InspectorColombo/ColomboProjects/USBASP_M8535/readme.txt

This is my version of USB ASP programmer.
- It is based on ATMega8535 run on 12MHz crystal.
- Optic insulation of target added.
- Logic level converters added.
- 10pins jtag like and 6 pins classic avr-isp connectors present.
