InspectorColombo/ColomboProjects/12_to_200V_inverter/Ring_Holder/RingHolder.stl

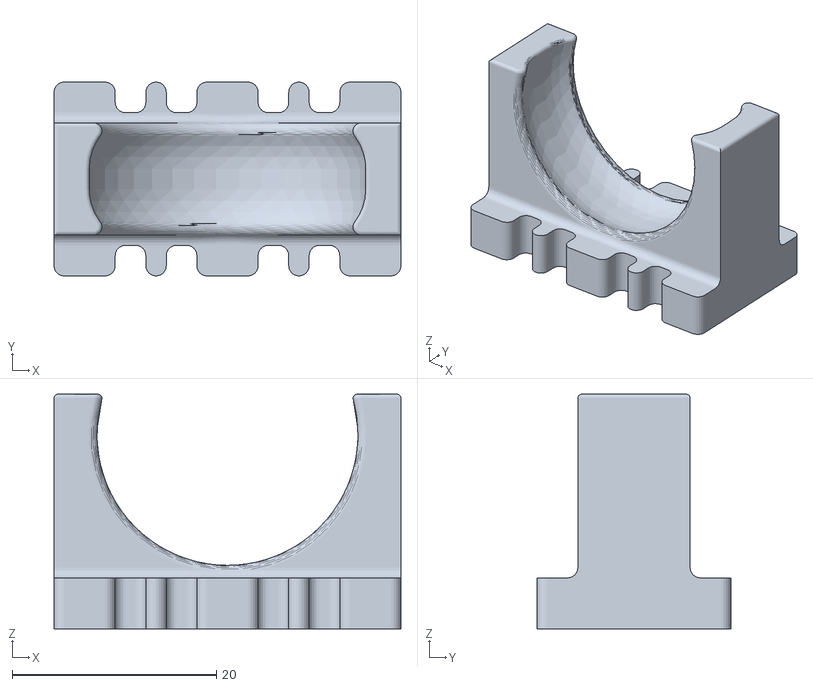
[picture p1: CAD file, 2024-04-01]
12_to_200V_inverter/Ring_Holder/RingHolder.stl
34.0 x 19.0 x 23.0
