InspectorColombo/ColomboProjects/FilamentCase/FilamentCase.stl

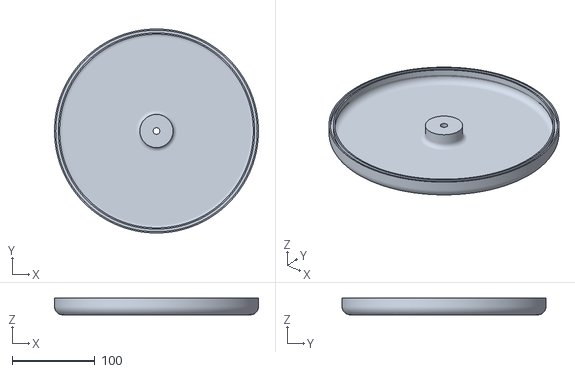
[picture p2: CAD file, 2024-06-12]
FilamentCase/FilamentCase.stl
246.0 x 246.0 x 19.9
