InspectorColombo/ColomboProjects/Kassy/box_v5.stl

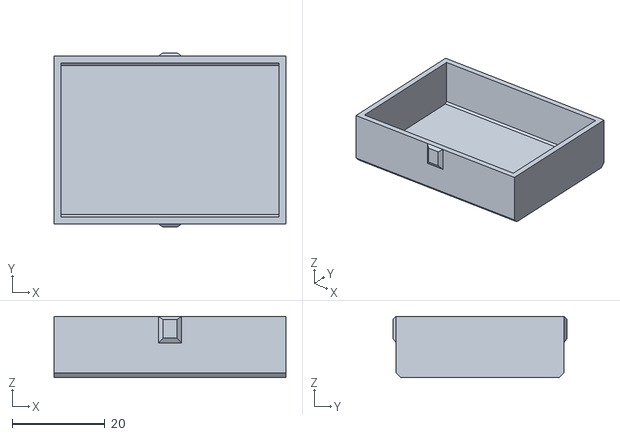
[picture p3: CAD file, 2024-12-11]
Kassy/box_v5.stl
50.0 x 37.6 x 13.2
