InspectorColombo/ColomboProjects/WINDING_MACHINE/WindingMachineHandle.stl

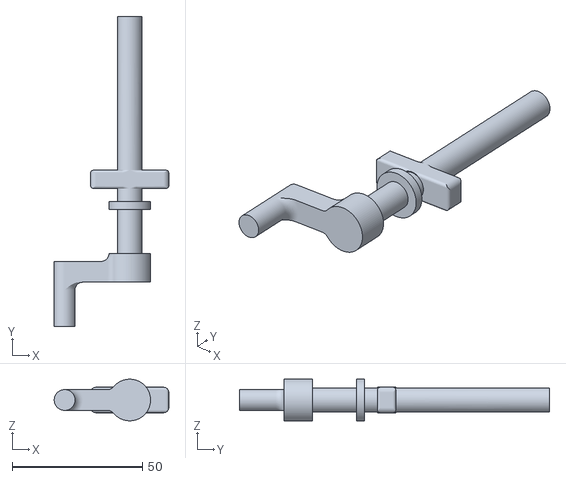
[picture p4: CAD file, 2024-05-27]
WINDING_MACHINE/WindingMachineHandle.stl
44.0 x 119.0 x 16.0
