InspectorColombo/ColomboProjects/Kassy/BigBox6x5_1.8mm.stl

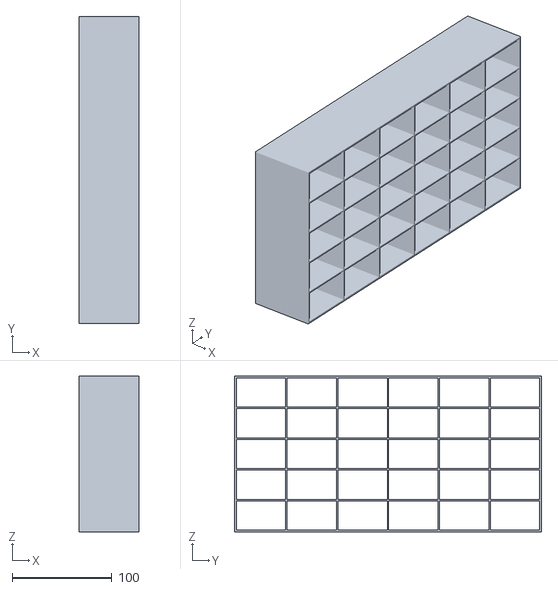
[picture p5: CAD file, 2024-12-08]
Kassy/BigBox6x5_1.8mm.stl
60.0 x 308.1 x 156.1
