InspectorColombo/ColomboProjects/WINDING_MACHINE/WindingMachineHandle_TOP.stl

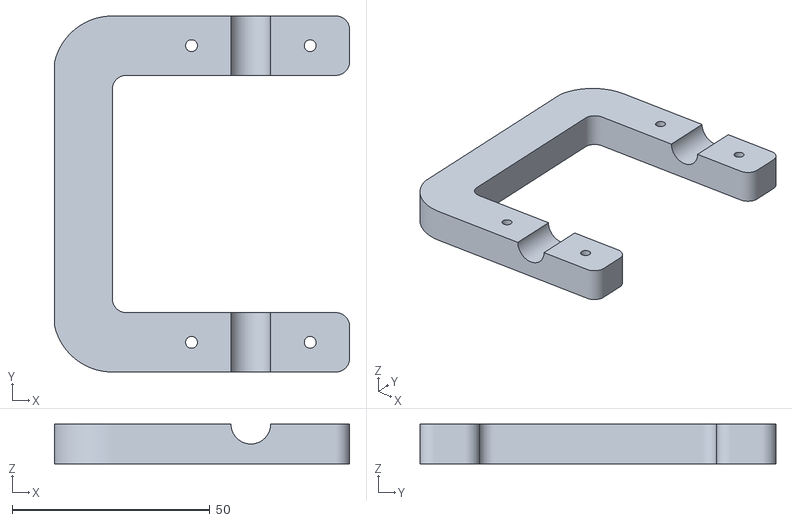
[picture p6: CAD file, 2024-05-27]
WINDING_MACHINE/WindingMachineHandle_TOP.stl
74.7 x 90.0 x 10.00
