InspectorColombo/ColomboProjects/HumidityMetter/Package/HumidityMetterPackage.stl

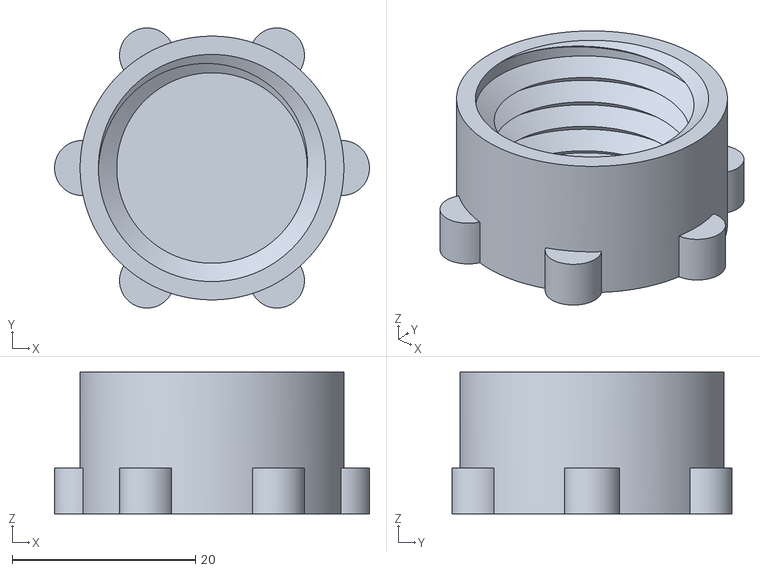
[picture p7: CAD file, 2024-09-07]
HumidityMetter/Package/HumidityMetterPackage.stl
34.4 x 30.6 x 15.5
