InspectorColombo/ColomboProjects/Kassy/BigBox3x3_1.8mm_test.stl

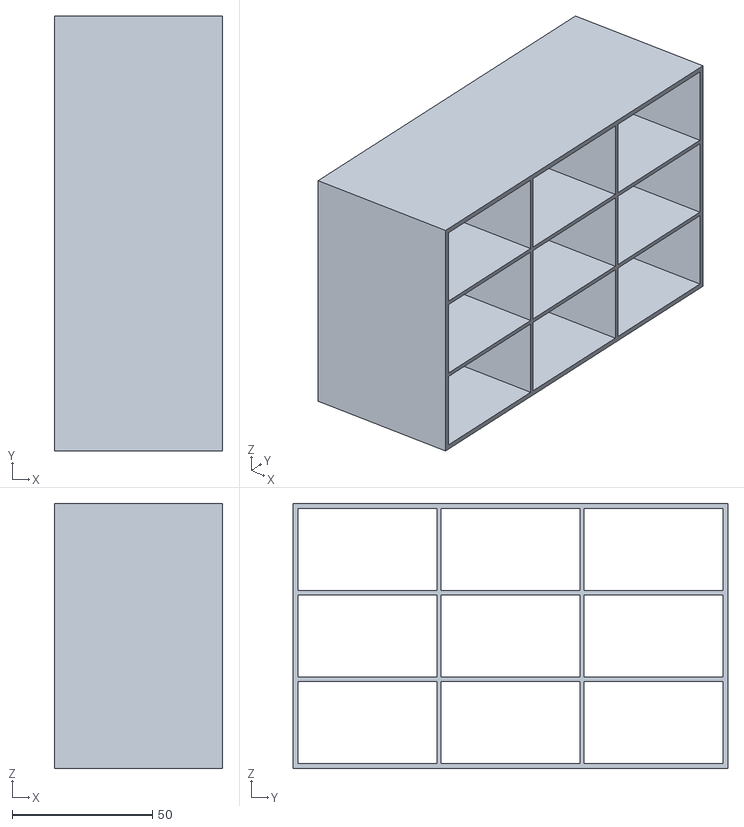
[picture p8: CAD file, 2024-12-08]
Kassy/BigBox3x3_1.8mm_test.stl
60.0 x 155.1 x 94.5
