InspectorColombo/ColomboProjects/WINDING_MACHINE/WindingMachine.stl

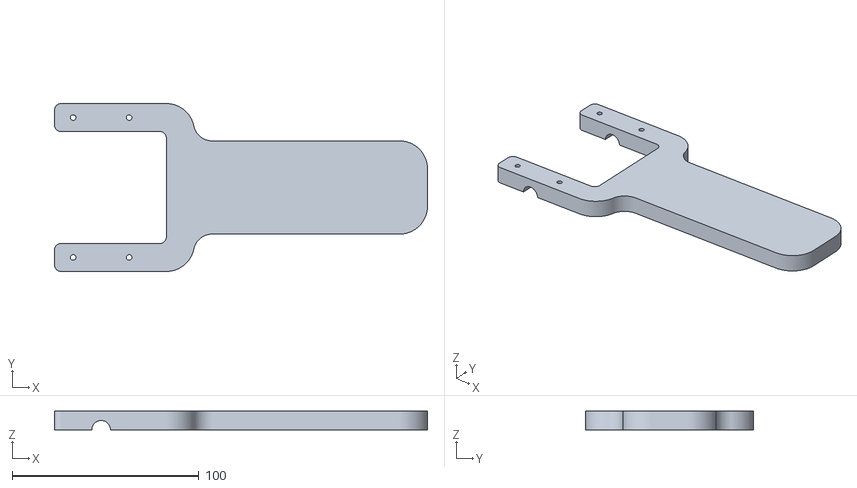
[picture p9: CAD file, 2024-05-23]
WINDING_MACHINE/WindingMachine.stl
200.0 x 90.0 x 10.0
