InspectorColombo/ColomboProjects/HumidityMetter/Package/toonels.stl

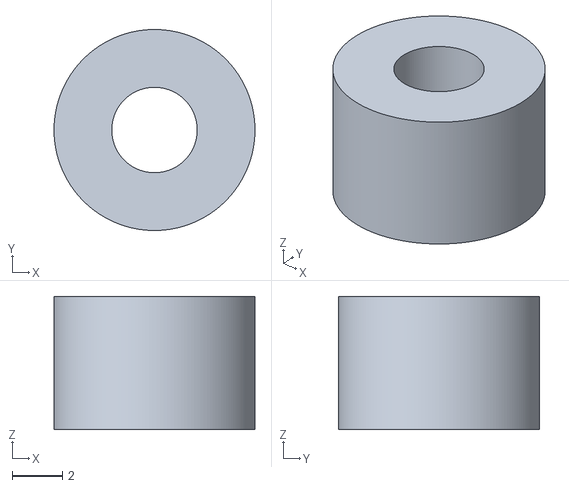
[picture p10: CAD file, 2024-08-28]
HumidityMetter/Package/toonels.stl
8.00 x 8.00 x 5.30
