InspectorColombo/ColomboProjects/Kassy/SMALL_BOX.stl

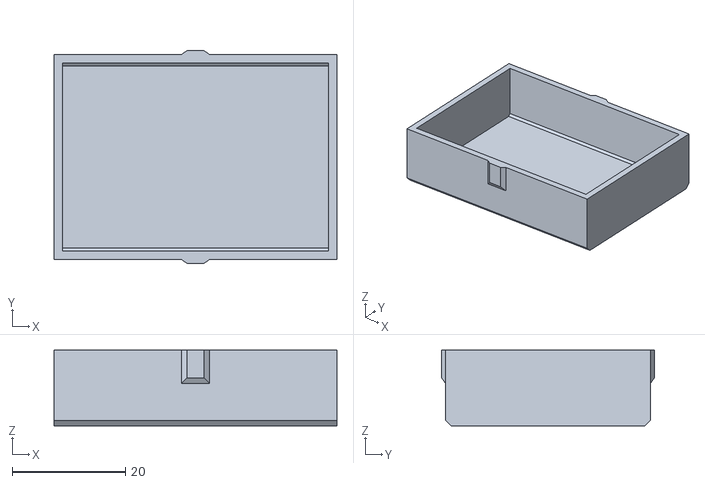
[picture p11: CAD file, 2024-12-08]
Kassy/SMALL_BOX.stl
50.0 x 37.6 x 13.4
