InspectorColombo/ColomboProjects/HumidityMetter/Package/bottom.stl

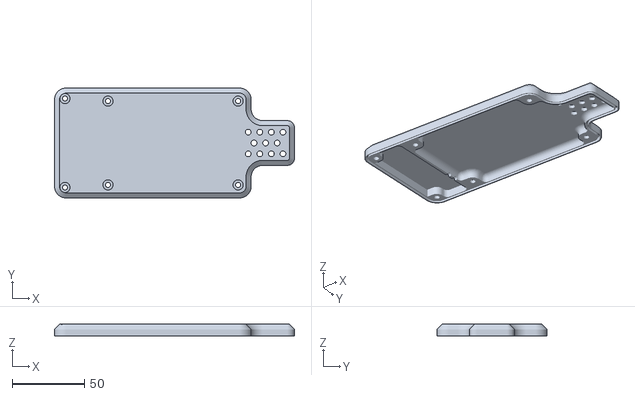
[picture p12: CAD file, 2024-08-28]
HumidityMetter/Package/bottom.stl
166.0 x 76.0 x 8.00
