InspectorColombo/ColomboProjects/HumidityMetter/Package/top.stl

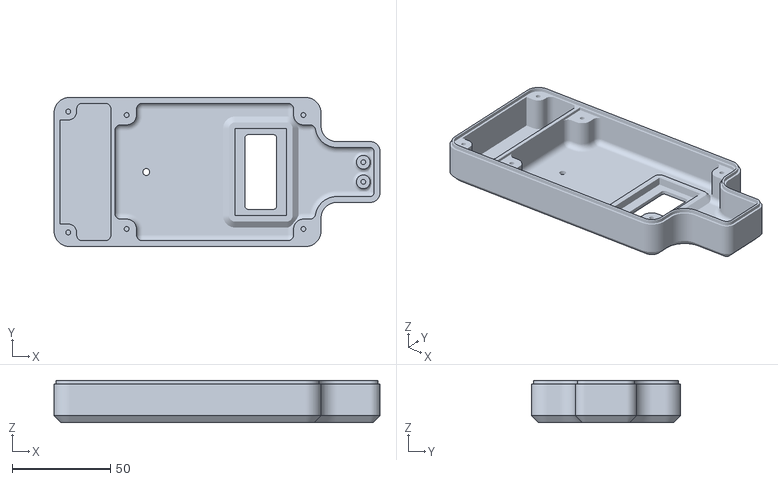
[picture p13: CAD file, 2024-08-27]
HumidityMetter/Package/top.stl
166.0 x 76.0 x 21.5
