InspectorColombo/ColomboProjects/(list of files, cad)

Other CAD files:
Kassy/Kassy.dwg
12_to_200V_inverter/package/LampPackage4_ver10.dwg
Lotok15mm/Lotok15mm.dwg
Lotok25mm/Lotok25mm.dwg
NiddleBox/CanisterCap.dwg
12_to_200V_inverter/package/HEAT_SINK_HOLDER.dwg
FilamentCase/FittingHolder.dwg
Lotok15mm/Lotok.dwg
NiddleBox/BOX.dwg
WINDING_MACHINE/WindingMachine_recover.dwg
12_to_200V_inverter/package/LED_Conductor.dwg
NiddleBox/ValveHandle.dwg
12_to_200V_inverter/package/Conductor.dwg
12_to_200V_inverter/Ring_Holder/RingHolder.dwg
12_to_200V_inverter/package/LampPackage4_ver8.dwg
FilamentCase/FilamentCase.dwg
HumidityMetter/Package/HumidityMetterPackage.dwg
HumidityMetter/Package/TOP_SCREW_INNER_28.4.stl
HumidityMetter/Package/TOP_SCREW_OUTER.stl
WINDING_MACHINE/WindingMachine.dwg
