InspectorColombo/ColomboProjects/KLineAdapter/schematic/to_print2.png

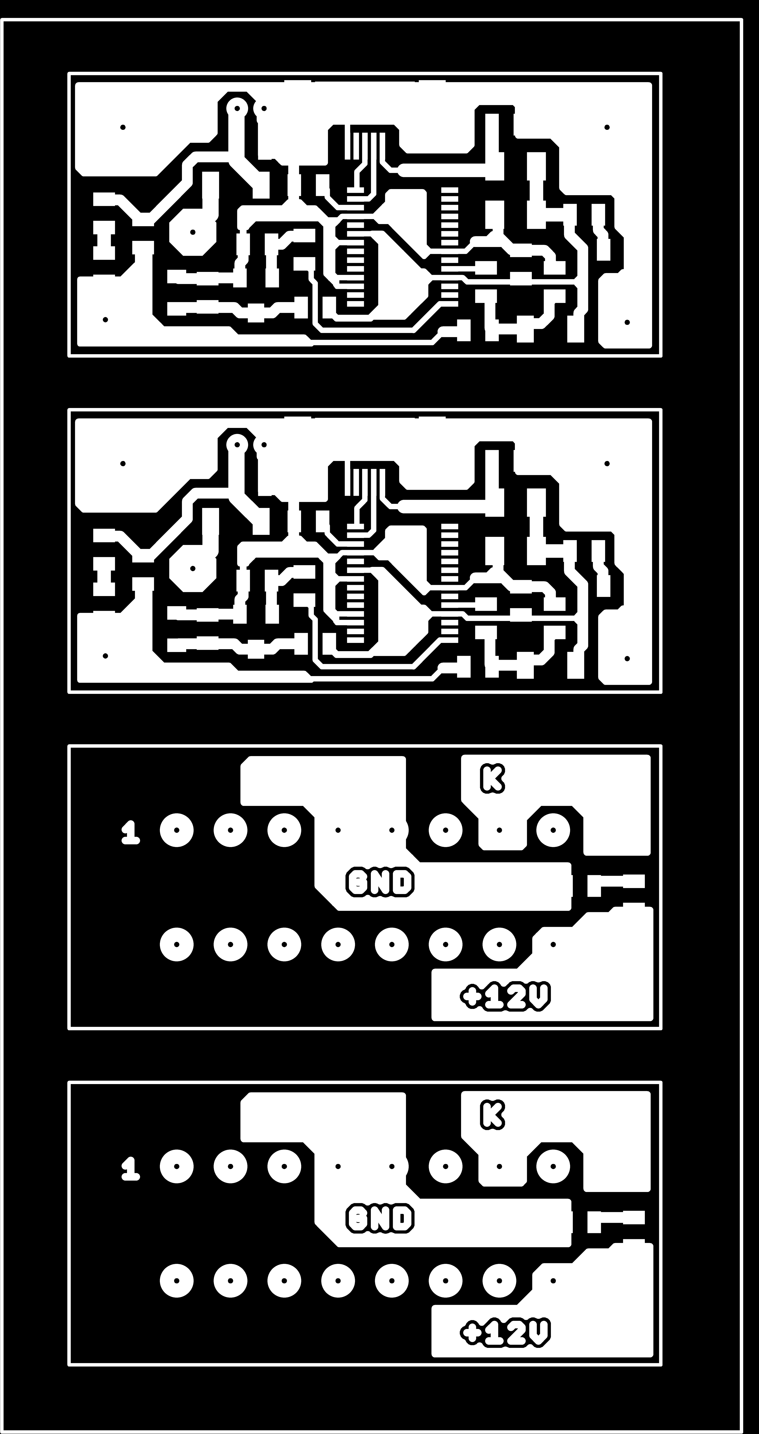
KLineAdapter/schematic/to_print2.png
