InspectorColombo/ColomboProjects/PowerSupply_1600W/CurrentRestrictionBoard/TO_PRINT_V1.0.png

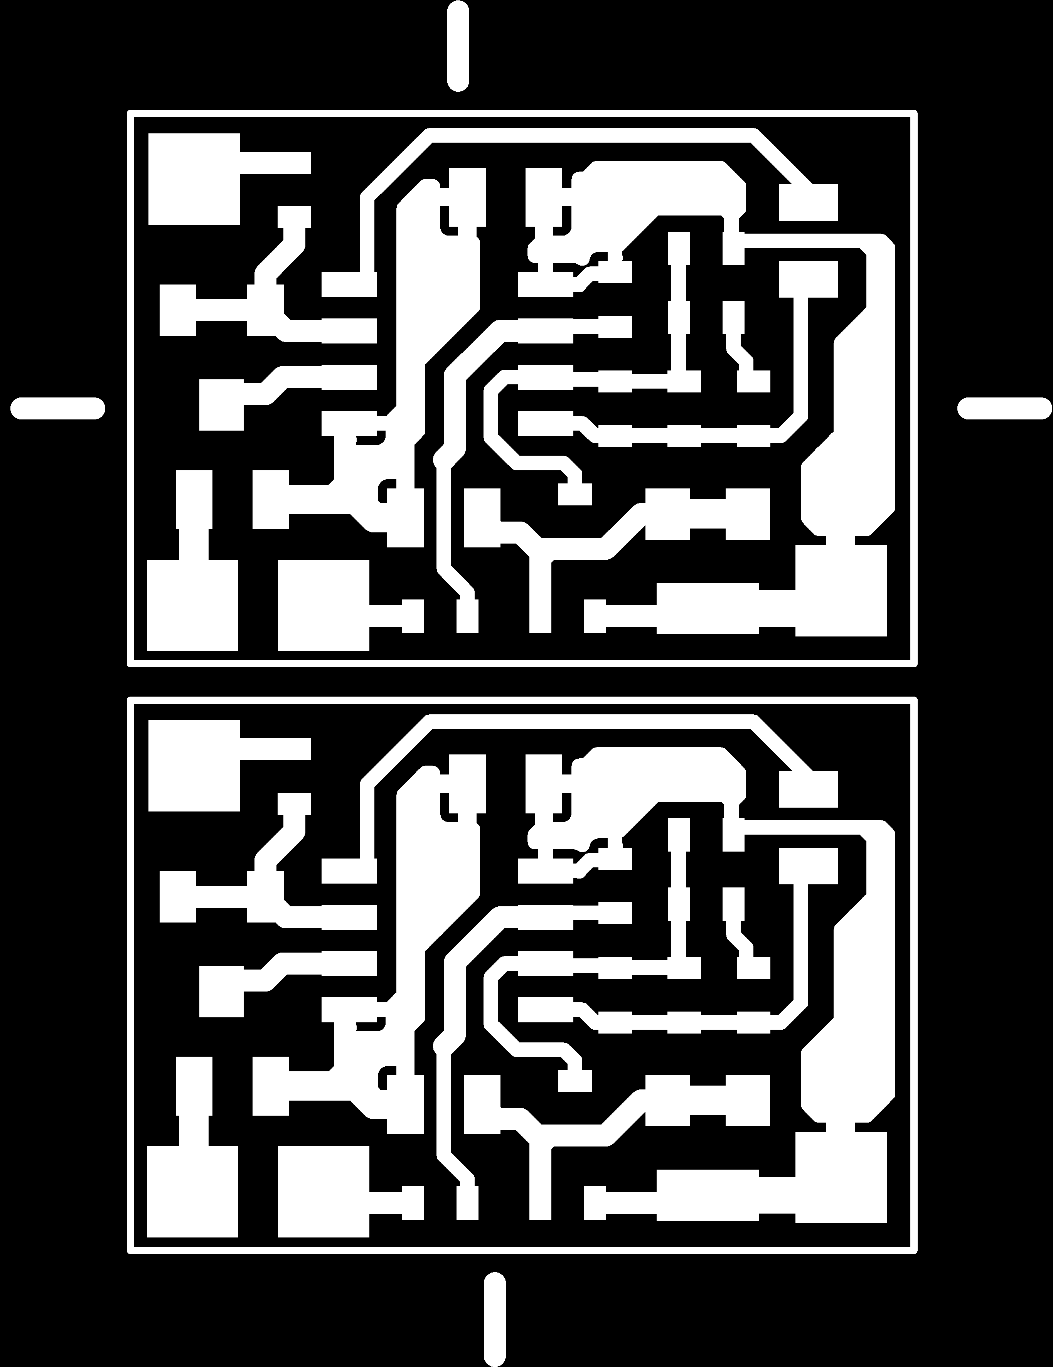
PowerSupply_1600W/CurrentRestrictionBoard/TO_PRINT_V1.0.png
