InspectorColombo/ColomboProjects/SoftStartBoard/PotenciometersBoard/TO_PRINT.png

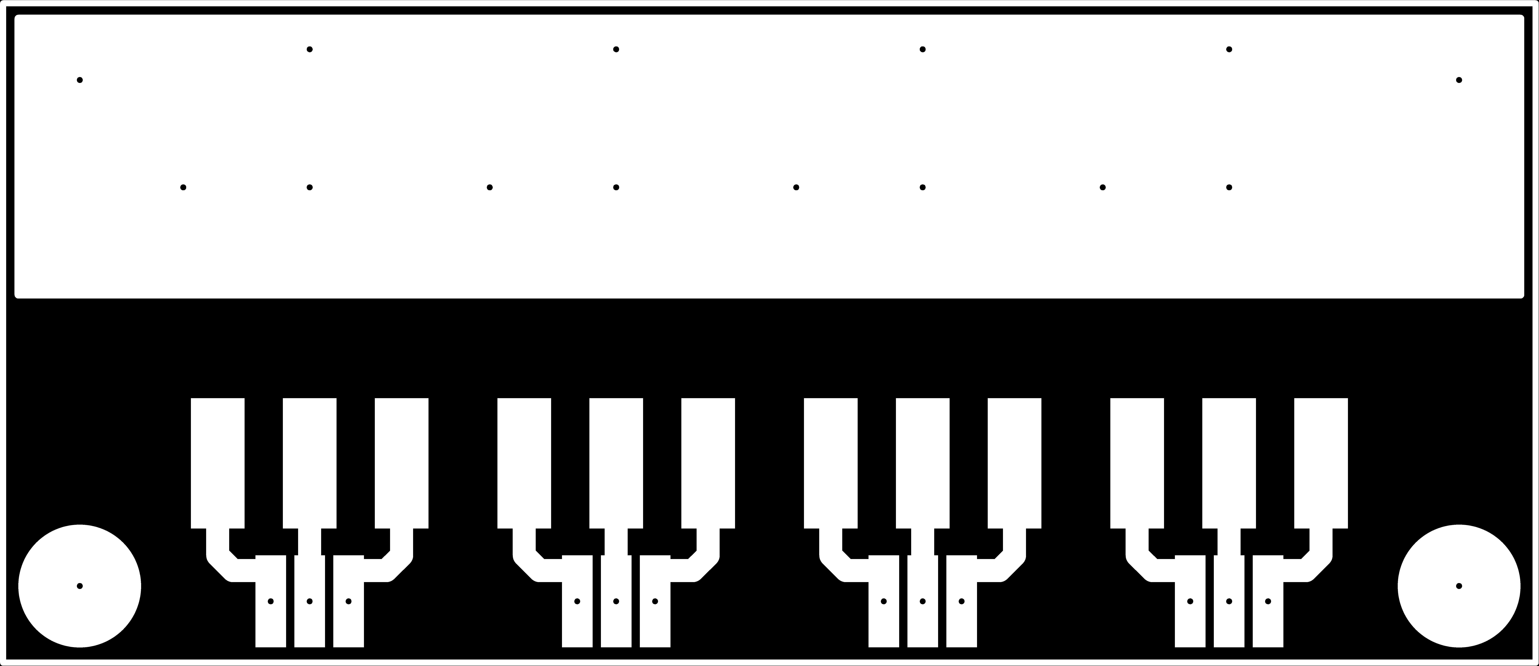
SoftStartBoard/PotenciometersBoard/TO_PRINT.png
