InspectorColombo/ColomboProjects/SWR_Metter/schematic/TO_PRINT.png

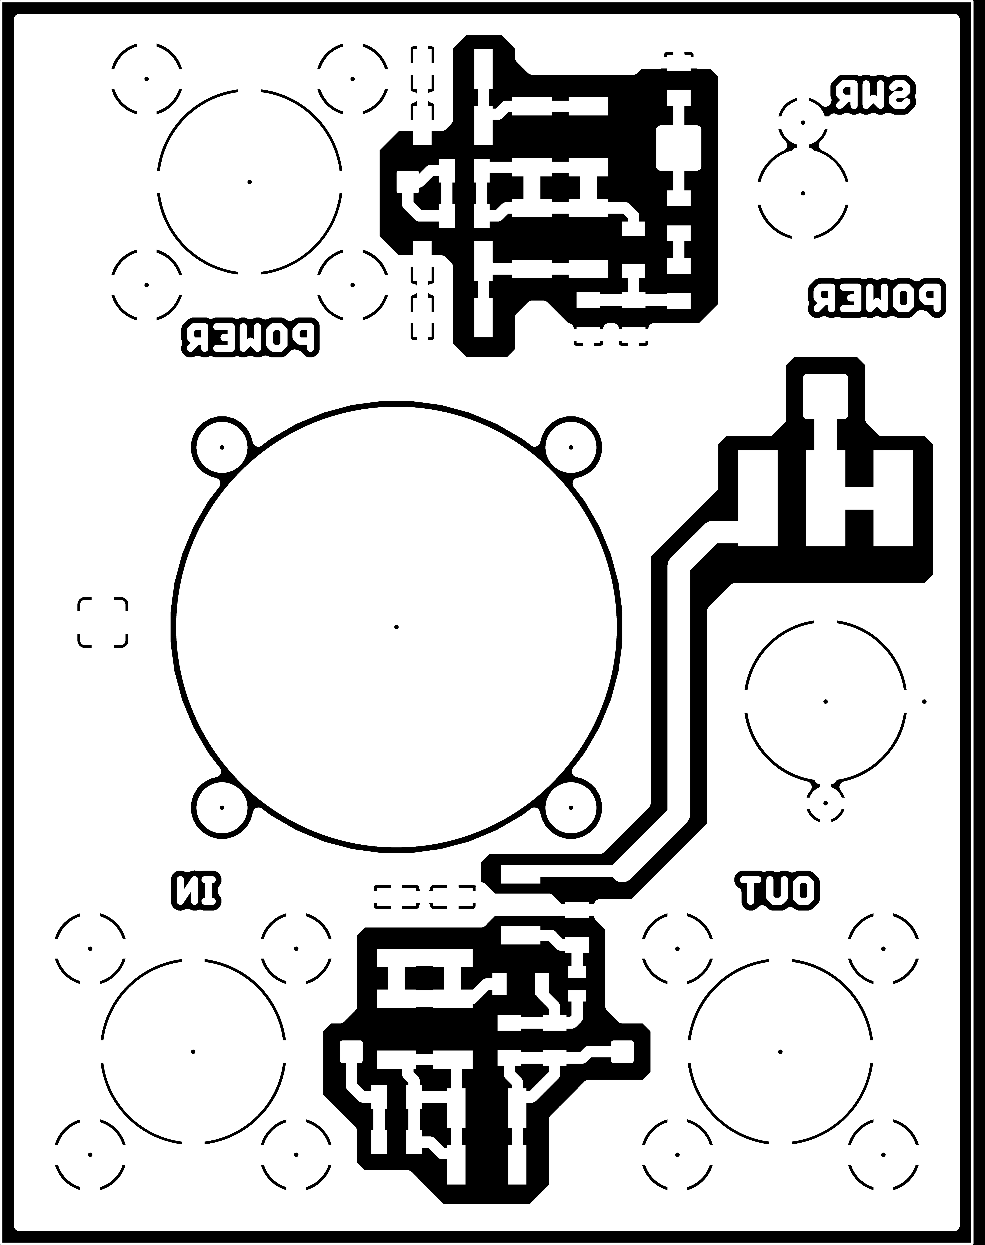
SWR_Metter/schematic/TO_PRINT.png
