InspectorColombo/ColomboProjects/CurrentMetter/schematic/CurrentMetterLEDScreen.brd

## EAGLE design CurrentMetter/schematic/CurrentMetterLEDScreen.brd (2026-10-03)

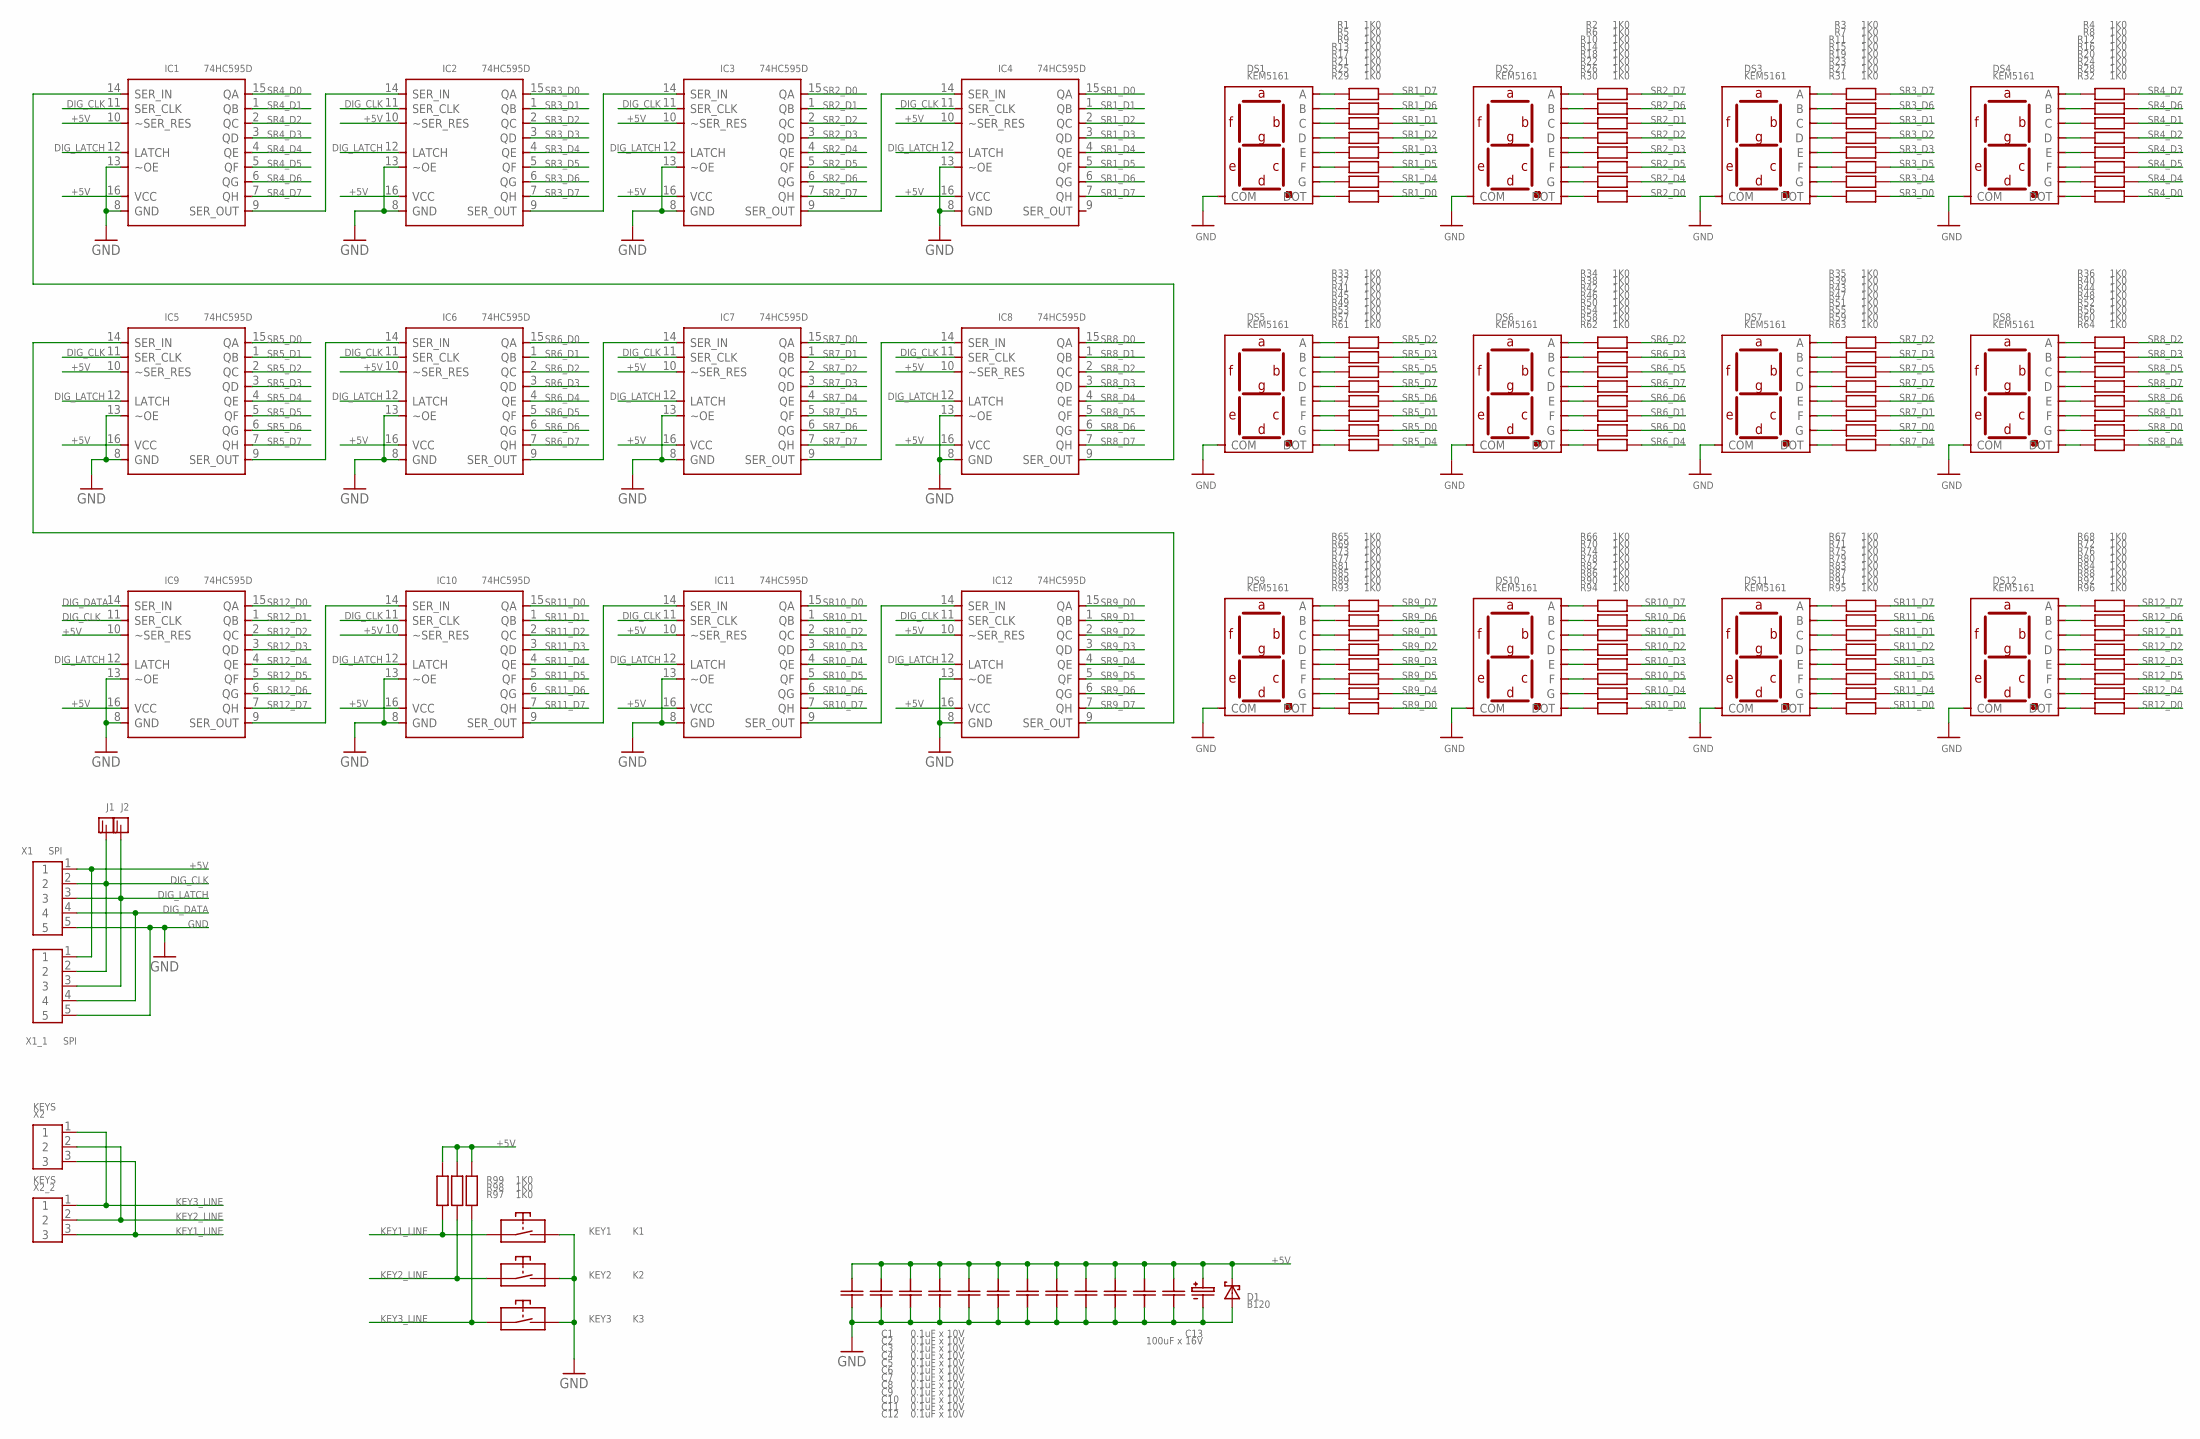
[picture p18: schematic CurrentMetterLEDScreen.sch]

Parts:
C1, C2, C3, C4, C5, C6, C7, C8, C9, C10, C11, C12: 0.1uF x 10V; RSMD_0603
C13: 100uF x 16V; CE_6.3MM_HOR_REVERTED
D1: B120; DO-214AC
DS1, DS2, DS3, DS4, DS5, DS6, DS7, DS8, DS9, DS10, DS11, DS12: KEM5161; KEM-5161(NARROW_PADS_OUTSIDE)
IC1, IC2, IC3, IC4, IC5, IC6, IC7, IC8, IC9, IC10, IC11, IC12: 74HC595D; SOIC16
J1, J2: JUMPER0805; RSMD_0805
KEY1: K1; KEY_7X4.5_BIG_PADS
KEY2: K2; KEY_7X4.5_BIG_PADS
KEY3: K3; KEY_7X4.5_BIG_PADS
R1, R2, R3, R4, R5, R6, R7, R8, R9, R10, R11, R12, R13, R14, R15, R16, R17, R18, R19, R20, R21, R22, R23, R24, R25, R26, R27, R28, R29, R30, R31, R32, R33, R34, R35, R36, R37, R38, R39, R40, R41, R42, R43, R44, R45, R46, R47, R48, R49, R50, R51, R52, R53, R54, R55, R56, R57, R58, R59, R60, R61, R62, R63, R64, R65, R66, R67, R68, R69, R70, R71, R72, R73, R74, R75, R76, R77, R78, R79, R80, R81, R82, R83, R84, R85, R86, R87, R88, R89, R90, R91, R92, R93, R94, R95, R96, R97, R98, R99: 1K0; RSMD_0603
X1: SPI; PIN5X1_2.54MM_SIDE_BOARD
X1_1: SPI; PIN5X1_2.54MM_WITH_CLAMP
X2: KEYS; PIN1X3_2.54MM_SIDE_BOARD
X2_2: KEYS; PIN3X1_2.54MM_WITH_CLAMP

Connections:
+5V: C1.PAD_1 (PIN1), C2.PAD_1 (PIN1), C3.PAD_1 (PIN1), C4.PAD_1 (PIN1), C5.PAD_1 (PIN1), C6.PAD_1 (PIN1), C7.PAD_1 (PIN1), C8.PAD_1 (PIN1), C9.PAD_1 (PIN1), C10.PAD_1 (PIN1), C11.PAD_1 (PIN1), C12.PAD_1 (PIN1), C13.PLUS, D1.CATHODE, IC1.10 (~SER_RES), IC1.16 (VCC), IC2.10 (~SER_RES), IC2.16 (VCC), IC3.10 (~SER_RES), IC3.16 (VCC), IC4.10 (~SER_RES), IC4.16 (VCC), IC5.10 (~SER_RES), IC5.16 (VCC), IC6.10 (~SER_RES), IC6.16 (VCC), IC7.10 (~SER_RES), IC7.16 (VCC), IC8.10 (~SER_RES), IC8.16 (VCC), IC9.10 (~SER_RES), IC9.16 (VCC), IC10.10 (~SER_RES), IC10.16 (VCC), IC11.10 (~SER_RES), IC11.16 (VCC), IC12.10 (~SER_RES), IC12.16 (VCC), R97.PAD_1 (PIN1), R98.PAD_1 (PIN1), R99.PAD_1 (PIN1), X1.1, X1_1.1
DIG_CLK: IC1.11 (SER_CLK), IC2.11 (SER_CLK), IC3.11 (SER_CLK), IC4.11 (SER_CLK), IC5.11 (SER_CLK), IC6.11 (SER_CLK), IC7.11 (SER_CLK), IC8.11 (SER_CLK), IC9.11 (SER_CLK), IC10.11 (SER_CLK), IC11.11 (SER_CLK), IC12.11 (SER_CLK), J1.PAD_0, J1.PAD_1, X1.2, X1_1.2
DIG_DATA: IC9.14 (SER_IN), X1.4, X1_1.4
DIG_LATCH: IC1.12 (LATCH), IC2.12 (LATCH), IC3.12 (LATCH), IC4.12 (LATCH), IC5.12 (LATCH), IC6.12 (LATCH), IC7.12 (LATCH), IC8.12 (LATCH), IC9.12 (LATCH), IC10.12 (LATCH), IC11.12 (LATCH), IC12.12 (LATCH), J2.PAD_0, J2.PAD_1, X1.3, X1_1.3
GND: C1.PAD_0 (PIN0), C2.PAD_0 (PIN0), C3.PAD_0 (PIN0), C4.PAD_0 (PIN0), C5.PAD_0 (PIN0), C6.PAD_0 (PIN0), C7.PAD_0 (PIN0), C8.PAD_0 (PIN0), C9.PAD_0 (PIN0), C10.PAD_0 (PIN0), C11.PAD_0 (PIN0), C12.PAD_0 (PIN0), C13.MINUS, D1.ANODE, DS1.3 (COM), DS1.8 (COM), DS2.3 (COM), DS2.8 (COM), DS3.3 (COM), DS3.8 (COM), DS4.3 (COM), DS4.8 (COM), DS5.3 (COM), DS5.8 (COM), DS6.3 (COM), DS6.8 (COM), DS7.3 (COM), DS7.8 (COM), DS8.3 (COM), DS8.8 (COM), DS9.3 (COM), DS9.8 (COM), DS10.3 (COM), DS10.8 (COM), DS11.3 (COM), DS11.8 (COM), DS12.3 (COM), DS12.8 (COM), IC1.8 (GND), IC1.13 (~OE), IC2.8 (GND), IC2.13 (~OE), IC3.8 (GND), IC3.13 (~OE), IC4.8 (GND), IC4.13 (~OE), IC5.8 (GND), IC5.13 (~OE), IC6.8 (GND), IC6.13 (~OE), IC7.8 (GND), IC7.13 (~OE), IC8.8 (GND), IC8.13 (~OE), IC9.8 (GND), IC9.13 (~OE), IC10.8 (GND), IC10.13 (~OE), IC11.8 (GND), IC11.13 (~OE), IC12.8 (GND), IC12.13 (~OE), KEY1.3 (2), KEY1.4 (2), KEY2.3 (2), KEY2.4 (2), KEY3.3 (2), KEY3.4 (2), X1.5, X1_1.5
KEY1_LINE: KEY1.1, KEY1.2 (1), R99.PAD_0 (PIN0), X2.3, X2_2.3
KEY2_LINE: KEY2.1, KEY2.2 (1), R98.PAD_0 (PIN0), X2.2, X2_2.2
KEY3_LINE: KEY3.1, KEY3.2 (1), R97.PAD_0 (PIN0), X2.1, X2_2.1
unnamed: DS4.7 (A), R4.PAD_0 (PIN0)
unnamed: DS4.6 (B), R8.PAD_0 (PIN0)
unnamed: DS4.4 (C), R12.PAD_0 (PIN0)
unnamed: DS4.2 (D), R16.PAD_0 (PIN0)
unnamed: DS4.1 (E), R20.PAD_0 (PIN0)
unnamed: DS4.9 (F), R24.PAD_0 (PIN0)
unnamed: DS4.10 (G), R28.PAD_0 (PIN0)
unnamed: DS4.5 (DOT), R32.PAD_0 (PIN0)
unnamed: DS8.7 (A), R36.PAD_0 (PIN0)
unnamed: DS8.6 (B), R40.PAD_0 (PIN0)
unnamed: DS8.4 (C), R44.PAD_0 (PIN0)
unnamed: DS8.2 (D), R48.PAD_0 (PIN0)
unnamed: DS8.1 (E), R52.PAD_0 (PIN0)
unnamed: DS8.9 (F), R56.PAD_0 (PIN0)
unnamed: DS8.10 (G), R60.PAD_0 (PIN0)
unnamed: DS8.5 (DOT), R64.PAD_0 (PIN0)
unnamed: DS3.7 (A), R3.PAD_0 (PIN0)
unnamed: DS3.6 (B), R7.PAD_0 (PIN0)
unnamed: DS3.4 (C), R11.PAD_0 (PIN0)
unnamed: DS3.2 (D), R15.PAD_0 (PIN0)
unnamed: IC3.9 (SER_OUT), IC4.14 (SER_IN)
unnamed: DS3.1 (E), R19.PAD_0 (PIN0)
unnamed: DS3.9 (F), R23.PAD_0 (PIN0)
unnamed: DS3.10 (G), R27.PAD_0 (PIN0)
unnamed: DS3.5 (DOT), R31.PAD_0 (PIN0)
unnamed: IC2.9 (SER_OUT), IC3.14 (SER_IN)
unnamed: IC1.9 (SER_OUT), IC2.14 (SER_IN)
unnamed: DS7.7 (A), R35.PAD_0 (PIN0)
unnamed: DS7.6 (B), R39.PAD_0 (PIN0)
unnamed: DS7.4 (C), R43.PAD_0 (PIN0)
unnamed: DS7.2 (D), R47.PAD_0 (PIN0)
unnamed: DS7.1 (E), R51.PAD_0 (PIN0)
unnamed: DS7.9 (F), R55.PAD_0 (PIN0)
unnamed: DS7.10 (G), R59.PAD_0 (PIN0)
unnamed: DS7.5 (DOT), R63.PAD_0 (PIN0)
unnamed: DS2.7 (A), R2.PAD_0 (PIN0)
unnamed: DS2.6 (B), R6.PAD_0 (PIN0)
unnamed: DS2.4 (C), R10.PAD_0 (PIN0)
unnamed: DS2.2 (D), R14.PAD_0 (PIN0)
unnamed: DS2.1 (E), R18.PAD_0 (PIN0)
unnamed: DS2.9 (F), R22.PAD_0 (PIN0)
unnamed: DS2.10 (G), R26.PAD_0 (PIN0)
unnamed: DS2.5 (DOT), R30.PAD_0 (PIN0)
unnamed: DS6.7 (A), R34.PAD_0 (PIN0)
unnamed: DS6.6 (B), R38.PAD_0 (PIN0)
unnamed: DS6.4 (C), R42.PAD_0 (PIN0)
unnamed: DS6.2 (D), R46.PAD_0 (PIN0)
unnamed: DS6.1 (E), R50.PAD_0 (PIN0)
unnamed: DS6.9 (F), R54.PAD_0 (PIN0)
unnamed: DS6.10 (G), R58.PAD_0 (PIN0)
unnamed: DS6.5 (DOT), R62.PAD_0 (PIN0)
unnamed: DS5.7 (A), R33.PAD_0 (PIN0)
unnamed: DS1.7 (A), R1.PAD_0 (PIN0)
unnamed: DS1.6 (B), R5.PAD_0 (PIN0)
unnamed: DS1.4 (C), R9.PAD_0 (PIN0)
unnamed: DS1.2 (D), R13.PAD_0 (PIN0)
unnamed: DS1.1 (E), R17.PAD_0 (PIN0)
unnamed: DS1.9 (F), R21.PAD_0 (PIN0)
unnamed: DS1.10 (G), R25.PAD_0 (PIN0)
unnamed: DS1.5 (DOT), R29.PAD_0 (PIN0)
unnamed: DS5.6 (B), R37.PAD_0 (PIN0)
unnamed: DS5.4 (C), R41.PAD_0 (PIN0)
unnamed: DS5.2 (D), R45.PAD_0 (PIN0)
unnamed: DS5.1 (E), R49.PAD_0 (PIN0)
unnamed: DS5.9 (F), R53.PAD_0 (PIN0)
unnamed: DS5.10 (G), R57.PAD_0 (PIN0)
unnamed: DS5.5 (DOT), R61.PAD_0 (PIN0)
unnamed: IC7.9 (SER_OUT), IC8.14 (SER_IN)
unnamed: IC6.9 (SER_OUT), IC7.14 (SER_IN)
unnamed: IC5.9 (SER_OUT), IC6.14 (SER_IN)
unnamed: DS12.7 (A), R68.PAD_0 (PIN0)
unnamed: DS12.6 (B), R72.PAD_0 (PIN0)
unnamed: DS12.4 (C), R76.PAD_0 (PIN0)
unnamed: DS12.2 (D), R80.PAD_0 (PIN0)
unnamed: DS12.1 (E), R84.PAD_0 (PIN0)
unnamed: DS12.9 (F), R88.PAD_0 (PIN0)
unnamed: DS12.10 (G), R92.PAD_0 (PIN0)
unnamed: DS12.5 (DOT), R96.PAD_0 (PIN0)
unnamed: DS11.7 (A), R67.PAD_0 (PIN0)
unnamed: DS11.6 (B), R71.PAD_0 (PIN0)
unnamed: DS11.4 (C), R75.PAD_0 (PIN0)
unnamed: DS11.2 (D), R79.PAD_0 (PIN0)
unnamed: DS11.1 (E), R83.PAD_0 (PIN0)
unnamed: DS11.9 (F), R87.PAD_0 (PIN0)
unnamed: DS11.10 (G), R91.PAD_0 (PIN0)
unnamed: DS11.5 (DOT), R95.PAD_0 (PIN0)
unnamed: DS10.7 (A), R66.PAD_0 (PIN0)
unnamed: DS10.6 (B), R70.PAD_0 (PIN0)
unnamed: DS10.4 (C), R74.PAD_0 (PIN0)
unnamed: DS10.2 (D), R78.PAD_0 (PIN0)
unnamed: DS10.1 (E), R82.PAD_0 (PIN0)
unnamed: DS10.9 (F), R86.PAD_0 (PIN0)
unnamed: DS10.10 (G), R90.PAD_0 (PIN0)
unnamed: DS10.5 (DOT), R94.PAD_0 (PIN0)
unnamed: DS9.7 (A), R65.PAD_0 (PIN0)
unnamed: DS9.6 (B), R69.PAD_0 (PIN0)
unnamed: DS9.4 (C), R73.PAD_0 (PIN0)
unnamed: DS9.2 (D), R77.PAD_0 (PIN0)
unnamed: DS9.1 (E), R81.PAD_0 (PIN0)
unnamed: DS9.9 (F), R85.PAD_0 (PIN0)
unnamed: DS9.10 (G), R89.PAD_0 (PIN0)
unnamed: DS9.5 (DOT), R93.PAD_0 (PIN0)
unnamed: IC11.9 (SER_OUT), IC12.14 (SER_IN)
unnamed: IC10.9 (SER_OUT), IC11.14 (SER_IN)
unnamed: IC9.9 (SER_OUT), IC10.14 (SER_IN)
unnamed: IC1.14 (SER_IN), IC8.9 (SER_OUT)
unnamed: IC5.14 (SER_IN), IC12.9 (SER_OUT)
SR1_D0: IC4.15 (QA), R29.PAD_1 (PIN1)
SR1_D1: IC4.1 (QB), R9.PAD_1 (PIN1)
SR1_D2: IC4.2 (QC), R13.PAD_1 (PIN1)
SR1_D3: IC4.3 (QD), R17.PAD_1 (PIN1)
SR1_D4: IC4.4 (QE), R25.PAD_1 (PIN1)
SR1_D5: IC4.5 (QF), R21.PAD_1 (PIN1)
SR1_D6: IC4.6 (QG), R5.PAD_1 (PIN1)
SR1_D7: IC4.7 (QH), R1.PAD_1 (PIN1)
SR2_D0: IC3.15 (QA), R30.PAD_1 (PIN1)
SR2_D1: IC3.1 (QB), R10.PAD_1 (PIN1)
SR2_D2: IC3.2 (QC), R14.PAD_1 (PIN1)
SR2_D3: IC3.3 (QD), R18.PAD_1 (PIN1)
SR2_D4: IC3.4 (QE), R26.PAD_1 (PIN1)
SR2_D5: IC3.5 (QF), R22.PAD_1 (PIN1)
SR2_D6: IC3.6 (QG), R6.PAD_1 (PIN1)
SR2_D7: IC3.7 (QH), R2.PAD_1 (PIN1)
SR3_D0: IC2.15 (QA), R31.PAD_1 (PIN1)
SR3_D1: IC2.1 (QB), R11.PAD_1 (PIN1)
SR3_D2: IC2.2 (QC), R15.PAD_1 (PIN1)
SR3_D3: IC2.3 (QD), R19.PAD_1 (PIN1)
SR3_D4: IC2.4 (QE), R27.PAD_1 (PIN1)
SR3_D5: IC2.5 (QF), R23.PAD_1 (PIN1)
SR3_D6: IC2.6 (QG), R7.PAD_1 (PIN1)
SR3_D7: IC2.7 (QH), R3.PAD_1 (PIN1)
SR4_D0: IC1.15 (QA), R32.PAD_1 (PIN1)
SR4_D1: IC1.1 (QB), R12.PAD_1 (PIN1)
SR4_D2: IC1.2 (QC), R16.PAD_1 (PIN1)
SR4_D3: IC1.3 (QD), R20.PAD_1 (PIN1)
SR4_D4: IC1.4 (QE), R28.PAD_1 (PIN1)
SR4_D5: IC1.5 (QF), R24.PAD_1 (PIN1)
SR4_D6: IC1.6 (QG), R8.PAD_1 (PIN1)
SR4_D7: IC1.7 (QH), R4.PAD_1 (PIN1)
SR5_D0: IC5.15 (QA), R57.PAD_1 (PIN1)
SR5_D1: IC5.1 (QB), R53.PAD_1 (PIN1)
SR5_D2: IC5.2 (QC), R33.PAD_1 (PIN1)
SR5_D3: IC5.3 (QD), R37.PAD_1 (PIN1)
SR5_D4: IC5.4 (QE), R61.PAD_1 (PIN1)
SR5_D5: IC5.5 (QF), R41.PAD_1 (PIN1)
SR5_D6: IC5.6 (QG), R49.PAD_1 (PIN1)
SR5_D7: IC5.7 (QH), R45.PAD_1 (PIN1)
SR6_D0: IC6.15 (QA), R58.PAD_1 (PIN1)
SR6_D1: IC6.1 (QB), R54.PAD_1 (PIN1)
SR6_D2: IC6.2 (QC), R34.PAD_1 (PIN1)
SR6_D3: IC6.3 (QD), R38.PAD_1 (PIN1)
SR6_D4: IC6.4 (QE), R62.PAD_1 (PIN1)
SR6_D5: IC6.5 (QF), R42.PAD_1 (PIN1)
SR6_D6: IC6.6 (QG), R50.PAD_1 (PIN1)
SR6_D7: IC6.7 (QH), R46.PAD_1 (PIN1)
SR7_D0: IC7.15 (QA), R59.PAD_1 (PIN1)
SR7_D1: IC7.1 (QB), R55.PAD_1 (PIN1)
SR7_D2: IC7.2 (QC), R35.PAD_1 (PIN1)
SR7_D3: IC7.3 (QD), R39.PAD_1 (PIN1)
SR7_D4: IC7.4 (QE), R63.PAD_1 (PIN1)
SR7_D5: IC7.5 (QF), R43.PAD_1 (PIN1)
SR7_D6: IC7.6 (QG), R51.PAD_1 (PIN1)
SR7_D7: IC7.7 (QH), R47.PAD_1 (PIN1)
SR8_D0: IC8.15 (QA), R60.PAD_1 (PIN1)
SR8_D1: IC8.1 (QB), R56.PAD_1 (PIN1)
SR8_D2: IC8.2 (QC), R36.PAD_1 (PIN1)
SR8_D3: IC8.3 (QD), R40.PAD_1 (PIN1)
SR8_D4: IC8.4 (QE), R64.PAD_1 (PIN1)
SR8_D5: IC8.5 (QF), R44.PAD_1 (PIN1)
SR8_D6: IC8.6 (QG), R52.PAD_1 (PIN1)
SR8_D7: IC8.7 (QH), R48.PAD_1 (PIN1)
SR9_D0: IC12.15 (QA), R93.PAD_1 (PIN1)
SR9_D1: IC12.1 (QB), R73.PAD_1 (PIN1)
SR9_D2: IC12.2 (QC), R77.PAD_1 (PIN1)
SR9_D3: IC12.3 (QD), R81.PAD_1 (PIN1)
SR9_D4: IC12.4 (QE), R89.PAD_1 (PIN1)
SR9_D5: IC12.5 (QF), R85.PAD_1 (PIN1)
SR9_D6: IC12.6 (QG), R69.PAD_1 (PIN1)
SR9_D7: IC12.7 (QH), R65.PAD_1 (PIN1)
SR10_D0: IC11.15 (QA), R94.PAD_1 (PIN1)
SR10_D1: IC11.1 (QB), R74.PAD_1 (PIN1)
SR10_D2: IC11.2 (QC), R78.PAD_1 (PIN1)
SR10_D3: IC11.3 (QD), R82.PAD_1 (PIN1)
SR10_D4: IC11.4 (QE), R90.PAD_1 (PIN1)
SR10_D5: IC11.5 (QF), R86.PAD_1 (PIN1)
SR10_D6: IC11.6 (QG), R70.PAD_1 (PIN1)
SR10_D7: IC11.7 (QH), R66.PAD_1 (PIN1)
SR11_D0: IC10.15 (QA), R95.PAD_1 (PIN1)
SR11_D1: IC10.1 (QB), R75.PAD_1 (PIN1)
SR11_D2: IC10.2 (QC), R79.PAD_1 (PIN1)
SR11_D3: IC10.3 (QD), R83.PAD_1 (PIN1)
SR11_D4: IC10.4 (QE), R91.PAD_1 (PIN1)
SR11_D5: IC10.5 (QF), R87.PAD_1 (PIN1)
SR11_D6: IC10.6 (QG), R71.PAD_1 (PIN1)
SR11_D7: IC10.7 (QH), R67.PAD_1 (PIN1)
SR12_D0: IC9.15 (QA), R96.PAD_1 (PIN1)
SR12_D1: IC9.1 (QB), R76.PAD_1 (PIN1)
SR12_D2: IC9.2 (QC), R80.PAD_1 (PIN1)
SR12_D3: IC9.3 (QD), R84.PAD_1 (PIN1)
SR12_D4: IC9.4 (QE), R92.PAD_1 (PIN1)
SR12_D5: IC9.5 (QF), R88.PAD_1 (PIN1)
SR12_D6: IC9.6 (QG), R72.PAD_1 (PIN1)
SR12_D7: IC9.7 (QH), R68.PAD_1 (PIN1)

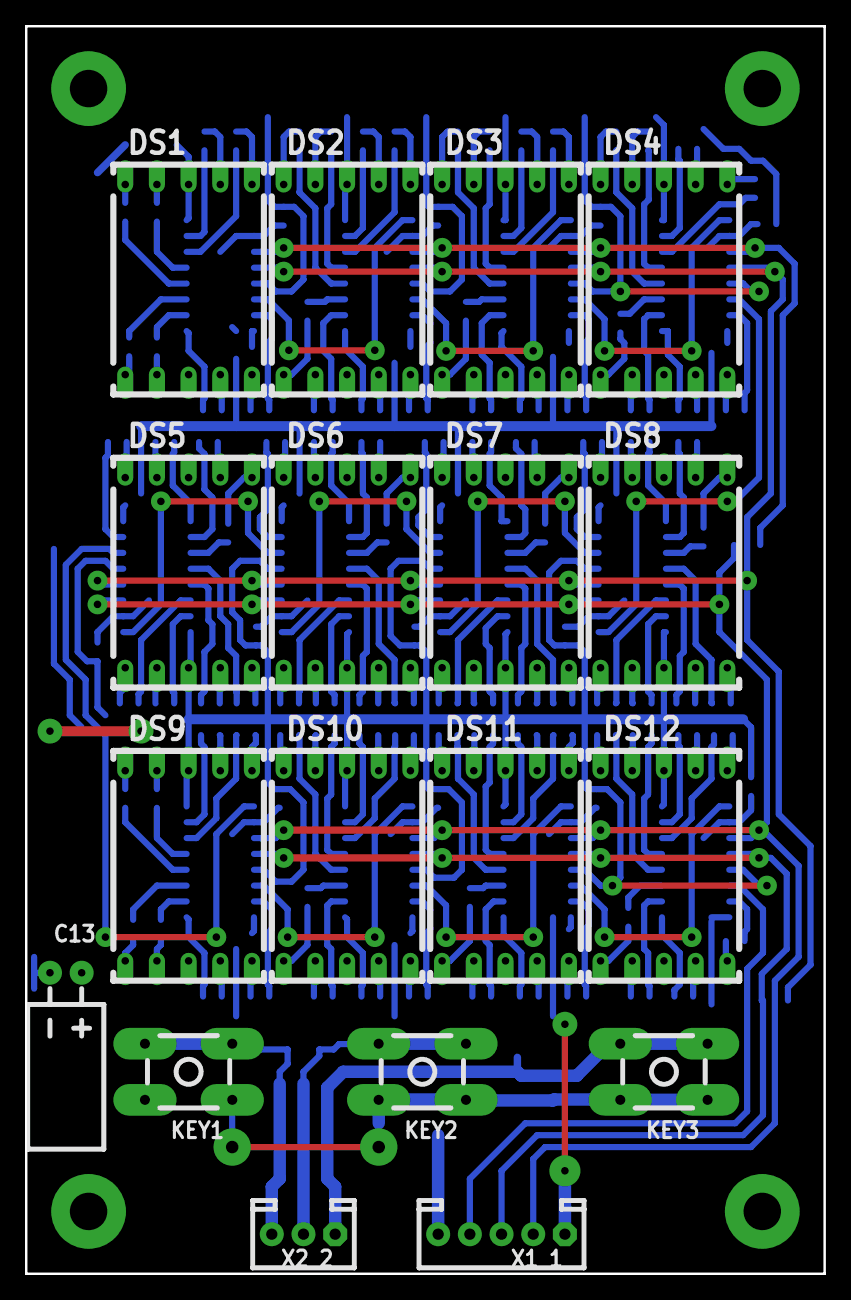
[picture p19: board CurrentMetterLEDScreen.brd from above]

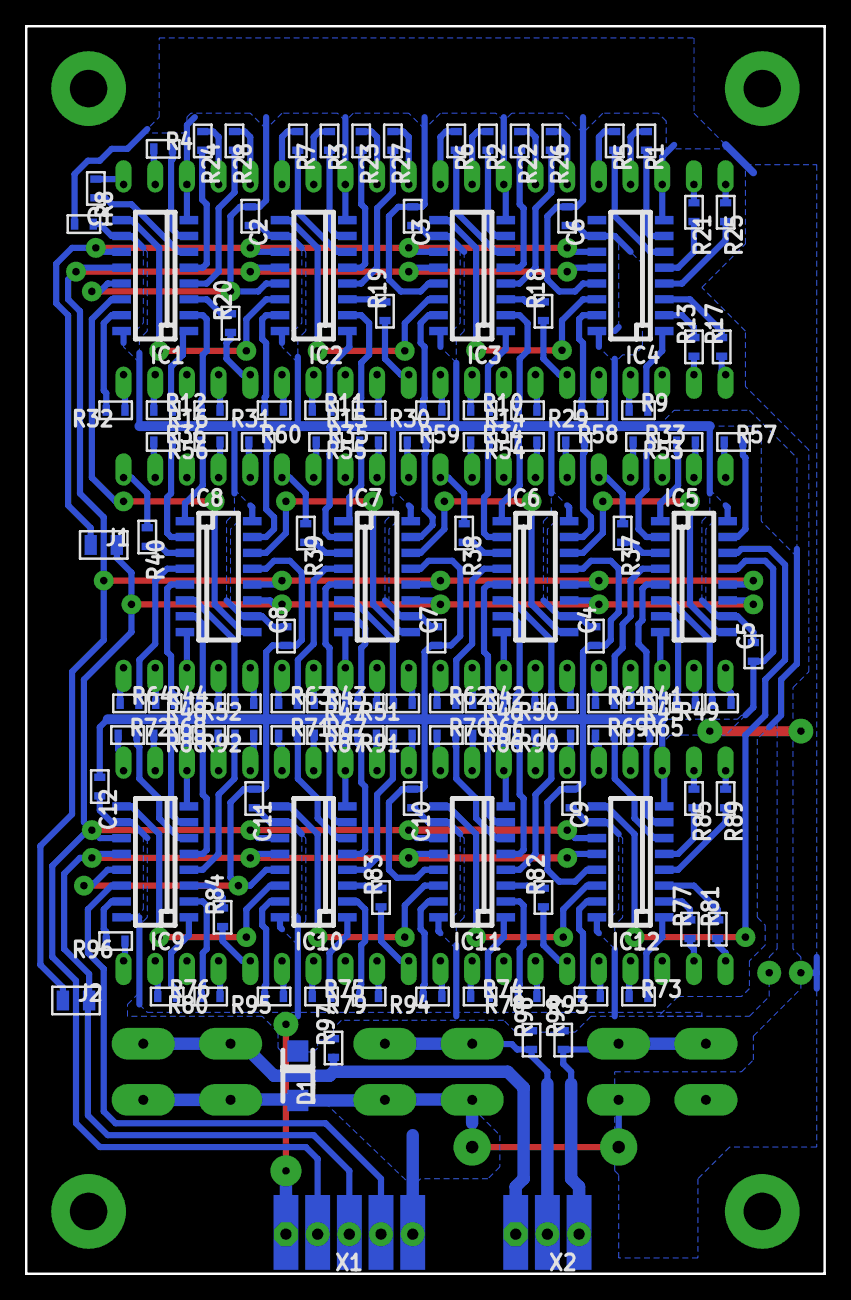
[picture p20: board CurrentMetterLEDScreen.brd from below]

Board: 2 copper layers, 64.0 x 100.0 mm, 146 parts (128 on the bottom side), 211 nets.
