InspectorColombo/ColomboProjects/CurrentMetter/schematic/CurrentMetter.brd

## EAGLE design CurrentMetter/schematic/CurrentMetter.brd (2023-05-12)

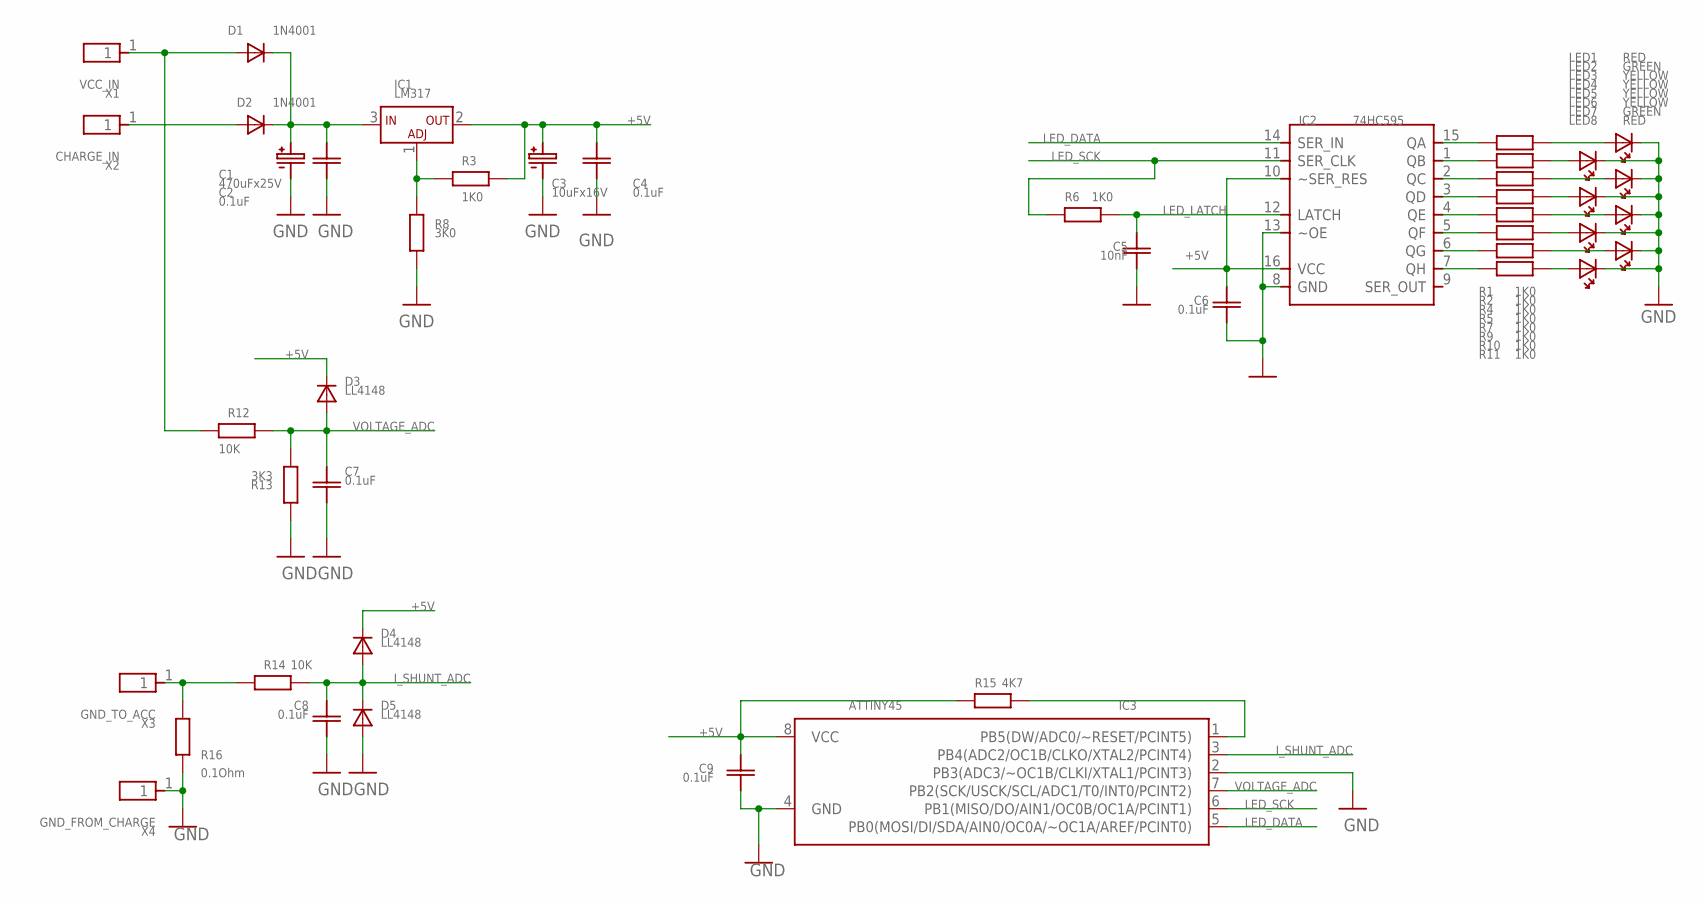
[picture p21: schematic CurrentMetter.sch]

Parts:
C1: 470uFx25V; CE_6.3MM
C2, C4, C6, C7, C8, C9: 0.1uF; RSMD_0805
C3: 10uFx16V; CE_5.2MM
C5: 10nF; RSMD_0805
D1, D2: 1N4001; DO-41_10MM
D3, D4, D5: LL4148; SOD-80
IC1: LM317; D2PAK
IC2: 74HC595; SOIC16
IC3: ATTINY45; SOIC8(0.15'')
LED1, LED8: RED; LED3MM
LED2, LED7: GREEN; LED3MM
LED3, LED4, LED5, LED6: YELLOW; LED3MM
R1: 1K0; RSMD_1206
R2, R3, R4, R5, R6, R7, R9, R10, R11: 1K0; RSMD_0805
R8: 3K0; RSMD_0805
R12: 10K; RSMD_1206_BIG_GAP
R13: 3K3; RSMD_0805
R14: 10K; RSMD_0805
R15: 4K7; RSMD_0805
R16: 0.1Ohm; R_1.0W
X1: VCC_IN; PIN1X1_3.5MM_SIDE_BOARD
X2: CHARGE_IN; PIN1X1_3.5MM_SIDE_BOARD
X3: GND_TO_ACC; PIN1X1_3.5MM_SIDE_BOARD
X4: GND_FROM_CHARGE; PIN1X1_3.5MM_SIDE_BOARD

Connections:
+5V: C3.PLUS, C4.PAD_0 (PIN0), C6.PAD_0 (PIN0), C9.PAD_0 (PIN0), D3.CATHODE, D4.CATHODE, IC1.2 (OUT), IC2.10 (~SER_RES), IC2.16 (VCC), IC3.8 (VCC), R3.PAD_1 (PIN1), R15.PAD_0 (PIN0)
GND: C1.MINUS, C2.PAD_1 (PIN1), C3.MINUS, C4.PAD_1 (PIN1), C5.PAD_1 (PIN1), C6.PAD_1 (PIN1), C7.PAD_1 (PIN1), C8.PAD_1 (PIN1), C9.PAD_1 (PIN1), D5.ANODE, IC2.8 (GND), IC2.13 (~OE), IC3.2 (PB3(ADC3/~OC1B/CLKI/XTAL1/PCINT3)), IC3.4 (GND), LED1.CATHODE, LED2.CATHODE, LED3.CATHODE, LED4.CATHODE, LED5.CATHODE, LED6.CATHODE, LED7.CATHODE, LED8.CATHODE, R8.PAD_0 (PIN0), R13.PAD_0 (PIN0), R16.PAD1 (PIN1), X4.1
I_SHUNT_ADC: C8.PAD_0 (PIN0), D4.ANODE, D5.CATHODE, IC3.3 (PB4(ADC2/OC1B/CLKO/XTAL2/PCINT4)), R14.PAD_1 (PIN1)
LED_DATA: IC2.14 (SER_IN), IC3.5 (PB0(MOSI/DI/SDA/AIN0/OC0A/~OC1A/AREF/PC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)
LED_LATCH: C5.PAD_0 (PIN0), IC2.12 (LATCH), R6.PAD_1 (PIN1)
LED_SCK: IC2.11 (SER_CLK), IC3.6 (PB1(MISO/DO/AIN1/OC0B/OC1A/PCINT1)), R6.PAD_0 (PIN0)
unnamed: IC2.6 (QG), R10.PAD_0 (PIN0)
unnamed: IC2.7 (QH), R11.PAD_0 (PIN0)
unnamed: LED7.ANODE, R10.PAD_1 (PIN1)
unnamed: LED4.ANODE, R5.PAD_1 (PIN1)
unnamed: IC3.1 (PB5(DW/ADC0/~RESET/PCINT5)), R15.PAD_1 (PIN1)
unnamed: C1.PLUS, C2.PAD_0 (PIN0), D1.CATHODE, D2.CATHODE, IC1.3 (IN)
unnamed: LED1.ANODE, R1.PAD_1 (PIN1)
unnamed: LED3.ANODE, R4.PAD_1 (PIN1)
unnamed: LED6.ANODE, R9.PAD_1 (PIN1)
unnamed: LED8.ANODE, R11.PAD_1 (PIN1)
unnamed: LED2.ANODE, R2.PAD_1 (PIN1)
unnamed: LED5.ANODE, R7.PAD_1 (PIN1)
unnamed: IC2.15 (QA), R1.PAD_0 (PIN0)
unnamed: IC2.1 (QB), R2.PAD_0 (PIN0)
unnamed: IC2.2 (QC), R4.PAD_0 (PIN0)
unnamed: IC2.3 (QD), R5.PAD_0 (PIN0)
unnamed: IC2.4 (QE), R7.PAD_0 (PIN0)
unnamed: IC2.5 (QF), R9.PAD_0 (PIN0)
unnamed: R14.PAD_0 (PIN0), R16.PAD_0 (PIN0), X3.1
unnamed: D1.ANODE, R12.PAD_0 (PIN0), X1.1
unnamed: D2.ANODE, X2.1
unnamed: IC1.1 (ADJ), R3.PAD_0 (PIN0), R8.PAD_1 (PIN1)
VOLTAGE_ADC: C7.PAD_0 (PIN0), D3.ANODE, IC3.7 (PB2(SCK/USCK/SCL/ADC1/T0/INT0/PCINT2)), R12.PAD_1 (PIN1), R13.PAD_1 (PIN1)

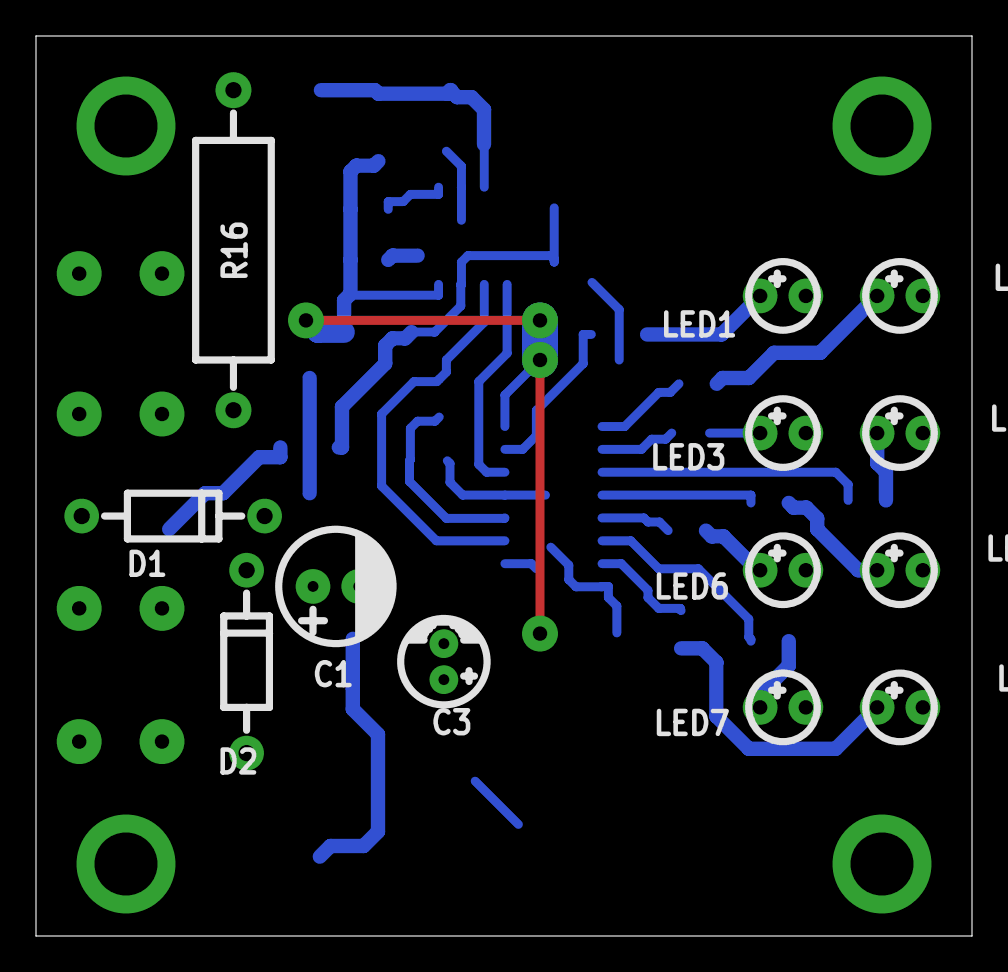
[picture p22: board CurrentMetter.brd from above]

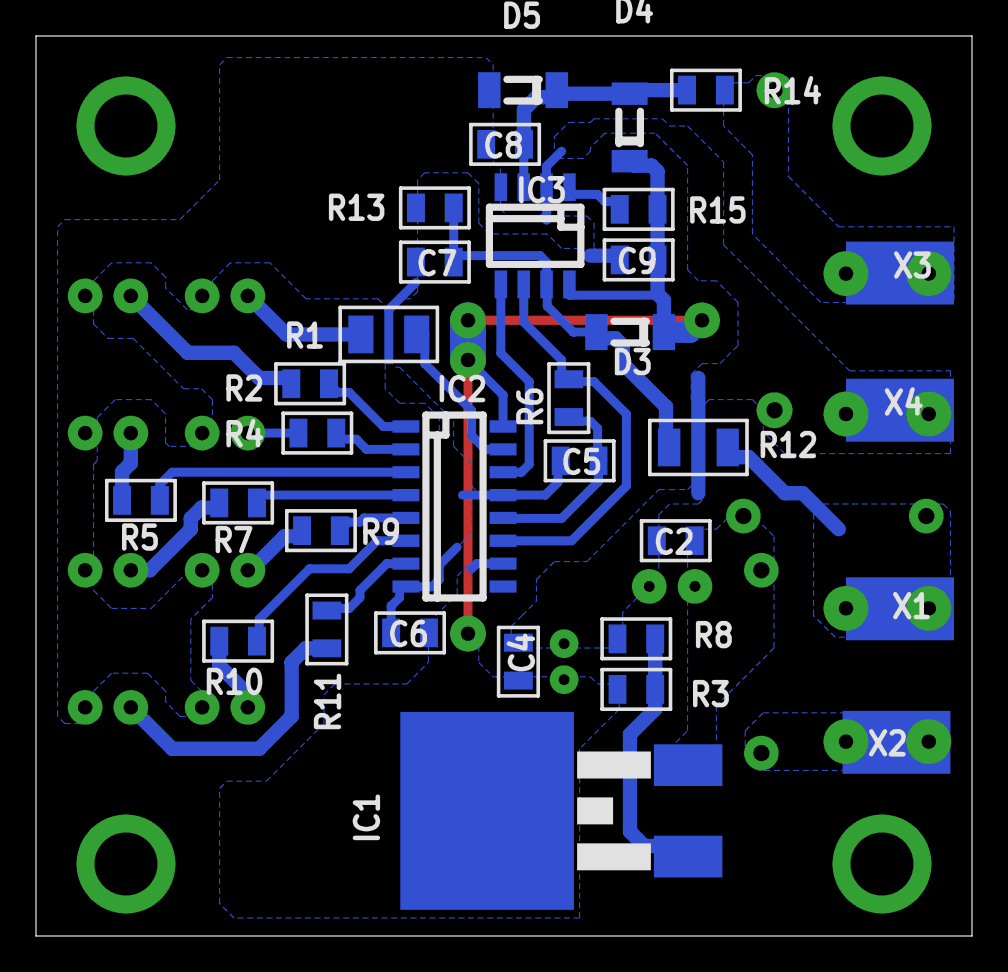
[picture p23: board CurrentMetter.brd from below]

Board: 2 copper layers, 52.0 x 50.0 mm, 45 parts (32 on the bottom side), 29 nets.
