InspectorColombo/ColomboProjects/SoftStartBoard/PotenciometersBoard/PotenciometersBoard.brd

## EAGLE design SoftStartBoard/PotenciometersBoard/PotenciometersBoard.brd (2026-07-28)

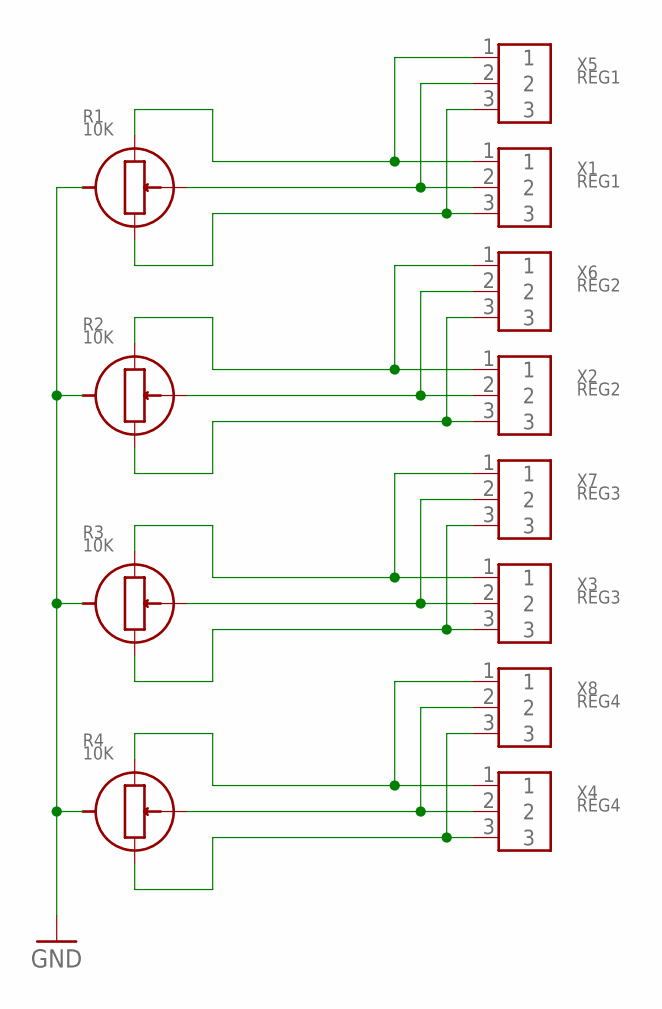
[picture p26: schematic PotenciometersBoard.sch]

Parts:
R1, R2, R3, R4: 10K; SP3-4AM
X1: REG1; PIN3X1_2.54MM_WITH_CLAMP
X2: REG2; PIN3X1_2.54MM_WITH_CLAMP
X3: REG3; PIN3X1_2.54MM_WITH_CLAMP
X4: REG4; PIN3X1_2.54MM_WITH_CLAMP
X5: REG1; PIN1X3_2.54MM_SIDE_BOARD
X6: REG2; PIN1X3_2.54MM_SIDE_BOARD
X7: REG3; PIN1X3_2.54MM_SIDE_BOARD
X8: REG4; PIN1X3_2.54MM_SIDE_BOARD

Connections:
GND: R1.PACKAGE1 (PACKAGE), R1.PACKAGE2 (PACKAGE), R2.PACKAGE1 (PACKAGE), R2.PACKAGE2 (PACKAGE), R3.PACKAGE1 (PACKAGE), R3.PACKAGE2 (PACKAGE), R4.PACKAGE1 (PACKAGE), R4.PACKAGE2 (PACKAGE)
unnamed: R1.END_B, X1.1, X5.1
unnamed: R1.MIDDLE, X1.2, X5.2
unnamed: R1.END_A, X1.3, X5.3
unnamed: R2.END_B, X2.1, X6.1
unnamed: R2.MIDDLE, X2.2, X6.2
unnamed: R2.END_A, X2.3, X6.3
unnamed: R3.END_B, X3.1, X7.1
unnamed: R3.MIDDLE, X3.2, X7.2
unnamed: R3.END_A, X3.3, X7.3
unnamed: R4.END_B, X4.1, X8.1
unnamed: R4.MIDDLE, X4.2, X8.2
unnamed: R4.END_A, X4.3, X8.3

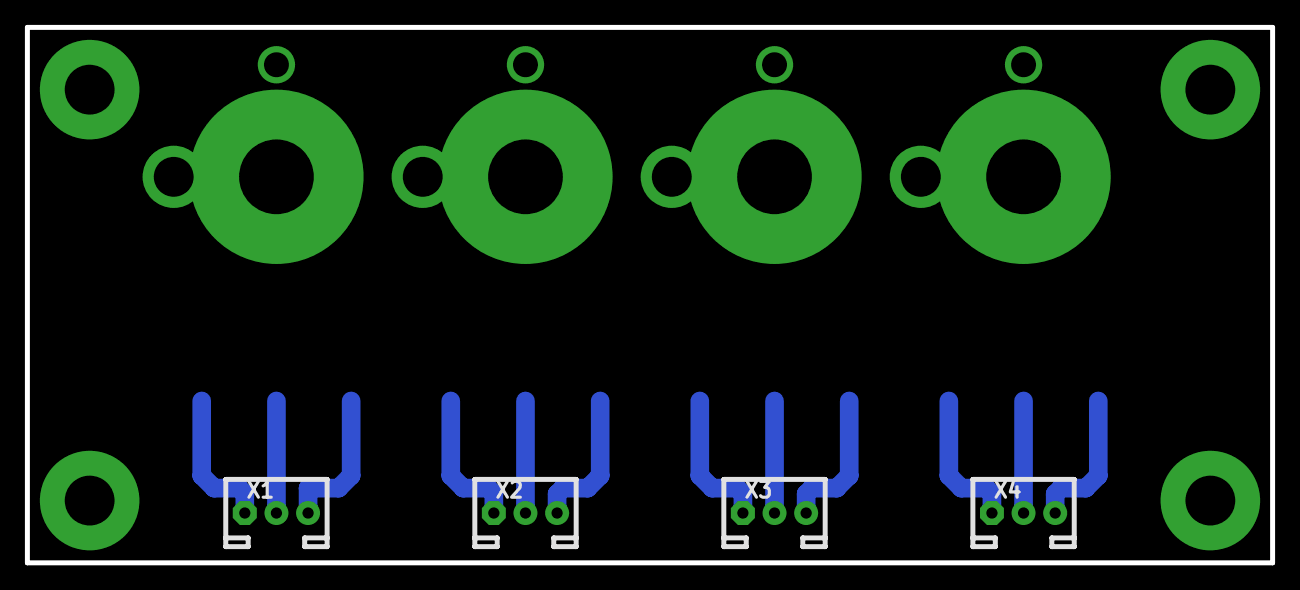
[picture p27: board PotenciometersBoard.brd from above]

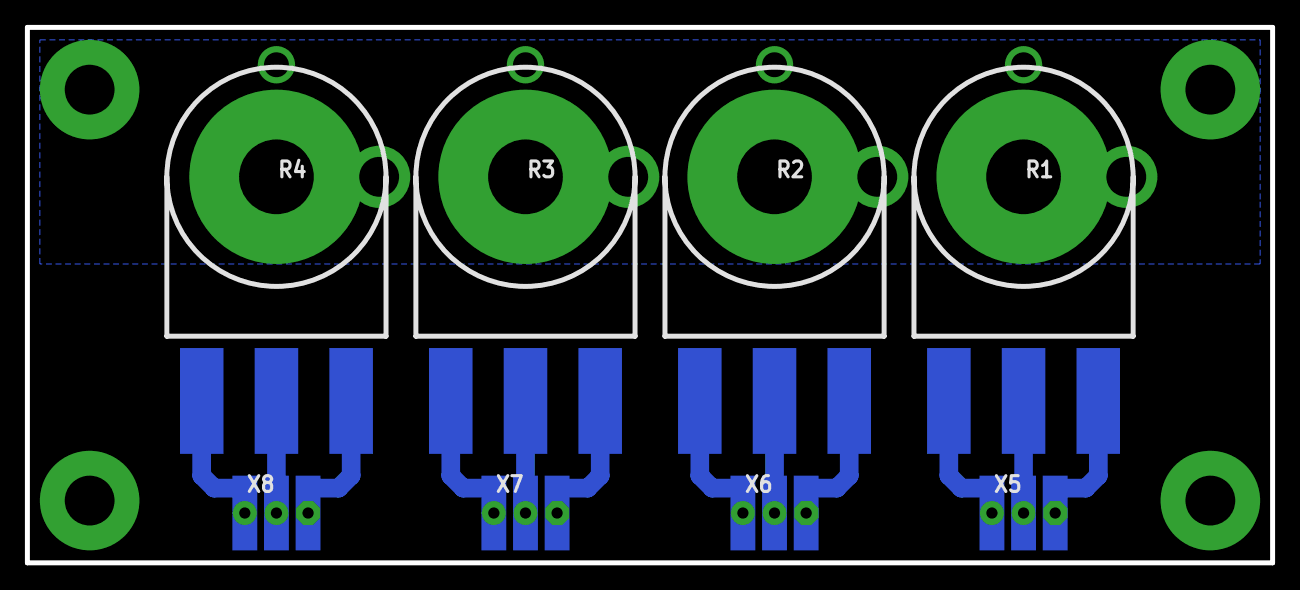
[picture p28: board PotenciometersBoard.brd from below]

Board: 2 copper layers, 100.0 x 43.0 mm, 12 parts (8 on the bottom side), 13 nets.
