InspectorColombo/ColomboProjects/SoftStartBoard/schematic/SoftStart_V2_0.brd

## EAGLE design SoftStartBoard/schematic/SoftStart_V2_0.brd (2026-07-28)

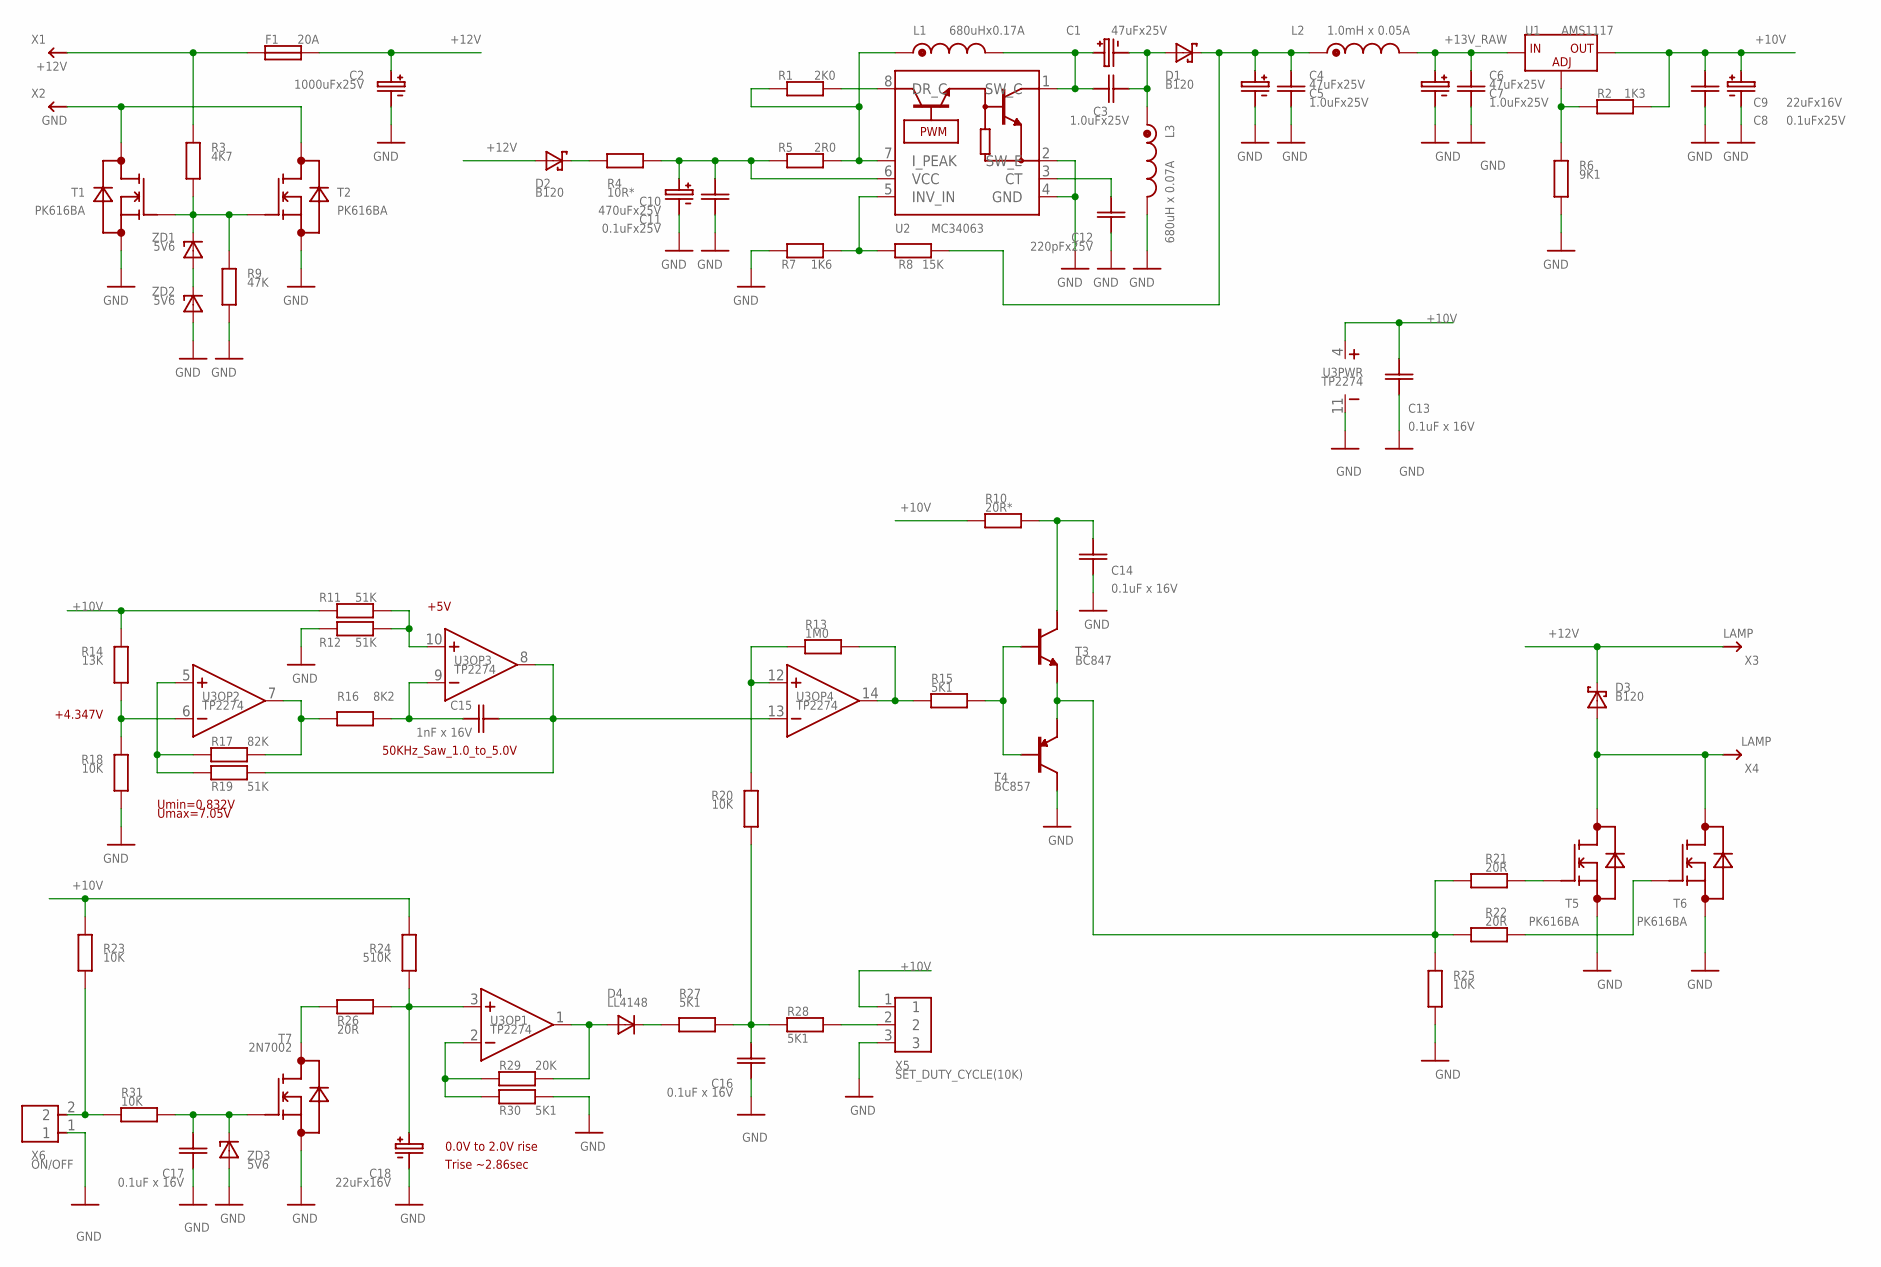
[picture p29: schematic SoftStart_V2_0.sch]

Parts:
C1, C4, C6: 47uFx25V; CE_6.3MM
C2: 1000uFx25V; CE_10MM
C3, C5, C7: 1.0uFx25V; RSMD_1206
C8: 0.1uFx25V; RSMD_0805
C9, C18: 22uFx16V; CE_6.3MM
C10: 470uFx25V; CE_10MM
C11: 0.1uFx25V; RSMD_1206
C12: 220pFx25V; RSMD_0805
C13, C14, C16, C17: 0.1uF x 16V; RSMD_0805
C15: 1nF x 16V; RSMD_0805
D1, D2, D3: B120; DO-214AC
D4: LL4148; SOD-80
F1: 20A; FUSE_AUTO_MINI_ON_TERMINALS
L1: 680uHx0.17A; LCHB0608
L2: 1.0mH x 0.05A; LCHB0608
L3: 680uH x 0.07A; LCHB0608
R1: 2K0; RSMD_0805
R2: 1K3; RSMD_0805
R3: 4K7; RSMD_0805
R4: 10R*; RSMD_1206_BIG_GAP
R5: 2R0; RSMD_1206_BIG_GAP
R6: 9K1; RSMD_0805
R7: 1K6; RSMD_0805
R8: 15K; RSMD_0805
R9: 47K; RSMD_0805
R10: 20R*; RSMD_1206
R11, R12, R19: 51K; RSMD_0805
R13: 1M0; RSMD_0805
R14: 13K; RSMD_0805
R15, R27, R28, R30: 5K1; RSMD_0805
R16: 8K2; RSMD_0805
R17: 82K; RSMD_0805
R18, R23, R25, R31: 10K; RSMD_0805
R20: 10K; RSMD_1206_BIG_GAP
R21, R22, R26: 20R; RSMD_0805
R24: 510K; RSMD_0805
R29: 20K; RSMD_0805
T1, T2, T5, T6: PK616BA; PDFN_5X6P
T3: BC847; SOT23
T4: BC857; SOT23
T7: 2N7002; SOT23
U1: AMS1117; SOT223(WAVE_SOLDERING)
U2: MC34063; SOIC8
U3: TP2274; SOIC14
X1: +12V; RPI_6.3
X2: GND; RPI_6.3
X3, X4: LAMP; RPI_6.3
X5: SET_DUTY_CYCLE(10K); PIN3X1_2.54MM_WITH_CLAMP
X6: ON/OFF; PIN2X1_2.54_WITH_CLAMP
ZD1, ZD2, ZD3: 5V6; SOD-80

Connections:
+10V: C8.PAD_1 (PIN1), C9.PLUS, C13.PAD_1 (PIN1), R2.PAD_0 (PIN0), R10.PAD_0 (PIN0), R11.PAD_1 (PIN1), R14.PAD_1 (PIN1), R23.PAD_1 (PIN1), R24.PAD_1 (PIN1), U1.2 (OUT), U1.4 (OUT), U3.4 (VCC), X5.1
+12V: C2.PLUS, D2.ANODE, D3.CATHODE, F1.PAD0 (PIN0), X3.PAD1, X3.PAD2
+13V_RAW: C6.PLUS, C7.PAD_0 (PIN0), L2.2 (END), U1.3 (IN)
GND: C2.MINUS, C4.MINUS, C5.PAD_1 (PIN1), C6.MINUS, C7.PAD_1 (PIN1), C8.PAD_0 (PIN0), C9.MINUS, C10.MINUS, C11.PAD_0 (PIN0), C12.PAD_0 (PIN0), C13.PAD_0 (PIN0), C14.PAD_0 (PIN0), C16.PAD_0 (PIN0), C17.PAD_0 (PIN0), C18.MINUS, L3.2 (END), R6.PAD_0 (PIN0), R7.PAD_0 (PIN0), R9.PAD_0 (PIN0), R12.PAD_1 (PIN1), R18.PAD_0 (PIN0), R25.PAD_1 (PIN1), R30.PAD_0 (PIN0), T1.S1 (SOURCE), T1.S2 (SOURCE), T1.S3 (SOURCE), T2.S1 (SOURCE), T2.S2 (SOURCE), T2.S3 (SOURCE), T4.3 (C), T5.S1 (SOURCE), T5.S2 (SOURCE), T5.S3 (SOURCE), T6.S1 (SOURCE), T6.S2 (SOURCE), T6.S3 (SOURCE), T7.2 (SOURCE), U2.2 (SW_E), U2.4 (GND), U3.11 (GND), X5.3, X6.1, ZD2.ANODE, ZD3.ANODE
unnamed: R3.PAD_0 (PIN0), R9.PAD_1 (PIN1), T1.G (GATE), T2.G (GATE), ZD1.CATHODE
unnamed: T1.D (DRAIN), T1.D1 (DRAIN), T1.D2 (DRAIN), T1.D3 (DRAIN), T1.D4 (DRAIN), T2.D (DRAIN), T2.D1 (DRAIN), T2.D2 (DRAIN), T2.D3 (DRAIN), T2.D4 (DRAIN), X2.PAD1, X2.PAD2
unnamed: ZD1.ANODE, ZD2.CATHODE
unnamed: F1.PAD1 (PIN1), R3.PAD_1 (PIN1), X1.PAD1, X1.PAD2
unnamed: L1.1 (START), R1.PAD_1 (PIN1), R5.PAD_0 (PIN0), U2.7 (I_PEAK)
unnamed: D2.CATHODE, R4.PAD_1 (PIN1)
unnamed: R2.PAD_1 (PIN1), R6.PAD_1 (PIN1), U1.1 (ADJ)
unnamed: D3.ANODE, T5.D (DRAIN), T5.D1 (DRAIN), T5.D2 (DRAIN), T5.D3 (DRAIN), T5.D4 (DRAIN), T6.D (DRAIN), T6.D1 (DRAIN), T6.D2 (DRAIN), T6.D3 (DRAIN), T6.D4 (DRAIN), X4.PAD1, X4.PAD2
unnamed: R22.PAD_0 (PIN0), T6.G (GATE)
unnamed: R21.PAD_0 (PIN0), T5.G (GATE)
unnamed: D4.CATHODE, R27.PAD_0 (PIN0)
unnamed: R17.PAD_0 (PIN0), R19.PAD_0 (PIN0), U3.5 (IN+)
unnamed: R16.PAD_0 (PIN0), R17.PAD_1 (PIN1), U3.7 (OUT)
unnamed: R14.PAD_0 (PIN0), R18.PAD_1 (PIN1), U3.6 (IN-)
unnamed: R29.PAD_1 (PIN1), R30.PAD_1 (PIN1), U3.2 (IN-)
unnamed: R11.PAD_0 (PIN0), R12.PAD_0 (PIN0), U3.10 (IN+)
unnamed: C15.PAD_1 (PIN1), R16.PAD_1 (PIN1), U3.9 (IN-)
unnamed: C15.PAD_0 (PIN0), R19.PAD_1 (PIN1), U3.8 (OUT), U3.13 (IN-)
unnamed: D4.ANODE, R29.PAD_0 (PIN0), U3.1 (OUT)
unnamed: C16.PAD_1 (PIN1), R20.PAD_0 (PIN0), R27.PAD_1 (PIN1), R28.PAD_1 (PIN1)
unnamed: C17.PAD_1 (PIN1), R31.PAD_0 (PIN0), T7.1 (GATE), ZD3.CATHODE
unnamed: R28.PAD_0 (PIN0), X5.2
unnamed: R13.PAD_0 (PIN0), R20.PAD_1 (PIN1), U3.12 (IN+)
unnamed: R13.PAD_1 (PIN1), R15.PAD_0 (PIN0), U3.14 (OUT)
unnamed: R15.PAD_1 (PIN1), T3.1 (B), T4.1 (B)
unnamed: R21.PAD_1 (PIN1), R22.PAD_1 (PIN1), R25.PAD_0 (PIN0), T3.2 (E), T4.2 (E)
unnamed: C14.PAD_1 (PIN1), R10.PAD_1 (PIN1), T3.3 (C)
unnamed: C1.PLUS, C3.PAD_1 (PIN1), L1.2 (END), U2.1 (SW_C)
unnamed: C1.MINUS, C3.PAD_0 (PIN0), D1.ANODE, L3.1 (START)
unnamed: C10.PLUS, C11.PAD_1 (PIN1), R4.PAD_0 (PIN0), R5.PAD_1 (PIN1), U2.6 (VCC)
unnamed: R1.PAD_0 (PIN0), U2.8 (DR_C)
unnamed: C12.PAD_1 (PIN1), U2.3 (CT)
unnamed: C4.PLUS, C5.PAD_0 (PIN0), D1.CATHODE, L2.1 (START), R8.PAD_1 (PIN1)
unnamed: R7.PAD_1 (PIN1), R8.PAD_0 (PIN0), U2.5 (INV_IN)
unnamed: R26.PAD_0 (PIN0), T7.3 (DRAIN)
unnamed: C18.PLUS, R24.PAD_0 (PIN0), R26.PAD_1 (PIN1), U3.3 (IN+)
unnamed: R23.PAD_0 (PIN0), R31.PAD_1 (PIN1), X6.2

Notes on the sheet:
+4.347V
Umin=0.832V
Umax=7.05V
+5V
50KHz_Saw_1.0_to_5.0V
0.0V to 2.0V rise
Trise ~2.86sec

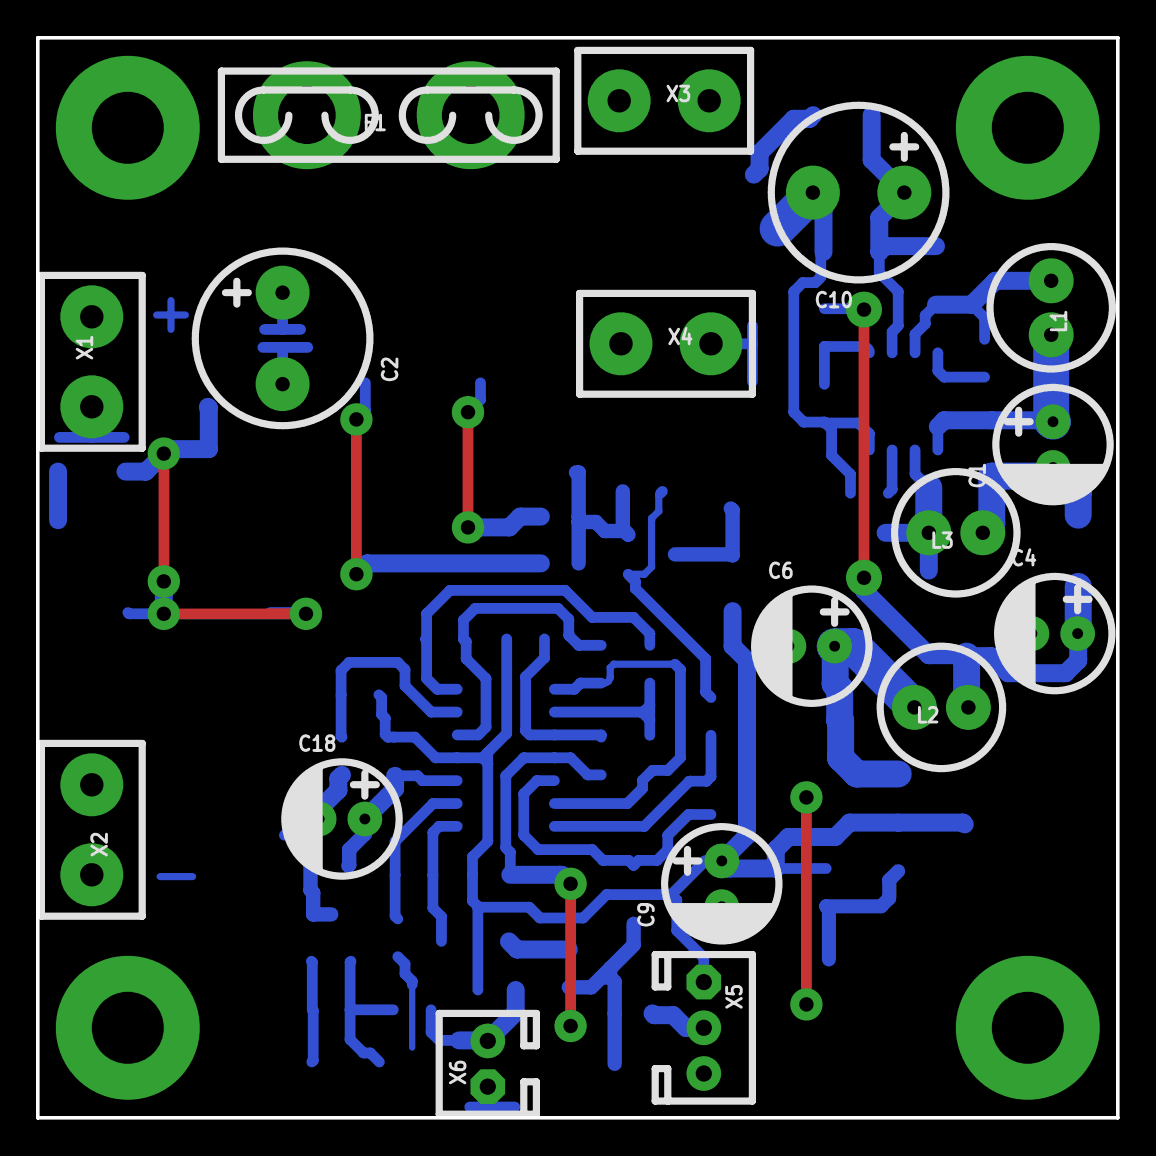
[picture p30: board SoftStart_V2_0.brd from above]

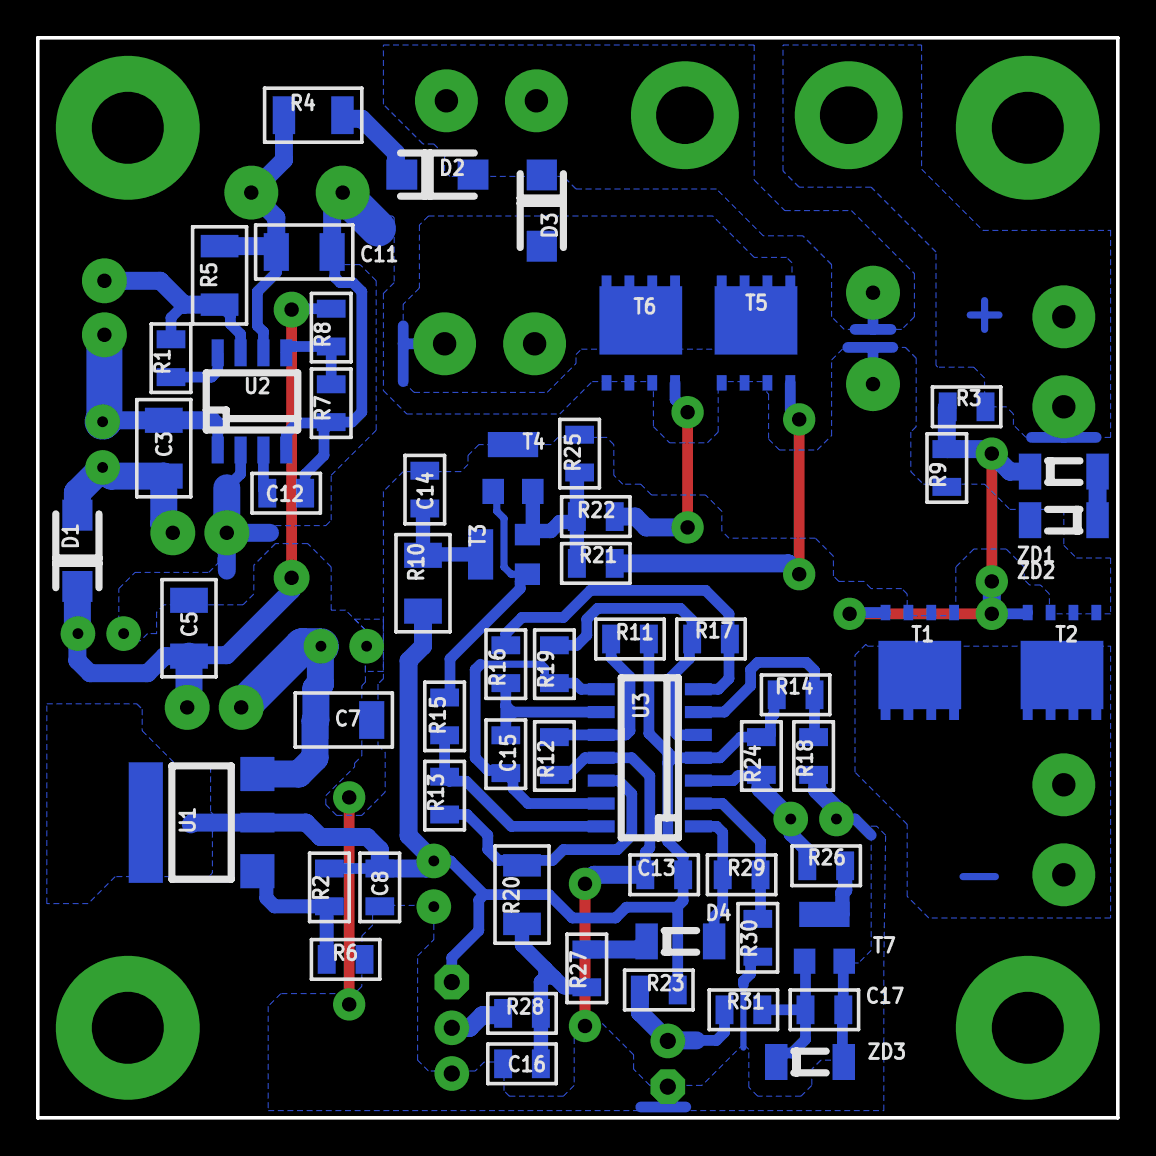
[picture p31: board SoftStart_V2_0.brd from below]

Board: 2 copper layers, 60.0 x 60.0 mm, 76 parts (59 on the bottom side), 41 nets.
