InspectorColombo/ColomboProjects/SWR_Metter/schematic/SwrMetter.brd

## EAGLE design SWR_Metter/schematic/SwrMetter.brd (2026-07-28)

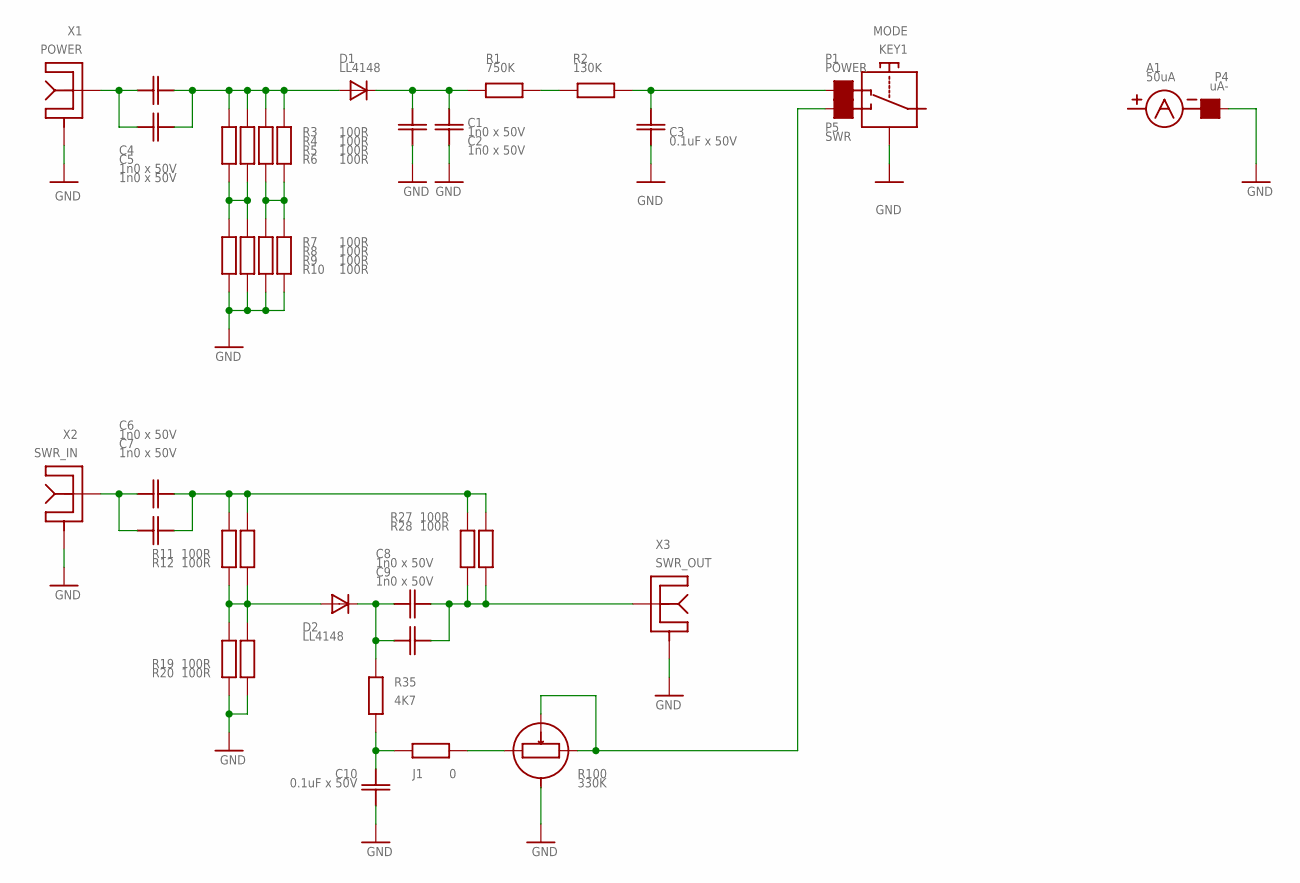
[picture p32: schematic SwrMetter.sch]

Parts:
A1: 50uA; MICRO_AMPMET(UNKNOWN)
C1, C2, C4, C5, C6, C7, C8, C9: 1n0 x 50V; RSMD_1206
C3, C10: 0.1uF x 50V; RSMD_1206
D1, D2: LL4148; SOD-80
J1: 0; RSMD_2512
KEY1: MODE; KEY_MTS1_NO_PINS
P1: POWER; PAD_4X4
P4: uA-; PAD_4X4
P5: SWR; PAD_4X4
R1: 750K; RSMD_1206
R2: 130K; RSMD_1206
R3, R4, R5, R6, R7, R8, R9, R10, R11, R12, R19, R20, R27, R28: 100R; RSMD_2512
R35: 4K7; RSMD_0805
R100: 330K; SP3-4AM
X1: POWER; PL-239(FEMALE)
X2: SWR_IN; PL-239(FEMALE)
X3: SWR_OUT; PL-239(FEMALE)

Connections:
GND: C1.PAD_0 (PIN0), C2.PAD_0 (PIN0), C3.PAD_0 (PIN0), C10.PAD_1 (PIN1), KEY1.GND1, KEY1.GND2, P4.PAD, R7.PAD0 (PIN0), R8.PAD0 (PIN0), R9.PAD0 (PIN0), R10.PAD0 (PIN0), R19.PAD0 (PIN0), R20.PAD0 (PIN0), R100.PACKAGE1 (PACKAGE), R100.PACKAGE2 (PACKAGE), X1.CENTER_DRILL (GND), X1.SCREW1 (GND), X1.SCREW2 (GND), X1.SCREW3 (GND), X1.SCREW4 (GND), X2.CENTER_DRILL (GND), X2.SCREW1 (GND), X2.SCREW2 (GND), X2.SCREW3 (GND), X2.SCREW4 (GND), X3.CENTER_DRILL (GND), X3.SCREW1 (GND), X3.SCREW2 (GND), X3.SCREW3 (GND), X3.SCREW4 (GND)
unnamed: J1.PAD0 (PIN0), R100.END_A
unnamed: C4.PAD_0 (PIN0), C5.PAD_0 (PIN0), D1.ANODE, R3.PAD1 (PIN1), R4.PAD1 (PIN1), R5.PAD1 (PIN1), R6.PAD1 (PIN1)
unnamed: C4.PAD_1 (PIN1), C5.PAD_1 (PIN1), X1.SIGNAL
unnamed: C6.PAD_1 (PIN1), C7.PAD_1 (PIN1), X2.SIGNAL
unnamed: C6.PAD_0 (PIN0), C7.PAD_0 (PIN0), R11.PAD1 (PIN1), R12.PAD1 (PIN1), R27.PAD1 (PIN1), R28.PAD1 (PIN1)
unnamed: P5.PAD, R100.END_B, R100.MIDDLE
unnamed: C8.PAD_1 (PIN1), C9.PAD_1 (PIN1), D2.CATHODE, R35.PAD_1 (PIN1)
unnamed: C10.PAD_0 (PIN0), J1.PAD1 (PIN1), R35.PAD_0 (PIN0)
unnamed: D2.ANODE, R11.PAD0 (PIN0), R12.PAD0 (PIN0), R19.PAD1 (PIN1), R20.PAD1 (PIN1)
unnamed: R3.PAD0 (PIN0), R4.PAD0 (PIN0), R7.PAD1 (PIN1), R8.PAD1 (PIN1)
unnamed: R5.PAD0 (PIN0), R6.PAD0 (PIN0), R9.PAD1 (PIN1), R10.PAD1 (PIN1)
unnamed: C8.PAD_0 (PIN0), C9.PAD_0 (PIN0), R27.PAD0 (PIN0), R28.PAD0 (PIN0), X3.SIGNAL
unnamed: C1.PAD_1 (PIN1), C2.PAD_1 (PIN1), D1.CATHODE, R1.PAD_1 (PIN1)
unnamed: R1.PAD_0 (PIN0), R2.PAD_1 (PIN1)
unnamed: C3.PAD_1 (PIN1), P1.PAD, R2.PAD_0 (PIN0)

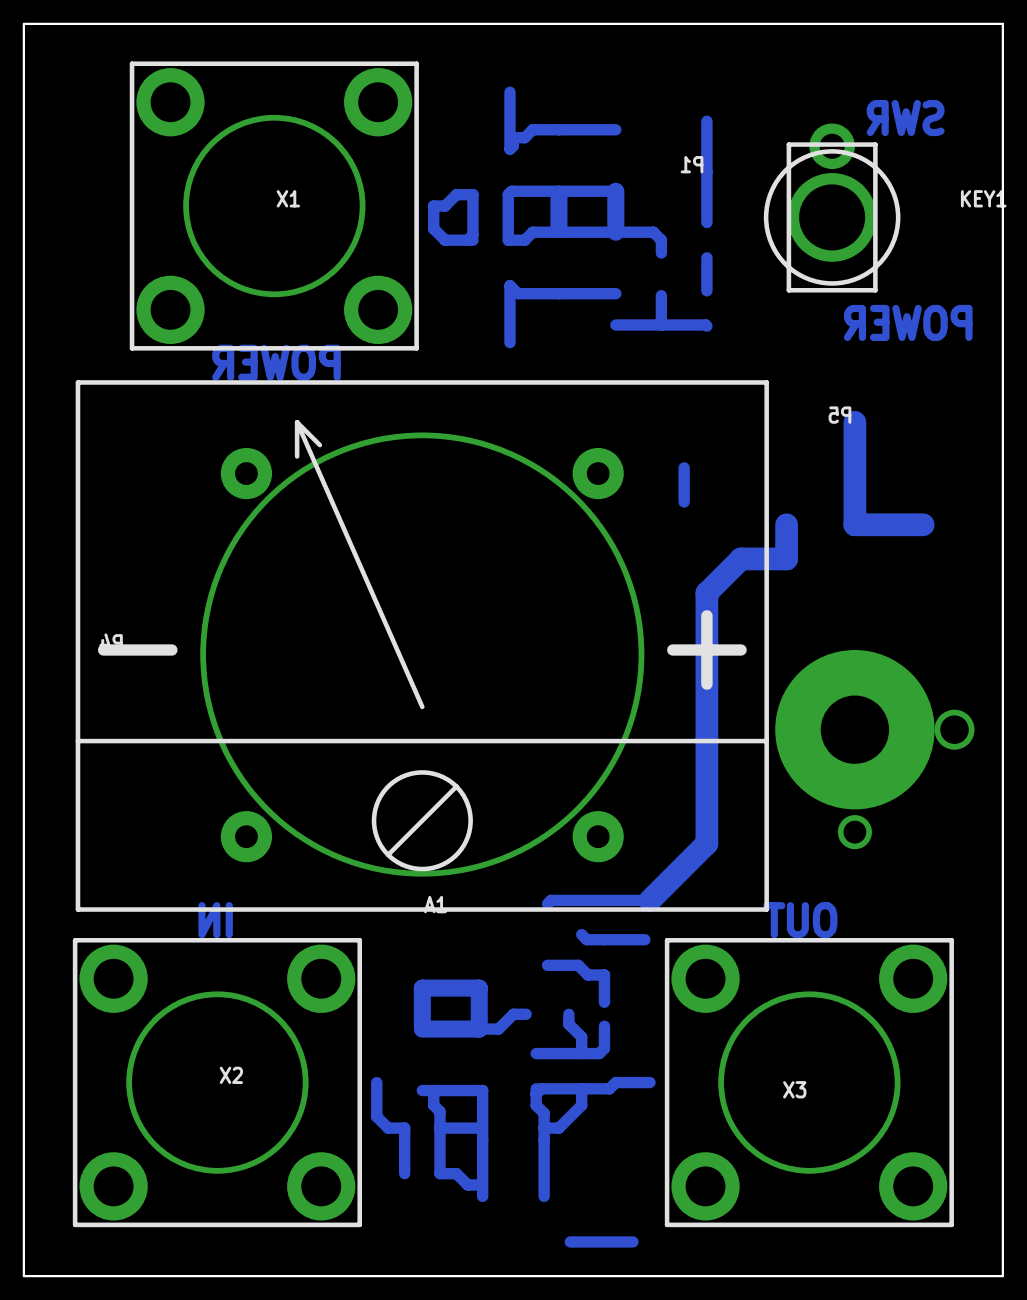
[picture p33: board SwrMetter.brd from above]

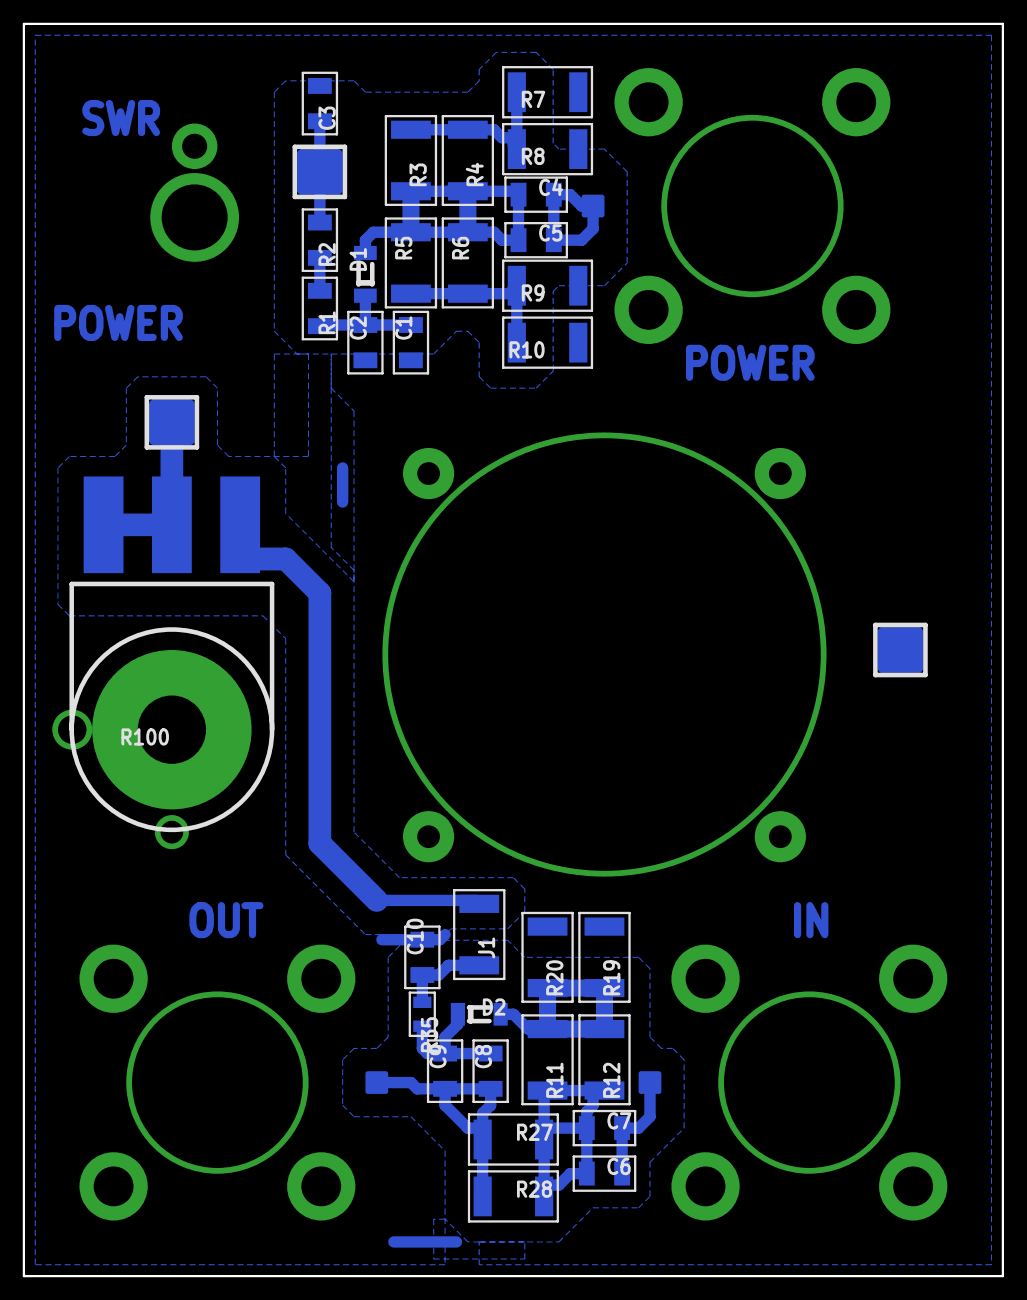
[picture p34: board SwrMetter.brd from below]

Board: 2 copper layers, 86.0 x 110.0 mm, 39 parts (34 on the bottom side), 16 nets.
