InspectorColombo/ColomboProjects/PowerSupply_1600W/CurrentRestrictionBoard/CurrentRestrictionBoard_V1_0.brd

## EAGLE design PowerSupply_1600W/CurrentRestrictionBoard/CurrentRestrictionBoard_V1_0.brd (2026-04-13)

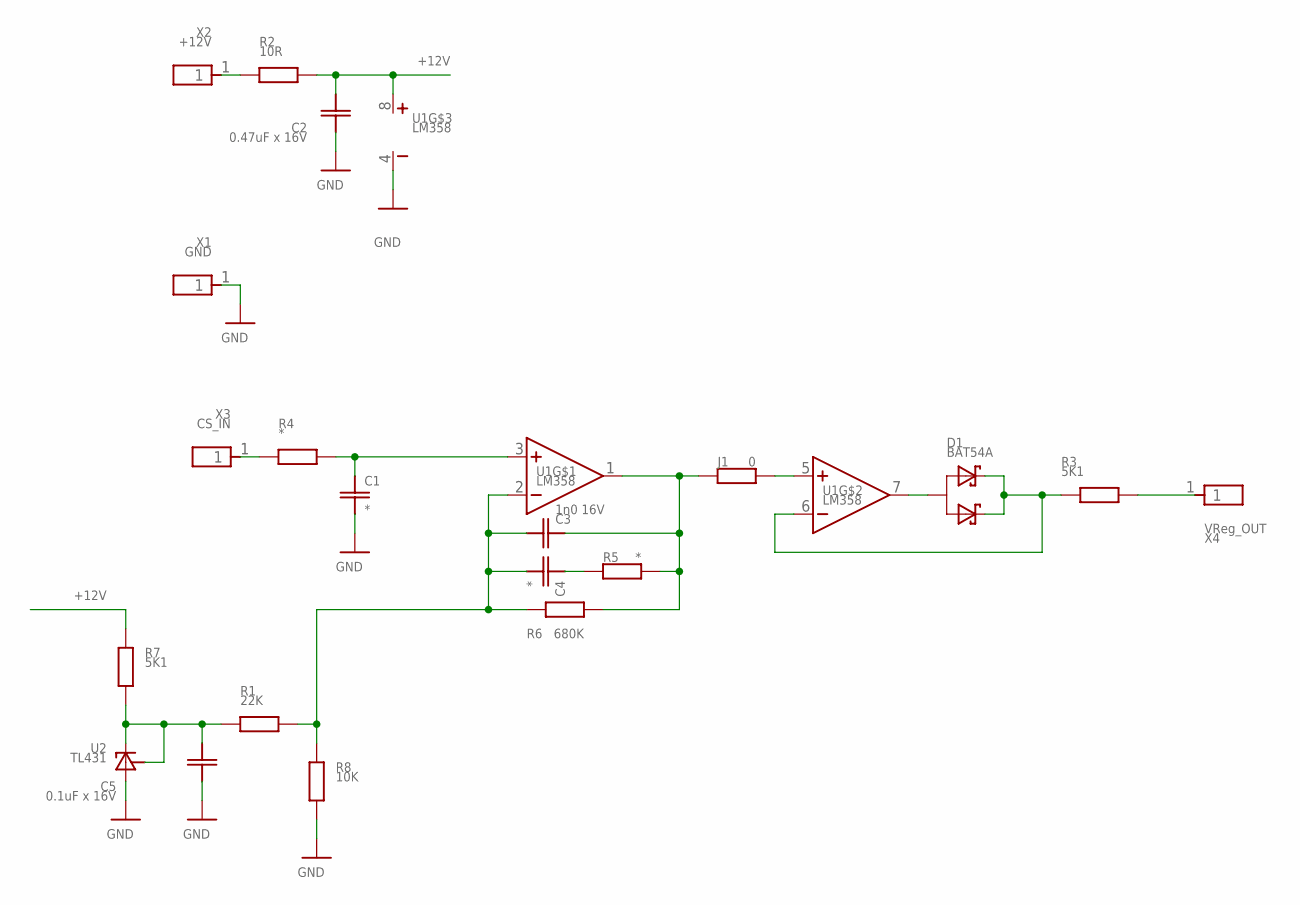
[picture p35: schematic CurrentRestrictionBoard_V1_0.sch]

Parts:
C1, C4: *; RSMD_0603
C2: 0.47uF x 16V; RSMD_0805
C3: 1n0 16V; RSMD_0603
C5: 0.1uF x 16V; RSMD_0603
D1: BAT54A; SOT23_SMALL_PADS
J1: 0; RSMD_0805
R1: 22K; RSMD_0603
R2: 10R; RSMD_0805
R3: 5K1; RSMD_0603
R4, R5: *; RSMD_0603
R6: 680K; RSMD_0603
R7: 5K1; RSMD_0805
R8: 10K; RSMD_0603
U1: LM358; SOIC8
U2: TL431; SOT23
X1: GND; PIN1X1_2.5X2.5MM
X2: +12V; PIN1X1_2.5X2.5MM
X3: CS_IN; PIN1X1_2.5X2.5MM
X4: VReg_OUT; PIN1X1_2.5X2.5MM

Connections:
+12V: C2.PAD_1 (PIN1), R2.PAD_0 (PIN0), R7.PAD_1 (PIN1), U1.8 (VCC)
GND: C1.PAD_0 (PIN0), C2.PAD_0 (PIN0), C5.PAD_0 (PIN0), R8.PAD_0 (PIN0), U1.4 (GND), U2.3 (ANODE), X1.1
unnamed: R2.PAD_1 (PIN1), X2.1
unnamed: R4.PAD_1 (PIN1), X3.1
unnamed: C1.PAD_1 (PIN1), R4.PAD_0 (PIN0), U1.3 (IN+)
unnamed: C3.PAD_0 (PIN0), C4.PAD_0 (PIN0), R1.PAD_0 (PIN0), R6.PAD_1 (PIN1), R8.PAD_1 (PIN1), U1.2 (IN-)
unnamed: C3.PAD_1 (PIN1), J1.PAD_1 (PIN1), R5.PAD_0 (PIN0), R6.PAD_0 (PIN0), U1.1 (OUT)
unnamed: C4.PAD_1 (PIN1), R5.PAD_1 (PIN1)
unnamed: D1.1 (CATHODE1), D1.2 (CATHODE2), R3.PAD_1 (PIN1), U1.6 (IN-)
unnamed: D1.3 (ANODE), U1.7 (OUT)
unnamed: R3.PAD_0 (PIN0), X4.1
unnamed: C5.PAD_1 (PIN1), R1.PAD_1 (PIN1), R7.PAD_0 (PIN0), U2.1 (CATHODE), U2.2 (REFERENCE)
unnamed: J1.PAD_0 (PIN0), U1.5 (IN+)

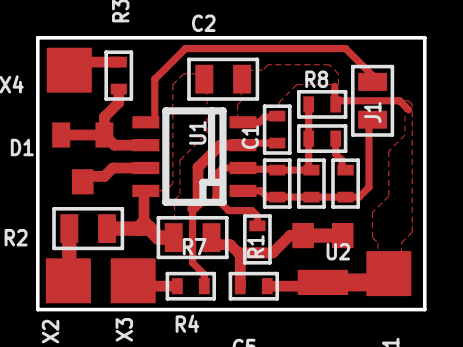
[picture p36: board CurrentRestrictionBoard_V1_0.brd from above]

Board: 2 copper layers, 21.5 x 15.1 mm, 21 parts (0 on the bottom side), 13 nets.
