InspectorColombo/ColomboProjects/HumidityMetter/schematic/HumidityMetter_v2.brd

## EAGLE design HumidityMetter/schematic/HumidityMetter_v2.brd (2025-01-11)

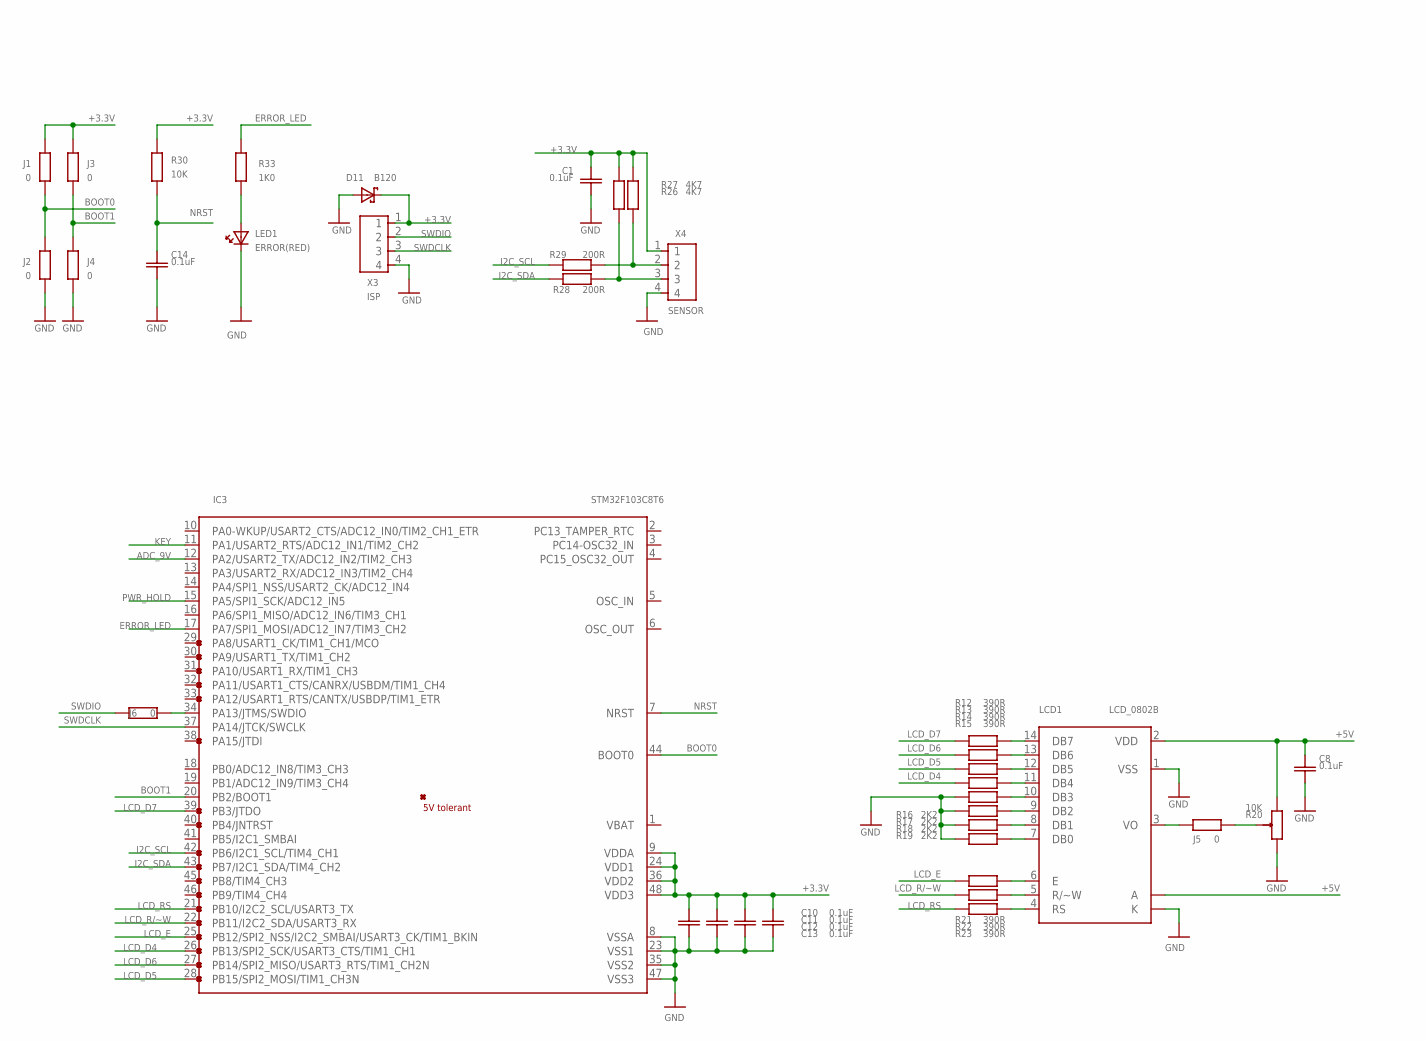
[picture p37: schematic HumidityMetter_v2.sch, part in row 1, column 1]

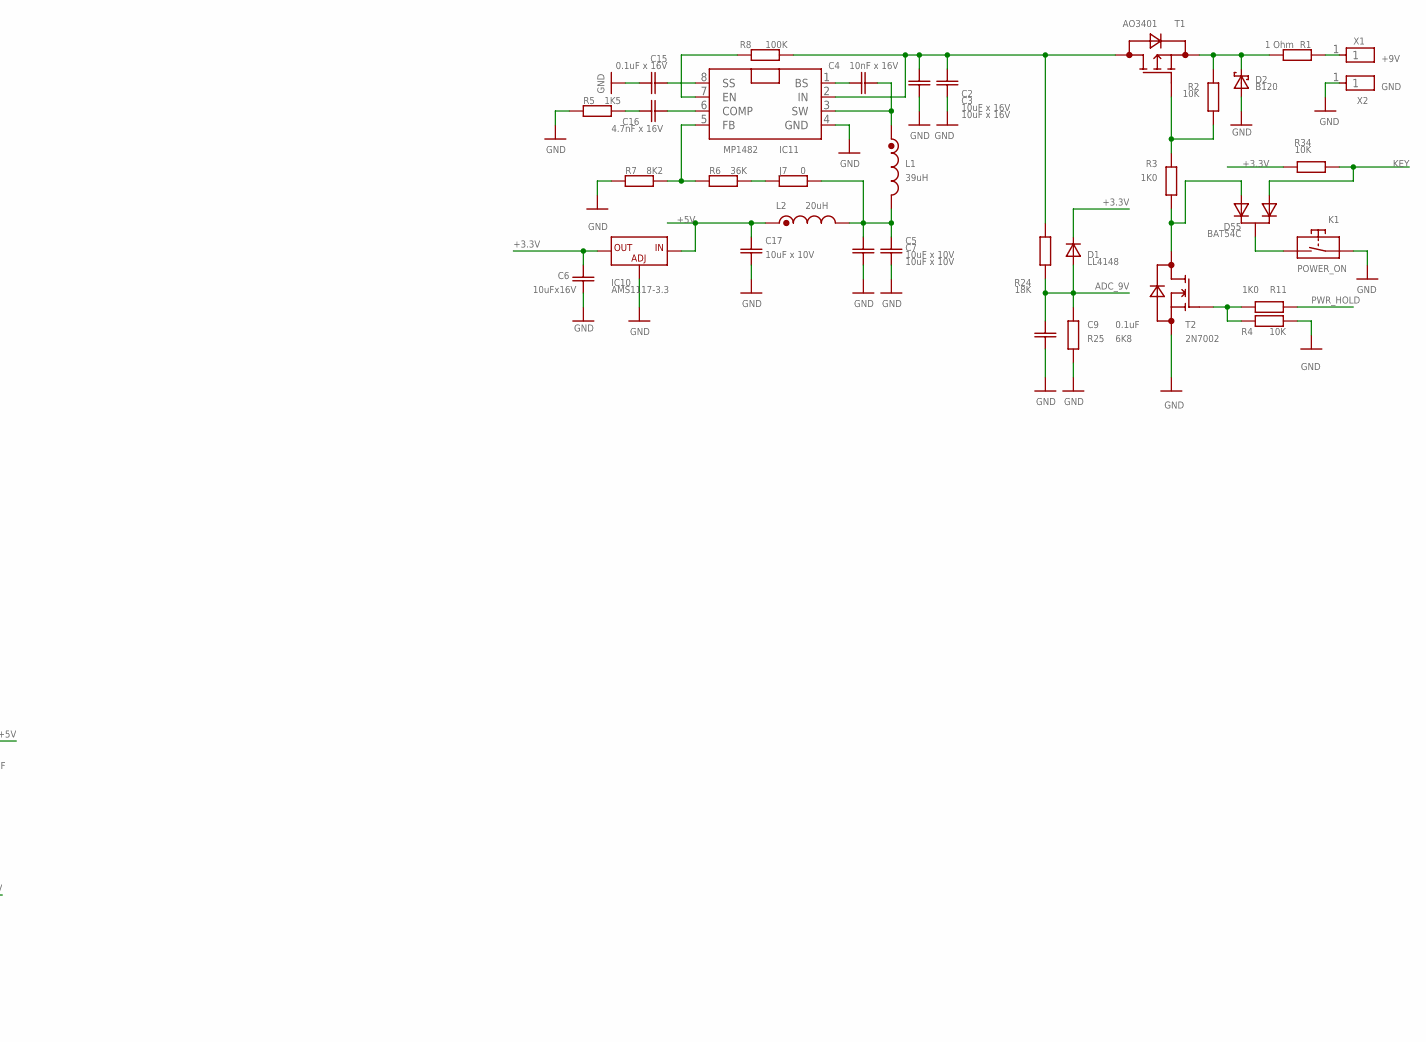
[picture p38: schematic HumidityMetter_v2.sch, part in row 1, column 2]

Parts:
C1, C8, C9, C10, C11, C12, C13, C14: 0.1uF; RSMD_0603
C2, C3: 10uF x 16V; RSMD_1206
C4: 10nF x 16V; RSMD_0603
C5, C7, C17: 10uF x 10V; RSMD_1206
C6: 10uFx16V; RSMD_1206
C15: 0.1uF x 16V; RSMD_0603
C16: 4.7nF x 16V; RSMD_0603
D1: LL4148; SOD-80
D2, D11: B120; DO-214AC
D55: BAT54C; SOT23_SMALL_PADS
IC3: STM32F103C8T6; LQFP48
IC10: AMS1117-3.3; SOT223(WAVE_SOLDERING)
IC11: MP1482; SOIC8
J1, J2, J3, J4: 0; RSMD_0603
J5, J7: 0; RSMD_1206_BIG_GAP
J6: 0; RSMD_0805
K1: POWER_ON; KEY_7X4.5
L1: 39uH; COIL_7MM
L2: 20uH; RSMD_1206
LCD1: LCD_0802B; LCD_0802B_2SCREW(CHINA_CLONE)
LED1: ERROR(RED); LED_0805
R1: 1 Ohm; RSMD_1206
R2, R4, R30, R34: 10K; RSMD_0603
R3, R11, R33: 1K0; RSMD_0603
R5: 1K5; RSMD_0603
R6: 36K; RSMD_0603
R7: 8K2; RSMD_0603
R8: 100K; RSMD_0603
R12: 390R; RSMD_0805
R13, R14, R15, R21, R22, R23: 390R; RSMD_0603
R16, R17, R18, R19: 2K2; RSMD_0603
R20: 10K; R_ADJ_HOR
R24: 18K; RSMD_0603
R25: 6K8; RSMD_0603
R26, R27: 4K7; RSMD_0603
R28, R29: 200R; RSMD_0603
T1: AO3401; SOT23
T2: 2N7002; SOT23_SMALL_PADS
X1: +9V; PIN1X1_3.5MM_PWR
X2: GND; PIN1X1_3.5MM_PWR
X3: ISP; PIN4X1_2.54MM
X4: SENSOR; JST_XH2.5MM_4PIN

Connections:
+3.3V: C1.PAD_1 (PIN1), C6.PAD_1 (PIN1), C10.PAD_1 (PIN1), C11.PAD_1 (PIN1), C12.PAD_1 (PIN1), C13.PAD_1 (PIN1), D1.CATHODE, D11.CATHODE, IC3.9 (VDDA), IC3.24 (VDD1), IC3.36 (VDD2), IC3.48 (VDD3), IC10.2 (OUT), IC10.4 (OUT), J1.PAD_0 (PIN0), J3.PAD_0 (PIN0), R26.PAD_0 (PIN0), R27.PAD_0 (PIN0), R30.PAD_0 (PIN0), R34.PAD_0 (PIN0), X3.1, X4.1
+5V: C8.PAD_1 (PIN1), C17.PAD_1 (PIN1), IC10.3 (IN), L2.PAD_1 (START), LCD1.2 (VDD), LCD1.A, R20.1 (END_A)
ADC_9V: C9.PAD_1 (PIN1), D1.ANODE, IC3.12 (PA2/USART2_TX/ADC12_IN2/TIM2_CH3), R24.PAD_1 (PIN1), R25.PAD_0 (PIN0)
BOOT0: IC3.44 (BOOT0), J1.PAD_1 (PIN1), J2.PAD_0 (PIN0)
BOOT1: IC3.20 (PB2/BOOT1), J3.PAD_1 (PIN1), J4.PAD_0 (PIN0)
ERROR_LED: IC3.17 (PA7/SPI1_MOSI/ADC12_IN7/TIM3_CH2), R33.PAD_0 (PIN0)
GND: C1.PAD_0 (PIN0), C2.PAD_0 (PIN0), C3.PAD_0 (PIN0), C5.PAD_0 (PIN0), C6.PAD_0 (PIN0), C7.PAD_0 (PIN0), C8.PAD_0 (PIN0), C9.PAD_0 (PIN0), C10.PAD_0 (PIN0), C11.PAD_0 (PIN0), C12.PAD_0 (PIN0), C13.PAD_0 (PIN0), C14.PAD_0 (PIN0), C15.PAD_0 (PIN0), C17.PAD_0 (PIN0), D2.ANODE, D11.ANODE, IC3.8 (VSSA), IC3.23 (VSS1), IC3.35 (VSS2), IC3.47 (VSS3), IC10.1 (ADJ), IC11.4 (GND), J2.PAD_1 (PIN1), J4.PAD_1 (PIN1), K1.1, K1.2 (1), LCD1.1 (VSS), LCD1.K, LED1.CATHODE, R4.PAD_1 (PIN1), R5.PAD_1 (PIN1), R7.PAD_1 (PIN1), R16.PAD_1 (PIN1), R17.PAD_1 (PIN1), R18.PAD_1 (PIN1), R19.PAD_1 (PIN1), R20.3 (END_B), R25.PAD_1 (PIN1), T2.2 (SOURCE), X2.1, X3.4, X4.4
I2C_SCL: IC3.42 (PB6/I2C1_SCL/TIM4_CH1), R29.PAD_0 (PIN0)
I2C_SDA: IC3.43 (PB7/I2C1_SDA/TIM4_CH2), R28.PAD_0 (PIN0)
KEY: D55.2 (ANODE2), IC3.11 (PA1/USART2_RTS/ADC12_IN1/TIM2_CH2), R34.PAD_1 (PIN1)
LCD_D4: IC3.26 (PB13/SPI2_SCK/USART3_CTS/TIM1_CH1), R15.PAD_1 (PIN1)
LCD_D5: IC3.28 (PB15/SPI2_MOSI/TIM1_CH3N), R14.PAD_1 (PIN1)
LCD_D6: IC3.27 (PB14/SPI2_MISO/USART3_RTS/TIM1_CH2N), R13.PAD_1 (PIN1)
LCD_D7: IC3.39 (PB3/JTDO), R12.PAD_1 (PIN1)
LCD_E: IC3.25 (PB12/SPI2_NSS/I2C2_SMBAI/USART3_CK/TIM1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), R21.PAD_1 (PIN1)
LCD_R/~W: IC3.22 (PB11/I2C2_SDA/USART3_RX), R22.PAD_1 (PIN1)
LCD_RS: IC3.21 (PB10/I2C2_SCL/USART3_TX), R23.PAD_1 (PIN1)
unnamed: R1.PAD_1 (PIN1), X1.1
unnamed: D55.3 (CATHODE), K1.3 (2), K1.4 (2)
unnamed: R2.PAD_1 (PIN1), R3.PAD_0 (PIN0), T1.1 (GATE)
unnamed: J5.PAD_1 (PIN1), LCD1.3 (VO)
unnamed: R4.PAD_0 (PIN0), R11.PAD_1 (PIN1), T2.1 (GATE)
unnamed: IC3.34 (PA13/JTMS/SWDIO), J6.PAD_0 (PIN0)
unnamed: D2.CATHODE, R1.PAD_0 (PIN0), R2.PAD_0 (PIN0), T1.2 (SOURCE)
unnamed: C2.PAD_1 (PIN1), C3.PAD_1 (PIN1), IC11.2 (IN), R8.PAD_1 (PIN1), R24.PAD_0 (PIN0), T1.3 (DRAIN)
unnamed: J5.PAD_0 (PIN0), R20.2 (ADJ)
unnamed: LCD1.14 (DB7), R12.PAD_0 (PIN0)
unnamed: LCD1.13 (DB6), R13.PAD_0 (PIN0)
unnamed: LCD1.12 (DB5), R14.PAD_0 (PIN0)
unnamed: LCD1.11 (DB4), R15.PAD_0 (PIN0)
unnamed: R26.PAD_1 (PIN1), R29.PAD_1 (PIN1), X4.2
unnamed: LCD1.10 (DB3), R16.PAD_0 (PIN0)
unnamed: LCD1.9 (DB2), R17.PAD_0 (PIN0)
unnamed: LCD1.8 (DB1), R18.PAD_0 (PIN0)
unnamed: LCD1.7 (DB0), R19.PAD_0 (PIN0)
unnamed: LED1.ANODE, R33.PAD_1 (PIN1)
unnamed: R27.PAD_1 (PIN1), R28.PAD_1 (PIN1), X4.3
unnamed: LCD1.4 (RS), R23.PAD_0 (PIN0)
unnamed: LCD1.5 (R/~W), R22.PAD_0 (PIN0)
unnamed: LCD1.6 (E), R21.PAD_0 (PIN0)
unnamed: J7.PAD_1 (PIN1), R6.PAD_0 (PIN0)
unnamed: IC11.7 (EN), R8.PAD_0 (PIN0)
unnamed: D55.1 (ANODE1), R3.PAD_1 (PIN1), T2.3 (DRAIN)
unnamed: C4.PAD_0 (PIN0), IC11.3 (SW), L1.1 (START)
unnamed: C4.PAD_1 (PIN1), IC11.1 (BS)
unnamed: C5.PAD_1 (PIN1), C7.PAD_1 (PIN1), J7.PAD_0 (PIN0), L1.2 (END), L2.PAD_0 (END)
unnamed: C15.PAD_1 (PIN1), IC11.8 (SS)
unnamed: C16.PAD_1 (PIN1), IC11.6 (COMP)
unnamed: C16.PAD_0 (PIN0), R5.PAD_0 (PIN0)
unnamed: IC11.5 (FB), R6.PAD_1 (PIN1), R7.PAD_0 (PIN0)
NRST: C14.PAD_1 (PIN1), IC3.7 (NRST), R30.PAD_1 (PIN1)
PWR_HOLD: IC3.15 (PA5/SPI1_SCK/ADC12_IN5), R11.PAD_0 (PIN0)
SWDCLK: IC3.37 (PA14/JTCK/SWCLK), X3.3
SWDIO: J6.PAD_1 (PIN1), X3.2

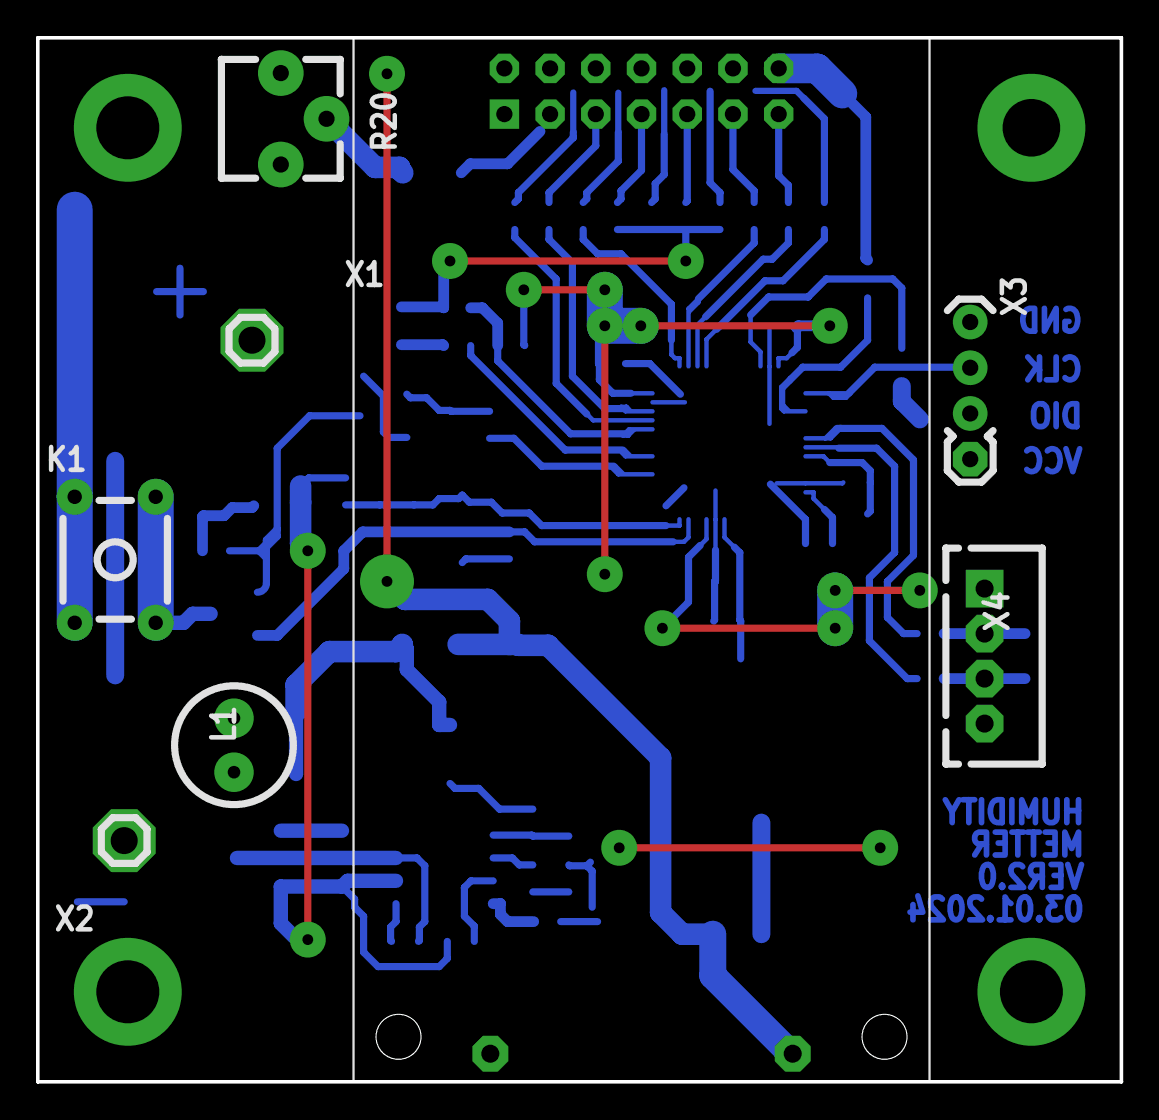
[picture p39: board HumidityMetter_v2.brd from above]

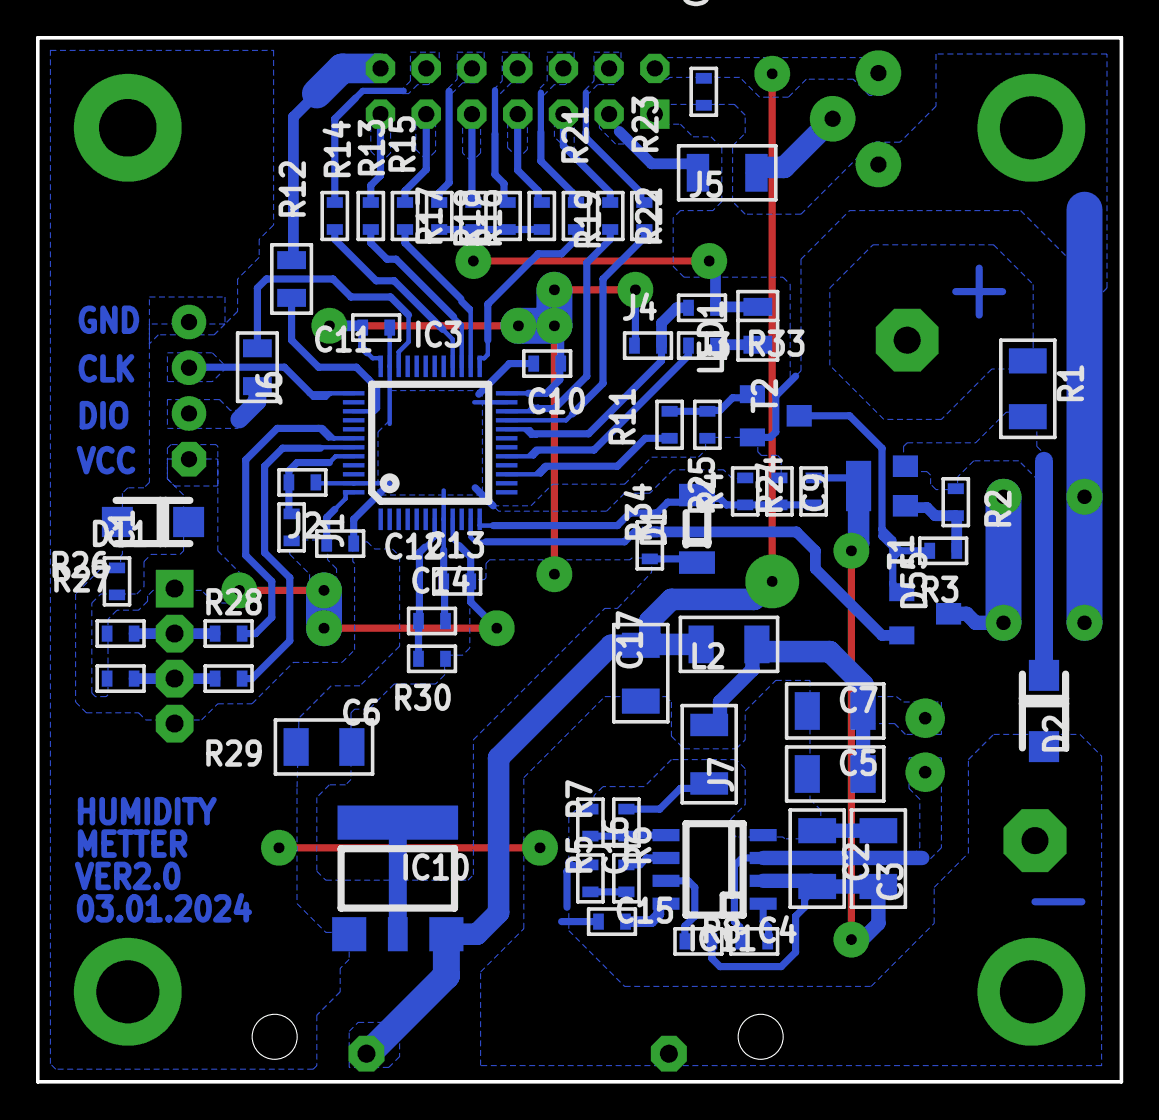
[picture p40: board HumidityMetter_v2.brd from below]

Board: 2 copper layers, 60.2 x 58.0 mm, 72 parts (64 on the bottom side), 54 nets.
