InspectorColombo/ColomboProjects/HumidityMetter/schematic/HM_SENSOR_HOLDER.brd

## EAGLE design HumidityMetter/schematic/HM_SENSOR_HOLDER.brd (2025-01-11)

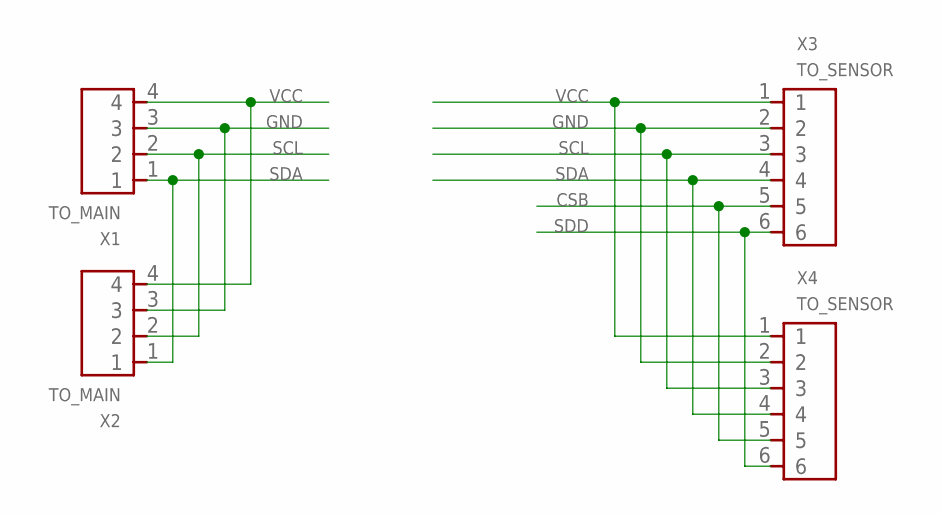
[picture p41: schematic HM_SENSOR_HOLDER.sch]

Parts:
X1: TO_MAIN; PIN4X1_2.54MM
X2: TO_MAIN; PIN4X1_2.54MM_SIDE_BOARD
X3: TO_SENSOR; PIN6X1_2.54MM
X4: TO_SENSOR; PIN6X1_2.54MM_SIDE_BOARD

Connections:
CSB: X3.5, X4.5
GND: X1.3, X2.3, X3.2, X4.2
SCL: X1.2, X2.2, X3.3, X4.3
SDA: X1.1, X2.1, X3.4, X4.4
SDD: X3.6, X4.6
VCC: X1.4, X2.4, X3.1, X4.1

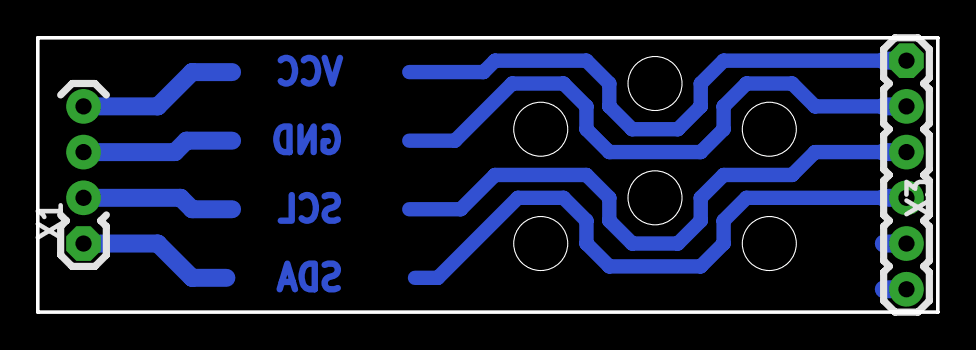
[picture p42: board HM_SENSOR_HOLDER.brd from above]

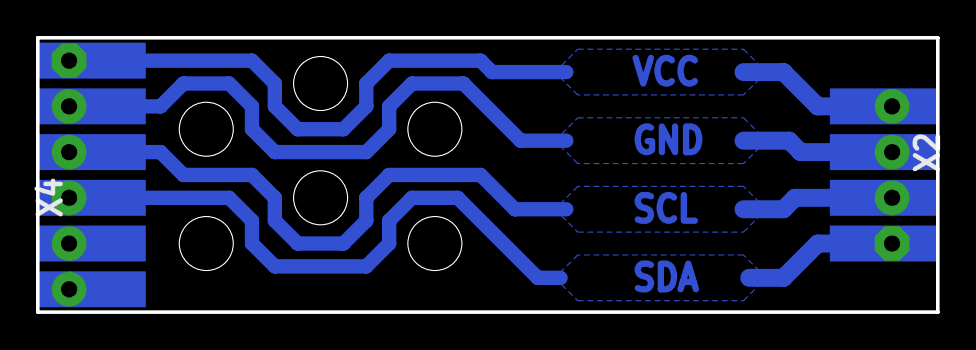
[picture p43: board HM_SENSOR_HOLDER.brd from below]

Board: 2 copper layers, 50.0 x 15.2 mm, 4 parts (2 on the bottom side), 6 nets.
