InspectorColombo/ColomboProjects/HumidityMetter/schematic/HumidityMetter.brd

## EAGLE design HumidityMetter/schematic/HumidityMetter.brd (2024-08-25, an earlier design)

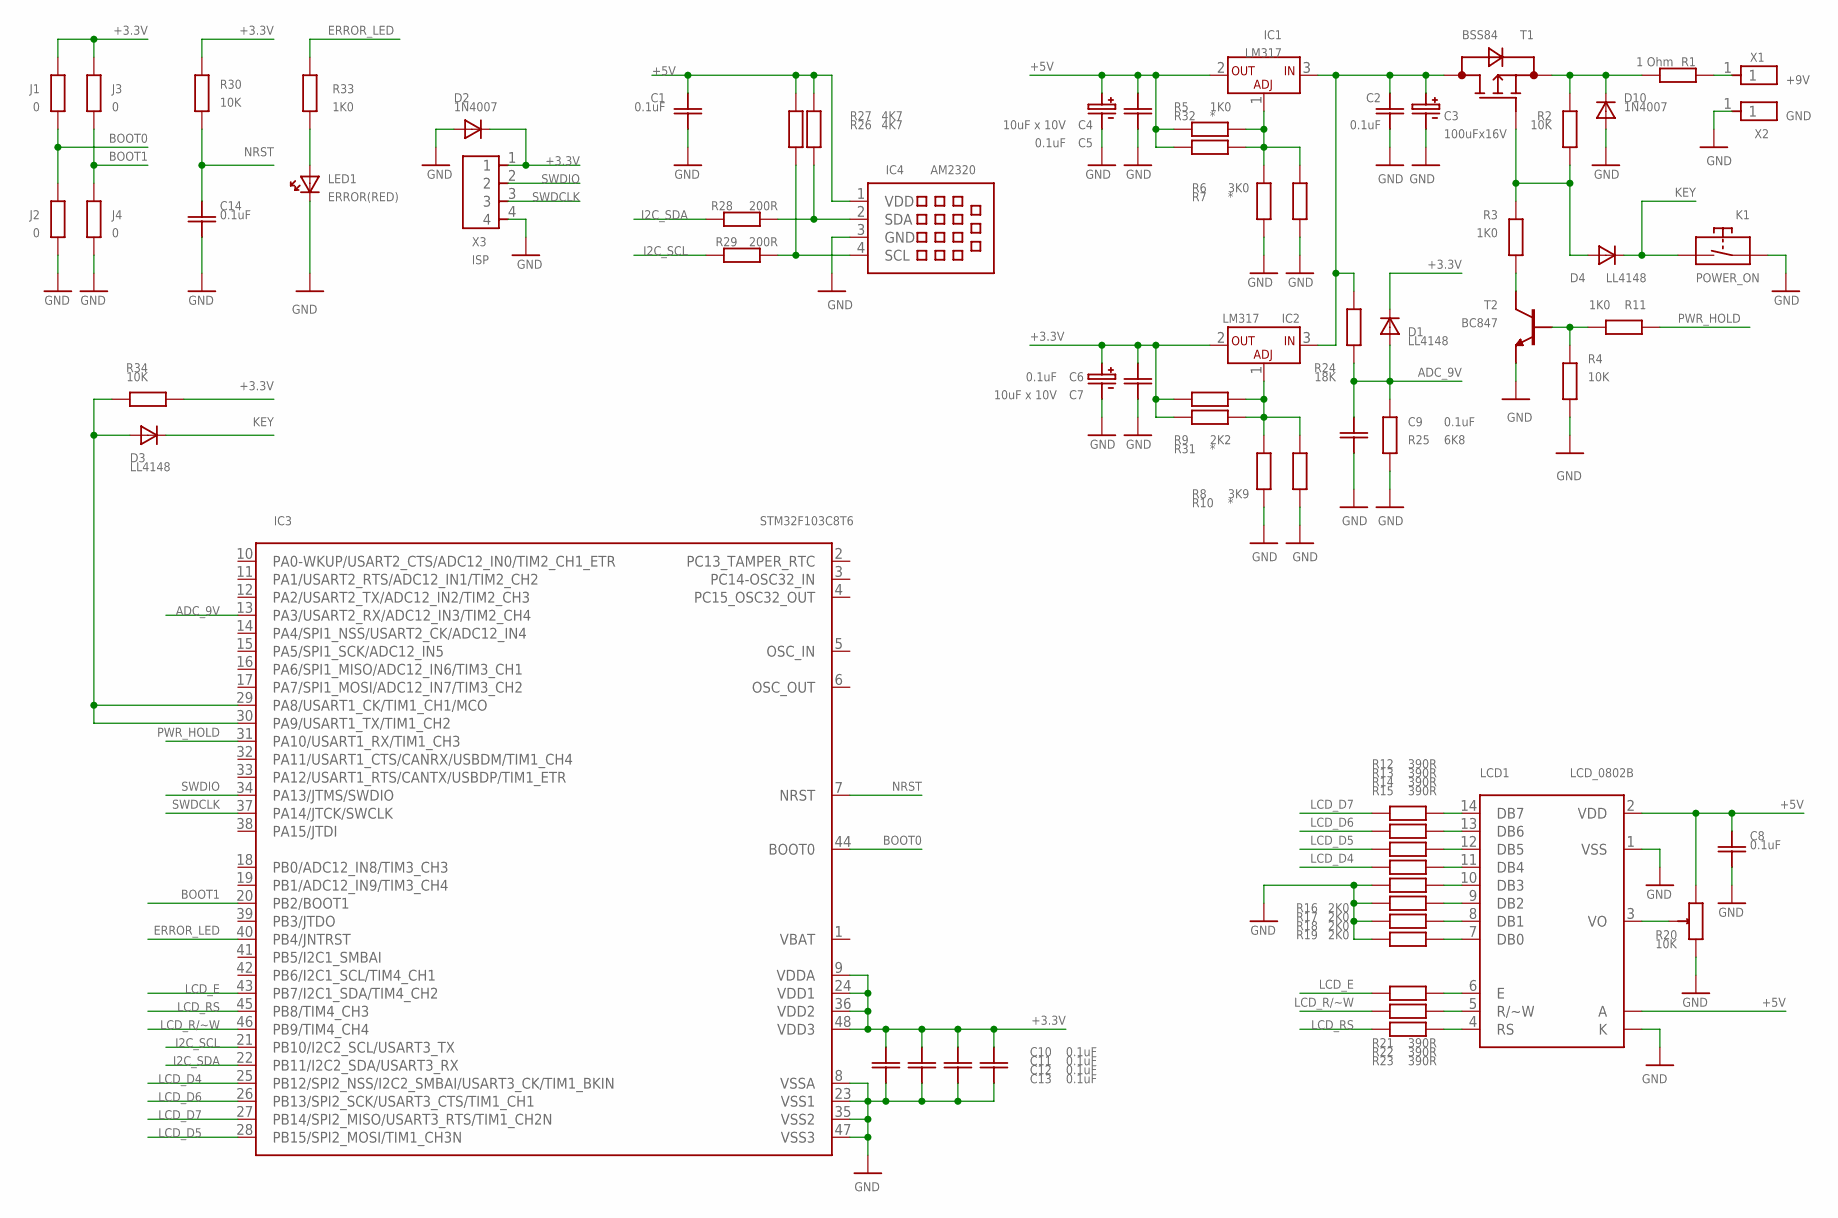
[picture p44: schematic HumidityMetter.sch]

Parts:
C1, C2, C5, C6, C8, C9, C10, C11, C12, C13, C14: 0.1uF; RSMD_0805
C3: 100uFx16V; CE_6.3MM
C4, C7: 10uF x 10V; CE_5.2MM
D1, D3, D4: LL4148; SOD-80
D2, D10: 1N4007; DO-41_10MM
IC1, IC2: LM317; D2PAK
IC3: STM32F103C8T6; LQFP48
IC4: AM2320; AM2320_HOR
J1, J2, J3, J4: 0; RSMD_0805
K1: POWER_ON; KEY_7X4.5
LCD1: LCD_0802B; LCD_0802B(CHINA_CLONE)
LED1: ERROR(RED); LED_0805
R1: 1 Ohm; R0207
R2, R4, R30, R34: 10K; RSMD_0805
R3, R5, R33: 1K0; RSMD_0805
R6: 3K0; RSMD_0805
R7, R10, R31, R32: *; RSMD_0805
R8: 3K9; RSMD_0805
R9: 2K2; RSMD_0805
R11: 1K0; RSMD_1206_BIG_GAP
R12, R13, R14, R15, R21, R22, R23: 390R; RSMD_0805
R16, R17, R18, R19: 2K0; RSMD_0805
R20: 10K; R_ADJ_STAND
R24: 18K; RSMD_1206_BIG_GAP
R25: 6K8; RSMD_0805
R26, R27: 4K7; R0207
R28, R29: 200R; R0207
T1: BSS84; SOT23
T2: BC847; SOT23_SMALL_PADS
X1: +9V; PIN1X1_D3.5MM
X2: GND; PIN1X1_D3.5MM
X3: ISP; PIN4X1_2.54MM

Connections:
+3.3V: C6.PAD_1 (PIN1), C7.PLUS, C10.PAD_1 (PIN1), C11.PAD_1 (PIN1), C12.PAD_1 (PIN1), C13.PAD_1 (PIN1), D1.CATHODE, D2.CATHODE, IC2.2 (OUT), IC3.9 (VDDA), IC3.24 (VDD1), IC3.36 (VDD2), IC3.48 (VDD3), J1.PAD_0 (PIN0), J3.PAD_0 (PIN0), R9.PAD_1 (PIN1), R30.PAD_0 (PIN0), R31.PAD_1 (PIN1), R34.PAD_1 (PIN1), X3.1
+5V: C1.PAD_1 (PIN1), C4.PLUS, C5.PAD_1 (PIN1), C8.PAD_1 (PIN1), IC1.2 (OUT), IC4.1 (VDD), LCD1.2 (VDD), LCD1.A, R5.PAD_1 (PIN1), R20.3 (END_B), R26.PAD_0 (PIN0), R27.PAD_0 (PIN0), R32.PAD_1 (PIN1)
ADC_9V: C9.PAD_1 (PIN1), D1.ANODE, IC3.13 (PA3/USART2_RX/ADC12_IN3/TIM2_CH4), R24.PAD_1 (PIN1), R25.PAD_0 (PIN0)
BOOT0: IC3.44 (BOOT0), J1.PAD_1 (PIN1), J2.PAD_0 (PIN0)
BOOT1: IC3.20 (PB2/BOOT1), J3.PAD_1 (PIN1), J4.PAD_0 (PIN0)
ERROR_LED: IC3.40 (PB4/JNTRST), R33.PAD_0 (PIN0)
GND: C1.PAD_0 (PIN0), C2.PAD_0 (PIN0), C3.MINUS, C4.MINUS, C5.PAD_0 (PIN0), C6.PAD_0 (PIN0), C7.MINUS, C8.PAD_0 (PIN0), C9.PAD_0 (PIN0), C10.PAD_0 (PIN0), C11.PAD_0 (PIN0), C12.PAD_0 (PIN0), C13.PAD_0 (PIN0), C14.PAD_0 (PIN0), D2.ANODE, D10.ANODE, IC3.8 (VSSA), IC3.23 (VSS1), IC3.35 (VSS2), IC3.47 (VSS3), IC4.3 (GND), J2.PAD_1 (PIN1), J4.PAD_1 (PIN1), K1.1, K1.2 (1), LCD1.1 (VSS), LCD1.K, LED1.CATHODE, R4.PAD_1 (PIN1), R6.PAD_1 (PIN1), R7.PAD_1 (PIN1), R8.PAD_1 (PIN1), R10.PAD_1 (PIN1), R16.PAD_1 (PIN1), R17.PAD_1 (PIN1), R18.PAD_1 (PIN1), R19.PAD_1 (PIN1), R20.1 (END_A), R25.PAD_1 (PIN1), T2.2 (E), X2.1, X3.4
I2C_SCL: IC3.21 (PB10/I2C2_SCL/USART3_TX), R29.PAD_0 (PIN0)
I2C_SDA: IC3.22 (PB11/I2C2_SDA/USART3_RX), R28.PAD_0 (PIN0)
KEY: D3.CATHODE, D4.CATHODE, K1.3 (2), K1.4 (2)
LCD_D4: IC3.25 (PB12/SPI2_NSS/I2C2_SMBAI/USART3_CK/TIM1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), R15.PAD_1 (PIN1)
LCD_D5: IC3.28 (PB15/SPI2_MOSI/TIM1_CH3N), R14.PAD_1 (PIN1)
LCD_D6: IC3.26 (PB13/SPI2_SCK/USART3_CTS/TIM1_CH1), R13.PAD_1 (PIN1)
LCD_D7: IC3.27 (PB14/SPI2_MISO/USART3_RTS/TIM1_CH2N), R12.PAD_1 (PIN1)
LCD_E: IC3.43 (PB7/I2C1_SDA/TIM4_CH2), R21.PAD_1 (PIN1)
LCD_R/~W: IC3.46 (PB9/TIM4_CH4), R22.PAD_1 (PIN1)
LCD_RS: IC3.45 (PB8/TIM4_CH3), R23.PAD_1 (PIN1)
unnamed: R1.PAD1 (PIN1), X1.1
unnamed: D10.CATHODE, R1.PAD_0 (PIN0), R2.PAD_0 (PIN0), T1.2 (SOURCE)
unnamed: D4.ANODE, R2.PAD_1 (PIN1), R3.PAD_0 (PIN0), T1.1 (GATE)
unnamed: R3.PAD_1 (PIN1), T2.3 (C)
unnamed: R4.PAD_0 (PIN0), R11.PAD_1 (PIN1), T2.1 (B)
unnamed: C2.PAD_1 (PIN1), C3.PLUS, IC1.3 (IN), IC2.3 (IN), R24.PAD_0 (PIN0), T1.3 (DRAIN)
unnamed: IC1.1 (ADJ), R5.PAD_0 (PIN0), R6.PAD_0 (PIN0), R7.PAD_0 (PIN0), R32.PAD_0 (PIN0)
unnamed: IC2.1 (ADJ), R8.PAD_0 (PIN0), R9.PAD_0 (PIN0), R10.PAD_0 (PIN0), R31.PAD_0 (PIN0)
unnamed: LCD1.3 (VO), R20.2 (ADJ)
unnamed: LCD1.14 (DB7), R12.PAD_0 (PIN0)
unnamed: LCD1.13 (DB6), R13.PAD_0 (PIN0)
unnamed: LCD1.12 (DB5), R14.PAD_0 (PIN0)
unnamed: LCD1.11 (DB4), R15.PAD_0 (PIN0)
unnamed: IC4.2 (SDA), R26.PAD1 (PIN1), R28.PAD1 (PIN1)
unnamed: LCD1.10 (DB3), R16.PAD_0 (PIN0)
unnamed: LCD1.9 (DB2), R17.PAD_0 (PIN0)
unnamed: LCD1.8 (DB1), R18.PAD_0 (PIN0)
unnamed: LCD1.7 (DB0), R19.PAD_0 (PIN0)
unnamed: LED1.ANODE, R33.PAD_1 (PIN1)
unnamed: IC4.4 (SCL), R27.PAD1 (PIN1), R29.PAD1 (PIN1)
unnamed: LCD1.4 (RS), R23.PAD_0 (PIN0)
unnamed: LCD1.5 (R/~W), R22.PAD_0 (PIN0)
unnamed: LCD1.6 (E), R21.PAD_0 (PIN0)
unnamed: D3.ANODE, IC3.29 (PA8/USART1_CK/TIM1_CH1/MCO), IC3.30 (PA9/USART1_TX/TIM1_CH2), R34.PAD_0 (PIN0)
NRST: C14.PAD_1 (PIN1), IC3.7 (NRST), R30.PAD_1 (PIN1)
PWR_HOLD: IC3.31 (PA10/USART1_RX/TIM1_CH3), R11.PAD_0 (PIN0)
SWDCLK: IC3.37 (PA14/JTCK/SWCLK), X3.3
SWDIO: IC3.34 (PA13/JTMS/SWDIO), X3.2
