InspectorColombo/ColomboProjects/HumidityMetter/schematic/HumidityMetter.brd

## EAGLE design HumidityMetter/schematic/HumidityMetter.brd (continued)

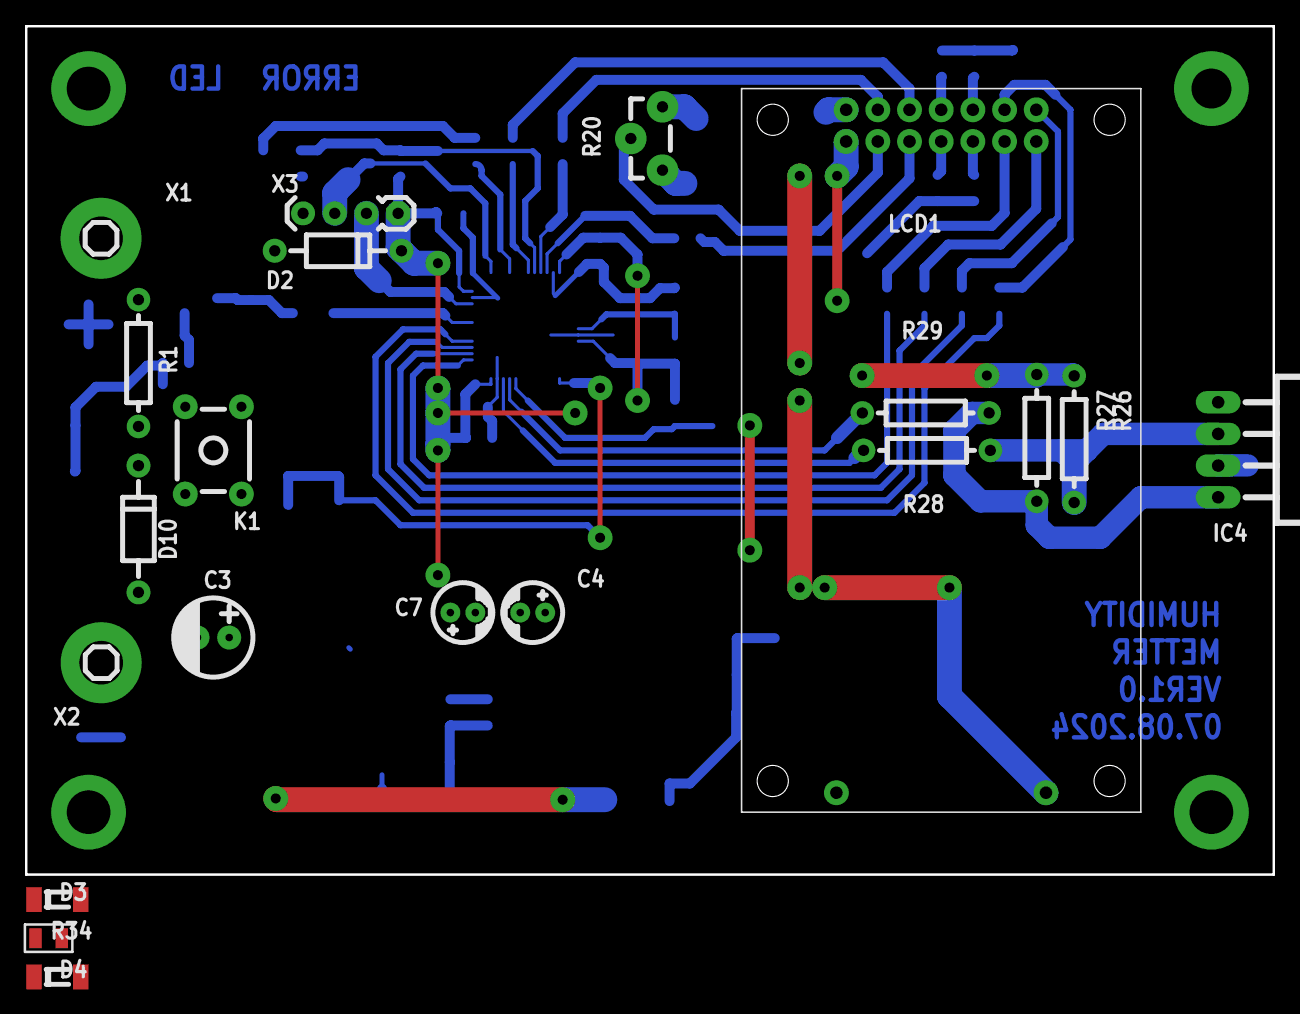
[picture p45: board HumidityMetter.brd from above]

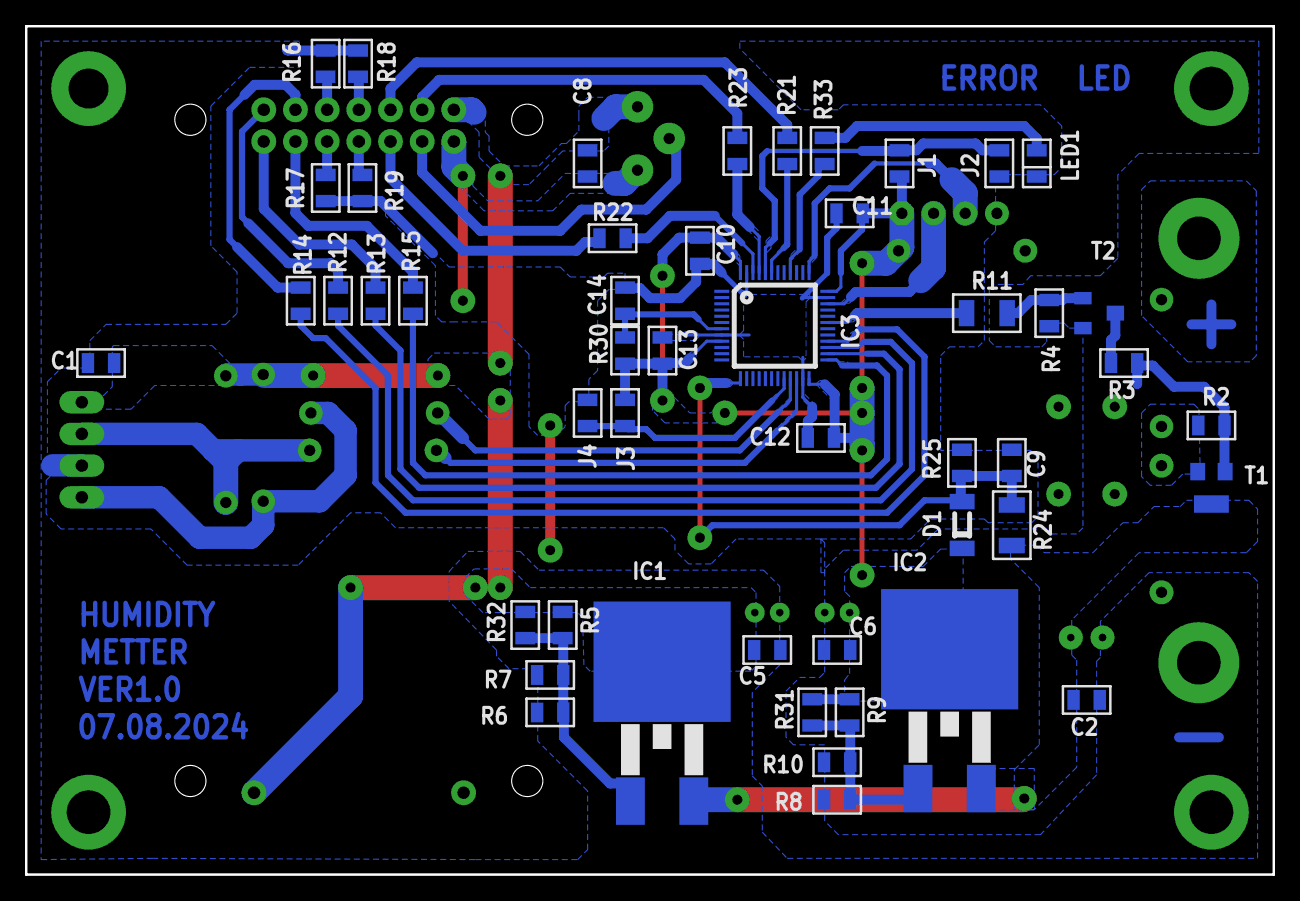
[picture p46: board HumidityMetter.brd from below]

Board: 2 copper layers, 100.0 x 68.0 mm, 69 parts (49 on the bottom side), 45 nets.
