InspectorColombo/ColomboProjects/12_to_200V_inverter/schematic/12to220inverterVer3.brd

## EAGLE design 12_to_200V_inverter/schematic/12to220inverterVer3.brd (2024-05-27)

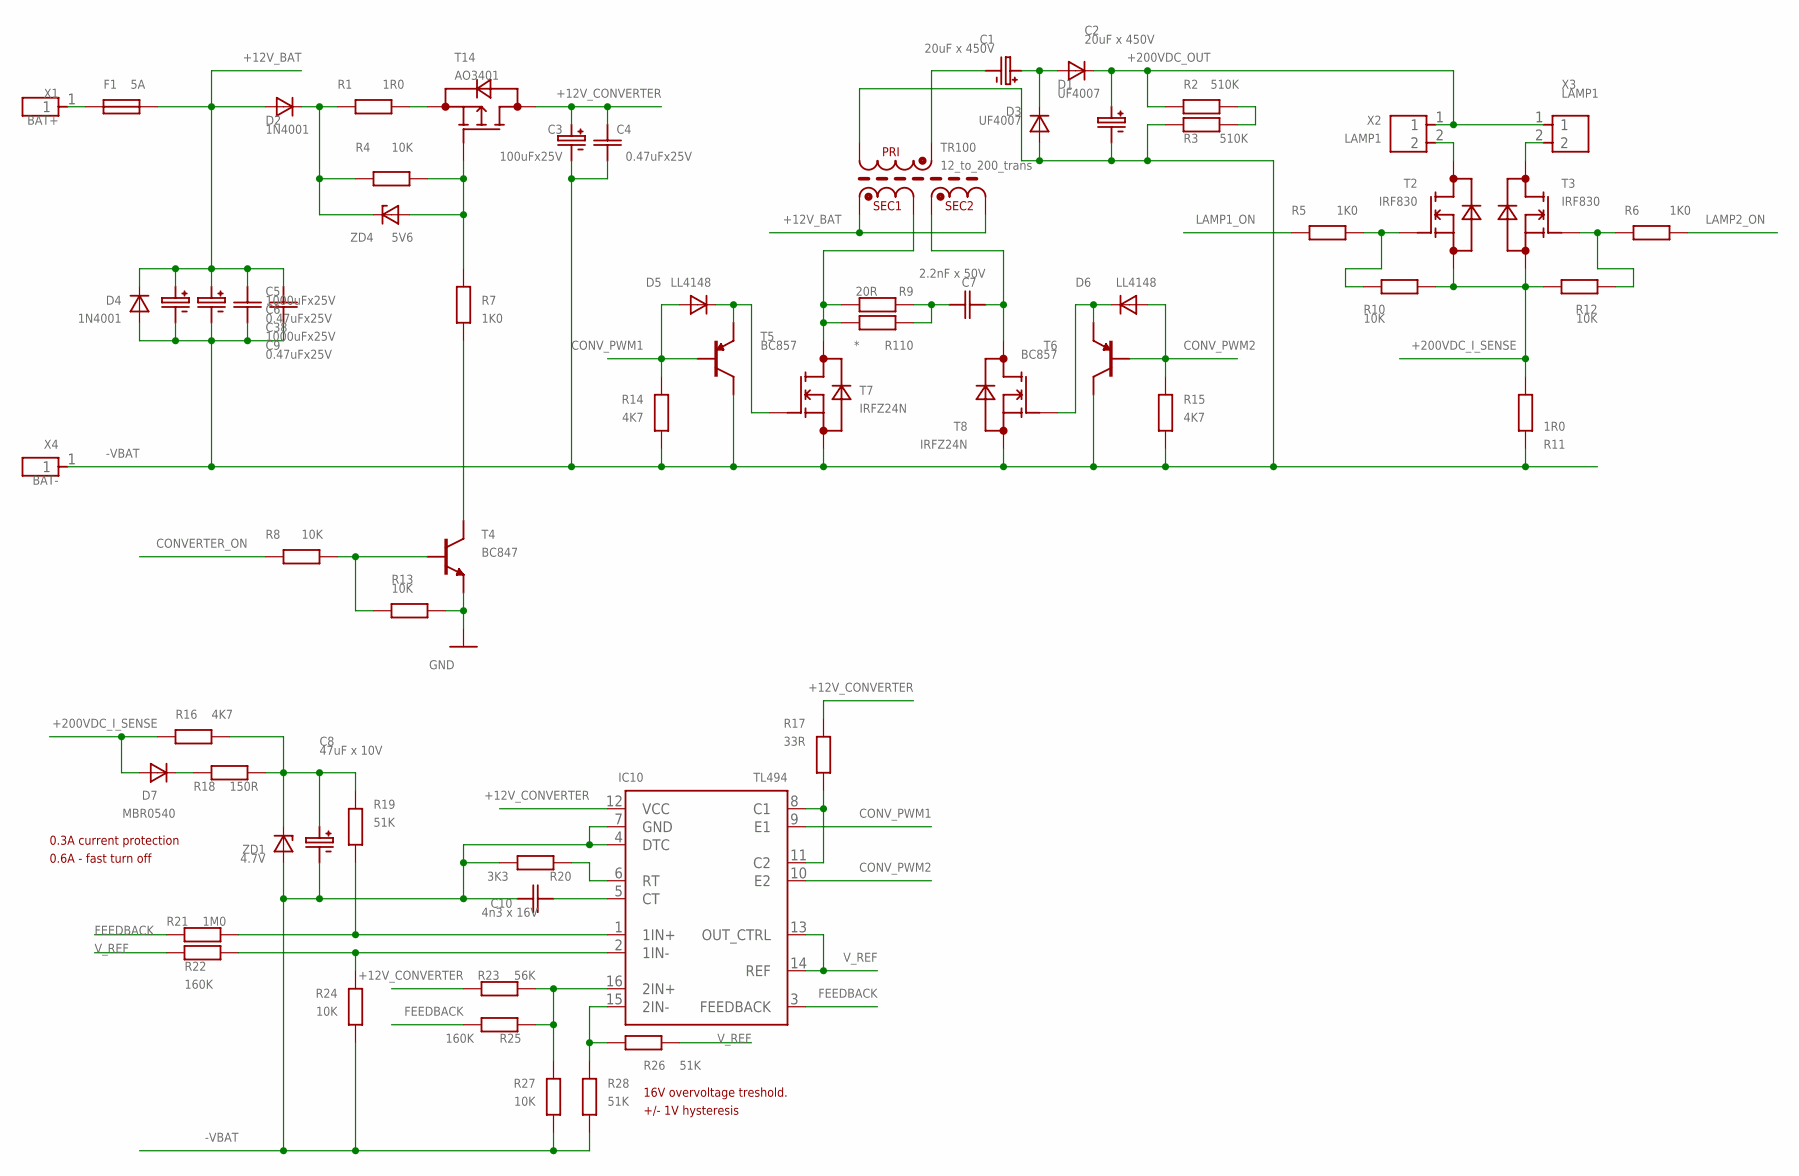
[picture p47: schematic 12to220inverterVer3.sch, sheet 1]

Parts:
C1, C2: 20uF x 450V; CE_13MM
C3: 100uFx25V; CE_6.3MM
C4: 0.47uFx25V; RSMD_0805
C5, C38: 1000uFx25V; CE_10MM
C6, C9: 0.47uFx25V; RSMD_1206
C7: 2.2nF x 50V; RSMD_1206
C8: 47uF x 10V; CE_5.2MM
C10: 4n3 x 16V; RSMD_0805
D1, D3: UF4007; DO-41_10MM
D2, D4: 1N4001; DO-41_10MM
D5, D6: LL4148; SOD-80
D7: MBR0540; SOD-80
F1: 5A; AUTO_FUSE_SMALL
IC10: TL494; SOIC16
R1: 1R0; RSMD_1206
R2, R3: 510K; RSMD_1206
R4, R8, R10, R12, R13, R24, R27: 10K; RSMD_0805
R5, R6, R7: 1K0; RSMD_0805
R9: 20R; RSMD_1206
R11: 1R0; R_1.0W
R14, R15, R16: 4K7; RSMD_0805
R17: 33R; RSMD_0805
R18: 150R; RSMD_0805
R19, R26, R28: 51K; RSMD_0805
R20: 3K3; RSMD_0805
R21: 1M0; RSMD_0805
R22, R25: 160K; RSMD_0805
R23: 56K; RSMD_0805
R110: *; RSMD_1206
T2, T3: IRF830; TO-220(VER2)_BIG_PADS
T4: BC847; SOT23_SMALL_PADS
T5, T6: BC857; SOT23_SMALL_PADS
T7, T8: IRFZ24N; TO-220(VER2)_BIG_PADS
T14: AO3401; SOT23_SMALL_PADS
TR100: 12_to_200_trans; ETD29_HOR
X1: BAT+; PIN1X1_D3.5MM
X2, X3: LAMP1; BRD_CONNECTOR_12X10.2
X4: BAT-; PIN1X1_D3.5MM
ZD1: 4.7V; SOD-80
ZD4: 5V6; SOD-80

Connections:
+12V_BAT: C5.PLUS, C6.PAD_1 (PIN1), C9.PAD_1 (PIN1), C38.PLUS, D2.ANODE, D4.CATHODE, F1.PAD_0 (PIN0), TR100.8 (SEC1_START), TR100.14 (SEC2_END); also elsewhere on the board
+12V_CONVERTER: C3.PLUS, C4.PAD_1 (PIN1), IC10.12 (VCC), R17.PAD_1 (PIN1), R23.PAD_1 (PIN1), T14.3 (DRAIN)
+200VDC_I_SENSE: D7.ANODE, R10.PAD_1 (PIN1), R11.PAD_0 (PIN0), R12.PAD_1 (PIN1), R16.PAD_1 (PIN1), T2.3 (SOURCE), T3.3 (SOURCE)
+200VDC_OUT: C2.PLUS, D1.CATHODE, R2.PAD_1 (PIN1), X2.1, X3.1
-VBAT: C2.MINUS, C3.MINUS, C4.PAD_0 (PIN0), C5.MINUS, C6.PAD_0 (PIN0), C8.MINUS, C9.PAD_0 (PIN0), C10.PAD_1 (PIN1), C38.MINUS, D3.ANODE, D4.ANODE, IC10.4 (DTC), IC10.7 (GND), R3.PAD_0 (PIN0), R11.PAD1 (PIN1), R14.PAD_0 (PIN0), R15.PAD_0 (PIN0), R20.PAD_0 (PIN0), R24.PAD_1 (PIN1), R27.PAD_1 (PIN1), R28.PAD_1 (PIN1), T5.3 (C), T6.3 (C), T7.3 (SOURCE), T8.3 (SOURCE), TR100.7 (PRI_END), X4.1, ZD1.ANODE; also elsewhere on the board
CONVERTER_ON: R8.PAD_1 (PIN1); also elsewhere on the board
CONV_PWM1: D5.ANODE, IC10.9 (E1), R14.PAD_1 (PIN1), T5.1 (B)
CONV_PWM2: D6.ANODE, IC10.10 (E2), R15.PAD_1 (PIN1), T6.1 (B)
FEEDBACK: IC10.3 (FEEDBACK), R21.PAD_1 (PIN1), R25.PAD_1 (PIN1)
GND: R13.PAD_0 (PIN0), T4.2 (E); also elsewhere on the board
LAMP1_ON: R5.PAD_1 (PIN1); also elsewhere on the board
LAMP2_ON: R6.PAD_0 (PIN0); also elsewhere on the board
unnamed: R2.PAD_0 (PIN0), R3.PAD_1 (PIN1)
unnamed: C10.PAD_0 (PIN0), IC10.5 (CT)
unnamed: IC10.6 (RT), R20.PAD_1 (PIN1)
unnamed: IC10.8 (C1), IC10.11 (C2), R17.PAD_0 (PIN0)
unnamed: IC10.2 (1IN-), R22.PAD_0 (PIN0), R24.PAD_0 (PIN0)
unnamed: IC10.1 (1IN+), R19.PAD_1 (PIN1), R21.PAD_0 (PIN0)
unnamed: C8.PLUS, R16.PAD_0 (PIN0), R18.PAD_0 (PIN0), R19.PAD_0 (PIN0), ZD1.CATHODE
unnamed: C1.MINUS, TR100.1 (PRI_START)
unnamed: D2.CATHODE, R1.PAD_1 (PIN1), R4.PAD_1 (PIN1), ZD4.CATHODE
unnamed: C1.PLUS, D1.ANODE, D3.CATHODE
unnamed: D7.CATHODE, R18.PAD_1 (PIN1)
unnamed: IC10.16 (2IN+), R23.PAD_0 (PIN0), R25.PAD_0 (PIN0), R27.PAD_0 (PIN0)
unnamed: R4.PAD_0 (PIN0), R7.PAD_1 (PIN1), T14.1 (GATE), ZD4.ANODE
unnamed: R8.PAD_0 (PIN0), R13.PAD_1 (PIN1), T4.1 (B)
unnamed: R7.PAD_0 (PIN0), T4.3 (C)
unnamed: IC10.15 (2IN-), R26.PAD_0 (PIN0), R28.PAD_0 (PIN0)
unnamed: D5.CATHODE, T5.2 (E), T7.1 (GATE)
unnamed: D6.CATHODE, T6.2 (E), T8.1 (GATE)
unnamed: R9.PAD_0 (PIN0), R110.PAD_0 (PIN0), T7.2 (DRAIN), TR100.10 (SEC1_END)
unnamed: C7.PAD_1 (PIN1), T8.2 (DRAIN), TR100.12 (SEC2_START)
unnamed: C7.PAD_0 (PIN0), R9.PAD_1 (PIN1), R110.PAD_1 (PIN1)
unnamed: F1.PAD_1 (PIN1), X1.1
unnamed: R5.PAD_0 (PIN0), R10.PAD_0 (PIN0), T2.1 (GATE)
unnamed: T2.2 (DRAIN), X2.2
unnamed: T3.2 (DRAIN), X3.2
unnamed: R6.PAD_1 (PIN1), R12.PAD_0 (PIN0), T3.1 (GATE)
unnamed: R1.PAD_0 (PIN0), T14.2 (SOURCE)
V_REF: IC10.13 (OUT_CTRL), IC10.14 (REF), R22.PAD_1 (PIN1), R26.PAD_1 (PIN1)

Notes on the sheet:
0.3A current protection
16V overvoltage treshold.
+/- 1V hysteresis
0.6A - fast turn off

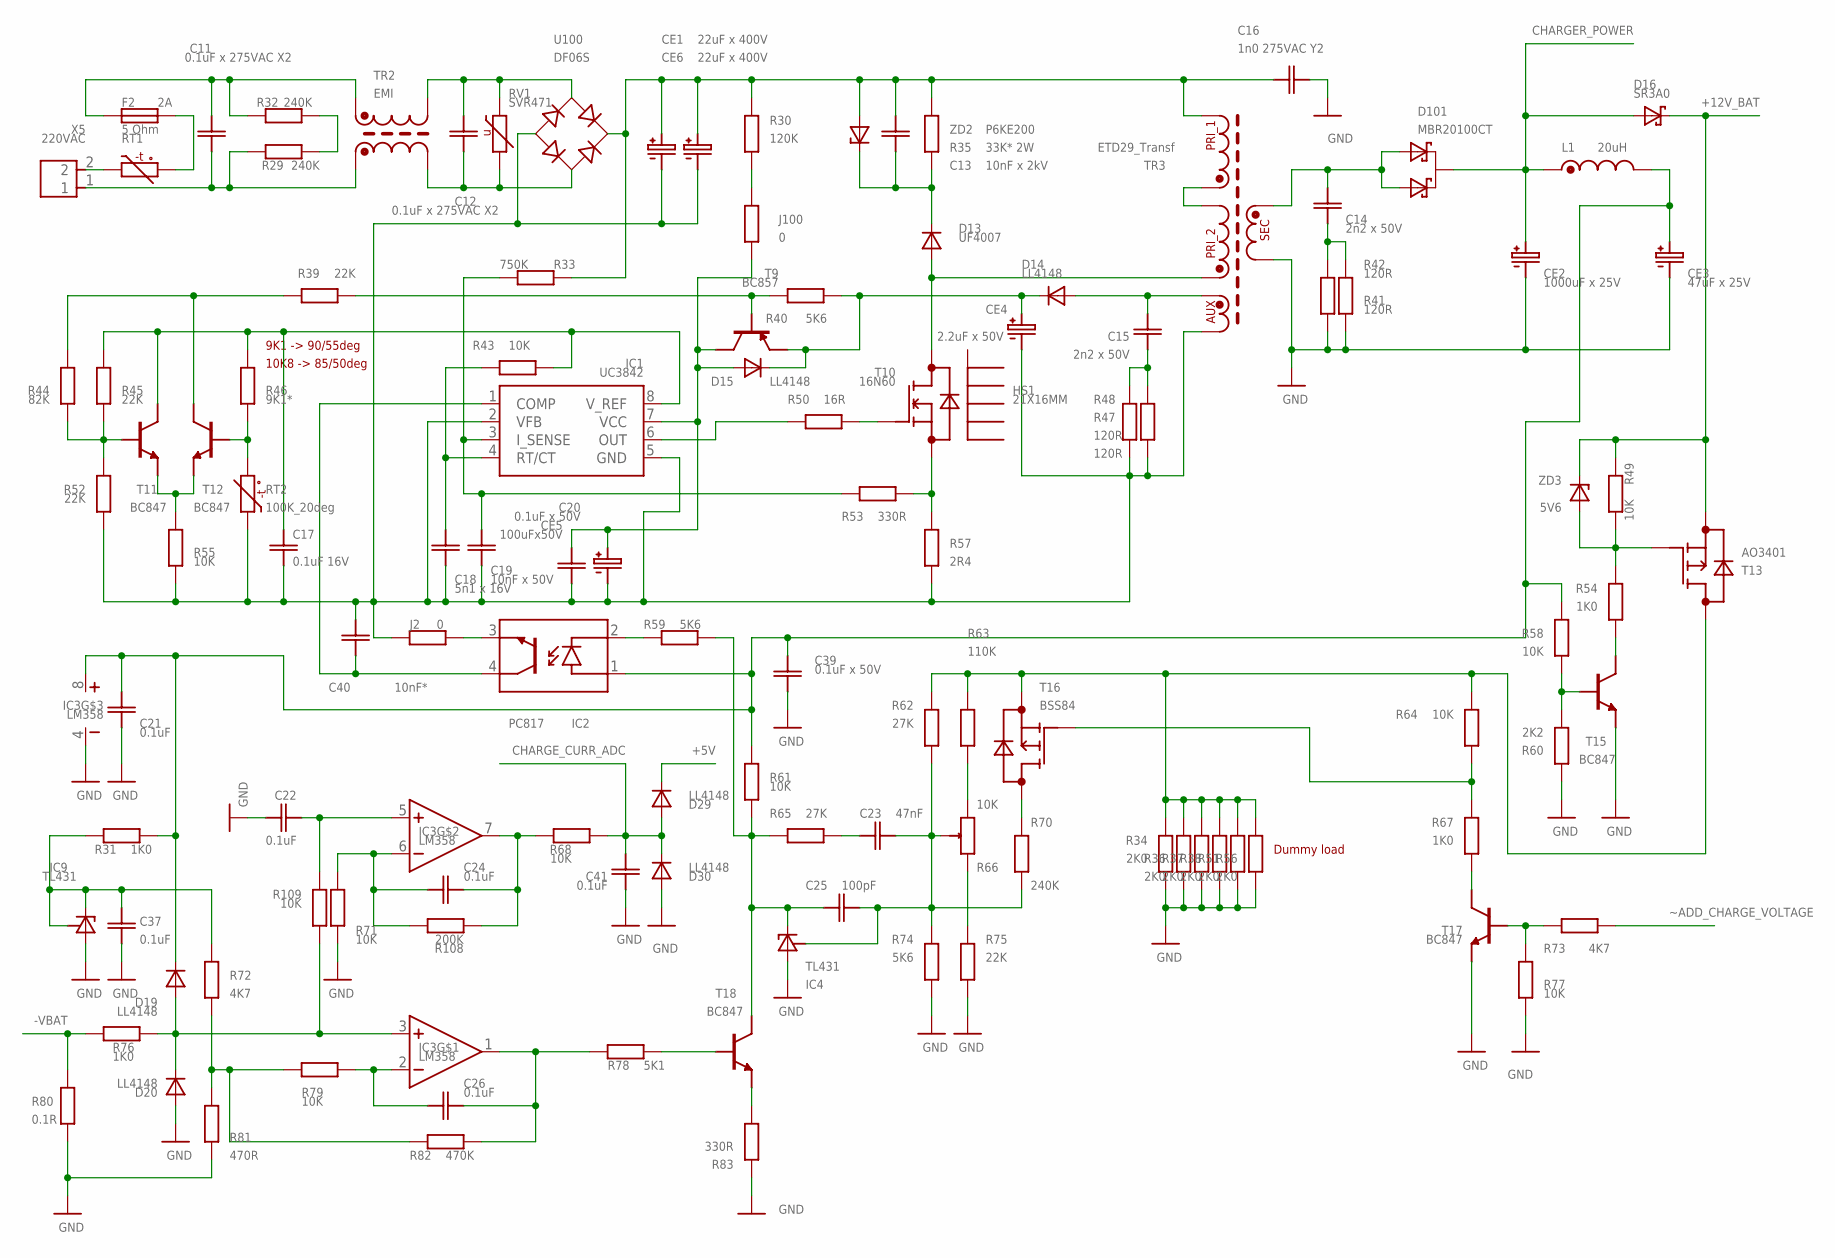
[picture p48: schematic 12to220inverterVer3.sch, sheet 2]

Parts:
C11, C12: 0.1uF x 275VAC X2; MKP_18X6
C13: 10nF x 2kV; CAP_CER_11X4
C14, C15: 2n2 x 50V; RSMD_0805
C16: 1n0 275VAC Y2; MKP_13.4X4
C17: 0.1uF 16V; RSMD_0805
C18: 5n1 x 16V; RSMD_0805
C19: 10nF x 50V; RSMD_0805
C20, C39: 0.1uF x 50V; RSMD_0805
C21, C22, C24, C26, C37, C41: 0.1uF; RSMD_0805
C23: 47nF; RSMD_0805
C25: 100pF; RSMD_0805
C40: 10nF*; RSMD_0805
CE1, CE6: 22uF x 400V; CE_13MM
CE2: 1000uF x 25V; CE_10MM
CE3: 47uF x 25V; CE_6.3MM
CE4: 2.2uF x 50V; CE_5.2MM
CE5: 100uFx50V; CE_6.3MM
D13: UF4007; DO-41_10MM
D14, D15, D19, D20, D29, D30: LL4148; SOD-80
D16: SR3A0; DO-27_15MM
D101: MBR20100CT; TO-220(VER2)_BIG_PADS
F2: 2A; FUSE_20X5MM_VERT_WIRE
HS1: 21X16MM; HEATSINK_21X16
IC1: UC3842; SOIC8
IC2: PC817; DIP4
IC3: LM358; SOIC8
IC4: TL431; TO-92A
IC9: TL431; SOT23
J2: 0; RSMD_1206_BIG_GAP
J100: 0; RSMD_1206
L1: 20uH; COIL_7MM
R29, R32, R70: 240K; RSMD_0805
R30: 120K; R_1.0W
R31, R54, R67, R76: 1K0; RSMD_0805
R33: 750K; R0207
R34, R36, R37, R38, R51, R56: 2K0; RSMD_1206
R35: 33K* 2W; R_1.0W_VERTICAL
R39, R45, R52, R75: 22K; RSMD_0805
R40, R59, R74: 5K6; RSMD_0805
R41, R42, R47, R48: 120R; RSMD_0805
R43, R49, R55, R58, R61, R64, R71, R77, R79, R109: 10K; RSMD_0805
R44: 82K; RSMD_0805
R46: 9K1*; RSMD_0805
R50: 16R; RSMD_0805
R53, R83: 330R; RSMD_0805
R57: 2R4; RSMD_1206
R60: 2K2; RSMD_0805
R62, R65: 27K; RSMD_0805
R63: 110K; RSMD_0805
R66: 10K; R_ADJ_STAND
R68: 10K; RSMD_1206_BIG_GAP
R72: 4K7; RSMD_1206_BIG_GAP
R73: 4K7; R0207
R78: 5K1; RSMD_1206_BIG_GAP
R80: 0.1R; R_1.0W
R81: 470R; RSMD_0805
R82: 470K; RSMD_0805
R108: 200K; RSMD_0805
RT1: 5 Ohm; NTC_9.0X4.2
RT2: 100K_20deg; NTC_5.5X3
RV1: SVR471; SVR_11.2X4
T9: BC857; SOT23_SMALL_PADS
T10: 16N60; TO-220(VER2)_BIG_PADS
T11, T12, T15, T17, T18: BC847; SOT23_SMALL_PADS
T13: AO3401; SOT23_SMALL_PADS
T16: BSS84; SOT23_SMALL_PADS
TR2: EMI; EMI_CM_21X17
TR3: ETD29_Transf; ETD29_HOR
U100: DF06S; DFS
X5: 220VAC; BRD_CONNECTOR_12X10.2
ZD2: P6KE200; DO-41_10MM
ZD3: 5V6; SOD-80

Connections:
+5V: D29.CATHODE; also elsewhere on the board
+12V_BAT: D16.CATHODE, R49.PAD_0 (PIN0), T13.2 (SOURCE), ZD3.CATHODE; also elsewhere on the board
-VBAT: R76.PAD_0 (PIN0), R80.PAD_0 (PIN0); also elsewhere on the board
CHARGER_POWER: CE2.PLUS, D16.ANODE, D101.2 (CATHODE), L1.1 (START); also elsewhere on the board
CHARGE_CURR_ADC: C41.PAD_0 (PIN0), D29.ANODE, D30.CATHODE, R68.PAD_1 (PIN1); also elsewhere on the board
GND: C16.1 (PIN0), C21.PAD_1 (PIN1), C22.PAD_1 (PIN1), C37.PAD_1 (PIN1), C39.PAD_0 (PIN0), C41.PAD_1 (PIN1), CE2.MINUS, CE3.MINUS, D20.ANODE, D30.ANODE, IC3.4 (GND), IC4.2 (ANODE), IC9.3 (ANODE), R34.PAD_0 (PIN0), R36.PAD_0 (PIN0), R37.PAD_0 (PIN0), R38.PAD_0 (PIN0), R41.PAD_1 (PIN1), R42.PAD_1 (PIN1), R51.PAD_0 (PIN0), R56.PAD_0 (PIN0), R60.PAD_0 (PIN0), R71.PAD_1 (PIN1), R74.PAD_0 (PIN0), R75.PAD_0 (PIN0), R77.PAD_0 (PIN0), R80.PAD1 (PIN1), R81.PAD_0 (PIN0), R83.PAD_1 (PIN1), T15.2 (E), T17.2 (E), TR3.12 (SEC_END), TR3.13 (SEC_END); also elsewhere on the board
unnamed: IC2.2 (LED_CATHODE), R59.PAD_1 (PIN1)
unnamed: R50.PAD_0 (PIN0), T10.1 (GATE)
unnamed: C11.1 (PIN0), F2.PAD1 (PIN1), R32.PAD_0 (PIN0), TR2.W1_START
unnamed: IC1.6 (OUT), R50.PAD_1 (PIN1)
unnamed: C11.2 (PIN1), R29.PAD_1 (PIN1), TR2.W2_START, X5.1
unnamed: C12.1 (PIN0), RV1.1 (PIN1), TR2.W2_END, U100.AC2
unnamed: C12.2 (PIN1), RV1.0 (PIN0), TR2.W1_END, U100.AC1
unnamed: R29.PAD_0 (PIN0), R32.PAD_1 (PIN1)
unnamed: C13.PAD_0 (PIN0), C16.2 (PIN1), CE1.PLUS, CE6.PLUS, R30.PAD1 (PIN1), R33.PAD1 (PIN1), R35.PAD1 (PIN1), TR3.1 (PRI1_END), U100.+, ZD2.ANODE
unnamed: C17.PAD_0 (PIN0), IC1.8 (V_REF), R43.PAD_0 (PIN0), R45.PAD_1 (PIN1), R46.PAD_1 (PIN1), T11.3 (C)
unnamed: TR3.2 (PRI1_START), TR3.3 (PRI2_END)
unnamed: D13.ANODE, T10.2 (DRAIN), TR3.4 (PRI2_START)
unnamed: C13.PAD1 (PIN1), D13.CATHODE, R35.PAD_0 (PIN0), ZD2.CATHODE
unnamed: R53.PAD_0 (PIN0), R57.PAD_1 (PIN1), T10.3 (SOURCE)
unnamed: C20.PAD_1 (PIN1), CE5.PLUS, D15.ANODE, IC1.7 (VCC), J100.PAD_0 (PIN0), T9.3 (C)
unnamed: C18.PAD_1 (PIN1), IC1.4 (RT/CT), R43.PAD_1 (PIN1)
unnamed: RT1.PAD_0 (PIN0), X5.2
unnamed: IC2.3 (EMITER), J2.PAD_0 (PIN0)
unnamed: R39.PAD_0 (PIN0), R40.PAD_0 (PIN0), T9.1 (B)
unnamed: C19.PAD_1 (PIN1), IC1.3 (I_SENSE), R33.PAD_0 (PIN0), R53.PAD_1 (PIN1)
unnamed: R55.PAD_1 (PIN1), T11.2 (E), T12.2 (E)
unnamed: R46.PAD_0 (PIN0), RT2.PAD1 (PIN1), T12.1 (B)
unnamed: R39.PAD_1 (PIN1), R44.PAD_1 (PIN1), T12.3 (C)
unnamed: R44.PAD_0 (PIN0), R45.PAD_0 (PIN0), R52.PAD_1 (PIN1), T11.1 (B)
unnamed: C15.PAD_1 (PIN1), D14.ANODE, TR3.7 (AUX_START)
unnamed: C15.PAD_0 (PIN0), R47.PAD_0 (PIN0), R48.PAD_0 (PIN0)
unnamed: C17.PAD_1 (PIN1), C18.PAD_0 (PIN0), C19.PAD_0 (PIN0), C20.PAD_0 (PIN0), C40.PAD_0 (PIN0), CE1.MINUS, CE4.MINUS, CE5.MINUS, CE6.MINUS, IC1.2 (VFB), IC1.5 (GND), J2.PAD_1 (PIN1), R47.PAD_1 (PIN1), R48.PAD_1 (PIN1), R52.PAD_0 (PIN0), R55.PAD_0 (PIN0), R57.PAD_0 (PIN0), RT2.PAD_0 (PIN0), TR3.6 (AUX_END), U100.-
unnamed: CE4.PLUS, D14.CATHODE, D15.CATHODE, R40.PAD_1 (PIN1), T9.2 (E)
unnamed: R63.PAD_0 (PIN0), R66.3 (END_B)
unnamed: R66.1 (END_A), R75.PAD_1 (PIN1)
unnamed: C37.PAD_0 (PIN0), IC9.1 (CATHODE), IC9.2 (REFERENCE), R31.PAD_1 (PIN1), R72.PAD_1 (PIN1)
unnamed: C40.PAD_1 (PIN1), IC1.1 (COMP), IC2.4 (COLLECTOR)
unnamed: C14.PAD_0 (PIN0), R41.PAD_0 (PIN0), R42.PAD_0 (PIN0)
unnamed: C14.PAD_1 (PIN1), D101.1 (ANODE1), D101.3 (ANODE2), TR3.9 (SEC_START), TR3.10 (SEC_START)
unnamed: R83.PAD_0 (PIN0), T18.2 (E)
unnamed: F2.PAD_0 (PIN0), RT1.PAD1 (PIN1)
unnamed: C25.PAD_1 (PIN1), IC4.3 (CATHODE), R59.PAD_0 (PIN0), R61.PAD_1 (PIN1), R65.PAD_0 (PIN0), T18.3 (C)
unnamed: R34.PAD_1 (PIN1), R36.PAD_1 (PIN1), R37.PAD_1 (PIN1), R38.PAD_1 (PIN1), R51.PAD_1 (PIN1), R56.PAD_1 (PIN1), R62.PAD_1 (PIN1), R63.PAD_1 (PIN1), R64.PAD_1 (PIN1), T13.3 (DRAIN), T16.2 (SOURCE)
unnamed: C23.PAD_0 (PIN0), C25.PAD_0 (PIN0), IC4.1 (REFERENCE), R62.PAD_0 (PIN0), R66.2 (ADJ), R70.PAD_0 (PIN0), R74.PAD_1 (PIN1)
unnamed: C23.PAD_1 (PIN1), R65.PAD_1 (PIN1)
unnamed: J100.PAD_1 (PIN1), R30.PAD_0 (PIN0)
unnamed: R54.PAD_0 (PIN0), T15.3 (C)
unnamed: R78.PAD_1 (PIN1), T18.1 (B)
unnamed: R58.PAD_1 (PIN1), R60.PAD_1 (PIN1), T15.1 (B)
unnamed: R49.PAD_1 (PIN1), R54.PAD_1 (PIN1), T13.1 (GATE), ZD3.ANODE
unnamed: C24.PAD_1 (PIN1), IC3.6 (IN-), R71.PAD_0 (PIN0), R108.PAD_0 (PIN0)
unnamed: C21.PAD_0 (PIN0), C39.PAD_1 (PIN1), CE3.PLUS, D19.CATHODE, IC2.1 (LED_ANODE), IC3.8 (VCC), L1.2 (END), R31.PAD_0 (PIN0), R58.PAD_0 (PIN0), R61.PAD_0 (PIN0)
unnamed: C26.PAD_1 (PIN1), IC3.2 (IN-), R79.PAD_1 (PIN1)
unnamed: C26.PAD_0 (PIN0), IC3.1 (OUT), R78.PAD_0 (PIN0), R82.PAD_1 (PIN1)
unnamed: R72.PAD_0 (PIN0), R79.PAD_0 (PIN0), R81.PAD_1 (PIN1), R82.PAD_0 (PIN0)
unnamed: D19.ANODE, D20.CATHODE, IC3.3 (IN+), R76.PAD_1 (PIN1), R109.PAD_1 (PIN1)
unnamed: C24.PAD_0 (PIN0), IC3.7 (OUT), R68.PAD_0 (PIN0), R108.PAD_1 (PIN1)
unnamed: R70.PAD_1 (PIN1), T16.3 (DRAIN)
unnamed: R64.PAD_0 (PIN0), R67.PAD_0 (PIN0), T16.1 (GATE)
unnamed: R67.PAD_1 (PIN1), T17.3 (C)
unnamed: R73.PAD_0 (PIN0), R77.PAD_1 (PIN1), T17.1 (B)
unnamed: C22.PAD_0 (PIN0), IC3.5 (IN+), R109.PAD_0 (PIN0)
~ADD_CHARGE_VOLTAGE: R73.PAD1 (PIN1); also elsewhere on the board

Notes on the sheet:
9K1 -> 90/55deg
10K8 -> 85/50deg
Dummy load

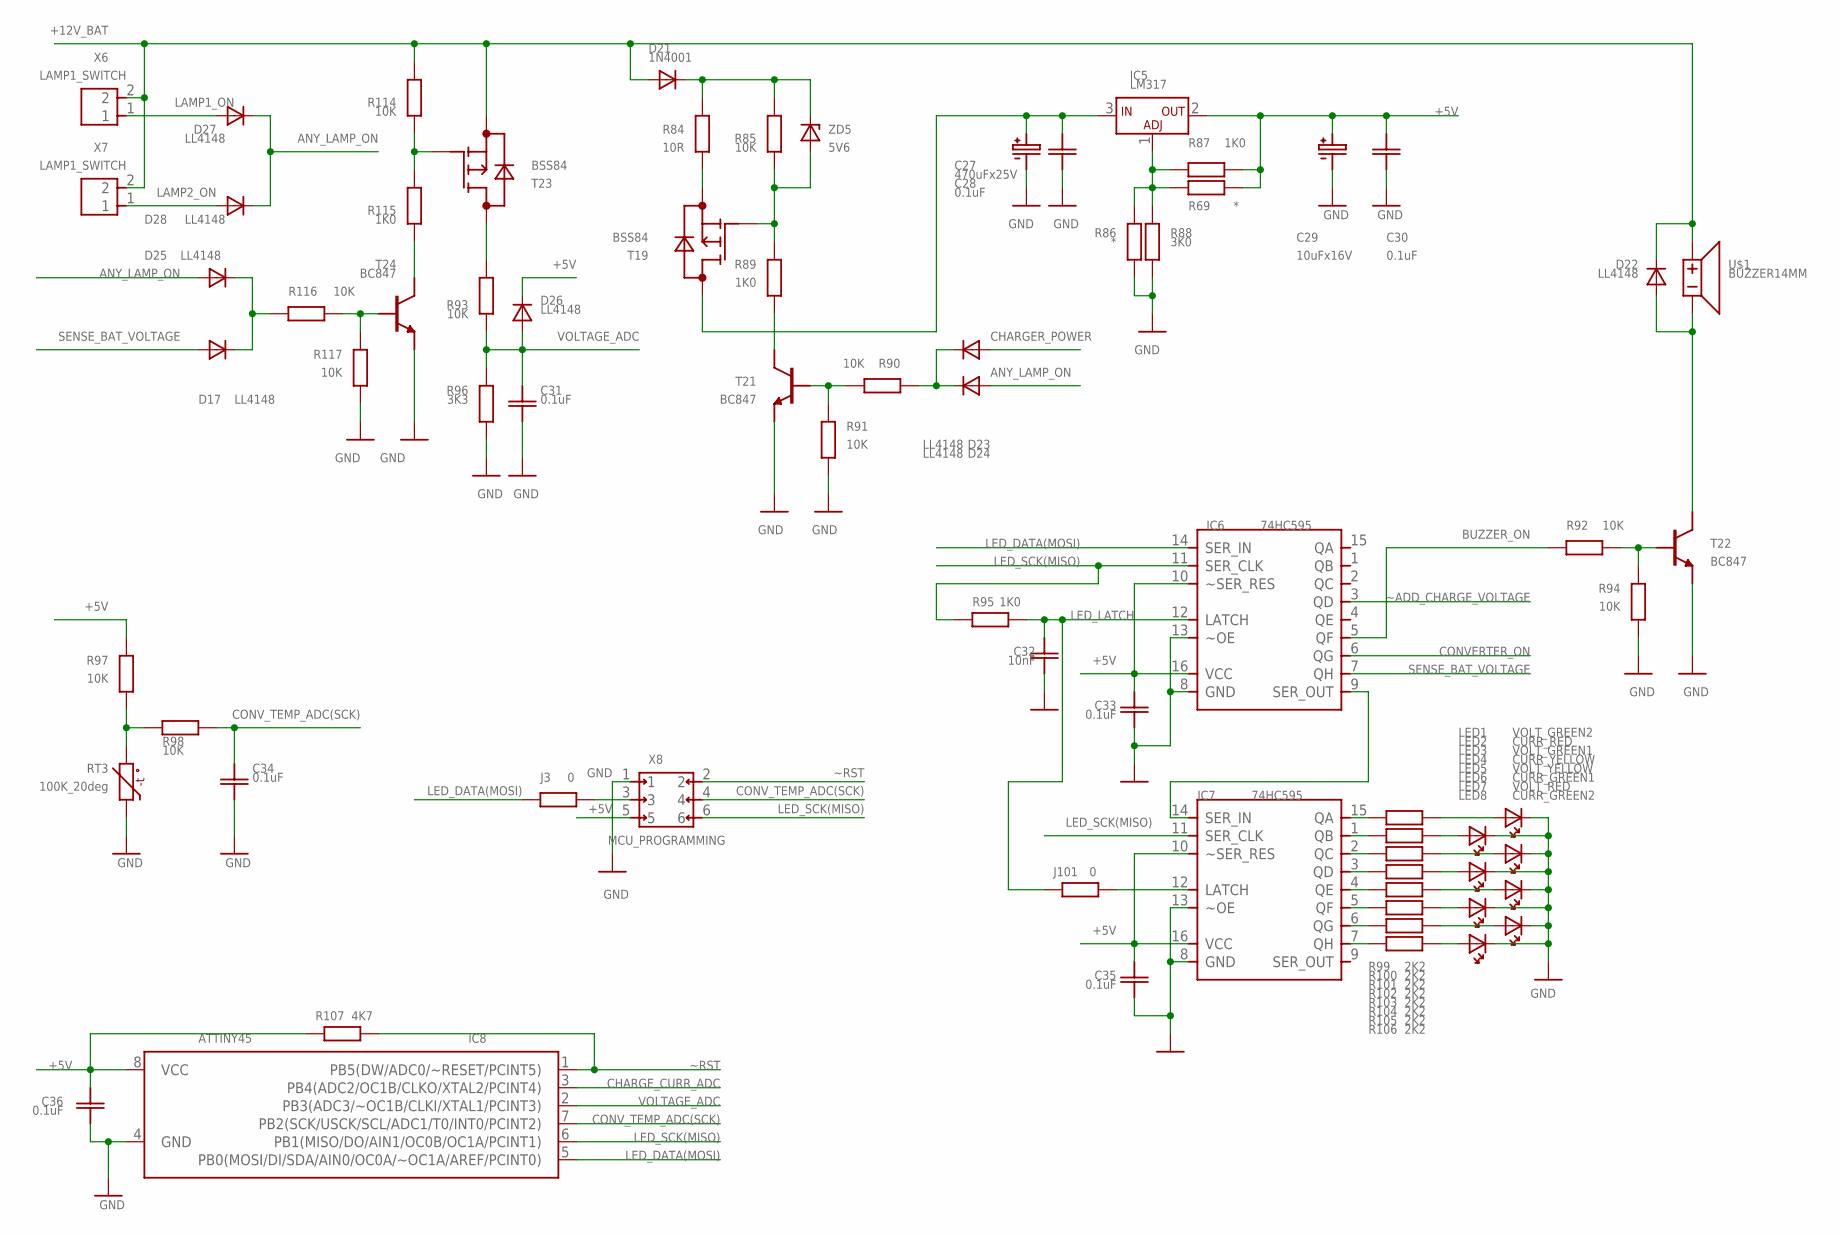
[picture p49: schematic 12to220inverterVer3.sch, sheet 3]

Parts:
C27: 470uFx25V; CE_6.3MM
C28, C30, C31, C33, C34, C35, C36: 0.1uF; RSMD_0805
C29: 10uFx16V; CE_5.2MM
C32: 10nF; RSMD_0805
D17, D22, D24, D25, D26, D27, D28: LL4148; SOD-80
D21: 1N4001; DO-41_10MM
D23: LL4148; DO-35_15MM
IC5: LM317; TO-220(VER2)_BIG_PADS
IC6, IC7: 74HC595; SOIC16
IC8: ATTINY45; PSOP8(0.208'')
J3: 0; RSMD_1206_BIG_GAP
J101: 0; RSMD_0805
LED1: VOLT_GREEN2; LED3MM
LED2: CURR_RED; LED3MM
LED3: VOLT_GREEN1; LED3MM
LED4: CURR_YELLOW; LED3MM
LED5: VOLT_YELLOW; LED3MM
LED6: CURR_GREEN1; LED3MM
LED7: VOLT_RED; LED3MM
LED8: CURR_GREEN2; LED3MM
R69, R86: *; RSMD_0805
R84: 10R; RSMD_0805
R85, R90, R91, R92, R93, R94, R97, R98, R114, R116, R117: 10K; RSMD_0805
R87, R89, R95, R115: 1K0; RSMD_0805
R88: 3K0; RSMD_0805
R96: 3K3; RSMD_0805
R99, R100, R101, R102, R103, R104, R105, R106: 2K2; RSMD_0805
R107: 4K7; RSMD_0805
RT3: 100K_20deg; NTC_5.5X3
T19, T23: BSS84; SOT23_SMALL_PADS
T21, T22, T24: BC847; SOT23_SMALL_PADS
U$1: BUZZER14MM; BUZZER_14MM
X6, X7: LAMP1_SWITCH; PIN2X1_2.54_WITH_CLAMP
X8: MCU_PROGRAMMING; PIN2X3_2.54MM_LOOSE_PADS
ZD5: 5V6; SOD-80

Connections:
+5V: C29.PLUS, C30.PAD_0 (PIN0), C33.PAD_0 (PIN0), C35.PAD_0 (PIN0), C36.PAD_0 (PIN0), D26.CATHODE, IC5.2 (OUT), IC6.10 (~SER_RES), IC6.16 (VCC), IC7.10 (~SER_RES), IC7.16 (VCC), IC8.8 (VCC), R69.PAD_1 (PIN1), R87.PAD_1 (PIN1), R97.PAD_0 (PIN0), R107.PAD_0 (PIN0), X8.5; also elsewhere on the board
+12V_BAT: D21.ANODE, D22.CATHODE, R114.PAD_0 (PIN0), T23.2 (SOURCE), U$1.PLUS, X6.2, X7.2; also elsewhere on the board
ANY_LAMP_ON: D24.ANODE, D25.ANODE, D27.CATHODE, D28.CATHODE
BUZZER_ON: IC6.5 (QF), R92.PAD_1 (PIN1)
CHARGER_POWER: D23.A (ANODE); also elsewhere on the board
CHARGE_CURR_ADC: IC8.3 (PB4(ADC2/OC1B/CLKO/XTAL2/PCINT4)); also elsewhere on the board
CONVERTER_ON: IC6.6 (QG); also elsewhere on the board
CONV_TEMP_ADC(SCK): C34.PAD_0 (PIN0), IC8.7 (PB2(SCK/USCK/SCL/ADC1/T0/INT0/PCINT2)), R98.PAD_1 (PIN1), X8.4
GND: C27.MINUS, C28.PAD_1 (PIN1), C29.MINUS, C30.PAD_1 (PIN1), C31.PAD_1 (PIN1), C32.PAD_1 (PIN1), C33.PAD_1 (PIN1), C34.PAD_1 (PIN1), C35.PAD_1 (PIN1), C36.PAD_1 (PIN1), IC6.8 (GND), IC6.13 (~OE), IC7.8 (GND), IC7.13 (~OE), IC8.4 (GND), LED1.CATHODE, LED2.CATHODE, LED3.CATHODE, LED4.CATHODE, LED5.CATHODE, LED6.CATHODE, LED7.CATHODE, LED8.CATHODE, R86.PAD_0 (PIN0), R88.PAD_0 (PIN0), R91.PAD_0 (PIN0), R94.PAD_0 (PIN0), R96.PAD_0 (PIN0), R117.PAD_0 (PIN0), RT3.PAD_0 (PIN0), T21.2 (E), T22.2 (E), T24.2 (E), X8.1; also elsewhere on the board
LAMP1_ON: D27.ANODE, X6.1; also elsewhere on the board
LAMP2_ON: D28.ANODE, X7.1; also elsewhere on the board
LED_DATA(MOSI): IC6.14 (SER_IN), IC8.5 (PB0(MOSI/DI/SDA/AIN0/OC0A/~OC1A/AREF/PC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), J3.PAD_0 (PIN0)
LED_LATCH: C32.PAD_0 (PIN0), IC6.12 (LATCH), J101.PAD_0 (PIN0), R95.PAD_1 (PIN1)
LED_SCK(MISO): IC6.11 (SER_CLK), IC7.11 (SER_CLK), IC8.6 (PB1(MISO/DO/AIN1/OC0B/OC1A/PCINT1)), R95.PAD_0 (PIN0), X8.6
unnamed: D21.CATHODE, R84.PAD_0 (PIN0), R85.PAD_0 (PIN0), ZD5.CATHODE
unnamed: J3.PAD_1 (PIN1), X8.3
unnamed: R85.PAD_1 (PIN1), R89.PAD_1 (PIN1), T19.1 (GATE), ZD5.ANODE
unnamed: R89.PAD_0 (PIN0), T21.3 (C)
unnamed: R90.PAD_0 (PIN0), R91.PAD_1 (PIN1), T21.1 (B)
unnamed: IC5.1 (ADJ), R69.PAD_0 (PIN0), R86.PAD_1 (PIN1), R87.PAD_0 (PIN0), R88.PAD_1 (PIN1)
unnamed: IC7.15 (QA), R99.PAD_0 (PIN0)
unnamed: IC7.1 (QB), R100.PAD_0 (PIN0)
unnamed: IC7.2 (QC), R101.PAD_0 (PIN0)
unnamed: IC7.3 (QD), R102.PAD_0 (PIN0)
unnamed: IC7.4 (QE), R103.PAD_0 (PIN0)
unnamed: IC7.5 (QF), R104.PAD_0 (PIN0)
unnamed: IC7.6 (QG), R105.PAD_0 (PIN0)
unnamed: IC7.7 (QH), R106.PAD_0 (PIN0)
unnamed: LED1.ANODE, R99.PAD_1 (PIN1)
unnamed: LED3.ANODE, R101.PAD_1 (PIN1)
unnamed: LED6.ANODE, R104.PAD_1 (PIN1)
unnamed: LED8.ANODE, R106.PAD_1 (PIN1)
unnamed: LED2.ANODE, R100.PAD_1 (PIN1)
unnamed: LED5.ANODE, R103.PAD_1 (PIN1)
unnamed: LED7.ANODE, R105.PAD_1 (PIN1)
unnamed: LED4.ANODE, R102.PAD_1 (PIN1)
unnamed: C27.PLUS, C28.PAD_0 (PIN0), IC5.3 (IN), T19.3 (DRAIN)
unnamed: D23.C (CATHODE), D24.CATHODE, R90.PAD_1 (PIN1)
unnamed: R84.PAD_1 (PIN1), T19.2 (SOURCE)
unnamed: IC7.12 (LATCH), J101.PAD_1 (PIN1)
unnamed: IC6.9 (SER_OUT), IC7.14 (SER_IN)
unnamed: D22.ANODE, T22.3 (C), U$1.MINUS
unnamed: R97.PAD_1 (PIN1), R98.PAD_0 (PIN0), RT3.PAD1 (PIN1)
unnamed: R92.PAD_0 (PIN0), R94.PAD_1 (PIN1), T22.1 (B)
unnamed: R114.PAD_1 (PIN1), R115.PAD_0 (PIN0), T23.1 (GATE)
unnamed: R115.PAD_1 (PIN1), T24.3 (C)
unnamed: R116.PAD_0 (PIN0), R117.PAD_1 (PIN1), T24.1 (B)
unnamed: R93.PAD_0 (PIN0), T23.3 (DRAIN)
unnamed: D17.CATHODE, D25.CATHODE, R116.PAD_1 (PIN1)
SENSE_BAT_VOLTAGE: D17.ANODE, IC6.7 (QH)
VOLTAGE_ADC: C31.PAD_0 (PIN0), D26.ANODE, IC8.2 (PB3(ADC3/~OC1B/CLKI/XTAL1/PCINT3)), R93.PAD_1 (PIN1), R96.PAD_1 (PIN1)
~ADD_CHARGE_VOLTAGE: IC6.3 (QD); also elsewhere on the board
~RST: IC8.1 (PB5(DW/ADC0/~RESET/PCINT5)), R107.PAD_1 (PIN1), X8.2

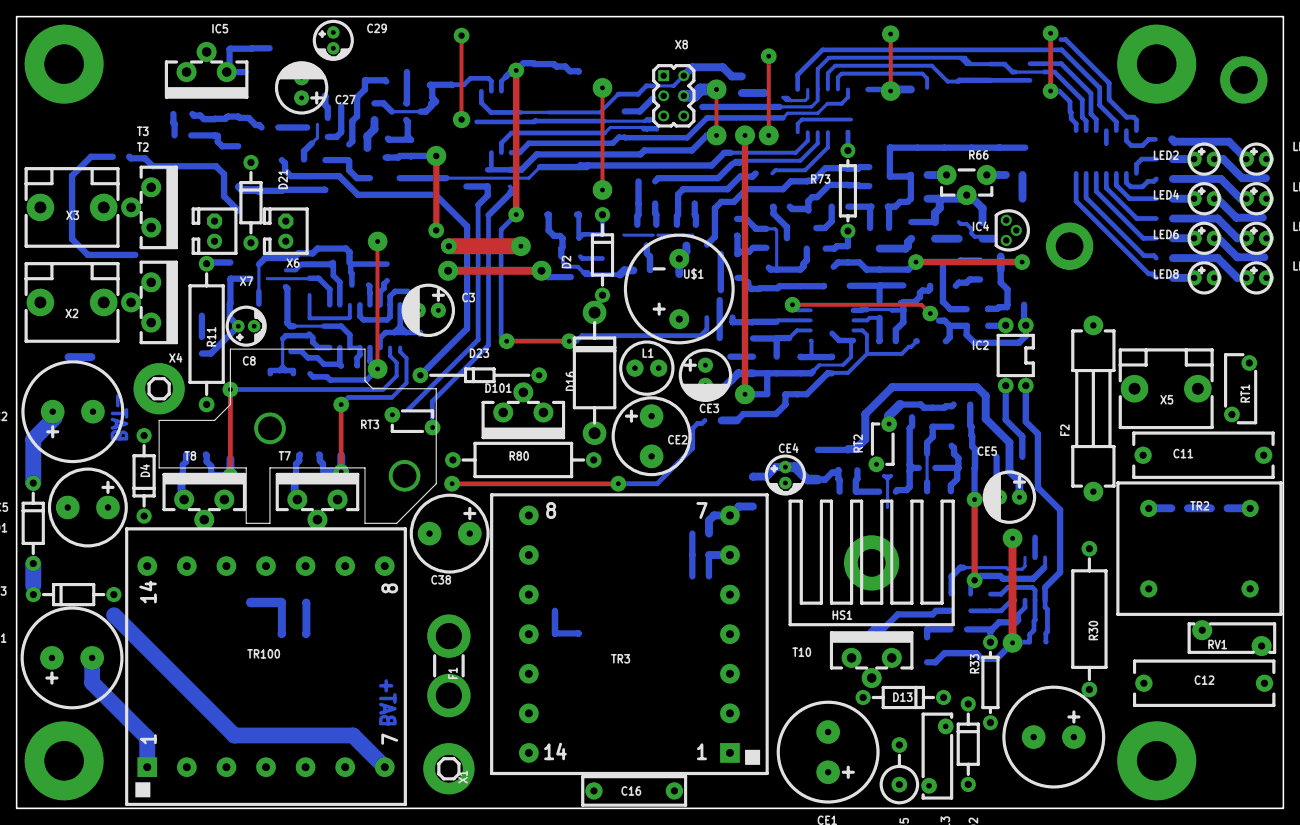
[picture p50: board 12to220inverterVer3.brd from above]

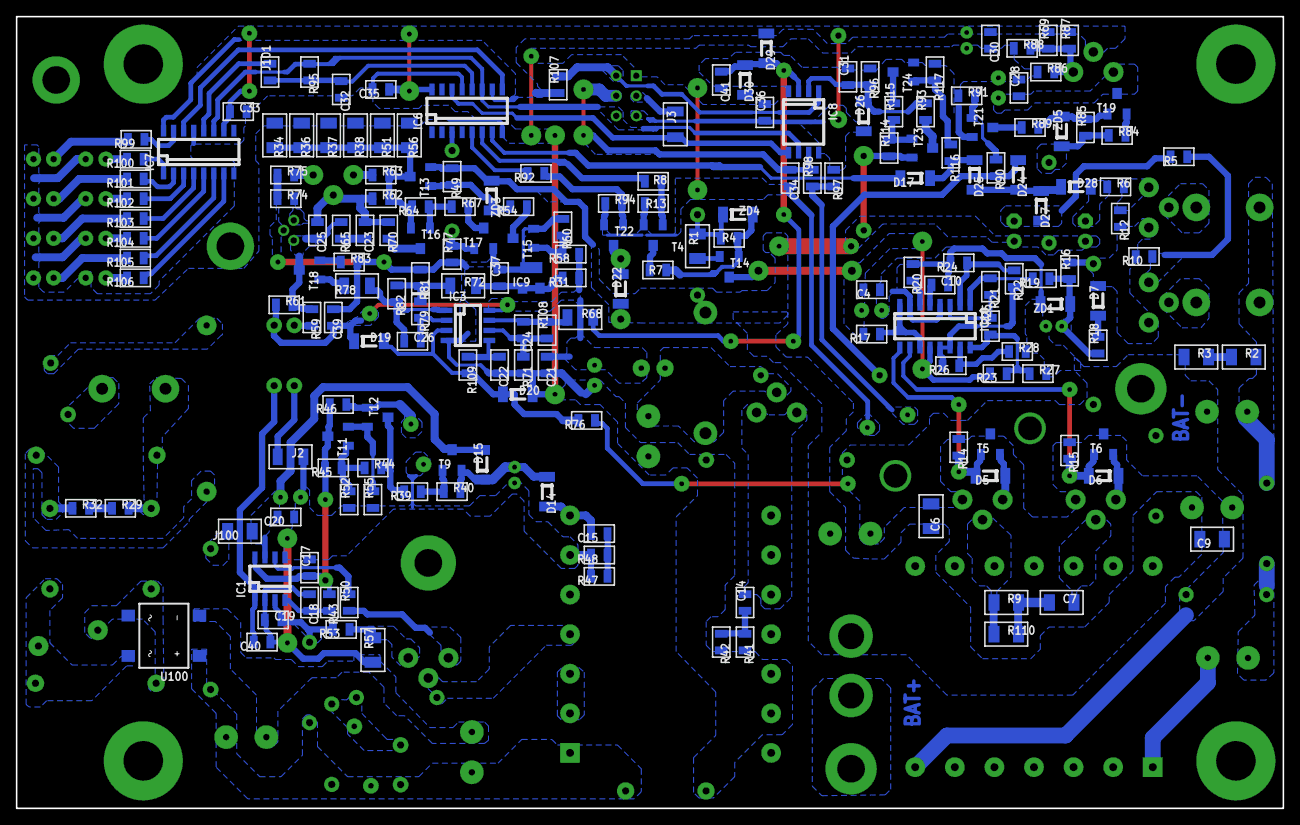
[picture p51: board 12to220inverterVer3.brd from below]

Board: 2 copper layers, 160.0 x 100.0 mm, 256 parts (185 on the bottom side), 145 nets.
