InspectorColombo/ColomboProjects/12_to_200V_inverter/schematic/12to220inverterVer2_to_print.brd

## EAGLE design 12_to_200V_inverter/schematic/12to220inverterVer2_to_print.brd (2023-12-27, an earlier design)

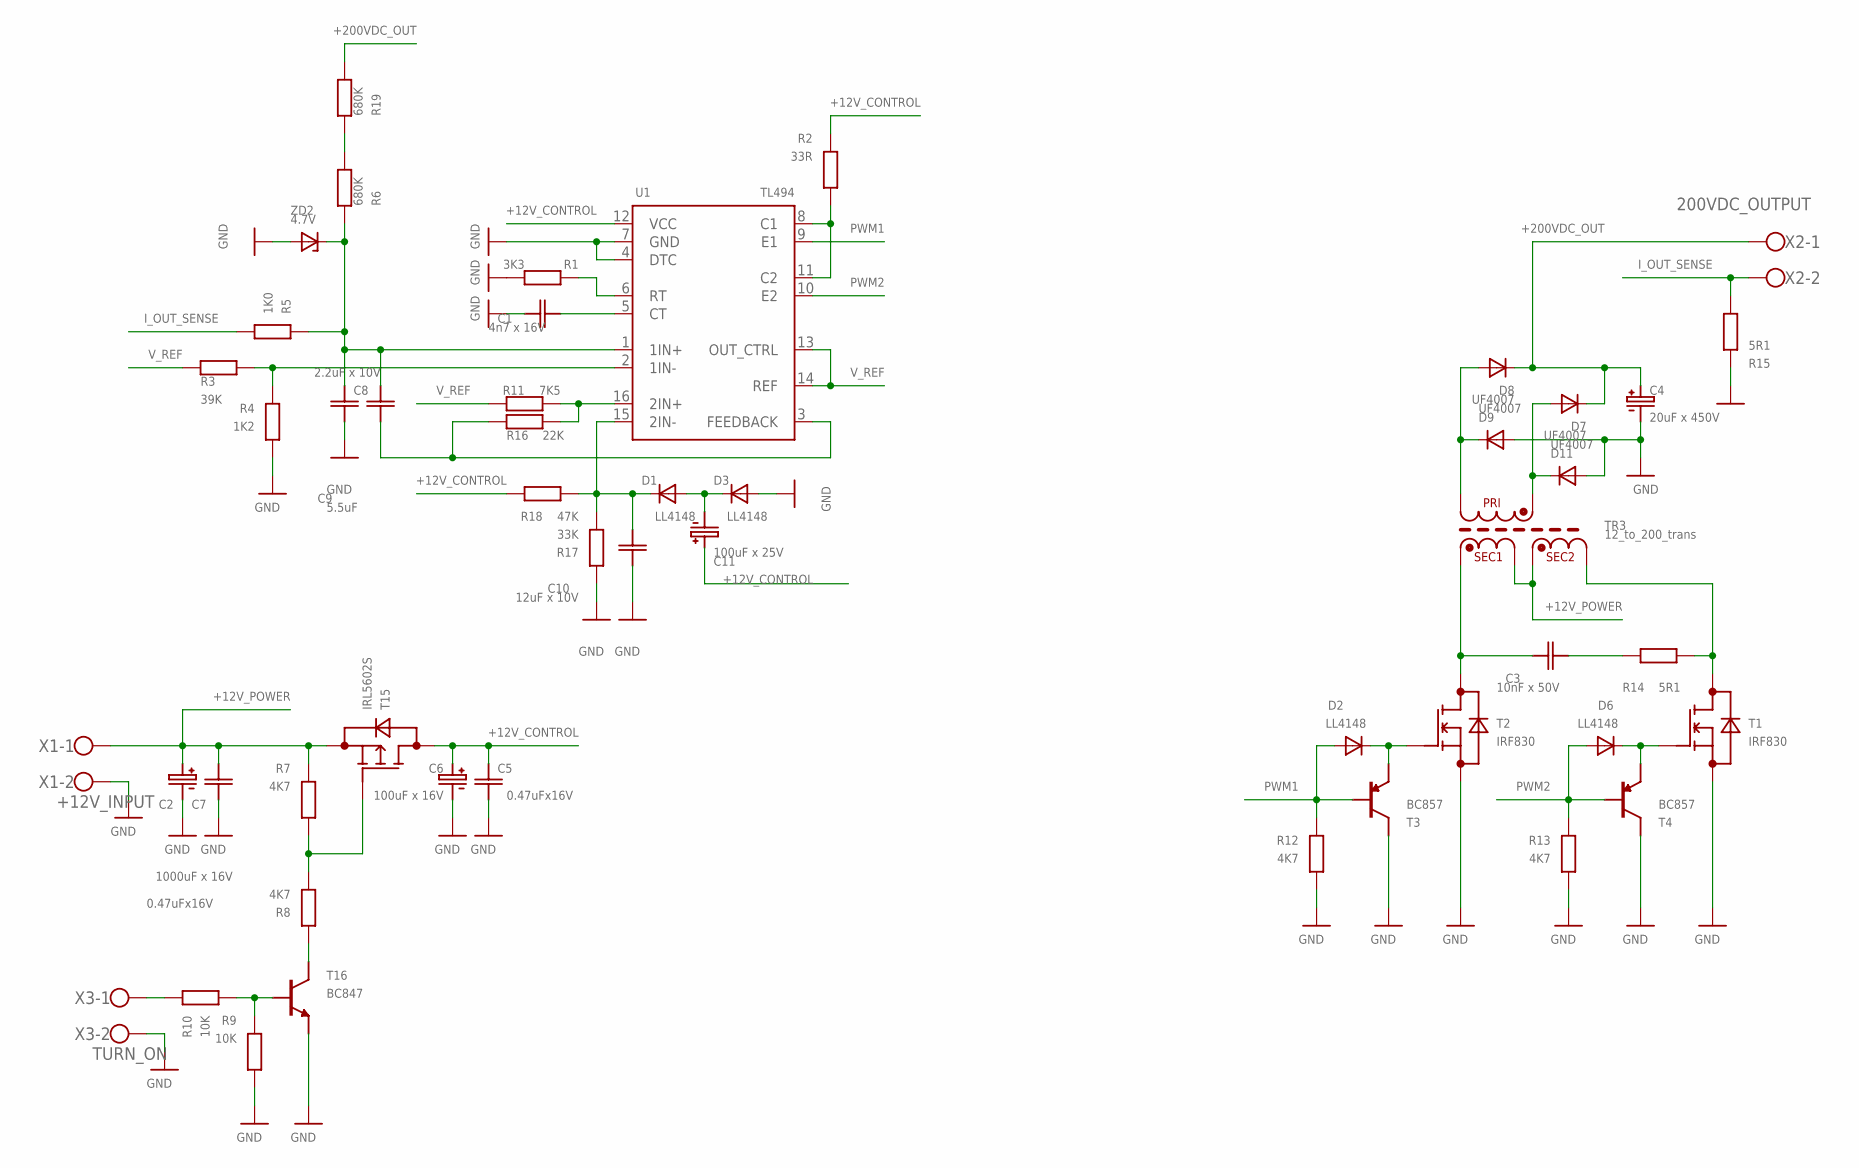
[picture p52: schematic 12to220inverterVer2_to_print.sch]

Parts:
C1: 4n7 x 16V; RSMD_0805
C2: 1000uF x 16V; CE_12.5MM
C3: 10nF x 50V; RSMD_1206
C4: 20uF x 450V; CE_16MM
C5: 0.47uFx16V; RSMD_0805
C6: 100uF x 16V; CE_6.3MM
C7: 0.47uFx16V; RSMD_1206
C8: 2.2uF x 10V; RSMD_0805
C9: 5.5uF; RSMD_0805
C10: 12uF x 10V; RSMD_0805
C11: 100uF x 25V; CE_5.2MM
D1, D2, D3, D6: LL4148; SOD-80
D7, D8, D9, D11: UF4007; DO-41_10MM
R1: 3K3; RSMD_0805
R2: 33R; RSMD_0805
R3: 39K; RSMD_0805
R4: 1K2; RSMD_0805
R5: 1K0; RSMD_0805
R6, R19: 680K; RSMD_0805
R7, R8, R12, R13: 4K7; RSMD_0805
R9, R10: 10K; RSMD_0805
R11: 7K5; RSMD_0805
R14: 5R1; RSMD_1206
R15: 5R1; RSMD_2512
R16: 22K; RSMD_0805
R17: 33K; RSMD_0805
R18: 47K; RSMD_0805
T1, T2: IRF830; TO-220
T3, T4: BC857; SOT23_SMALL_PADS
T15: IRL5602S; D2PAK
T16: BC847; SOT23_SMALL_PADS
TR3: 12_to_200_trans; TRANS_38X35MM
U1: TL494; SOIC16
X1: +12V_INPUT; W237-102
X2: 200VDC_OUTPUT; W237-102
X3: TURN_ON; W237-102; MPN 237-102
ZD2: 4.7V; SOD-80

Connections:
+12V_CONTROL: C5.PAD_1 (PIN1), C6.PLUS, C11.PLUS, R2.PAD_1 (PIN1), R18.PAD_1 (PIN1), T15.2 (DRAIN), U1.12 (VCC)
+12V_POWER: C2.PLUS, C7.PAD_1 (PIN1), R7.PAD_1 (PIN1), T15.3 (SOURCE), TR3.4 (SEC2_START), TR3.5 (SEC1_END), X1.1
+200VDC_OUT: C4.PLUS, D7.CATHODE, D8.CATHODE, R19.PAD_1 (PIN1), X2.1
GND: C1.PAD_1 (PIN1), C2.MINUS, C4.MINUS, C5.PAD_0 (PIN0), C6.MINUS, C7.PAD_0 (PIN0), C9.PAD_0 (PIN0), C10.PAD_0 (PIN0), D3.ANODE, D9.ANODE, D11.ANODE, R1.PAD_0 (PIN0), R4.PAD_1 (PIN1), R9.PAD_0 (PIN0), R12.PAD_0 (PIN0), R13.PAD_0 (PIN0), R15.PAD1 (PIN1), R17.PAD_1 (PIN1), T1.3 (SOURCE), T2.3 (SOURCE), T3.3 (C), T4.3 (C), T16.2 (E), U1.4 (DTC), U1.7 (GND), X1.2, X3.2, ZD2.ANODE
I_OUT_SENSE: R5.PAD_1 (PIN1), R15.PAD0 (PIN0), X2.2
unnamed: R6.PAD_1 (PIN1), R19.PAD_0 (PIN0)
unnamed: C1.PAD_0 (PIN0), U1.5 (CT)
unnamed: R1.PAD_1 (PIN1), U1.6 (RT)
unnamed: R2.PAD_0 (PIN0), U1.8 (C1), U1.11 (C2)
unnamed: R3.PAD_0 (PIN0), R4.PAD_0 (PIN0), U1.2 (1IN-)
unnamed: C8.PAD_0 (PIN0), R16.PAD_1 (PIN1), U1.3 (FEEDBACK)
unnamed: C8.PAD_1 (PIN1), C9.PAD_1 (PIN1), R5.PAD_0 (PIN0), R6.PAD_0 (PIN0), U1.1 (1IN+), ZD2.CATHODE
unnamed: R11.PAD_0 (PIN0), R16.PAD_0 (PIN0), U1.16 (2IN+)
unnamed: C11.MINUS, D1.ANODE, D3.CATHODE
unnamed: R7.PAD_0 (PIN0), R8.PAD_1 (PIN1), T15.1 (GATE)
unnamed: R10.PAD_1 (PIN1), X3.1
unnamed: R9.PAD_1 (PIN1), R10.PAD_0 (PIN0), T16.1 (B)
unnamed: R8.PAD_0 (PIN0), T16.3 (C)
unnamed: C10.PAD_1 (PIN1), D1.CATHODE, R17.PAD_0 (PIN0), R18.PAD_0 (PIN0), U1.15 (2IN-)
unnamed: D2.CATHODE, T2.1 (GATE), T3.2 (E)
unnamed: D7.ANODE, D11.CATHODE, TR3.9 (PRI_START)
unnamed: D6.CATHODE, T1.1 (GATE), T4.2 (E)
unnamed: D8.ANODE, D9.CATHODE, TR3.10 (PRI_END)
unnamed: C3.PAD_1 (PIN1), T2.2 (DRAIN), TR3.6 (SEC1_START)
unnamed: R14.PAD_0 (PIN0), T1.2 (DRAIN), TR3.3 (SEC2_END)
unnamed: C3.PAD_0 (PIN0), R14.PAD_1 (PIN1)
PWM1: D2.ANODE, R12.PAD_1 (PIN1), T3.1 (B), U1.9 (E1)
PWM2: D6.ANODE, R13.PAD_1 (PIN1), T4.1 (B), U1.10 (E2)
V_REF: R3.PAD_1 (PIN1), R11.PAD_1 (PIN1), U1.13 (OUT_CTRL), U1.14 (REF)

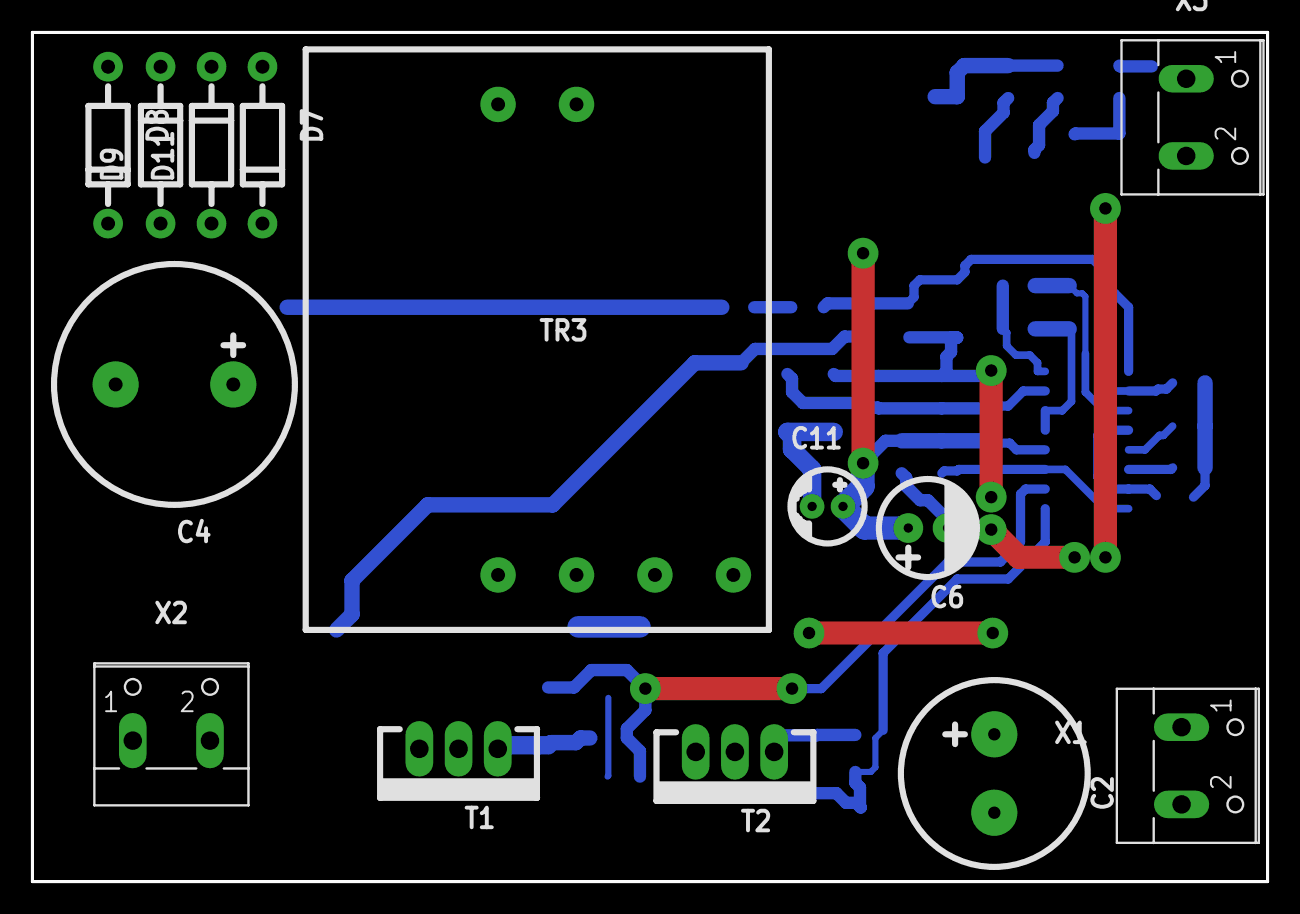
[picture p53: board 12to220inverterVer2_to_print.brd from above]

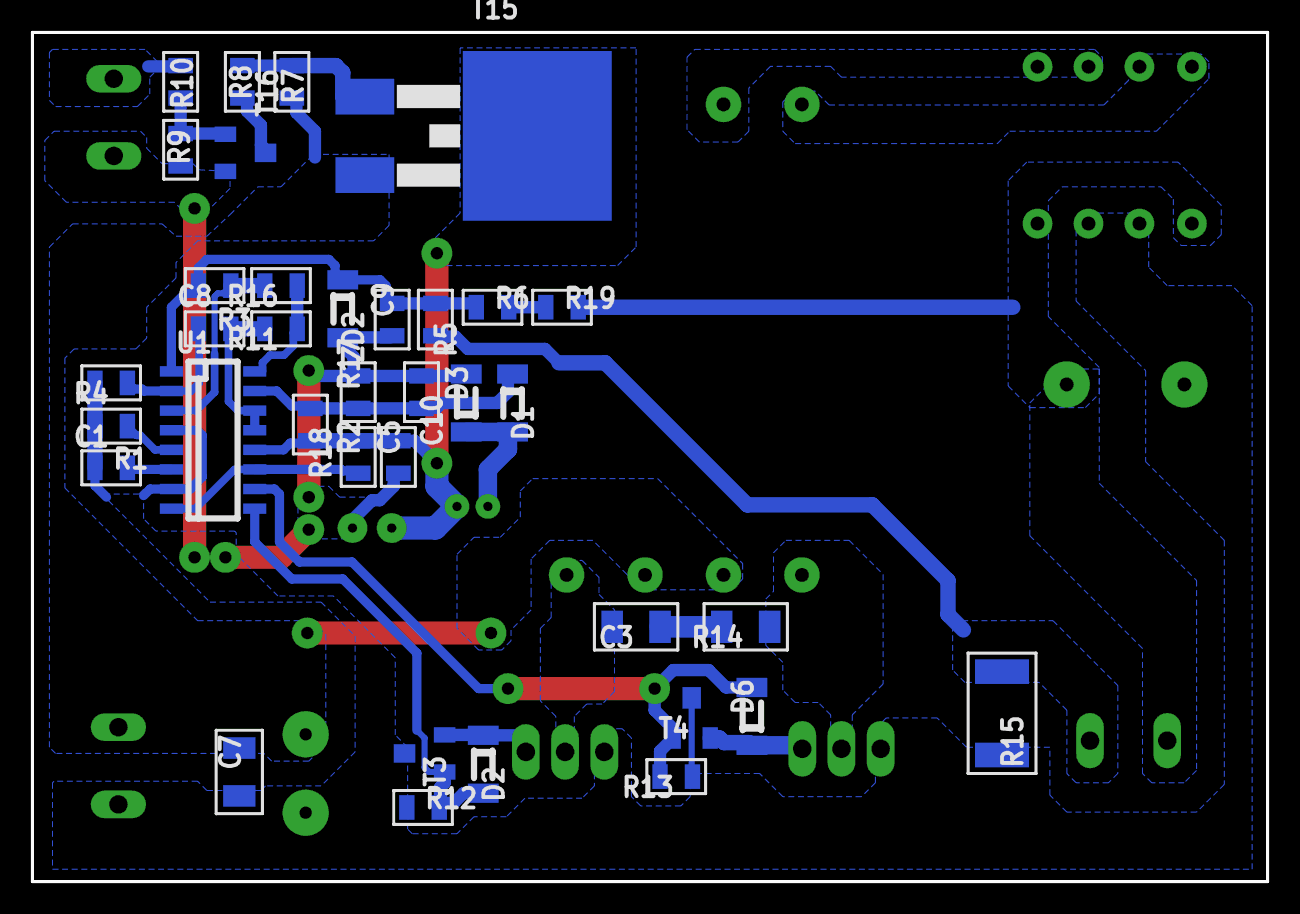
[picture p54: board 12to220inverterVer2_to_print.brd from below]

Board: 2 copper layers, 80.0 x 55.0 mm, 50 parts (36 on the bottom side), 29 nets.
