InspectorColombo/ColomboProjects/12_to_200V_inverter/schematic/12to220inverter_TO_RPINT.brd

## EAGLE design 12_to_200V_inverter/schematic/12to220inverter_TO_RPINT.brd (2023-12-08)

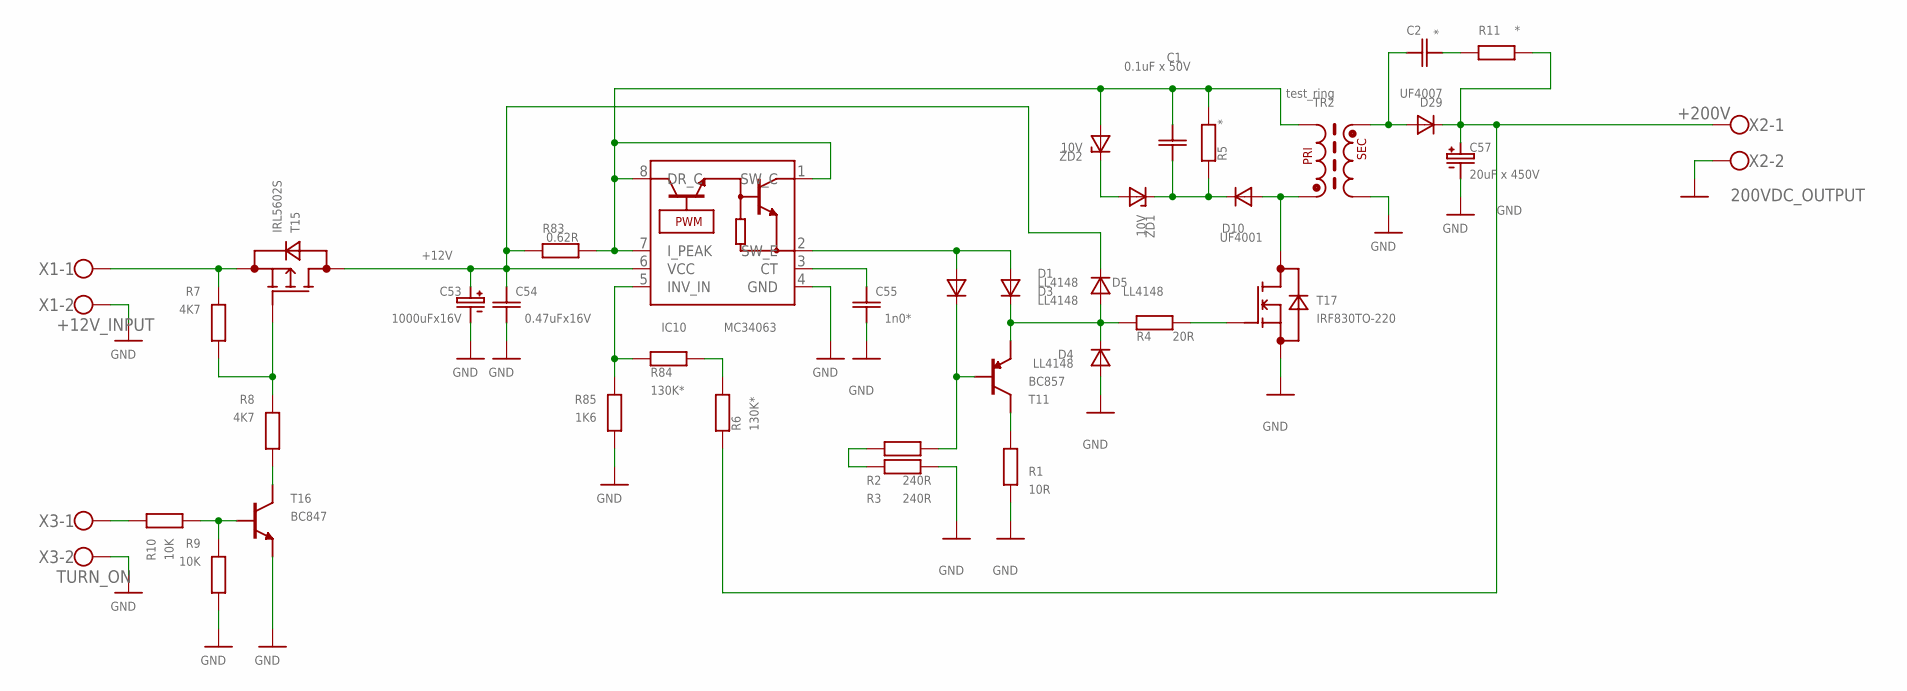
[picture p55: schematic 12to220inverter_TO_RPINT.sch]

Parts:
C1: 0.1uF x 50V; RSMD_1206
C2: *; RSMD_1206
C53: 1000uFx16V; CE_16MM
C54: 0.47uFx16V; RSMD_1206
C55: 1n0*; RSMD_0805
C57: 20uF x 450V; CE_16MM
D1, D3, D4, D5: LL4148; SOD-80
D10: UF4001; DO-41_15MM
D29: UF4007; DO-41_10MM
IC10: MC34063; DIP8
R1: 10R; RSMD_1206_BIG_GAP
R2, R3: 240R; RSMD_1206_BIG_GAP
R4: 20R; RSMD_0805
R5, R11: *; RSMD_1206
R6, R84: 130K*; RSMD_1206
R7, R8: 4K7; RSMD_0805
R9, R10: 10K; RSMD_0805
R83: 0.62R; RSMD_2512
R85: 1K6; RSMD_0805
T11: BC857; SOT23_SMALL_PADS
T15: IRL5602S; D2PAK
T16: BC847; SOT23_SMALL_PADS
T17: IRF830TO-220; TO-220
TR2: test_ring; RING_25X10_2WIND_VERT
X1: +12V_INPUT; W237-102
X2: 200VDC_OUTPUT; W237-102
X3: TURN_ON; W237-102; MPN 237-102
ZD1, ZD2: 10V; SOD-80

Connections:
+12V: C53.PLUS, C54.PAD_1 (PIN1), D5.CATHODE, IC10.6 (VCC), R83.PAD0 (PIN0), T15.2 (DRAIN)
+200V: C57.PLUS, D29.CATHODE, R6.PAD_0 (PIN0), R11.PAD_0 (PIN0), X2.1
GND: C53.MINUS, C54.PAD_0 (PIN0), C55.PAD_0 (PIN0), C57.MINUS, D4.ANODE, IC10.4 (GND), R1.PAD_1 (PIN1), R3.PAD_1 (PIN1), R9.PAD_0 (PIN0), R85.PAD_0 (PIN0), T16.2 (E), T17.3 (SOURCE), TR2.W2_END (SEC_END), X1.2, X2.2, X3.2
unnamed: D10.ANODE, T17.2 (DRAIN), TR2.W1_START (PRI_START)
unnamed: R1.PAD_0 (PIN0), T11.3 (C)
unnamed: R6.PAD_1 (PIN1), R84.PAD_1 (PIN1)
unnamed: D3.CATHODE, R2.PAD_0 (PIN0), T11.1 (B)
unnamed: R2.PAD_1 (PIN1), R3.PAD_0 (PIN0)
unnamed: D1.ANODE, D3.ANODE, IC10.2 (SW_E)
unnamed: D1.CATHODE, D4.CATHODE, D5.ANODE, R4.PAD_0 (PIN0), T11.2 (E)
unnamed: R4.PAD_1 (PIN1), T17.1 (GATE)
unnamed: C1.PAD_0 (PIN0), D10.CATHODE, R5.PAD_0 (PIN0), ZD1.CATHODE
unnamed: C1.PAD_1 (PIN1), IC10.1 (SW_C), IC10.7 (I_PEAK), IC10.8 (DR_C), R5.PAD_1 (PIN1), R83.PAD1 (PIN1), TR2.W1_END (PRI_END), ZD2.ANODE
unnamed: C2.PAD_1 (PIN1), D29.ANODE, TR2.W2_START (SEC_START)
unnamed: ZD1.ANODE, ZD2.CATHODE
unnamed: R7.PAD_1 (PIN1), T15.3 (SOURCE), X1.1
unnamed: R7.PAD_0 (PIN0), R8.PAD_1 (PIN1), T15.1 (GATE)
unnamed: R10.PAD_1 (PIN1), X3.1
unnamed: R9.PAD_1 (PIN1), R10.PAD_0 (PIN0), T16.1 (B)
unnamed: R8.PAD_0 (PIN0), T16.3 (C)
unnamed: C2.PAD_0 (PIN0), R11.PAD_1 (PIN1)
unnamed: C55.PAD_1 (PIN1), IC10.3 (CT)
unnamed: IC10.5 (INV_IN), R84.PAD_0 (PIN0), R85.PAD_1 (PIN1)

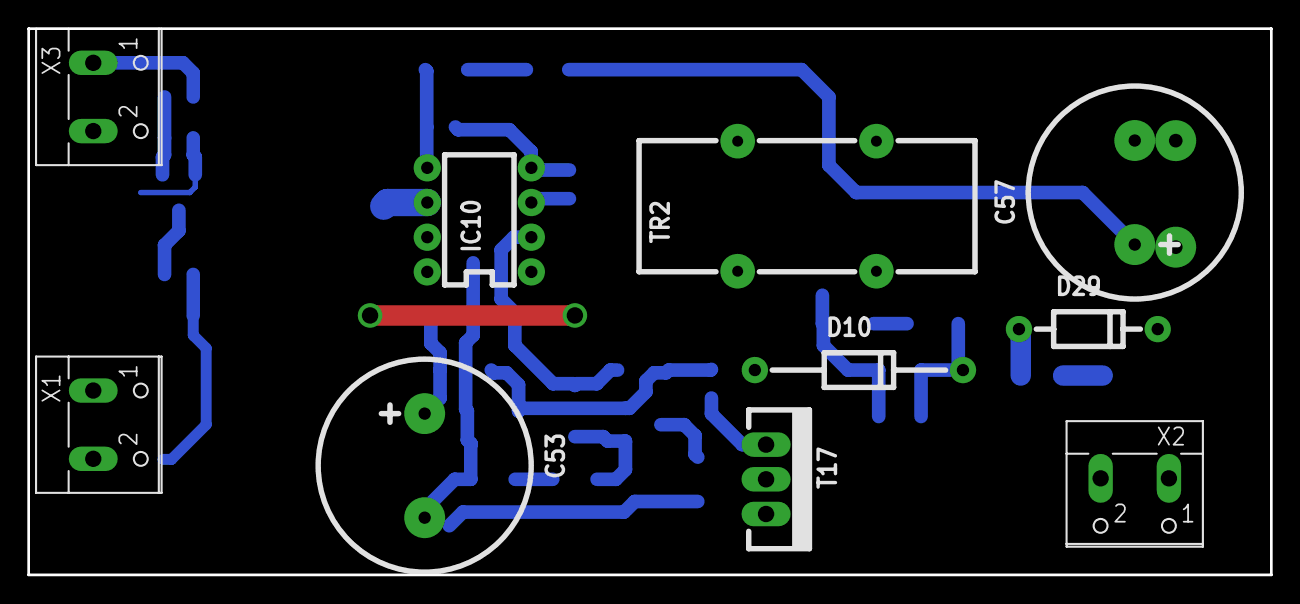
[picture p56: board 12to220inverter_TO_RPINT.brd from above]

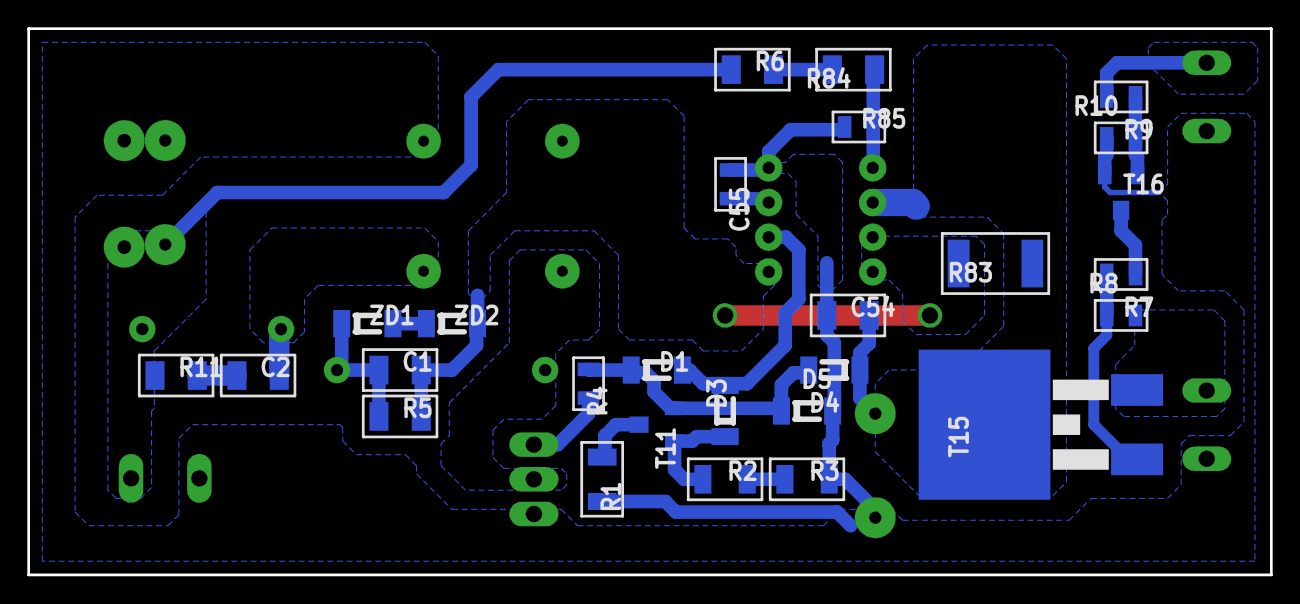
[picture p57: board 12to220inverter_TO_RPINT.brd from below]

Board: 2 copper layers, 91.0 x 40.0 mm, 37 parts (27 on the bottom side), 23 nets.
