InspectorColombo/ColomboProjects/KLineAdapter/schematic/KLineAdapter.brd

## EAGLE design KLineAdapter/schematic/KLineAdapter.brd (2023-11-26)

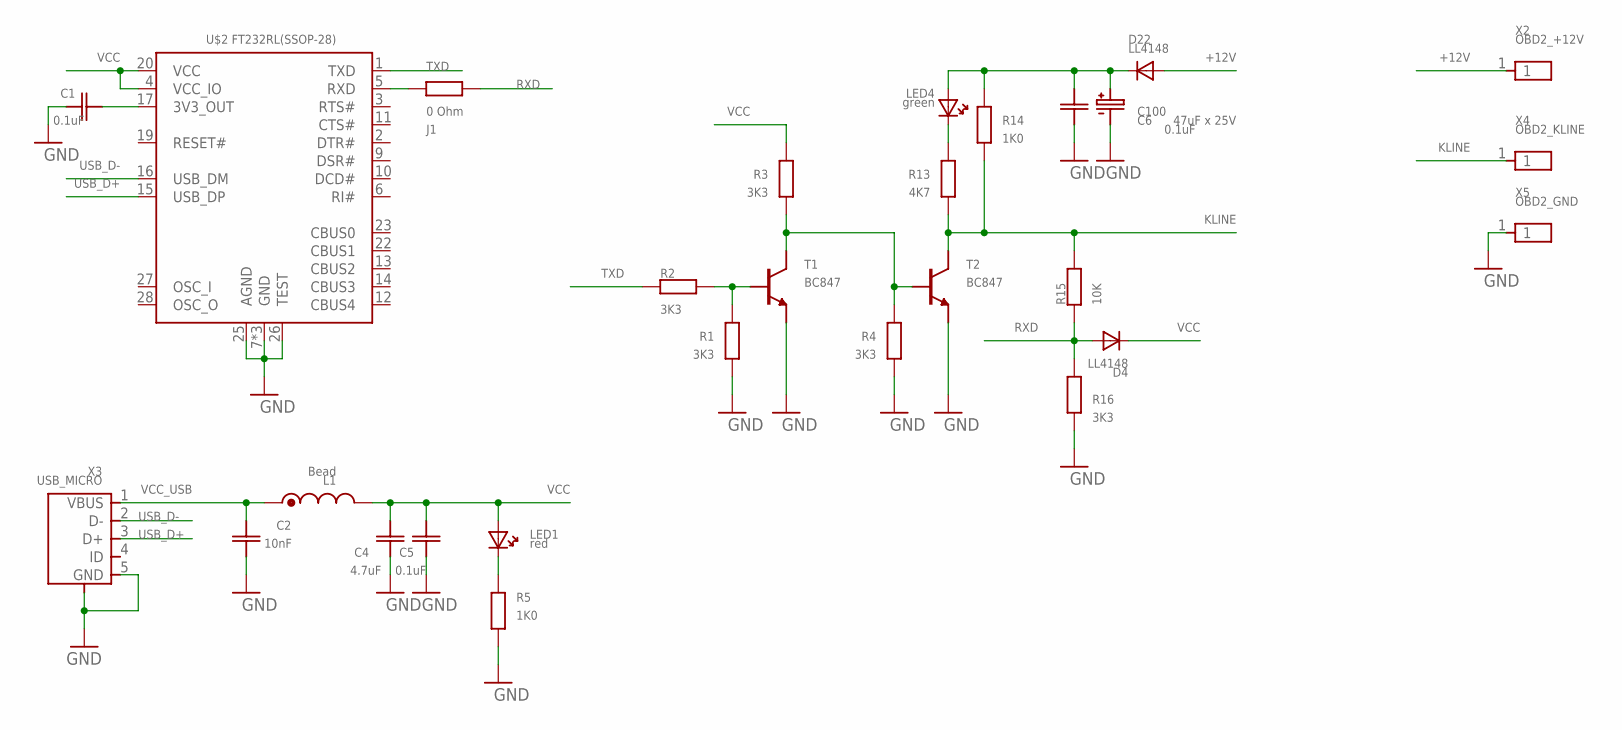
[picture p58: schematic KLineAdapter.sch]

Parts:
C1, C5, C6: 0.1uF; RSMD_0805
C2: 10nF; RSMD_0805
C4: 4.7uF; RSMD_1206
C100: 47uF x 25V; CE_5.2MM
D4, D22: LL4148; SOD-80
J1: 0 Ohm; RSMD_0805
L1: Bead; RSMD_1206
LED1: red; LED_0805
LED4: green; LED_0805
R1, R2, R3, R4, R16: 3K3; RSMD_0805
R5, R14: 1K0; RSMD_0805
R13: 4K7; RSMD_0805
R15: 10K; RSMD_0805
T1, T2: BC847; SOT23_SMALL_PADS
U$2: FT232RL(SSOP-28); SSOP-28
X2: OBD2_+12V; PIN1X1_3.5MM_PWR
X3: USB_MICRO; USB_MICRO_TYPE_B
X4: OBD2_KLINE; PIN1X1_3.5MM_PWR
X5: OBD2_GND; PIN1X1_3.5MM_PWR

Connections:
+12V: D22.ANODE, X2.1
GND: C1.PAD_0 (PIN0), C2.PAD_0 (PIN0), C4.PAD_0 (PIN0), C5.PAD_0 (PIN0), C6.PAD_0 (PIN0), C100.MINUS, R1.PAD_1 (PIN1), R4.PAD_1 (PIN1), R5.PAD_0 (PIN0), R16.PAD_0 (PIN0), T1.2 (E), T2.2 (E), U$2.7 (GND), U$2.18 (GND), U$2.21 (GND), U$2.25 (AGND), U$2.26 (TEST), X3.5 (GND), X3.PACKAGE1 (PACKAGE), X3.PACKAGE2 (PACKAGE), X3.PACKAGE3 (PACKAGE), X3.PACKAGE4 (PACKAGE), X3.PACKAGE5 (PACKAGE), X5.1
KLINE: R13.PAD_0 (PIN0), R14.PAD_0 (PIN0), R15.PAD_1 (PIN1), T2.3 (C), X4.1
unnamed: C1.PAD_1 (PIN1), U$2.17 (3V3_OUT)
unnamed: J1.PAD_0 (PIN0), U$2.5 (RXD)
unnamed: R1.PAD_0 (PIN0), R2.PAD_1 (PIN1), T1.1 (B)
unnamed: R3.PAD_0 (PIN0), R4.PAD_0 (PIN0), T1.3 (C), T2.1 (B)
unnamed: C6.PAD_1 (PIN1), C100.PLUS, D22.CATHODE, LED4.ANODE, R14.PAD_1 (PIN1)
unnamed: LED1.CATHODE, R5.PAD_1 (PIN1)
unnamed: LED4.CATHODE, R13.PAD_1 (PIN1)
RXD: D4.ANODE, J1.PAD_1 (PIN1), R15.PAD_0 (PIN0), R16.PAD_1 (PIN1)
TXD: R2.PAD_0 (PIN0), U$2.1 (TXD)
USB_D+: U$2.15 (USB_DP), X3.3 (D+)
USB_D-: U$2.16 (USB_DM), X3.2 (D-)
VCC: C4.PAD_1 (PIN1), C5.PAD_1 (PIN1), D4.CATHODE, L1.PAD_0 (END), LED1.ANODE, R3.PAD_1 (PIN1), U$2.4 (VCC_IO), U$2.20 (VCC)
VCC_USB: C2.PAD_1 (PIN1), L1.PAD_1 (START), X3.1 (VBUS)

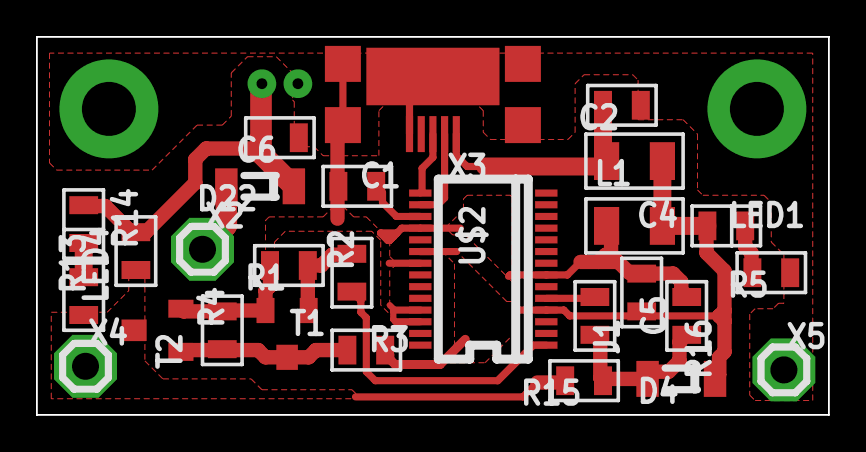
[picture p59: board KLineAdapter.brd from above]

Board: 2 copper layers, 44.0 x 21.0 mm, 28 parts (1 on the bottom side), 16 nets.
