InspectorColombo/ColomboProjects/KLineAdapter/bottom_board/KLine_bottom_board.brd

## EAGLE design KLineAdapter/bottom_board/KLine_bottom_board.brd (2023-11-24)

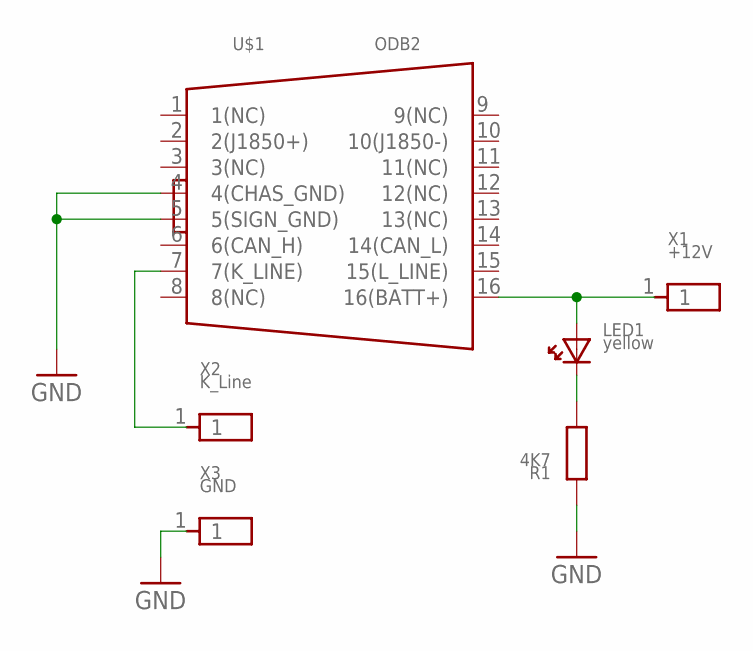
[picture p60: schematic KLine_bottom_board.sch]

Parts:
LED1: yellow; LED_0805
R1: 4K7; RSMD_0805
U$1: ODB2
X1: +12V; PIN1X1_3.5MM_SIDE_BOARD
X2: K_Line; PIN1X1_3.5MM_SIDE_BOARD
X3: GND; PIN1X1_3.5MM_SIDE_BOARD

Connections:
BAT_+12V: LED1.ANODE, U$1.16 (16(BATT+)), X1.1
GND: R1.PAD_1 (PIN1), U$1.4 (4(CHAS_GND)), U$1.5 (5(SIGN_GND)), X3.1
unnamed: U$1.7 (7(K_LINE)), X2.1
unnamed: LED1.CATHODE, R1.PAD_0 (PIN0)

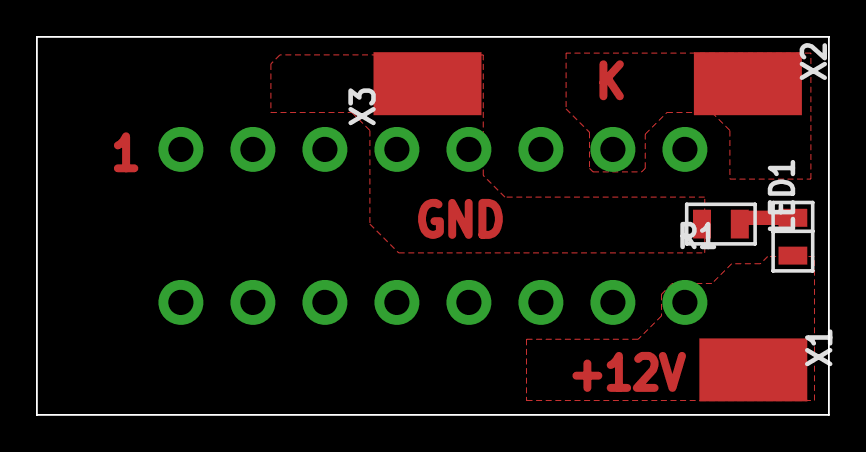
[picture p61: board KLine_bottom_board.brd from above]

Board: 2 copper layers, 44.0 x 21.0 mm, 6 parts (0 on the bottom side), 4 nets.
