InspectorColombo/ColomboProjects/LC_METER/TestPowerInverter/LCMeter_test_power_inverter_VER2.brd

## EAGLE design LC_METER/TestPowerInverter/LCMeter_test_power_inverter_VER2.brd (2023-03-14)

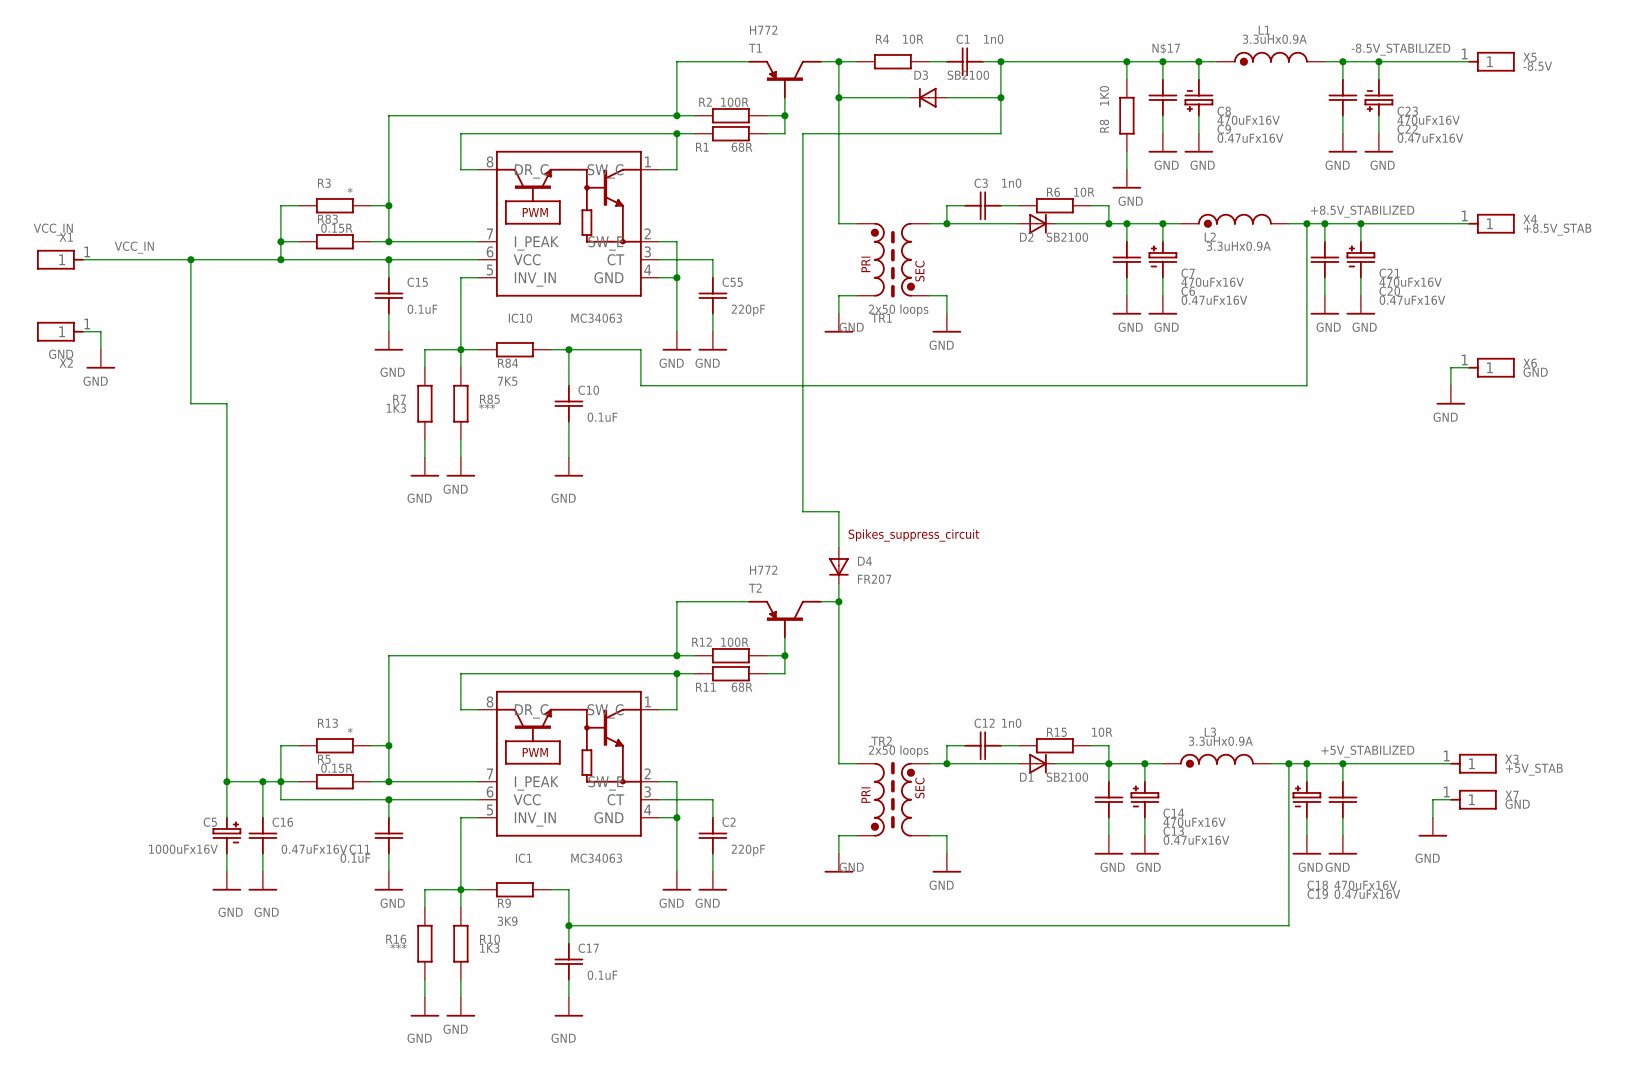
[picture p62: schematic LCMeter_test_power_inverter_VER2.sch]

Parts:
C1, C3, C12: 1n0; RSMD_0805
C2, C55: 220pF; RSMD_0805
C5: 1000uFx16V; CE_10MM
C6, C9, C13, C19, C20, C22: 0.47uFx16V; RSMD_1206_BIG_GAP
C7, C8, C14, C18, C21, C23: 470uFx16V; CE_10MM
C10, C11, C15, C17: 0.1uF; RSMD_0805
C16: 0.47uFx16V; RSMD_1206
D1, D2, D3: SB2100; DO-41_5MM
D4: FR207; DO-41_20MM
IC1, IC10: MC34063; DIP8
L1, L2, L3: 3.3uHx0.9A; L_SENIA
R1, R11: 68R; RSMD_0805
R2, R12: 100R; RSMD_0805
R3, R13: *; RSMD_1206_BIG_GAP
R4, R6, R15: 10R; RSMD_0805
R5, R83: 0.15R; RSMD_1206_BIG_GAP
R7, R10: 1K3; RSMD_0805
R8: 1K0; RSMD_1206_BIG_GAP
R9: 3K9; RSMD_0805
R16, R85: ***; RSMD_0805
R84: 7K5; RSMD_0805
T1, T2: H772; DPAK
TR1, TR2: 2x50 loops; RING_16X8_2WIND
X1: VCC_IN; PIN1X1_3.5MM_PWR
X2, X6, X7: GND; PIN1X1_3.5MM_PWR
X3: +5V_STAB; PIN1X1_3.5MM_PWR
X4: +8.5V_STAB; PIN1X1_3.5MM_PWR
X5: -8.5V; PIN1X1_3.5MM_PWR

Connections:
+5V_STABILIZED: C17.PAD_1 (PIN1), C18.PLUS, C19.PAD_1 (PIN1), L3.1 (END), R9.PAD_1 (PIN1), X3.1
+8.5V_STABILIZED: C10.PAD_1 (PIN1), C20.PAD_1 (PIN1), C21.PLUS, L2.1 (END), R84.PAD_1 (PIN1), X4.1
-8.5V_STABILIZED: C22.PAD_1 (PIN1), C23.MINUS, L1.1 (END), X5.1
GND: C2.PAD_0 (PIN0), C5.MINUS, C6.PAD_0 (PIN0), C7.MINUS, C8.PLUS, C9.PAD_0 (PIN0), C10.PAD_0 (PIN0), C11.PAD_0 (PIN0), C13.PAD_0 (PIN0), C14.MINUS, C15.PAD_0 (PIN0), C16.PAD_0 (PIN0), C17.PAD_0 (PIN0), C18.MINUS, C19.PAD_0 (PIN0), C20.PAD_0 (PIN0), C21.MINUS, C22.PAD_0 (PIN0), C23.PLUS, C55.PAD_0 (PIN0), IC1.2 (SW_E), IC1.4 (GND), IC10.2 (SW_E), IC10.4 (GND), R7.PAD_0 (PIN0), R8.PAD_1 (PIN1), R10.PAD_0 (PIN0), R16.PAD_0 (PIN0), R85.PAD_0 (PIN0), TR1.W1_END (PRI_END), TR1.W2_START (SEC_START), TR2.W1_START (PRI_START), TR2.W2_END (SEC_END), X2.1, X6.1, X7.1
unnamed: C3.PAD_0 (PIN0), R6.PAD_1 (PIN1)
unnamed: R1.PAD_1 (PIN1), R2.PAD_0 (PIN0), T1.1 (B)
unnamed: IC10.7 (I_PEAK), R2.PAD_1 (PIN1), R3.PAD_1 (PIN1), R83.PAD_1 (PIN1), T1.3 (E)
unnamed: D3.CATHODE, R4.PAD_1 (PIN1), T1.2 (C), TR1.W1_START (PRI_START)
unnamed: C1.PAD_1 (PIN1), R4.PAD_0 (PIN0)
unnamed: IC1.1 (SW_C), IC1.8 (DR_C), R11.PAD_0 (PIN0)
unnamed: C2.PAD_1 (PIN1), IC1.3 (CT)
unnamed: C3.PAD_1 (PIN1), D2.ANODE, TR1.W2_END (SEC_END)
unnamed: IC1.5 (INV_IN), R9.PAD_0 (PIN0), R10.PAD_1 (PIN1), R16.PAD_1 (PIN1)
unnamed: R11.PAD_1 (PIN1), R12.PAD_0 (PIN0), T2.1 (B)
unnamed: IC1.7 (I_PEAK), R5.PAD_1 (PIN1), R12.PAD_1 (PIN1), R13.PAD_1 (PIN1), T2.3 (E)
unnamed: D4.CATHODE, T2.2 (C), TR2.W1_END (PRI_END)
unnamed: C12.PAD_1 (PIN1), D1.ANODE, TR2.W2_START (SEC_START)
unnamed: C12.PAD_0 (PIN0), R15.PAD_1 (PIN1)
unnamed: C1.PAD_0 (PIN0), C8.MINUS, C9.PAD_1 (PIN1), D3.ANODE, D4.ANODE, L1.2 (START), R8.PAD_0 (PIN0)
unnamed: C13.PAD_1 (PIN1), C14.PLUS, D1.CATHODE, L3.2 (START), R15.PAD_0 (PIN0)
unnamed: C6.PAD_1 (PIN1), C7.PLUS, D2.CATHODE, L2.2 (START), R6.PAD_0 (PIN0)
unnamed: IC10.1 (SW_C), IC10.8 (DR_C), R1.PAD_0 (PIN0)
unnamed: C55.PAD_1 (PIN1), IC10.3 (CT)
unnamed: IC10.5 (INV_IN), R7.PAD_1 (PIN1), R84.PAD_0 (PIN0), R85.PAD_1 (PIN1)
VCC_IN: C5.PLUS, C11.PAD_1 (PIN1), C15.PAD_1 (PIN1), C16.PAD_1 (PIN1), IC1.6 (VCC), IC10.6 (VCC), R3.PAD_0 (PIN0), R5.PAD_0 (PIN0), R13.PAD_0 (PIN0), R83.PAD_0 (PIN0), X1.1

Notes on the sheet:
Spikes_suppress_circuit

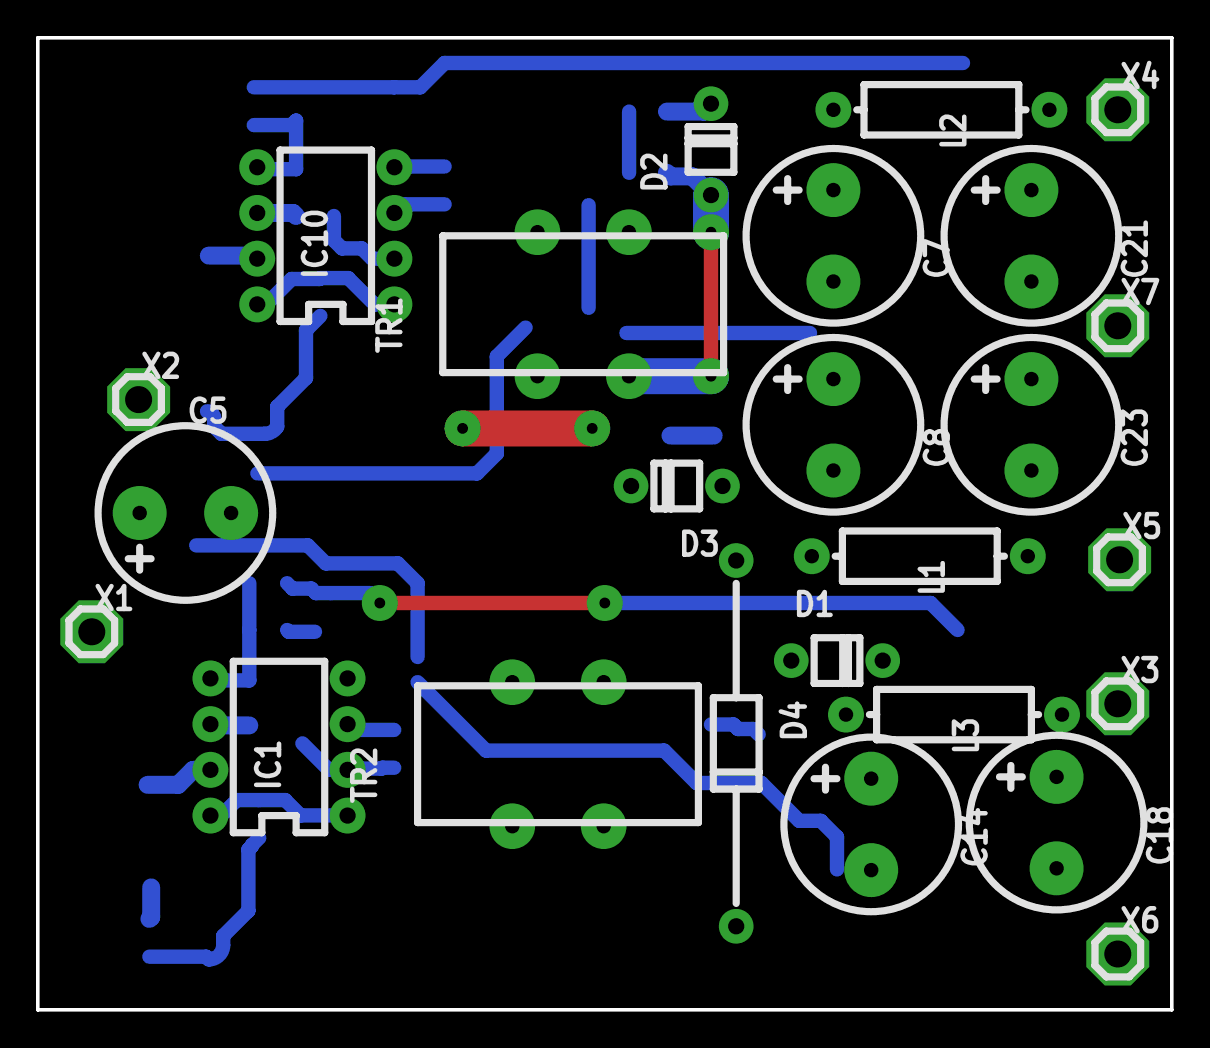
[picture p63: board LCMeter_test_power_inverter_VER2.brd from above]

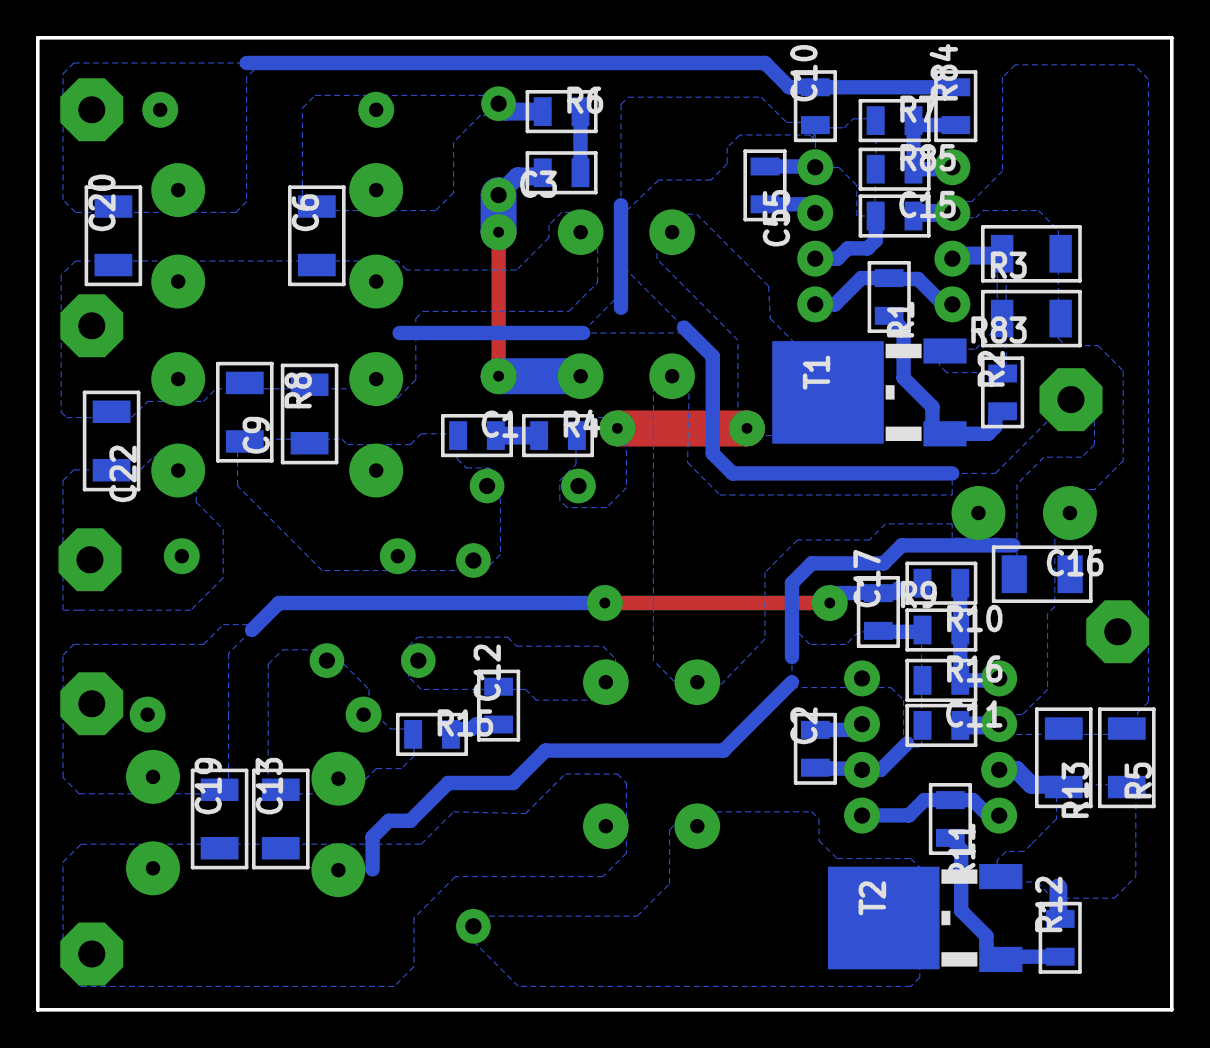
[picture p64: board LCMeter_test_power_inverter_VER2.brd from below]

Board: 2 copper layers, 63.0 x 54.0 mm, 61 parts (36 on the bottom side), 25 nets.
