InspectorColombo/ColomboProjects/L_Saturation_Meter/schematic/L_SaturationMeter.brd

## EAGLE design L_Saturation_Meter/schematic/L_SaturationMeter.brd (2023-02-25)

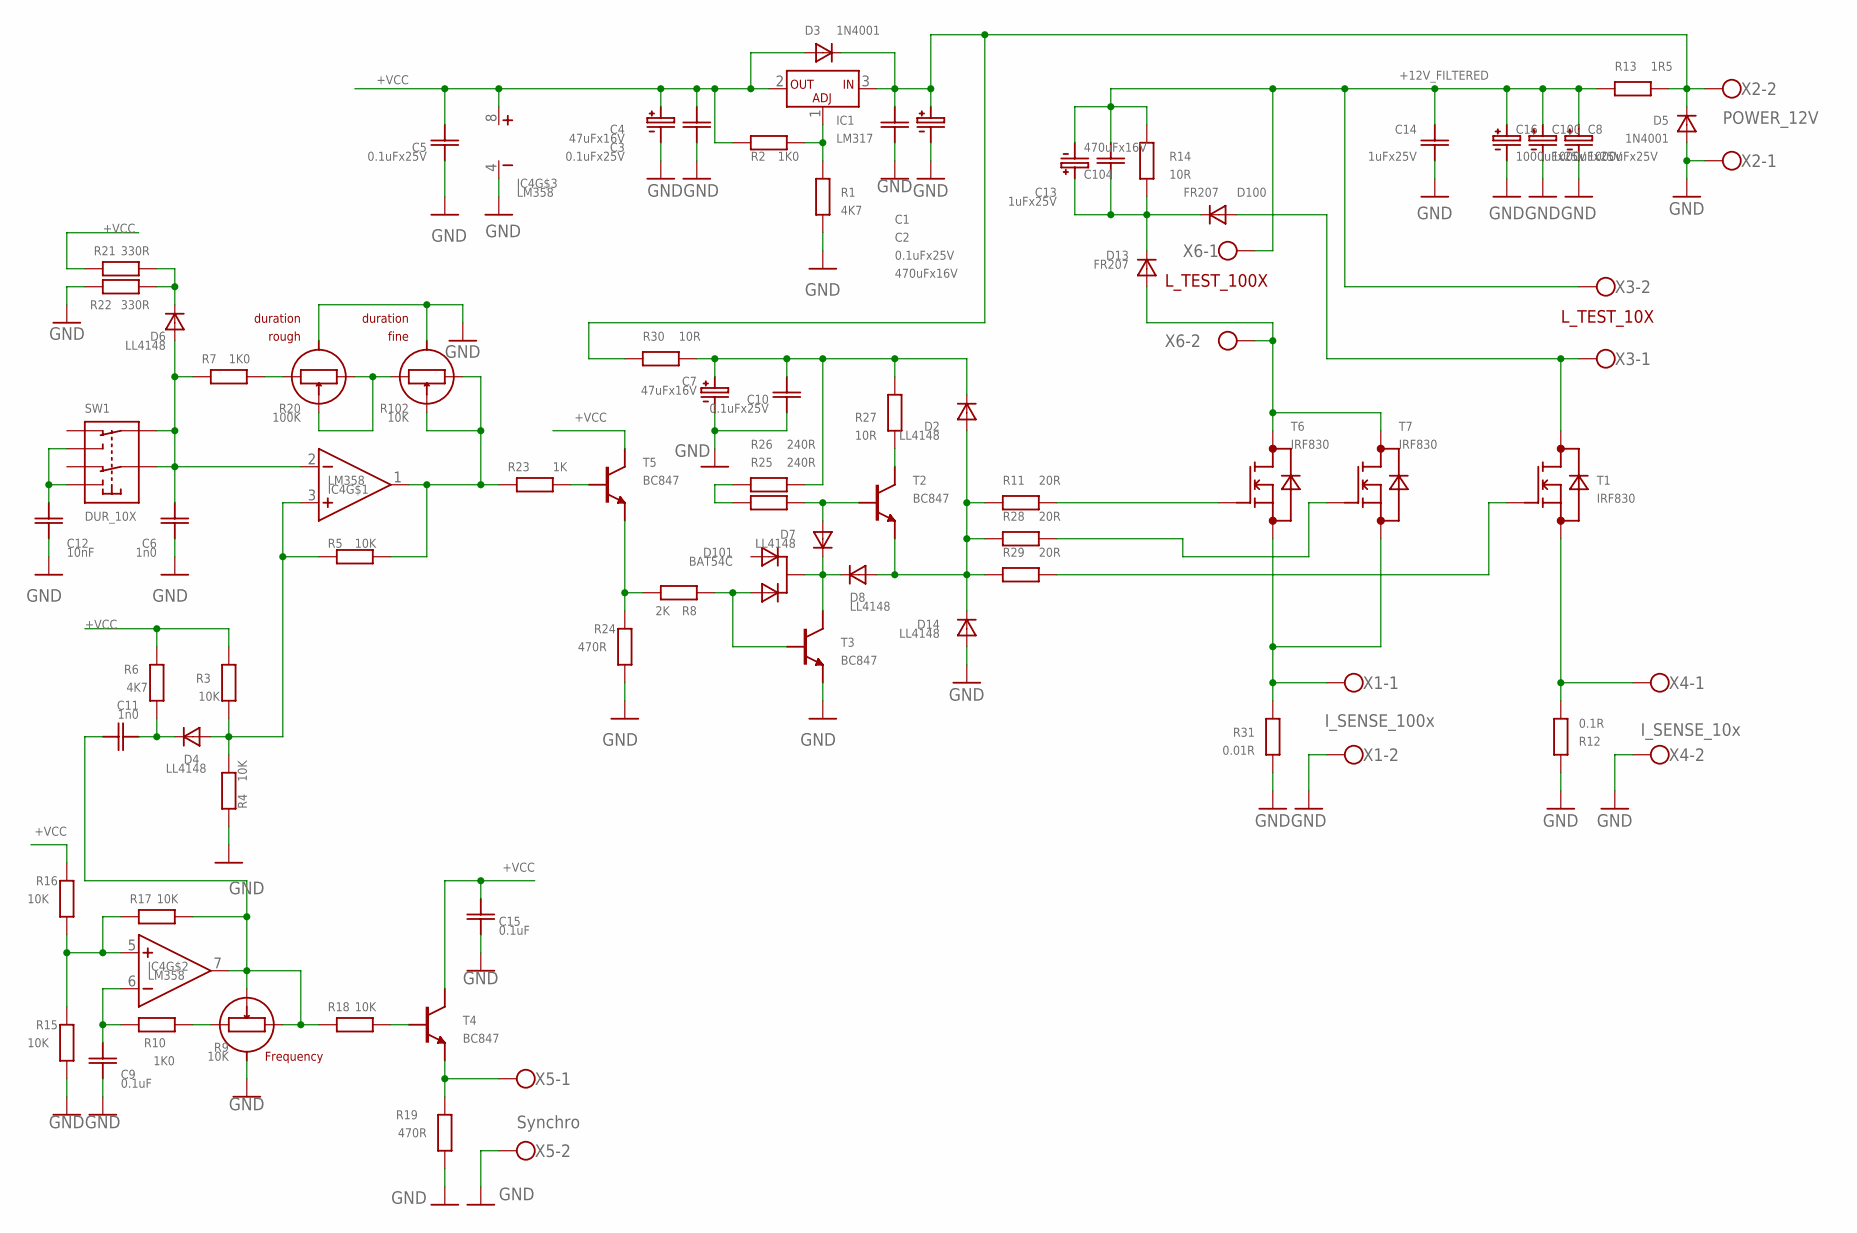
[picture p65: schematic L_SaturationMeter.sch]

Parts:
C1: 0.1uFx25V; RSMD_1206_BIG_GAP
C2, C104: 470uFx16V; CE_8.2MM
C3, C5, C10: 0.1uFx25V; RSMD_0805
C4, C7: 47uFx16V; CE_5.2MM
C6, C11: 1n0; RSMD_0805
C8, C16, C100: 1000uFx25V; CE_10MM
C9, C15: 0.1uF; RSMD_0805
C12: 10nF; RSMD_0805
C13, C14: 1uFx25V; RSMD_1206_BIG_GAP
D2, D4, D6, D7, D8, D14: LL4148; SOD-80
D3, D5: 1N4001; DO-41_15MM
D13: FR207; DO-41_5MM
D100: FR207; DO-41_20MM
D101: BAT54C; SOT23_SMALL_PADS
IC1: LM317; D2PAK
IC4: LM358; DIP8
R1, R6: 4K7; RSMD_0805
R2, R7, R10: 1K0; RSMD_0805
R3, R4, R5, R15, R16, R17, R18: 10K; RSMD_0805
R8: 2K; RSMD_0805
R9, R102: 10K; SP3-4AM
R11, R28, R29: 20R; RSMD_0805
R12: 0.1R; R_1.0W_VERTICAL
R13: 1R5; R_2.0W
R14: 10R; R_1.0W_VERTICAL
R19, R24: 470R; RSMD_1206_BIG_GAP
R20: 100K; SP3-4AM
R21, R22: 330R; RSMD_0805
R23: 1K; RSMD_1206_BIG_GAP
R25, R26: 240R; RSMD_1206_BIG_GAP
R27: 10R; RSMD_1206_BIG_GAP
R30: 10R; R_0.5W
R31: 0.01R; RSMD_2512
SW1: DUR_10X; SWITCH_DOUBLE_2.54X4.0MM
T1, T6, T7: IRF830; D2PAK
T2, T3, T4, T5: BC847; SOT23_SMALL_PADS
X1: I_SENSE_100x; W237-102; MPN 237-102
X2: POWER_12V; W237-102
X3: L_TEST_END; W237-102
X4: I_SENSE_10x; W237-102
X5: Synchro; W237-102; MPN 237-102
X6: L_TEST_END; W237-102; MPN 237-102

Connections:
+12V_FILTERED: C8.PLUS, C13.PAD_0 (PIN0), C14.PAD_0 (PIN0), C16.PLUS, C100.PLUS, C104.MINUS, R13.PAD1 (PIN1), R14.PAD1 (PIN1), X3.2, X6.1
+VCC: C3.PAD_0 (PIN0), C4.PLUS, C5.PAD_0 (PIN0), C15.PAD_0 (PIN0), D3.ANODE, IC1.2 (OUT), IC4.8 (VCC), R2.PAD_1 (PIN1), R3.PAD_1 (PIN1), R6.PAD_0 (PIN0), R16.PAD_1 (PIN1), R21.PAD_1 (PIN1), T4.3 (C), T5.3 (C)
GND: C1.PAD_1 (PIN1), C2.MINUS, C3.PAD_1 (PIN1), C4.MINUS, C5.PAD_1 (PIN1), C6.PAD_1 (PIN1), C7.MINUS, C8.MINUS, C9.PAD_1 (PIN1), C10.PAD_1 (PIN1), C12.PAD_1 (PIN1), C14.PAD_1 (PIN1), C15.PAD_1 (PIN1), C16.MINUS, C100.MINUS, D5.ANODE, D14.ANODE, IC4.4 (GND), R1.PAD_0 (PIN0), R4.PAD_1 (PIN1), R9.PACKAGE1 (PACKAGE), R9.PACKAGE2 (PACKAGE), R12.PAD1 (PIN1), R15.PAD_0 (PIN0), R19.PAD_1 (PIN1), R20.PACKAGE1 (PACKAGE), R20.PACKAGE2 (PACKAGE), R22.PAD_0 (PIN0), R24.PAD_1 (PIN1), R31.PAD0 (PIN0), R102.PACKAGE1 (PACKAGE), R102.PACKAGE2 (PACKAGE), T3.2 (E), X1.2, X2.1, X4.2, X5.2
unnamed: D7.ANODE, R25.PAD_1 (PIN1), T2.1 (B)
unnamed: R11.PAD_1 (PIN1), T6.1 (GATE)
unnamed: R12.PAD_0 (PIN0), T1.3 (SOURCE), X4.1
unnamed: C9.PAD_0 (PIN0), IC4.6 (IN-), R10.PAD_0 (PIN0)
unnamed: R9.END_A, R10.PAD_1 (PIN1)
unnamed: C13.PAD_1 (PIN1), C104.PLUS, D13.CATHODE, D100.CATHODE, R14.PAD_0 (PIN0)
unnamed: C6.PAD_0 (PIN0), D6.ANODE, IC4.2 (IN-), R7.PAD_1 (PIN1), SW1.CENTER1, SW1.CENTER2
unnamed: IC1.1 (ADJ), R1.PAD_1 (PIN1), R2.PAD_0 (PIN0)
unnamed: D100.ANODE, T1.2 (DRAIN), X3.1
unnamed: C1.PAD_0 (PIN0), C2.PLUS, D3.CATHODE, D5.CATHODE, IC1.3 (IN), R13.PAD_0 (PIN0), R30.PAD1 (PIN1), X2.2
unnamed: IC4.5 (IN+), R15.PAD_1 (PIN1), R16.PAD_0 (PIN0), R17.PAD_1 (PIN1)
unnamed: C11.PAD_1 (PIN1), IC4.7 (OUT), R9.END_B, R9.MIDDLE, R17.PAD_0 (PIN0), R18.PAD_1 (PIN1)
unnamed: D4.ANODE, IC4.3 (IN+), R3.PAD_0 (PIN0), R4.PAD_0 (PIN0), R5.PAD_1 (PIN1)
unnamed: R20.END_B, R20.MIDDLE, R102.END_A
unnamed: R25.PAD_0 (PIN0), R26.PAD_1 (PIN1)
unnamed: C11.PAD_0 (PIN0), D4.CATHODE, R6.PAD_1 (PIN1)
unnamed: R18.PAD_0 (PIN0), T4.1 (B)
unnamed: R19.PAD_0 (PIN0), T4.2 (E), X5.1
unnamed: D6.CATHODE, R21.PAD_0 (PIN0), R22.PAD_1 (PIN1)
unnamed: C12.PAD_0 (PIN0), SW1.POS_A1, SW1.POS_A2
unnamed: IC4.1 (OUT), R5.PAD_0 (PIN0), R23.PAD_1 (PIN1), R102.END_B, R102.MIDDLE
unnamed: R23.PAD_0 (PIN0), T5.1 (B)
unnamed: R8.PAD_0 (PIN0), R24.PAD_0 (PIN0), T5.2 (E)
unnamed: D101.2 (ANODE2), R8.PAD_1 (PIN1), T3.1 (B)
unnamed: D7.CATHODE, D8.CATHODE, D101.3 (CATHODE), T3.3 (C)
unnamed: R28.PAD_1 (PIN1), T7.1 (GATE)
unnamed: R27.PAD_1 (PIN1), T2.3 (C)
unnamed: D2.ANODE, D8.ANODE, D14.CATHODE, R11.PAD_0 (PIN0), R28.PAD_0 (PIN0), R29.PAD_0 (PIN0), T2.2 (E)
unnamed: R29.PAD_1 (PIN1), T1.1 (GATE)
unnamed: R31.PAD1 (PIN1), T6.3 (SOURCE), T7.3 (SOURCE), X1.1
unnamed: C7.PLUS, C10.PAD_0 (PIN0), D2.CATHODE, R26.PAD_0 (PIN0), R27.PAD_0 (PIN0), R30.PAD_0 (PIN0)
unnamed: D13.ANODE, T6.2 (DRAIN), T7.2 (DRAIN), X6.2
unnamed: R7.PAD_0 (PIN0), R20.END_A

Notes on the sheet:
L_TEST_10X
Frequency
duration
fine
rough
L_TEST_100X

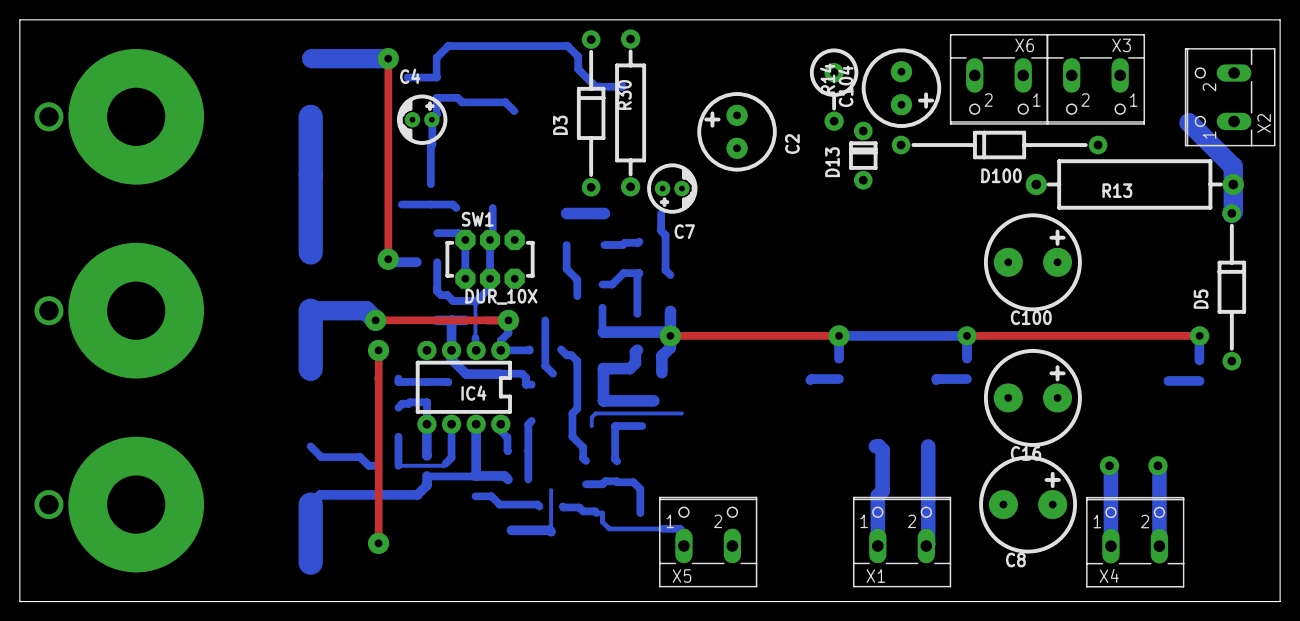
[picture p66: board L_SaturationMeter.brd from above]

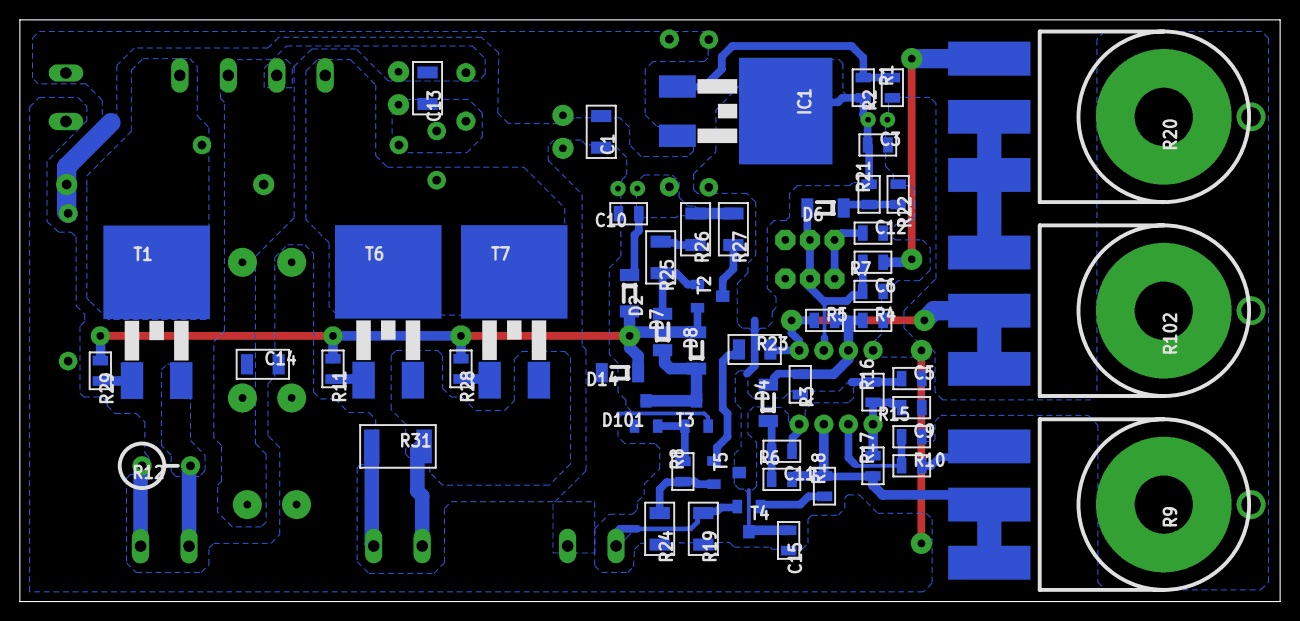
[picture p67: board L_SaturationMeter.brd from below]

Board: 2 copper layers, 130.0 x 60.0 mm, 77 parts (55 on the bottom side), 36 nets.
