InspectorColombo/ColomboProjects/SPS12V_CurrentStabilizer/Schematic/CurrentStabilizer_VER3.brd

## EAGLE design SPS12V_CurrentStabilizer/Schematic/CurrentStabilizer_VER3.brd (2022-09-03)

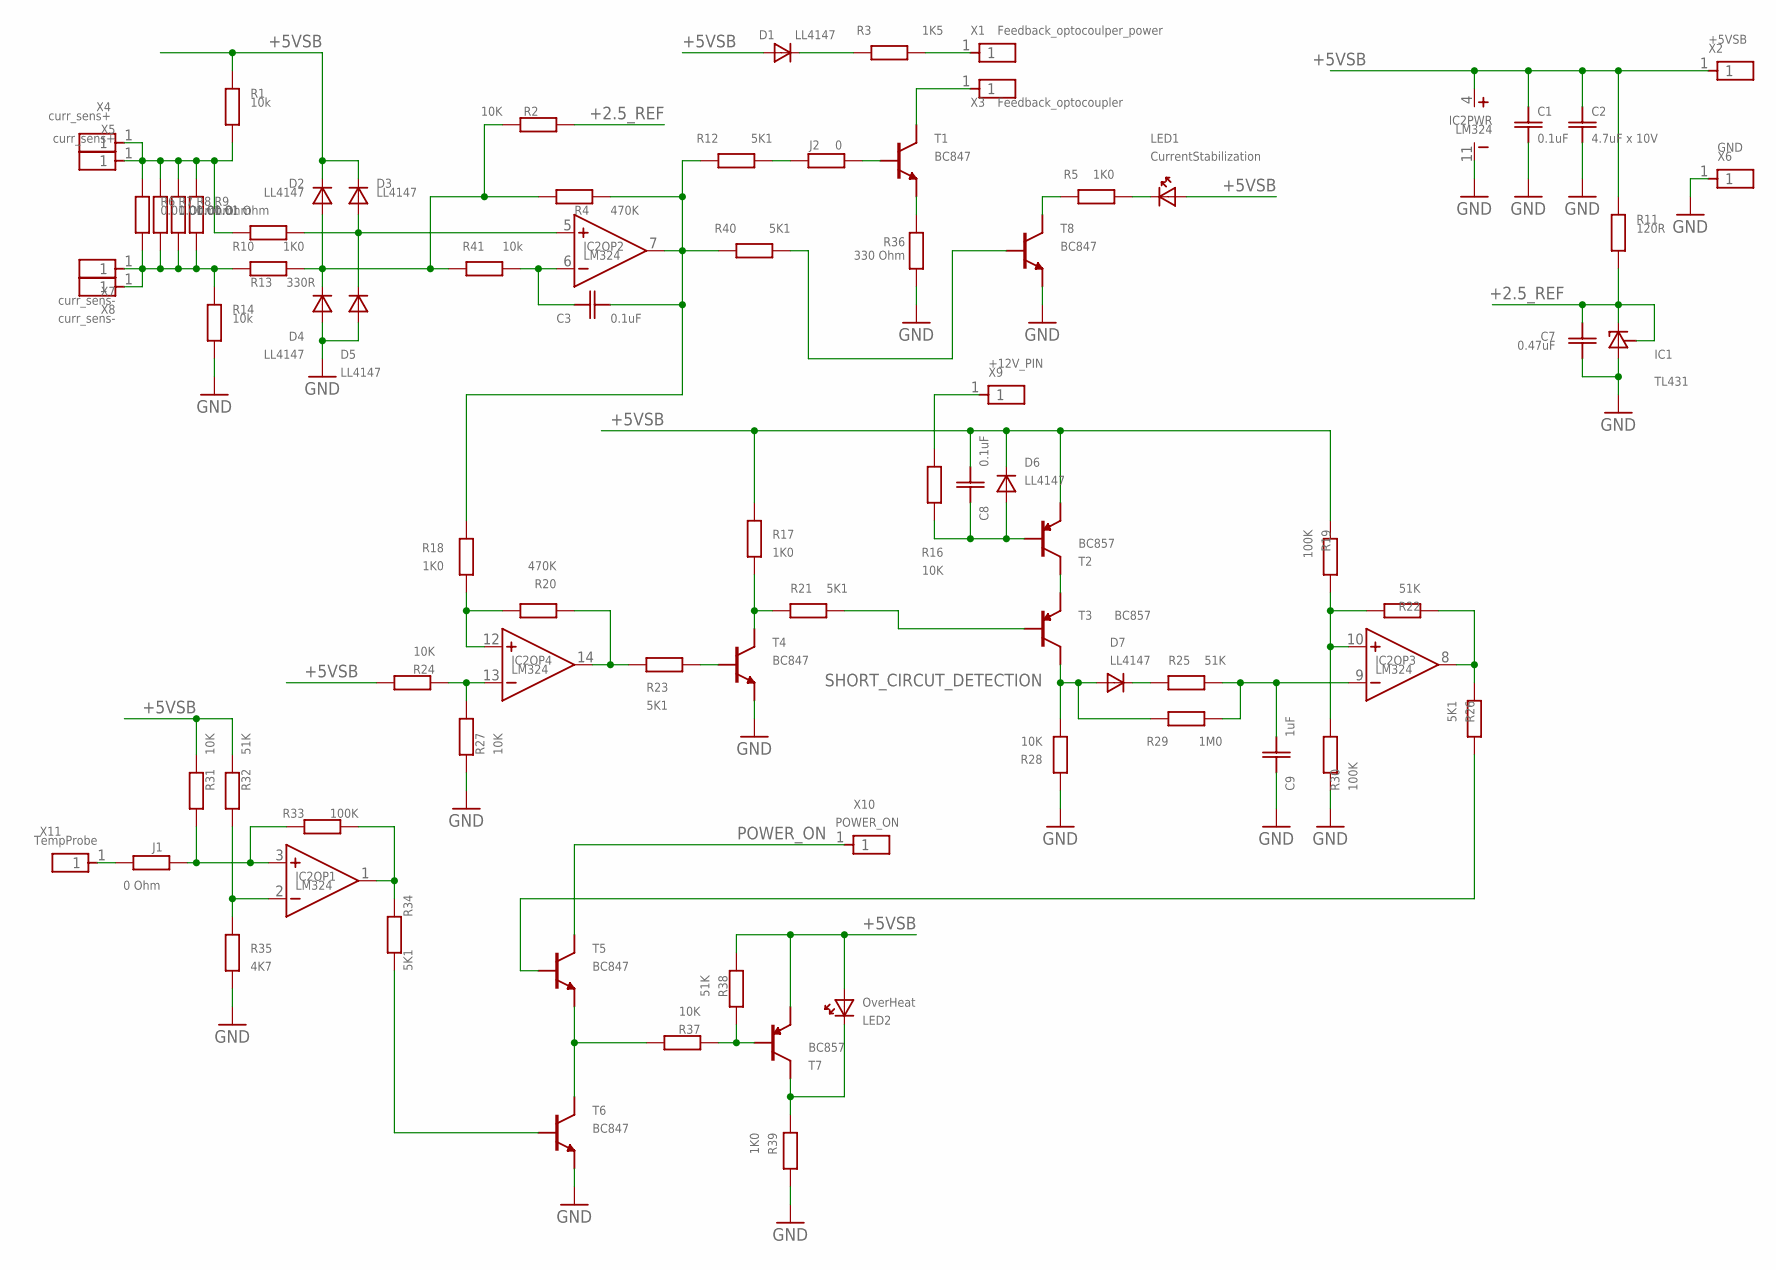
[picture p68: schematic CurrentStabilizer_VER3.sch]

Parts:
C1, C3, C8: 0.1uF; RSMD_0805
C2: 4.7uF x 10V; RSMD_1206
C7: 0.47uF; RSMD_0805
C9: 1uF; RSMD_0805
D1, D2, D3, D4, D5, D6, D7: LL4147; SOD-80
IC1: TL431; SOT23
IC2: LM324; SOIC14
J1: 0 Ohm; RSMD_0805
J2: 0; RSMD_0805
LED1: CurrentStabilization; LED3MM
LED2: OverHeat; LED3MM
R1, R14, R41: 10k; RSMD_0805
R2, R16, R24, R27, R28, R31: 10K; RSMD_0805
R3: 1K5; RSMD_0805
R4, R20: 470K; RSMD_0805
R5, R10, R17, R18, R39: 1K0; RSMD_0805
R6, R7, R8, R9: 0.01 Ohm; RSMD_2512
R11: 120R; RSMD_0805
R12, R21, R26, R34, R40: 5K1; RSMD_0805
R13: 330R; RSMD_0805
R19: 100K; RSMD_1206_BIG_GAP
R22, R25, R32, R38: 51K; RSMD_0805
R23: 5K1; RSMD_1206_BIG_GAP
R29: 1M0; RSMD_0805
R30, R33: 100K; RSMD_0805
R35: 4K7; RSMD_0805
R36: 330 Ohm; RSMD_0805
R37: 10K; RSMD_1206_BIG_GAP
T1, T4, T5, T6, T8: BC847; SOT23_SMALL_PADS
T2, T3, T7: BC857; SOT23_SMALL_PADS
X1: Feedback_optocoulper_power; PIN1X1_2.54MM
X2: +5VSB; PIN1X1_2.54MM
X3: Feedback_optocoupler; PIN1X1_2.54MM
X4, X5: curr_sens+; PIN1X1_2.54MM
X6: GND; PIN1X1_2.54MM
X7, X8: curr_sens-; PIN1X1_2.54MM
X9: +12V_PIN; PIN1X1_2.54MM
X10: POWER_ON; PIN1X1_2.54MM
X11: TempProbe; PIN1X1_2.54MM

Connections:
+2.5_REF: C7.PAD_1 (PIN1), IC1.1 (CATHODE), IC1.2 (REFERENCE), R2.PAD_0 (PIN0), R11.PAD_0 (PIN0)
+5VSB: C1.PAD_1 (PIN1), C2.PAD_1 (PIN1), C8.PAD_0 (PIN0), D1.ANODE, D2.CATHODE, D3.CATHODE, D6.CATHODE, IC2.4 (VCC), LED1.ANODE, LED2.ANODE, R1.PAD_1 (PIN1), R11.PAD_1 (PIN1), R17.PAD_0 (PIN0), R19.PAD_0 (PIN0), R24.PAD_1 (PIN1), R31.PAD_1 (PIN1), R32.PAD_1 (PIN1), R38.PAD_0 (PIN0), T2.2 (E), T7.2 (E), X2.1
GND: C1.PAD_0 (PIN0), C2.PAD_0 (PIN0), C7.PAD_0 (PIN0), C9.PAD_1 (PIN1), D4.ANODE, D5.ANODE, IC1.3 (ANODE), IC2.11 (GND), R14.PAD_0 (PIN0), R27.PAD_0 (PIN0), R28.PAD_1 (PIN1), R30.PAD_0 (PIN0), R35.PAD_0 (PIN0), R36.PAD_0 (PIN0), R39.PAD_1 (PIN1), T4.2 (E), T6.2 (E), T8.2 (E), X6.1
unnamed: R1.PAD_0 (PIN0), R6.PAD1 (PIN1), R7.PAD1 (PIN1), R8.PAD1 (PIN1), R9.PAD1 (PIN1), R10.PAD_0 (PIN0), X4.1, X5.1
unnamed: R6.PAD0 (PIN0), R7.PAD0 (PIN0), R8.PAD0 (PIN0), R9.PAD0 (PIN0), R13.PAD_0 (PIN0), R14.PAD_1 (PIN1), X7.1, X8.1
unnamed: D3.ANODE, D5.CATHODE, IC2.5 (IN+), R10.PAD_1 (PIN1)
unnamed: D2.ANODE, D4.CATHODE, R2.PAD_1 (PIN1), R4.PAD_0 (PIN0), R13.PAD_1 (PIN1), R41.PAD_1 (PIN1)
unnamed: IC2.12 (IN+), R18.PAD_0 (PIN0), R20.PAD_0 (PIN0)
unnamed: IC2.3 (IN+), J1.PAD_0 (PIN0), R31.PAD_0 (PIN0), R33.PAD_1 (PIN1)
unnamed: R5.PAD_1 (PIN1), T8.3 (C)
unnamed: R23.PAD_0 (PIN0), T4.1 (B)
unnamed: D1.CATHODE, R3.PAD_1 (PIN1)
unnamed: T1.3 (C), X3.1
unnamed: IC2.14 (OUT), R20.PAD_1 (PIN1), R23.PAD_1 (PIN1)
unnamed: R17.PAD_1 (PIN1), R21.PAD_0 (PIN0), T4.3 (C)
unnamed: R37.PAD_0 (PIN0), R38.PAD_1 (PIN1), T7.1 (B)
unnamed: R36.PAD_1 (PIN1), T1.2 (E)
unnamed: IC2.2 (IN-), R32.PAD_0 (PIN0), R35.PAD_1 (PIN1)
unnamed: IC2.1 (OUT), R33.PAD_0 (PIN0), R34.PAD_1 (PIN1)
unnamed: R34.PAD_0 (PIN0), T6.1 (B)
unnamed: J2.PAD_0 (PIN0), T1.1 (B)
unnamed: C8.PAD_1 (PIN1), D6.ANODE, R16.PAD_1 (PIN1), T2.1 (B)
unnamed: R16.PAD_0 (PIN0), X9.1
unnamed: T2.3 (C), T3.2 (E)
unnamed: R21.PAD_1 (PIN1), T3.1 (B)
unnamed: D7.CATHODE, R25.PAD_0 (PIN0)
unnamed: C9.PAD_0 (PIN0), IC2.9 (IN-), R25.PAD_1 (PIN1), R29.PAD_0 (PIN0)
unnamed: IC2.10 (IN+), R19.PAD_1 (PIN1), R22.PAD_1 (PIN1), R30.PAD_1 (PIN1)
unnamed: IC2.8 (OUT), R22.PAD_0 (PIN0), R26.PAD_0 (PIN0)
unnamed: R26.PAD_1 (PIN1), T5.1 (B)
unnamed: R37.PAD_1 (PIN1), T5.2 (E), T6.3 (C)
unnamed: IC2.13 (IN-), R24.PAD_0 (PIN0), R27.PAD_1 (PIN1)
unnamed: C3.PAD_0 (PIN0), IC2.7 (OUT), R4.PAD_1 (PIN1), R12.PAD_1 (PIN1), R18.PAD_1 (PIN1), R40.PAD_1 (PIN1)
unnamed: R3.PAD_0 (PIN0), X1.1
unnamed: J1.PAD_1 (PIN1), X11.1
unnamed: J2.PAD_1 (PIN1), R12.PAD_0 (PIN0)
unnamed: LED2.CATHODE, R39.PAD_0 (PIN0), T7.3 (C)
unnamed: LED1.CATHODE, R5.PAD_0 (PIN0)
unnamed: R40.PAD_0 (PIN0), T8.1 (B)
unnamed: C3.PAD_1 (PIN1), IC2.6 (IN-), R41.PAD_0 (PIN0)
POWER_ON: T5.3 (C), X10.1
SHORT_CIRCUT_DETECTION: D7.ANODE, R28.PAD_0 (PIN0), R29.PAD_1 (PIN1), T3.3 (C)

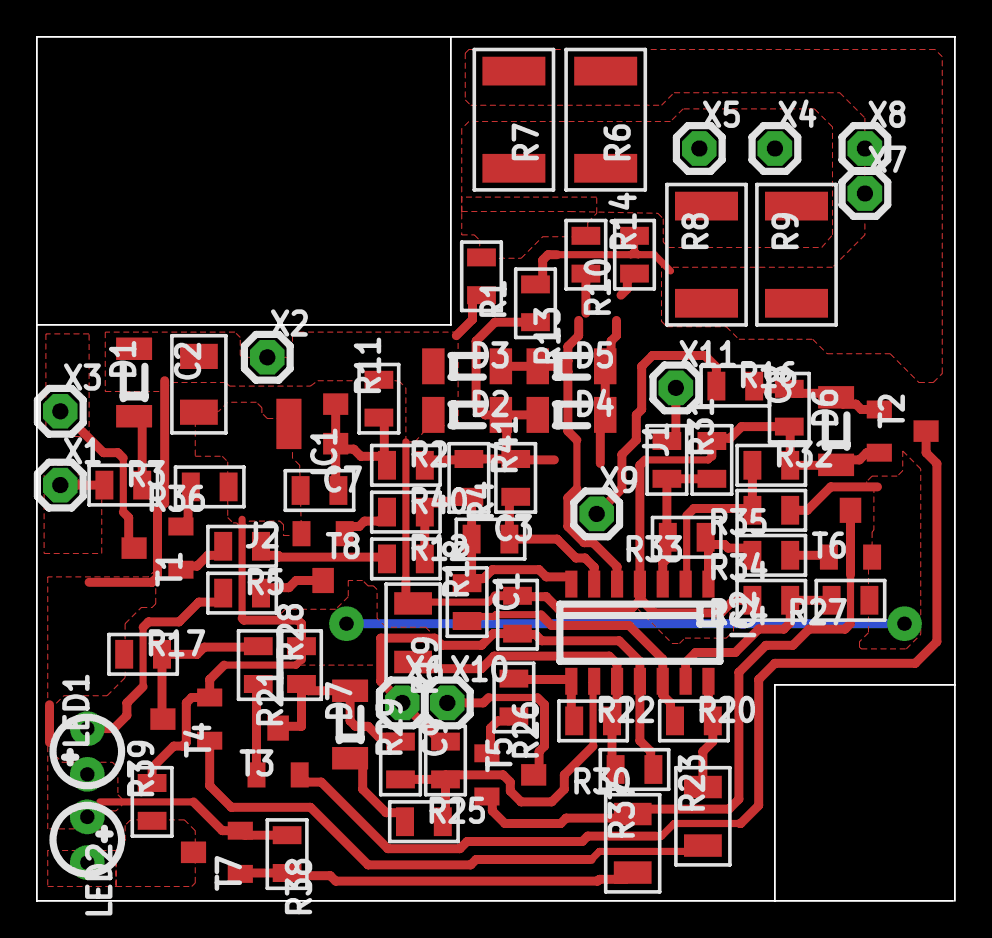
[picture p69: board CurrentStabilizer_VER3.brd from above]

Board: 2 copper layers, 51.0 x 48.0 mm, 78 parts (0 on the bottom side), 42 nets.
