InspectorColombo/ColomboProjects/PonyProg_serial/PonyProg_ver1.brd

## EAGLE design PonyProg_serial/PonyProg_ver1.brd (2022-08-27)

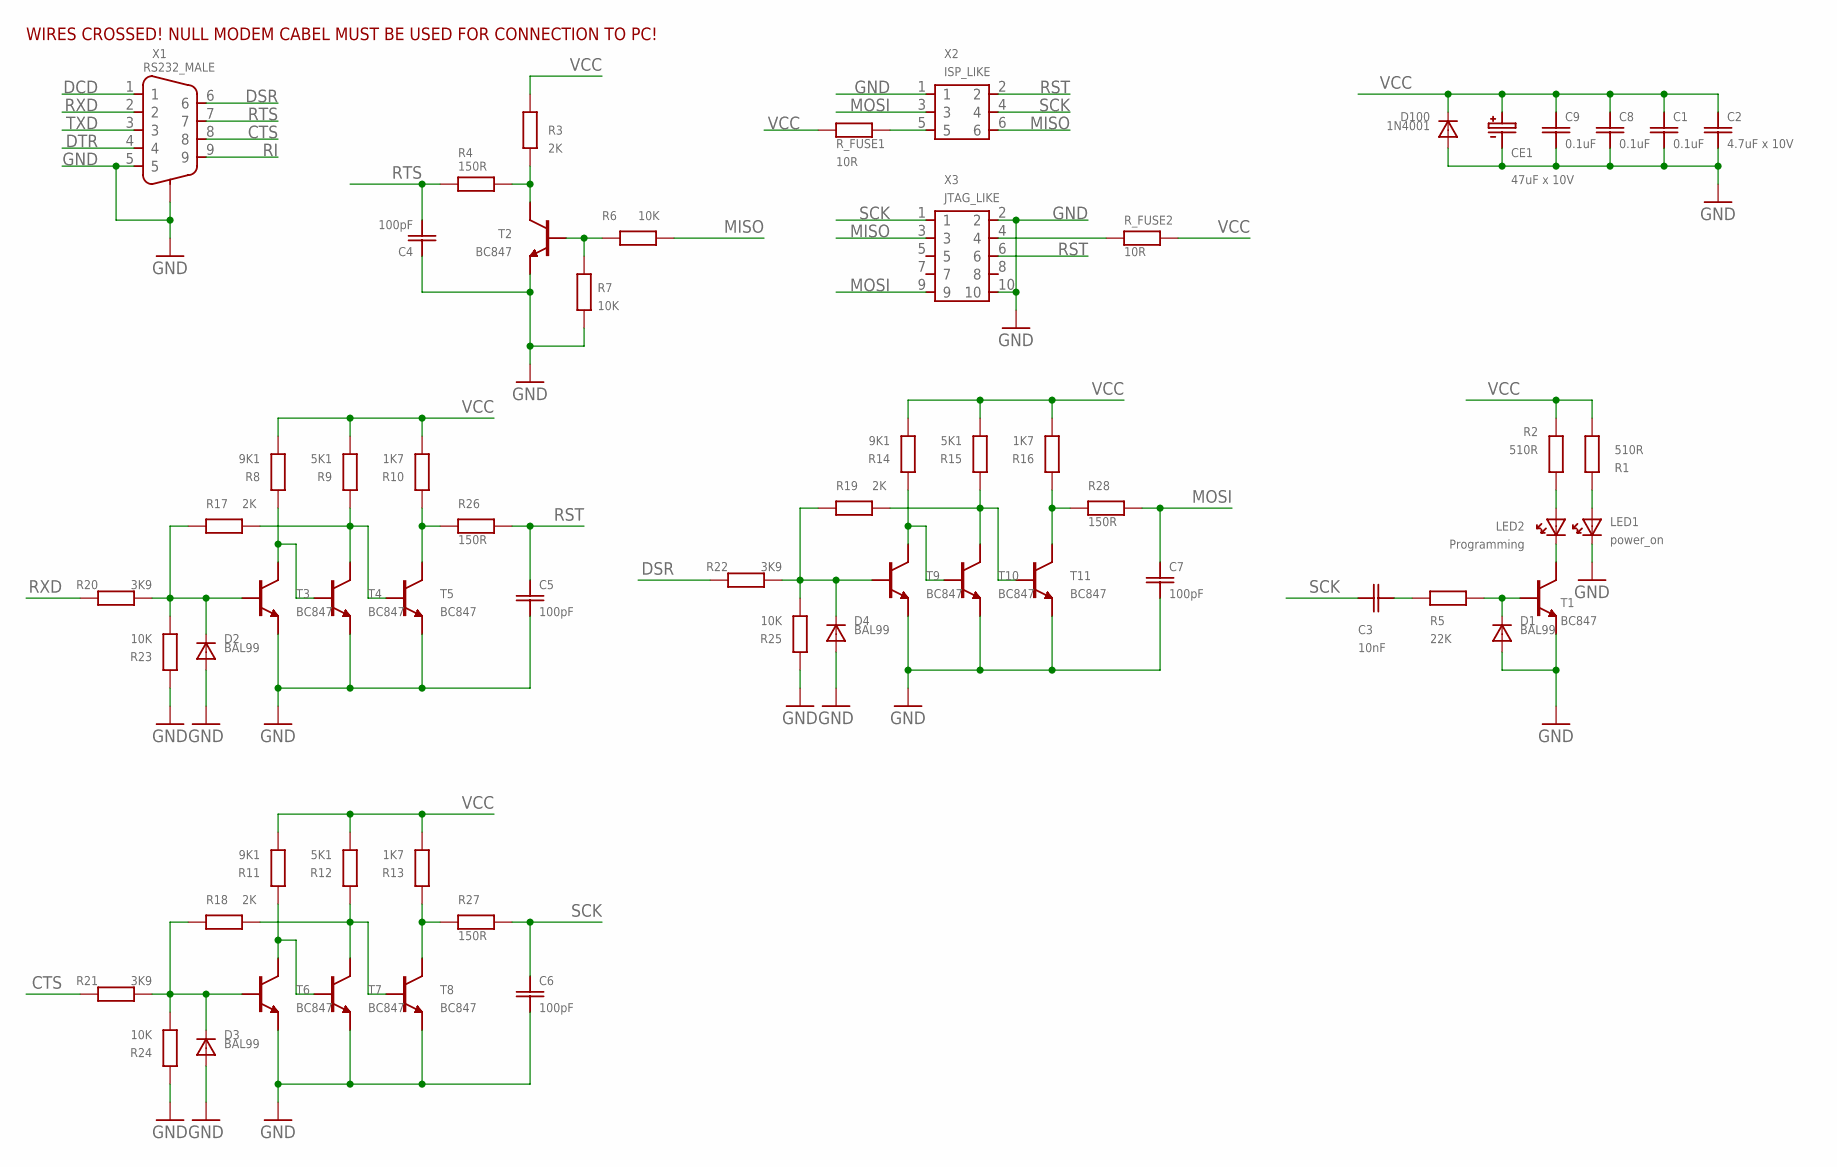
[picture p70: schematic PonyProg_ver1.sch]

Parts:
C1, C8, C9: 0.1uF; RSMD_0805
C2: 4.7uF x 10V; RSMD_1206
C3: 10nF; RSMD_0805
C4, C5, C6, C7: 100pF; RSMD_0805
CE1: 47uF x 10V; CE_6.3MM
D1, D2, D3, D4: BAL99; SOT23_SMALL_PADS
D100: 1N4001; DO-41_20MM
LED1: power_on; LED3MM
LED2: Programming; LED3MM
R1, R2: 510R; RSMD_0805
R3: 2K; RSMD_1206
R4, R26, R27, R28: 150R; RSMD_0805
R5: 22K; RSMD_0805
R6: 10K; RSMD_1206
R7, R23, R24, R25: 10K; RSMD_0805
R8, R11, R14: 9K1; RSMD_1206
R9, R12, R15: 5K1; RSMD_0805
R10, R13, R16: 1K7; RSMD_0805
R17, R18, R19: 2K; RSMD_0805
R20, R21, R22: 3K9; RSMD_0805
R_FUSE1, R_FUSE2: 10R; R0207
T1, T2, T3, T4, T5, T6, T7, T8, T9, T10, T11: BC847; SOT23_SMALL_PADS
X1: RS232_MALE; DSUB9_RA_MALE
X2: ISP_LIKE; PIN2X3_2.54MM
X3: JTAG_LIKE; PIN2X5_2.54MM

Connections:
CTS: R21.PAD_1 (PIN1), X1.8
DCD: X1.1
DSR: R22.PAD_1 (PIN1), X1.6
DTR: X1.4
GND: C1.PAD_0 (PIN0), C2.PAD_0 (PIN0), C4.PAD_1 (PIN1), C5.PAD_0 (PIN0), C6.PAD_0 (PIN0), C7.PAD_0 (PIN0), C8.PAD_0 (PIN0), C9.PAD_0 (PIN0), CE1.-, D1.3 (ANODE), D2.3 (ANODE), D3.3 (ANODE), D4.3 (ANODE), D100.ANODE, LED1.CATHODE, R7.PAD_0 (PIN0), R23.PAD_1 (PIN1), R24.PAD_1 (PIN1), R25.PAD_1 (PIN1), T1.2 (E), T2.2 (E), T3.2 (E), T4.2 (E), T5.2 (E), T6.2 (E), T7.2 (E), T8.2 (E), T9.2 (E), T10.2 (E), T11.2 (E), X1.5, X1.PACKAGE1, X1.PACKAGE2 (PACKAGE1), X2.1, X3.2, X3.10
MISO: R6.PAD_1 (PIN1), X2.6, X3.3
MOSI: C7.PAD_1 (PIN1), R28.PAD_0 (PIN0), X2.3, X3.9
unnamed: D3.2 (CATHODE), R18.PAD_1 (PIN1), R21.PAD_0 (PIN0), R24.PAD_0 (PIN0), T6.1 (B)
unnamed: R11.PAD_1 (PIN1), T6.3 (C), T7.1 (B)
unnamed: R12.PAD_1 (PIN1), R18.PAD_0 (PIN0), T7.3 (C), T8.1 (B)
unnamed: D2.2 (CATHODE), R17.PAD_1 (PIN1), R20.PAD_0 (PIN0), R23.PAD_0 (PIN0), T3.1 (B)
unnamed: C3.PAD_0 (PIN0), R5.PAD_0 (PIN0)
unnamed: D1.2 (CATHODE), R5.PAD_1 (PIN1), T1.1 (B)
unnamed: R8.PAD_1 (PIN1), T3.3 (C), T4.1 (B)
unnamed: R9.PAD_1 (PIN1), R17.PAD_0 (PIN0), T4.3 (C), T5.1 (B)
unnamed: LED1.ANODE, R1.PAD_1 (PIN1)
unnamed: LED2.ANODE, R2.PAD_1 (PIN1)
unnamed: D4.2 (CATHODE), R19.PAD_1 (PIN1), R22.PAD_0 (PIN0), R25.PAD_0 (PIN0), T9.1 (B)
unnamed: R14.PAD_1 (PIN1), T9.3 (C), T10.1 (B)
unnamed: R15.PAD_1 (PIN1), R19.PAD_0 (PIN0), T10.3 (C), T11.1 (B)
unnamed: R10.PAD_1 (PIN1), R26.PAD_1 (PIN1), T5.3 (C)
unnamed: R13.PAD_1 (PIN1), R27.PAD_1 (PIN1), T8.3 (C)
unnamed: LED2.CATHODE, T1.3 (C)
unnamed: R6.PAD_0 (PIN0), R7.PAD_1 (PIN1), T2.1 (B)
unnamed: R3.PAD_0 (PIN0), R4.PAD_0 (PIN0), T2.3 (C)
unnamed: R16.PAD_1 (PIN1), R28.PAD_1 (PIN1), T11.3 (C)
unnamed: R_FUSE2.PAD_0 (PIN0), X3.4
unnamed: R_FUSE1.PAD1 (PIN1), X2.5
RI: X1.9
RST: C5.PAD_1 (PIN1), R26.PAD_0 (PIN0), X2.2, X3.6
RTS: C4.PAD_0 (PIN0), R4.PAD_1 (PIN1), X1.7
RXD: R20.PAD_1 (PIN1), X1.2
SCK: C3.PAD_1 (PIN1), C6.PAD_1 (PIN1), R27.PAD_0 (PIN0), X2.4, X3.1
TXD: X1.3
VCC: C1.PAD_1 (PIN1), C2.PAD_1 (PIN1), C8.PAD_1 (PIN1), C9.PAD_1 (PIN1), CE1.+, D100.CATHODE, R1.PAD_0 (PIN0), R2.PAD_0 (PIN0), R3.PAD_1 (PIN1), R8.PAD_0 (PIN0), R9.PAD_0 (PIN0), R10.PAD_0 (PIN0), R11.PAD_0 (PIN0), R12.PAD_0 (PIN0), R13.PAD_0 (PIN0), R14.PAD_0 (PIN0), R15.PAD_0 (PIN0), R16.PAD_0 (PIN0), R_FUSE1.PAD_0 (PIN0), R_FUSE2.PAD1 (PIN1)

Notes on the sheet:
WIRES CROSSED! NULL MODEM CABEL MUST BE USED FOR CONNECTION TO PC!

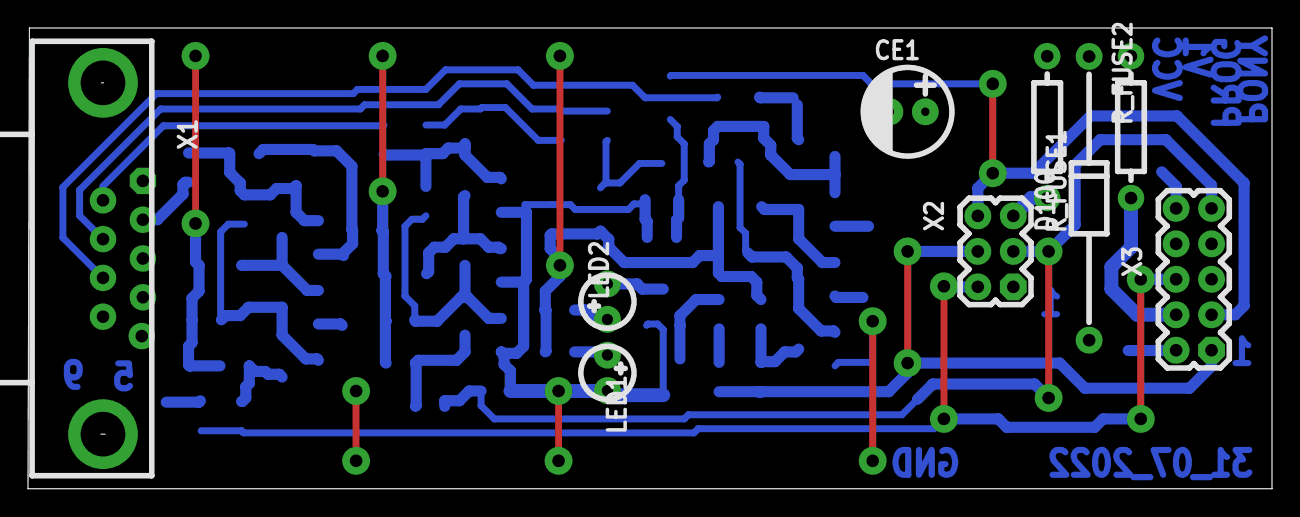
[picture p71: board PonyProg_ver1.brd from above]

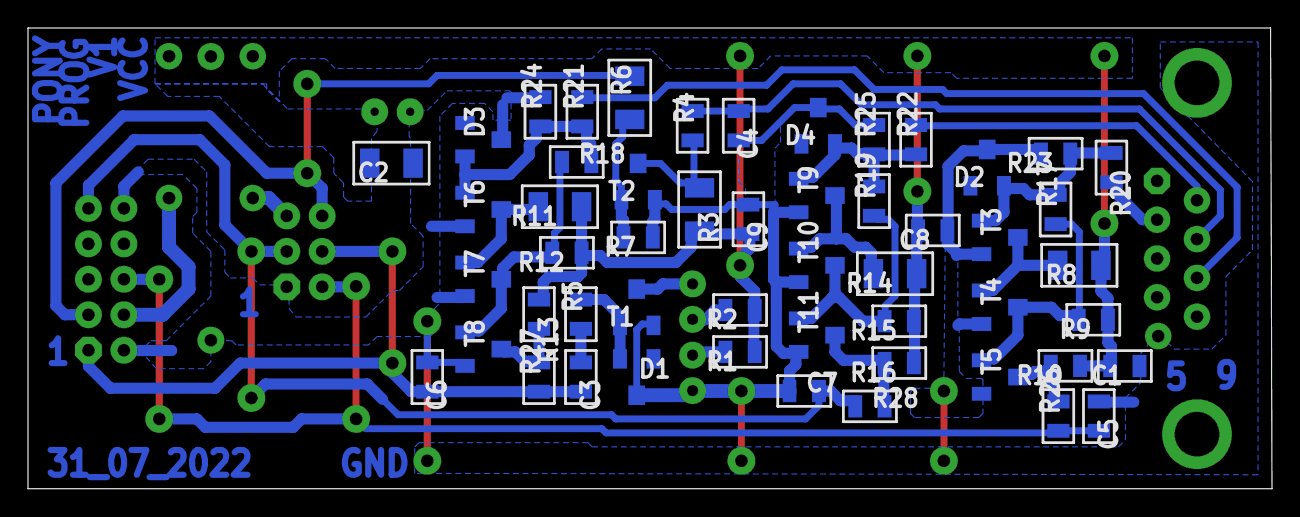
[picture p72: board PonyProg_ver1.brd from below]

Board: 2 copper layers, 89.1 x 33.0 mm, 61 parts (52 on the bottom side), 31 nets.
