InspectorColombo/ColomboProjects/USBASP_M8535/schematic/USBASP_M8535.brd

## EAGLE design USBASP_M8535/schematic/USBASP_M8535.brd (2022-08-27)

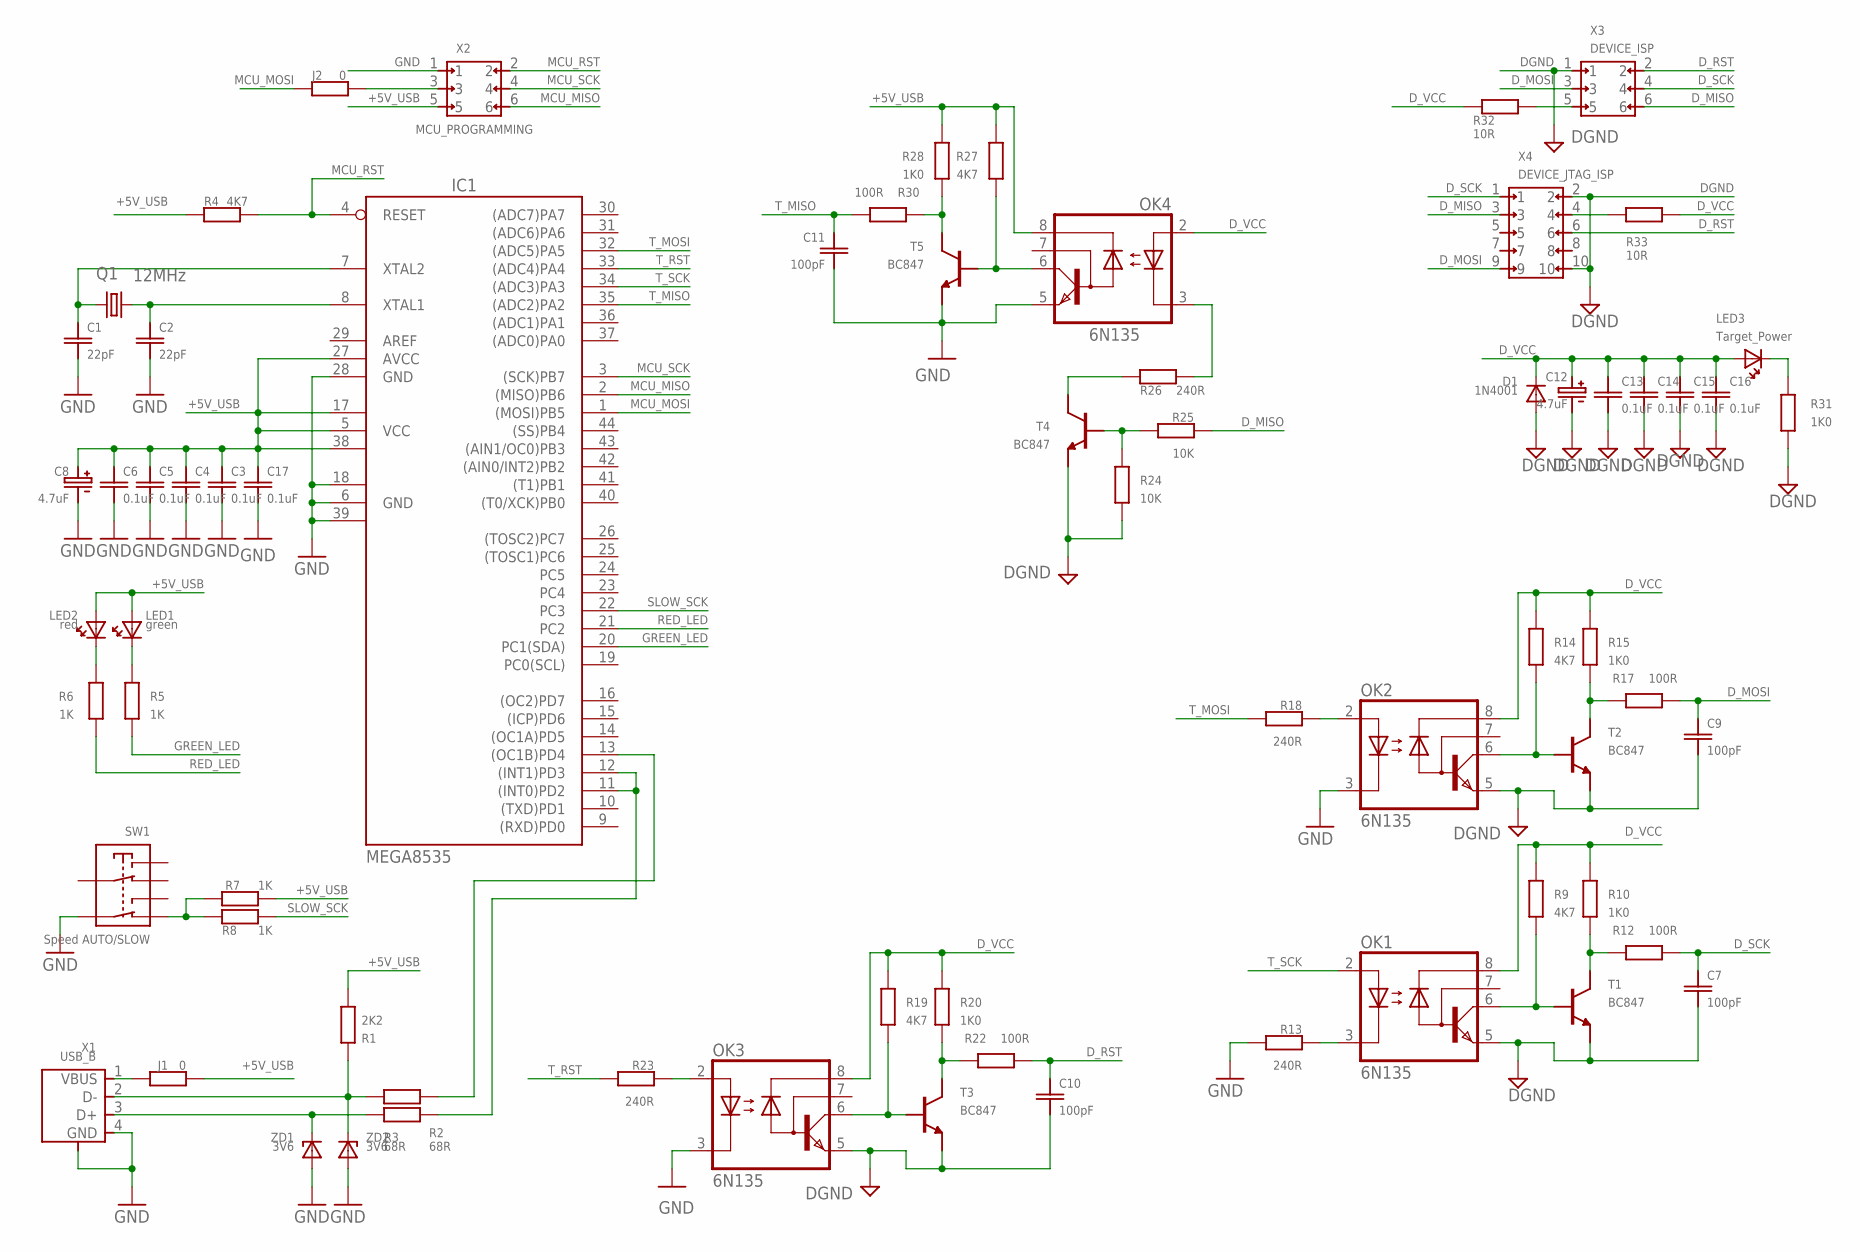
[picture p73: schematic USBASP_M8535.sch]

Parts:
C1, C2: 22pF; RSMD_0805
C3, C4, C5, C6, C13, C14, C15, C16, C17: 0.1uF; RSMD_0805
C7, C9, C10, C11: 100pF; RSMD_0805
C8, C12: 4.7uF; CE_6.3MM
D1: 1N4001; DO-41_10MM
IC1: MEGA8535; TQFP44
J1, J2: 0; RSMD_1206
LED1: green; LED3MM
LED2: red; LED3MM
LED3: Target_Power; LED3MM
OK1, OK2, OK3, OK4: 6N135; DIL08
Q1: 12MHz; HC49U-V
R1: 2K2; RSMD_0805
R2, R3: 68R; RSMD_1206
R4, R9, R14, R19, R27: 4K7; RSMD_0805
R5, R6, R7: 1K; RSMD_0805
R8: 1K; RSMD_1206
R10, R15, R20, R28, R31: 1K0; RSMD_0805
R12, R17, R22, R30: 100R; RSMD_0805
R13, R18, R23, R26: 240R; RSMD_0805
R24, R25: 10K; RSMD_0805
R32, R33: 10R; R0207
SW1: Speed AUTO/SLOW; SWITCH_DOUBLE_2.54X4.0MM
T1, T2, T3, T4, T5: BC847; SOT23_SMALL_PADS
X1: USB_B; USB_TYPE_B
X2: MCU_PROGRAMMING; PIN2X3_2.54MM
X3: DEVICE_ISP; PIN2X3_2.54MM
X4: DEVICE_JTAG_ISP; PIN2X5_2.54MM
ZD1, ZD2: 3V6; SOD-80

Connections:
+5V_USB: C3.PAD_1 (PIN1), C4.PAD_1 (PIN1), C5.PAD_1 (PIN1), C6.PAD_1 (PIN1), C8.+, C17.PAD_1 (PIN1), IC1.5 (VCC), IC1.17 (VCC1), IC1.27 (AVCC), IC1.38 (VCC2), J1.PAD_0 (PIN0), LED1.ANODE, LED2.ANODE, OK4.8 (VCC), R1.PAD_0 (PIN0), R4.PAD_0 (PIN0), R7.PAD_0 (PIN0), R27.PAD_0 (PIN0), R28.PAD_0 (PIN0), X2.5
DGND: C7.PAD_0 (PIN0), C9.PAD_0 (PIN0), C10.PAD_0 (PIN0), C12.-, C13.PAD_0 (PIN0), C14.PAD_0 (PIN0), C15.PAD_0 (PIN0), C16.PAD_0 (PIN0), D1.ANODE, OK1.5 (GND), OK2.5 (GND), OK3.5 (GND), R24.PAD_0 (PIN0), R31.PAD_1 (PIN1), T1.2 (E), T2.2 (E), T3.2 (E), T4.2 (E), X3.1, X4.2, X4.10
D_MISO: R25.PAD_1 (PIN1), X3.6, X4.3
D_MOSI: C9.PAD_1 (PIN1), R17.PAD_1 (PIN1), X3.3, X4.9
D_RST: C10.PAD_1 (PIN1), R22.PAD_1 (PIN1), X3.2, X4.6
D_SCK: C7.PAD_1 (PIN1), R12.PAD_1 (PIN1), X3.4, X4.1
D_VCC: C12.+, C13.PAD_1 (PIN1), C14.PAD_1 (PIN1), C15.PAD_1 (PIN1), C16.PAD_1 (PIN1), D1.CATHODE, LED3.ANODE, OK1.8 (VCC), OK2.8 (VCC), OK3.8 (VCC), OK4.2 (A), R9.PAD_0 (PIN0), R10.PAD_0 (PIN0), R14.PAD_0 (PIN0), R15.PAD_0 (PIN0), R19.PAD_0 (PIN0), R20.PAD_0 (PIN0), R32.PAD1 (PIN1), R33.PAD_0 (PIN0)
GND: C1.PAD_0 (PIN0), C2.PAD_0 (PIN0), C3.PAD_0 (PIN0), C4.PAD_0 (PIN0), C5.PAD_0 (PIN0), C6.PAD_0 (PIN0), C8.-, C11.PAD_0 (PIN0), C17.PAD_0 (PIN0), IC1.6 (GND), IC1.18 (GND1), IC1.28 (GND), IC1.39 (GND2), OK2.3 (C), OK3.3 (C), OK4.5 (GND), R13.PAD_0 (PIN0), SW1.CENTER2, T5.2 (E), X1.4 (GND), X1.PACKAGE_PAD1 (PACKAGE), X1.PACKAGE_PAD2 (PACKAGE), X2.1, ZD1.ANODE, ZD2.ANODE
GREEN_LED: IC1.20 (PC1(SDA)), R5.PAD_1 (PIN1)
MCU_MISO: IC1.2 ((MISO)PB6), X2.6
MCU_MOSI: IC1.1 ((MOSI)PB5), J2.PAD_0 (PIN0)
MCU_RST: IC1.4 (RESET), R4.PAD_1 (PIN1), X2.2
MCU_SCK: IC1.3 ((SCK)PB7), X2.4
unnamed: C2.PAD_1 (PIN1), IC1.8 (XTAL1), Q1.2
unnamed: OK1.3 (C), R13.PAD_1 (PIN1)
unnamed: C1.PAD_1 (PIN1), IC1.7 (XTAL2), Q1.1
unnamed: R1.PAD_1 (PIN1), R2.PAD_1 (PIN1), X1.2 (D-), ZD2.CATHODE
unnamed: IC1.13 ((OC1B)PD4), R2.PAD_0 (PIN0)
unnamed: IC1.11 ((INT0)PD2), IC1.12 ((INT1)PD3), R3.PAD_1 (PIN1)
unnamed: LED1.CATHODE, R5.PAD_0 (PIN0)
unnamed: LED2.CATHODE, R6.PAD_0 (PIN0)
unnamed: R10.PAD_1 (PIN1), R12.PAD_0 (PIN0), T1.3 (C)
unnamed: R7.PAD_1 (PIN1), R8.PAD_1 (PIN1), SW1.POS_B2
unnamed: OK1.6 (VO), R9.PAD_1 (PIN1), T1.1 (B)
unnamed: OK3.2 (A), R23.PAD_1 (PIN1)
unnamed: R3.PAD_0 (PIN0), X1.3 (D+), ZD1.CATHODE
unnamed: J2.PAD_1 (PIN1), X2.3
unnamed: R15.PAD_1 (PIN1), R17.PAD_0 (PIN0), T2.3 (C)
unnamed: OK2.6 (VO), R14.PAD_1 (PIN1), T2.1 (B)
unnamed: J1.PAD_1 (PIN1), X1.1 (VBUS)
unnamed: OK2.2 (A), R18.PAD_1 (PIN1)
unnamed: R32.PAD_0 (PIN0), X3.5
unnamed: R20.PAD_1 (PIN1), R22.PAD_0 (PIN0), T3.3 (C)
unnamed: OK3.6 (VO), R19.PAD_1 (PIN1), T3.1 (B)
unnamed: R33.PAD1 (PIN1), X4.4
unnamed: R26.PAD_0 (PIN0), T4.3 (C)
unnamed: OK4.3 (C), R26.PAD_1 (PIN1)
unnamed: R24.PAD_1 (PIN1), R25.PAD_0 (PIN0), T4.1 (B)
unnamed: LED3.CATHODE, R31.PAD_0 (PIN0)
unnamed: R28.PAD_1 (PIN1), R30.PAD_0 (PIN0), T5.3 (C)
unnamed: OK4.6 (VO), R27.PAD_1 (PIN1), T5.1 (B)
RED_LED: IC1.21 (PC2), R6.PAD_1 (PIN1)
SLOW_SCK: IC1.22 (PC3), R8.PAD_0 (PIN0)
T_MISO: C11.PAD_1 (PIN1), IC1.35 ((ADC2)PA2), R30.PAD_1 (PIN1)
T_MOSI: IC1.32 ((ADC5)PA5), R18.PAD_0 (PIN0)
T_RST: IC1.33 ((ADC4)PA4), R23.PAD_0 (PIN0)
T_SCK: IC1.34 ((ADC3)PA3), OK1.2 (A)
