InspectorColombo/ColomboProjects/USBASP_M8535/schematic/USBASP_M8535.brd

## EAGLE design USBASP_M8535/schematic/USBASP_M8535.brd (continued)

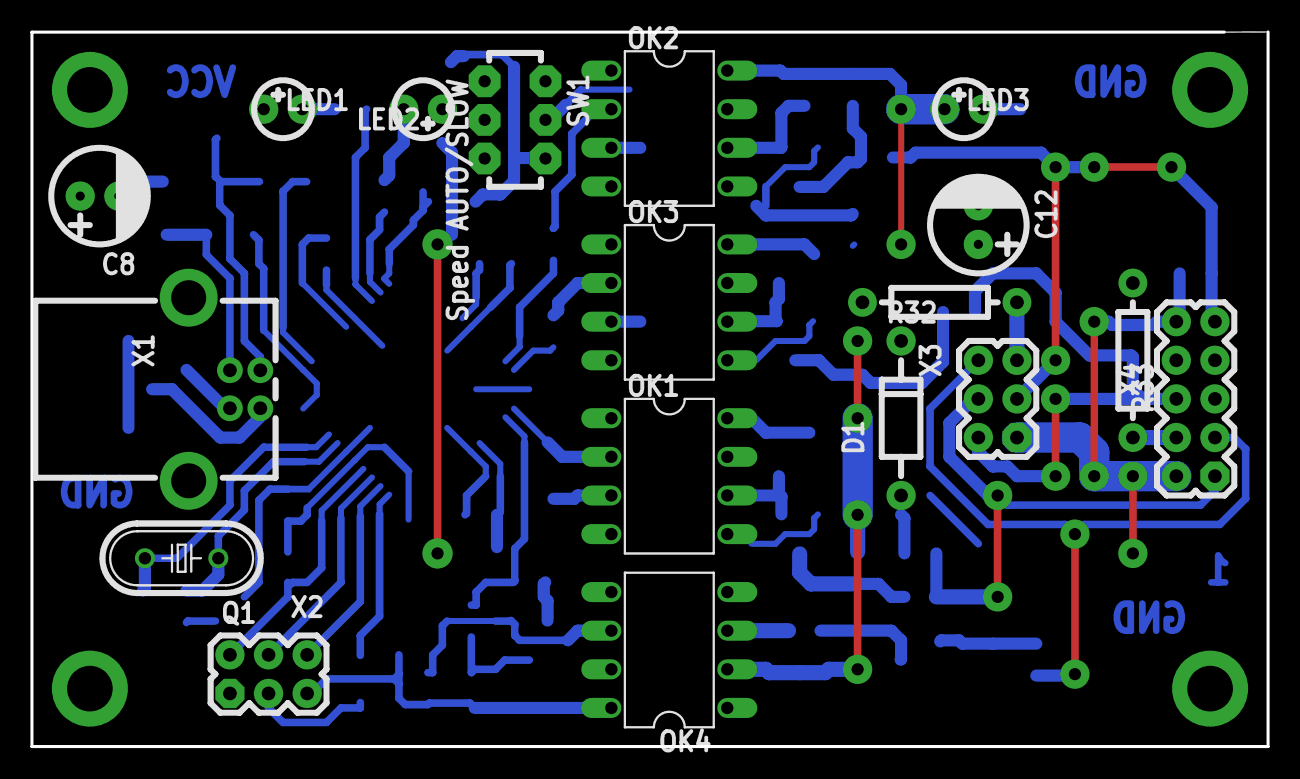
[picture p74: board USBASP_M8535.brd from above]

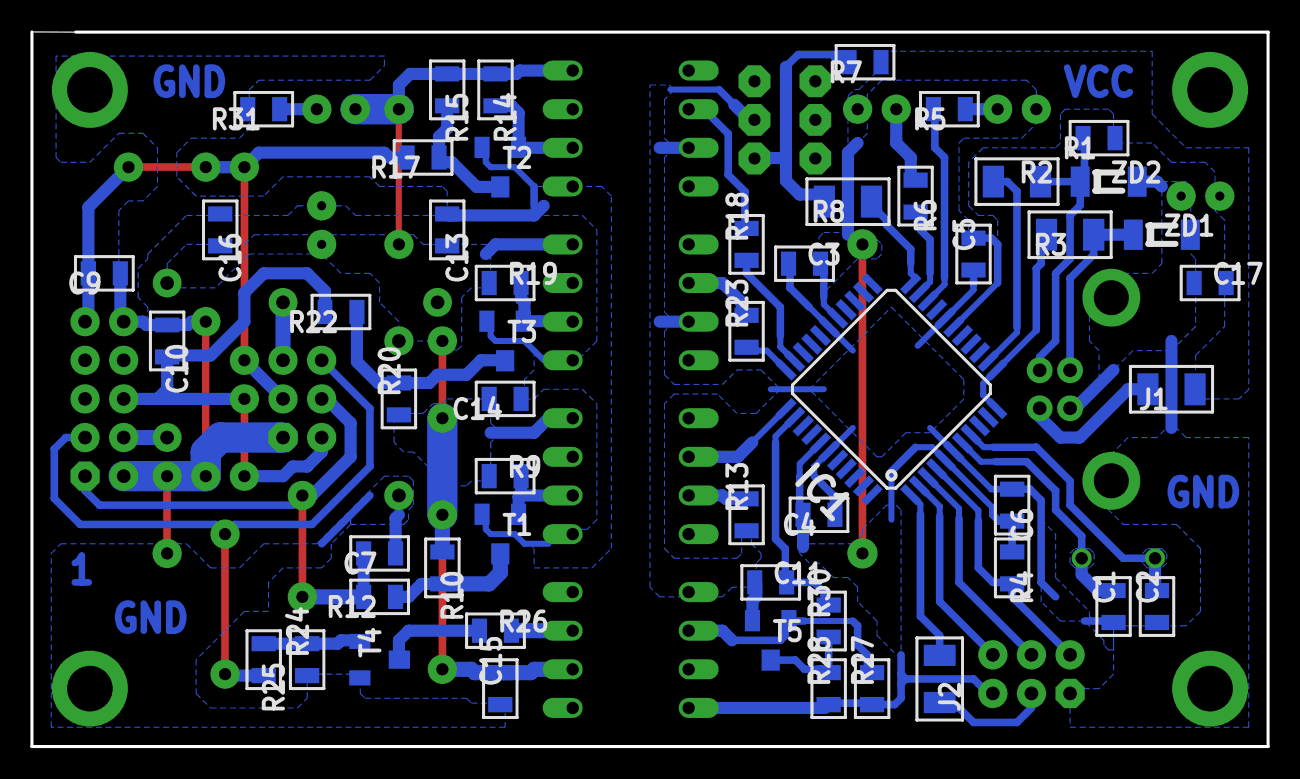
[picture p75: board USBASP_M8535.brd from below]

Board: 2 copper layers, 81.3 x 47.0 mm, 70 parts (52 on the bottom side), 47 nets.
