InspectorColombo/ColomboProjects/PowerSupply_1600W/CurrentRestrictionBoard/CurrentRestrictionBoard_V1_0_TO_PRINT.brd

## EAGLE design PowerSupply_1600W/CurrentRestrictionBoard/CurrentRestrictionBoard_V1_0_TO_PRINT.brd (2026-05-21)

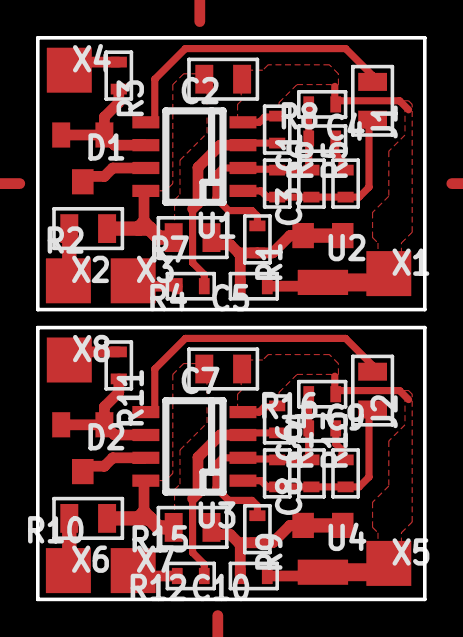
[picture p76: board CurrentRestrictionBoard_V1_0_TO_PRINT.brd from above]

Board: 2 copper layers, 21.5 x 31.2 mm, 42 parts (0 on the bottom side), 26 nets.

Parts:
C1, C4, C6, C9: *; RSMD_0603
C2, C7: 0.47uF x 16V; RSMD_0805
C3, C8: 1n0 16V; RSMD_0603
C5, C10: 0.1uF x 16V; RSMD_0603
D1, D2: BAT54A; SOT23_SMALL_PADS
J1, J2: 0; RSMD_0805
R1, R9: 22K; RSMD_0603
R2, R10: 10R; RSMD_0805
R3, R11: 5K1; RSMD_0603
R4, R5, R12, R13: *; RSMD_0603
R6, R14: 680K; RSMD_0603
R7, R15: 5K1; RSMD_0805
R8, R16: 10K; RSMD_0603
U1, U3: LM358; SOIC8
U2, U4: TL431; SOT23
X1, X5: GND; PIN1X1_2.5X2.5MM
X2, X6: +12V; PIN1X1_2.5X2.5MM
X3, X7: CS_IN; PIN1X1_2.5X2.5MM
X4, X8: VReg_OUT; PIN1X1_2.5X2.5MM

Connections:
+12V: C2.PAD_1, R2.PAD_0, R7.PAD_1, U1.8
+12V1: C7.PAD_1, R10.PAD_0, R15.PAD_1, U3.8
GND: C1.PAD_0, C2.PAD_0, C5.PAD_0, R8.PAD_0, U1.4, U2.3, X1.1
GND1: C6.PAD_0, C7.PAD_0, C10.PAD_0, R16.PAD_0, U3.4, U4.3, X5.1
unnamed: R2.PAD_1, X2.1
unnamed: R4.PAD_1, X3.1
unnamed: C1.PAD_1, R4.PAD_0, U1.3
unnamed: C3.PAD_0, C4.PAD_0, R1.PAD_0, R6.PAD_1, R8.PAD_1, U1.2
unnamed: C3.PAD_1, J1.PAD_1, R5.PAD_0, R6.PAD_0, U1.1
unnamed: C4.PAD_1, R5.PAD_1
unnamed: D1.1, D1.2, R3.PAD_1, U1.6
unnamed: D1.3, U1.7
unnamed: R3.PAD_0, X4.1
unnamed: C5.PAD_1, R1.PAD_1, R7.PAD_0, U2.1, U2.2
unnamed: J1.PAD_0, U1.5
unnamed: R10.PAD_1, X6.1
unnamed: R12.PAD_1, X7.1
unnamed: C6.PAD_1, R12.PAD_0, U3.3
unnamed: C8.PAD_1, J2.PAD_1, R13.PAD_0, R14.PAD_0, U3.1
unnamed: C9.PAD_1, R13.PAD_1
unnamed: D2.1, D2.2, R11.PAD_1, U3.6
unnamed: D2.3, U3.7
unnamed: R11.PAD_0, X8.1
unnamed: C10.PAD_1, R9.PAD_1, R15.PAD_0, U4.1, U4.2
unnamed: C8.PAD_0, C9.PAD_0, R9.PAD_0, R14.PAD_1, R16.PAD_1, U3.2
unnamed: J2.PAD_0, U3.5
