InspectorColombo/ColomboProjects/KLineAdapter/schematic/KLineAdapter_TO_PRINT.brd

## EAGLE design KLineAdapter/schematic/KLineAdapter_TO_PRINT.brd (2023-11-24)

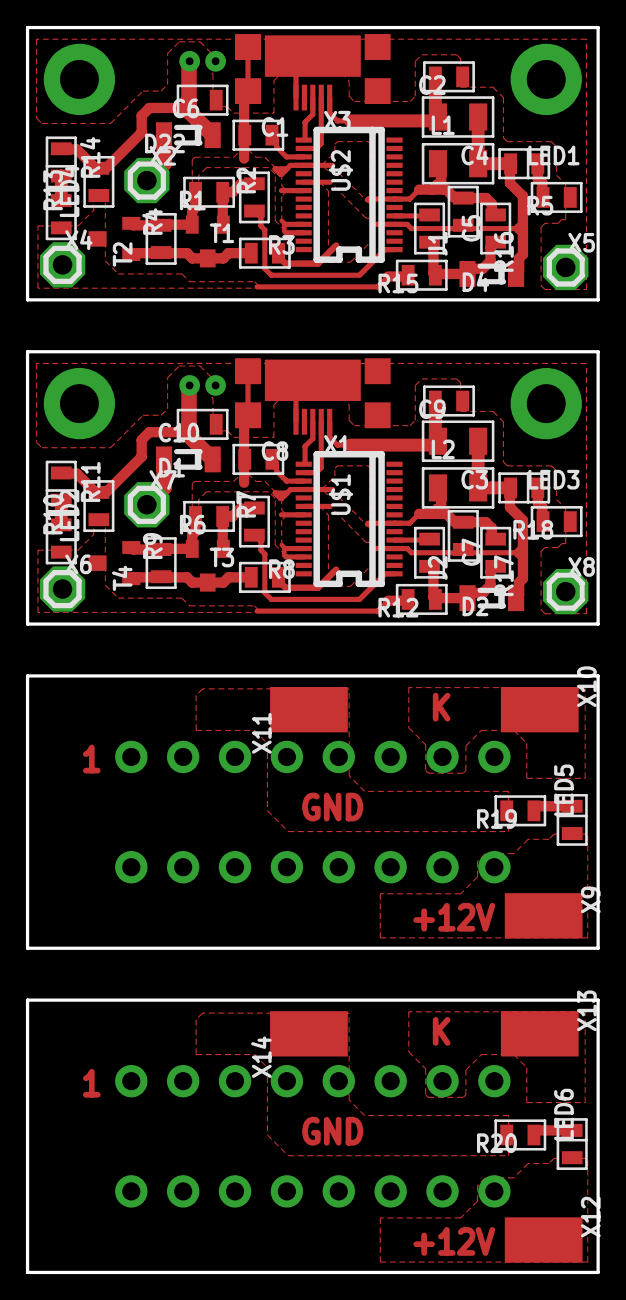
[picture p77: board KLineAdapter_TO_PRINT.brd from above]

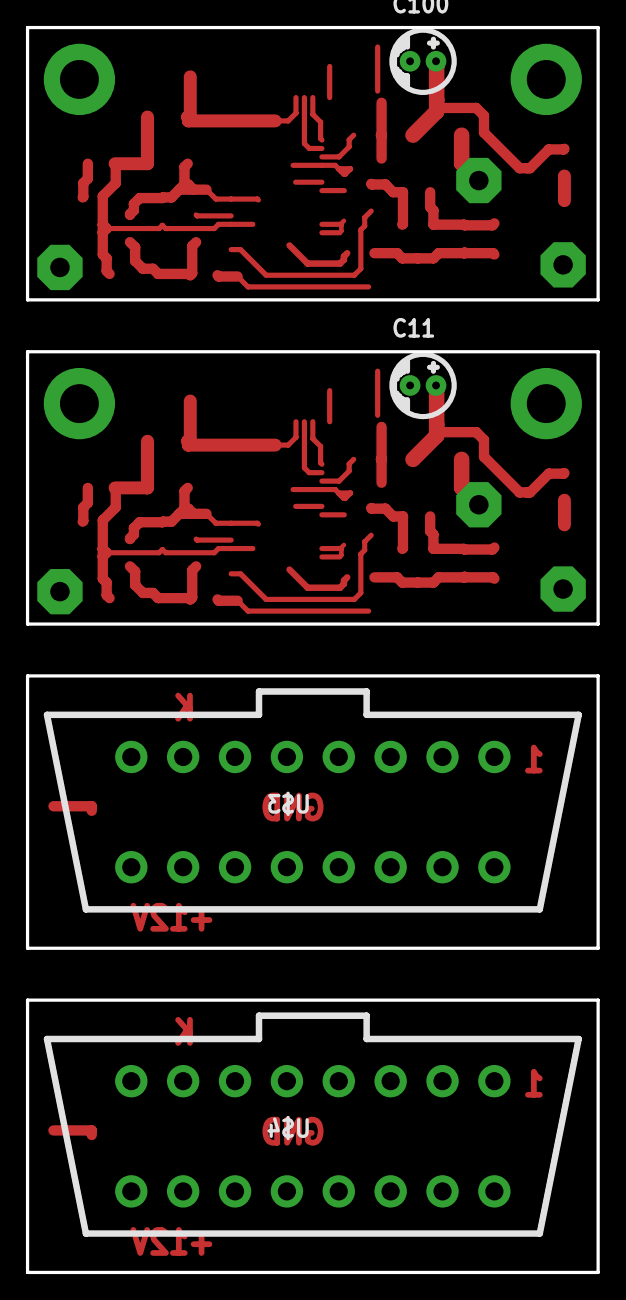
[picture p78: board KLineAdapter_TO_PRINT.brd from below]

Board: 2 copper layers, 44.0 x 96.0 mm, 68 parts (2 on the bottom side), 40 nets.

Parts:
C1, C5, C6, C7, C8, C10: 0.1uF; RSMD_0805
C2, C9: 10nF; RSMD_0805
C3, C4: 4.7uF; RSMD_1206
C11, C100: 47uF x 25V; CE_5.2MM
D1, D2, D4, D22: LL4148; SOD-80
J1, J2: 0 Ohm; RSMD_0805
L1, L2: Bead; RSMD_1206
LED1, LED3: red; LED_0805
LED2, LED4: green; LED_0805
LED5, LED6: yellow; LED_0805
R1, R2, R4, R6, R7, R9: 3K3; RSMD_0805
R3, R8, R12, R15: 10K; RSMD_0805
R5, R11, R14, R18: 1K0; RSMD_0805
R10, R13, R19, R20: 4K7; RSMD_0805
R16, R17: 2K7; RSMD_0805
T1, T2, T3, T4: BC847; SOT23_SMALL_PADS
U$1, U$2: FT232RL(SSOP-28); SSOP-28
U$3, U$4: ODB2
X1, X3: USB_MICRO; USB_MICRO_TYPE_B
X2, X7: OBD2_+12V; PIN1X1_3.5MM_PWR
X4, X6: OBD2_KLINE; PIN1X1_3.5MM_PWR
X5, X8: OBD2_GND; PIN1X1_3.5MM_PWR
X9, X12: +12V; PIN1X1_3.5MM_SIDE_BOARD
X10, X13: K_Line; PIN1X1_3.5MM_SIDE_BOARD
X11, X14: GND; PIN1X1_3.5MM_SIDE_BOARD

Connections:
+12V: D22.ANODE, X2.1
+12V1: D1.ANODE, X7.1
BAT_+12V: LED5.ANODE, U$3.16, X9.1
BAT_+12V1: LED6.ANODE, U$4.16, X12.1
GND: C1.PAD_0, C2.PAD_0, C4.PAD_0, C5.PAD_0, C6.PAD_0, C100.MINUS, R1.PAD_1, R4.PAD_1, R5.PAD_0, R16.PAD_0, T1.2, T2.2, U$2.7, U$2.18, U$2.21, U$2.25, U$2.26, X3.5, X3.PACKAGE1, X3.PACKAGE2, X3.PACKAGE3, X3.PACKAGE4, X3.PACKAGE5, X5.1
GND1: C3.PAD_0, C7.PAD_0, C8.PAD_0, C9.PAD_0, C10.PAD_0, C11.MINUS, R6.PAD_1, R9.PAD_1, R17.PAD_0, R18.PAD_0, T3.2, T4.2, U$1.7, U$1.18, U$1.21, U$1.25, U$1.26, X1.5, X1.PACKAGE1, X1.PACKAGE2, X1.PACKAGE3, X1.PACKAGE4, X1.PACKAGE5, X8.1
GND2: R19.PAD_1, U$3.4, U$3.5, X11.1
GND3: R20.PAD_1, U$4.4, U$4.5, X14.1
KLINE: R13.PAD_0, R14.PAD_0, R15.PAD_1, T2.3, X4.1
KLINE1: R10.PAD_0, R11.PAD_0, R12.PAD_1, T4.3, X6.1
unnamed: C1.PAD_1, U$2.17
unnamed: J1.PAD_0, U$2.5
unnamed: R1.PAD_0, R2.PAD_1, T1.1
unnamed: R3.PAD_0, R4.PAD_0, T1.3, T2.1
unnamed: C6.PAD_1, C100.PLUS, D22.CATHODE, LED4.ANODE, R14.PAD_1
unnamed: LED1.CATHODE, R5.PAD_1
unnamed: C8.PAD_1, U$1.17
unnamed: R6.PAD_0, R7.PAD_1, T3.1
unnamed: LED4.CATHODE, R13.PAD_1
unnamed: R8.PAD_0, R9.PAD_0, T3.3, T4.1
unnamed: C10.PAD_1, C11.PLUS, D1.CATHODE, LED2.ANODE, R11.PAD_1
unnamed: LED2.CATHODE, R10.PAD_1
unnamed: J2.PAD_0, U$1.5
unnamed: LED3.CATHODE, R18.PAD_1
unnamed: U$3.7, X10.1
unnamed: LED5.CATHODE, R19.PAD_0
unnamed: U$4.7, X13.1
unnamed: LED6.CATHODE, R20.PAD_0
RXD: D4.ANODE, J1.PAD_1, R15.PAD_0, R16.PAD_1
RXD1: D2.ANODE, J2.PAD_1, R12.PAD_0, R17.PAD_1
TXD: R2.PAD_0, U$2.1
TXD1: R7.PAD_0, U$1.1
USB_D+: U$2.15, X3.3
USB_D+1: U$1.15, X1.3
USB_D-: U$2.16, X3.2
USB_D-1: U$1.16, X1.2
VCC: C4.PAD_1, C5.PAD_1, D4.CATHODE, L1.PAD_0, LED1.ANODE, R3.PAD_1, U$2.4, U$2.20
VCC1: C3.PAD_1, C7.PAD_1, D2.CATHODE, L2.PAD_0, LED3.ANODE, R8.PAD_1, U$1.4, U$1.20
VCC_USB: C2.PAD_1, L1.PAD_1, X3.1
VCC_USB1: C9.PAD_1, L2.PAD_1, X1.1
