InspectorColombo/ColomboProjects/12_to_200V_inverter/sw/Inverter12to200/DataStorageRawC/inc/TempSensorTable.h

// ----- Temperature sensor table -----

#include <avr/io.h>

#ifndef __TEMPSENSORTABLE_H__
#define __TEMPSENSORTABLE_H__
	
uint8_t GetTempSensorTableSize();
uint16_t GetTempSensorTableAdcValue(const uint8_t idx);
uint8_t GetTempSensorTableTemperatureValue(const uint8_t idx);

#endif // __TEMPSENSORTABLE_H__
