InspectorColombo/ColomboProjects/12_to_200V_inverter/sw/Inverter12to200/BatteryLampInverterController/inc/CsDelay.hpp

/*
 * CsDelay.h
 */ 


#ifndef __CS_DELAY_HPP__
#define __CS_DELAY_HPP__

#include <avr/io.h>

void DelayMicroSec(const uint8_t usDelay);
void DelayMiliSec(const uint16_t msDelay);



#endif // __CS_DELAY_HPP__
