InspectorColombo/ColomboProjects/(commit log)

2022-08-27 first version of USB ASP based on atmega8535
    [USBASP_M8535.brd, USBASP_M8535.sch]
2022-08-27 Some level converter values were changed for improve data transfer speed
    [USBASP_M8535.brd, USBASP_M8535.sch]
2022-08-27 Change again some element valus for correct working on high SCK speed. Remove jumper and add switch for low/high speed selection
    [USBASP_M8535.brd, USBASP_M8535.sch]
2022-08-27 Sw for ATMega8535. Use original mega8 software, reconfigure according new pins. Switch off HW SPI, because of incorrect board routing. Fix SW SPI bug, when SCK_/~ and MOSI were changed almost in same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
    [clock.h, isp.c, isp.h, main.c, usbasp.h, usbconfig-prototype.h, usbconfig.h]
2022-08-27 Switch solution from AVR-XC8 compiller to GCC, to allow code size optimization. Remove garbage from code. Modify POstBuild events to work with relative paths. Add /misc/ folder with odd byte bug comp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
    [clock.h, main.c]
2022-08-27 Pony prog based programmer
    [PonyProg_ver1.brd, PonyProg_ver1.sch]
2022-08-27 UsbTinyISP add
    [USBISPTiny.brd, USBISPTiny.sch]
2022-08-27 USBTinyISP switched to GCC compiller to fit in attiny2313 flash
2022-08-27 First USBTinyISP solution, based on old tiny ISP project. Software base ISP only. Full speed programming doesn't work, need to optimize schematic or sw
    [main.c, usbtiny.h]
2022-08-30 Remove garbage code. Rewrite SPI routine for more correct timing of signals set. Remove unsupported USB commands, like Set/Clear bit in port, change DDR etc.
    [main.c]
2022-08-31 Switch SW SPI to ASM. Draft variant. Write speed improved about 1.5 times
2022-09-03 Add 10 to 6 pins converter
    [10_to_6pins_converter.brd, 10_to_6pins_converter.sch]
2022-09-03 add other changes from Virtual Machine
    [CurrentStabilizer.brd, CurrentStabilizer.sch, CurrentStabilizer_VER2.brd, CurrentStabilizer_VER2.sch, CurrentStabilizer_VER3.brd, CurrentStabilizer_VER3.sch, USBISPTiny.brd]
2022-09-04 TinyISP. Fix micro usb incorrect pinout. Change transystor levels converter to fast, diode based. Route PCB.
    [USBISPTiny.brd, USBISPTiny.sch]
2022-09-07 Switch SPI from SW to USI HW based. Implement fastest(3MHZ clk) SPI on ASM, and slow SPI on c
2022-09-10 LED Screen old firmware
2023-02-01 Add LC meter.
    [LCMeter.brd, LCMeter.sch]
2023-02-04 LMeter new changes
    [LCMeter.brd, LCMeter.sch]
2023-02-05 LCMeter next changes
    [LCMeter.brd, LCMeter.sch]
2023-02-05 LCMeter Another changes
    [LCMeter.brd, LCMeter.sch]
2023-02-07 LCMeter schematic is almost complete
    [LCMeter.brd, LCMeter.sch]
2023-02-08 LCMeter start routing
    [LCMeter.brd, LCMeter.sch]
2023-02-09 LCMeter routing
    [LCMeter.brd, LCMeter.sch]
2023-02-11 LCMeter start routing2
    [LCMeter.brd, LCMeter.sch]
2023-02-12 LCMeter start routing4
    [LCMeter.brd, LCMeter.sch]
2023-02-12 LCMeter start routing 5
    [LCMeter.brd, LCMeter.sch]
2023-02-12 LCMeter Route finish 1
    [LCMeter.brd, LCMeter.sch]
2023-02-12 LCMeter Route finished
    [LCMeter.brd]
2023-02-18 L saturation meter
    [L_SaturationMeter.brd, L_SaturationMeter.sch]
2023-02-18 Fix inconsistancy error
    [L_SaturationMeter.brd, L_SaturationMeter.sch]
2023-02-18 Fix CE packages pads naming, to avoid inconsistance after package change
    [L_SaturationMeter.brd, L_SaturationMeter.sch]
2023-02-19 Start routing
    [L_SaturationMeter.brd, L_SaturationMeter.sch]
2023-02-19 L saturation metter routed
    [L_SaturationMeter.brd, L_SaturationMeter.sch]
2023-02-22 L saturation meter. Ver2 schematic complete
    [L_SaturationMeter.brd, L_SaturationMeter.sch]
2023-02-22 L saturation meter. Parts locating
    [L_SaturationMeter.brd, L_SaturationMeter.sch]
2023-02-23 L saturation meter. Routing step 1
    [L_SaturationMeter.brd, L_SaturationMeter.sch]
2023-02-23 L saturation meter. Routing step 2
    [L_SaturationMeter.brd]
2023-02-24 L saturation meter. Routed
    [L_SaturationMeter.brd]
2023-02-24 L saturation meter. tiny fixes
    [L_SaturationMeter.brd, L_SaturationMeter.sch]
2023-02-25 L saturation meter. Final changes
    [L_SaturationMeter.brd, L_SaturationMeter.sch]
2023-03-02 LC meter test power supply inverter
    [LCMeter_test_power_inverter.brd, LCMeter_test_power_inverter.sch]
2023-03-02 LC meter test power supply inverter. parts Located
    [LCMeter_test_power_inverter.brd, LCMeter_test_power_inverter.sch]
2023-03-02 LC meter test power supply inverter. almost routed
    [LCMeter_test_power_inverter.brd, LCMeter_test_power_inverter.sch]
2023-03-03 LC meter test power supply iverter. Finished
    [LCMeter_test_power_inverter.brd]
2023-03-04 LC_METER power supply ver2
    [LCMeter_test_power_inverter_VER2.brd, LCMeter_test_power_inverter_VER2.sch]
2023-03-05 PowerInverter_V2 PCB routed
    [LCMeter_test_power_inverter_VER2.brd, LCMeter_test_power_inverter_VER2.sch]
2023-03-14 LC meter schematic. Power stabilizer values fix
    [LCMeter.brd, LCMeter.sch]
2023-03-14 Test LC meter power supply changes
    [LCMeter_test_power_inverter_VER2.brd, LCMeter_test_power_inverter_VER2.sch]
2023-03-16 LC Meter change some values
    [LCMeter.brd, LCMeter.sch]
2023-03-18 LED indicator routines done
2023-03-18 LC-metter. Timers and PWMs configured
2023-03-18 LC Metter. Add Keys pressing routines and anti jitter timer interrupt
    [AdcReader.c, AdcReader.h, KeysReader.c, KeysReader.h, MainDefinitions.h, main.c]
2023-03-19 LC Metter. Battery voltage metter sw coded. Add ADC hysteresys routines
2023-03-19 LC Meter. Battery voltage metter resistors values changed
    [LCMeter.brd, LCMeter.sch]
2023-03-19 LC Metter. Adjust +5v stabilizer values
    [LCMeter.brd, LCMeter.sch]
2023-05-07 Current sensor
2023-05-07 Curent sensor. Half routed
    [CurrentSensor.brd, CurrentSensor.sch]
2023-05-07 Curent sensor. Routed.
    [CurrentSensor.brd, CurrentSensor.sch]
2023-05-08 Current sensor. PBC finally routed
    [CurrentSensor.sch, CurrentSensor_TO_PRINT.brd]
2023-05-09 Current sensor metter SW start
2023-05-10 Current sensor. ADC switched to unipolar, all factors configured.
2023-05-10 LEDs configured for a half.
2023-05-11 LEDs configured. Voltage/current levels confiureconfigured.
2023-05-12 Current Sensor board update.
    [CurrentSensor.brd, CurrentSensor.sch, CurrentSensor_TO_PRINT.brd]
2023-05-12 CurrentSensor almost finished.
2023-11-18 KLine adapter start
    [KLineAdapter.brd, KLineAdapter.sch]
2023-11-19 KLine adapter. Schematic done.
2023-11-19 KLine adapter. Almost routed.
    [KLineAdapter.brd, KLineAdapter.sch]
2023-11-23 KLine adapter. Routed.
    [KLineAdapter.brd, KLineAdapter.sch]
2023-11-26 KLine adapter complete.
    [KLineAdapter.brd, KLineAdapter.sch, KLineAdapter_TO_PRINT.brd]
2023-11-26 12 to 200V inverter start.
    [12to220inverter.brd, 12to220inverter.sch]
2023-11-26 12 to 200V inverter. Routed.
    [12to220inverter.brd, 12to220inverter.sch]
2023-12-08 12 to 200V converter v2. Forward 2 conversion.
    [12to220inverter.brd, 12to220inverterVer2.brd, 12to220inverterVer2.sch, 12to220inverter_TO_RPINT.brd, 12to220inverter_TO_RPINT.sch]
2023-12-09 12 to 200V converter v2. Schematic done.
    [12to220inverterVer2.brd, 12to220inverterVer2.sch]
2023-12-09 12 to 200V converter v2. Routed.
    [12to220inverterVer2.brd, 12to220inverterVer2.sch]
2023-12-27 12 to 200VDC converter. Ver3. Converter schematic done. Add overcurrent/overvoltage protection.
    [12to220inverterVer2_to_print.brd, 12to220inverterVer2_to_print.sch, 12to220inverterVer3.brd, 12to220inverterVer3.sch]
2024-01-02 12 to 200VDC converter. Ver3. Start with battery charger.
    [12to220inverterVer3.brd, 12to220inverterVer3.sch]
2024-01-02 12_to_200V inverter. Ver3 Start schematic.
    [12to220inverterVer3.brd, 12to220inverterVer3.sch]
2024-01-04 12 to 200V converter. Ver3. Schematic almost done.
    [12to220inverterVer3.brd, 12to220inverterVer3.sch]
2024-01-05 12 to 200V converter. Ver3. Start routing.
    [12to220inverterVer3.brd, 12to220inverterVer3.sch]
2024-01-05 12 to 200V converter. Ver3. Renumber schematic.
    [12to220inverterVer3.brd, 12to220inverterVer3.sch]
2024-01-06 12 to 200V converter. Ver3. Slightly rebuild schematic. Charger, converter and indicator are separate now.
    [12to220inverterVer3.brd, 12to220inverterVer3.sch]
2024-01-06 12 to 200V converter. Ver3. Rebuilt schematic.
    [12to220inverterVer3.brd, 12to220inverterVer3.sch]
2024-01-06 12 to 200V converter. Ver3.
    [12to220inverterVer3.brd, 12to220inverterVer3.sch]
2024-01-07 12 to 200V converter. Ver3. Start simplification.
    [12to220inverterVer3.brd, 12to220inverterVer3.sch]
2024-01-07 12 to 200V converter. Ver3. Routing.
    [12to220inverterVer3.brd, 12to220inverterVer3.sch]
2024-01-11 12 to 200V converter
    [12to220inverterVer3.brd]
2024-01-11 12to200V inverter. restore
    [12to220inverterVer3.brd, 12to220inverterVer3.sch]
2024-01-12 10 to 200V inverter. Ver3. Routing.
    [12to220inverterVer3.brd, 12to220inverterVer3.sch]
2024-01-13 12 to 200V inverter. Almost routed.
    [12to220inverterVer3.brd, 12to220inverterVer3.sch]
2024-01-16 12 to 200V inverter. Some fixes.
    [12to220inverterVer3.sch, 12to220inverterVer3_TO_PRINT.brd]
2024-01-17 12 to 200V converter. Start sw.
2024-01-17 12 to 200V converter. Tiny fixes to chematic.
    [12to220inverterVer3.brd]
2024-01-17 12 to 200V converter. Rename LEDs.
    [12to220inverterVer3.brd, 12to220inverterVer3.sch]
2024-01-17 12 to 200V converter. Shift registers SPI configured. Leds/other perepheria configured.
2024-01-19 12 to 200v converter. SW USART writtedone for debug.
2024-01-20 12 to 200V converter. Adjust voltage ADC.
2024-01-20 12 to 200V converter. Voltage/Current ADC ration, offset error implemented.
    [main.c]
2024-01-21 12 to 200V converter. Fix chematic(charger mostly) after tests on real border.
    [12to220inverterVer3.brd, 12to220inverterVer3.sch]
2024-01-23 12 to 200V converter. Fix instacharger startup/instability on low load. Add dummy load.
    [12to220inverterVer3.brd, 12to220inverterVer3.sch]
2024-01-24 12 to 200V converter. Prepared sw main routines.
    [TermistorTable.xls]
2024-01-27 12 to 200V conv. sw.
2024-01-28 12 to 200V converter. Switch from C to C++.
2024-01-28 12 to 200V converter. Overwrite LED voltage/current indicators.
2024-01-29 12 to 200V converter. Fixed fast switching detection bug.
    [FastKeySwitchingDetector.hpp, main.cpp]
2024-01-31 12 to 200V inverter. Tiny schematic changes.
    [12to220inverterVer3.brd, 12to220inverterVer3.sch]
2024-02-11 12 to 200V inverter. Finish sw. But looks to ugly and big.
2024-02-11 12 to 200V inverter. Switch blinking to table definition. Works version.
2024-02-11 12 to 200V inverter. Move LEDs control to hpp, save 300 bytes flash. This version worksversion.
2024-02-17 12 to 200V inverter. Sw tiny changes.
2024-02-17 12 to 200V inverter. Folders clean from garbage.
2024-02-18 12 to 200V inverter. Add low battery warning hysteresis.
2024-02-27 12 to 200V inverter. Tiny SW change. Add charge finish beep. Disable additional charge voltage, if any lamp is ON, to avoid battery boiling.
    [IndicatorsTable.c, IndicatorsTable.h, LedLampStatus.hpp, main.cpp]
2024-02-28 12 to 200V converter. Fix add voltage bug. Move status class to header to save ~550bytes of flash.
    [LedLampStatus.hpp, main.cpp]
2024-02-28 12 to 200V converter. Do some clean up.
2024-03-09 12 to 200V converter. Package.
    [LampPackage..dwg]
2024-03-10 10 to 200V inverter. Package.
    [LampPackage2.stl, LampPackage3.dwg]
2024-03-10 10 to 200V inverter. Almost done.
    [LampPackage2.stl, LampPackage3.dwg, LampPackage3_FINAL.stl, LampPackage3_WITH_HOLES.dwg]
2024-03-17 12 to 200V inverter. Package ver2.
    [LampPackage3_WITH_HOLES.dwg, LampPackage4_ver2.dwg]
2024-03-21 12 TO 200V inverter. Package.
    [LampPackage4_ver5.dwg, LampPackage4_ver6.dwg, LampPackage4_ver6.stl]
2024-03-21 12 to 200V inverter. Package, CAP finished.
    [LampPackage4_ver6.dwg, LampPackage4_ver7.stl]
2024-03-21 12 to 200V inverter. Package almost finished. Holes for cooling and solid ribs left.
    [LampPackage4_ver6.dwg, LampPackage4_ver8.stl]
2024-03-22 12 to 200V inverter. Add cooling holes. Remove stl garbage.
    [HANDLE_SMOOTH.stl, LampPackage2.stl, LampPackage3_FINAL.stl, LampPackage3_FINAL_WITH_HOLES.stl, LampPackage4_ver6.dwg, LampPackage4_ver6.stl, LampPackage4_ver7.stl, LampPackage4_ver8.stl]
2024-03-22 12 to 200V converter. Main package final.
    [LampPackage4_ver6.dwg, LampPackage4_ver6_recover.dwg, LampPackage4_ver7.dwg, LampPackage4_ver8.dwg, Package_final_to_print.stl]
2024-03-26 12 to 200V inverter. Change battery holder package. Change lamps holder board.
    [LampHolderBoard.brd, LampPackage4_ver8.dwg, battery_holder_v2.stl]
2024-03-28 12 to 200V inverter. Final package changes.
    [Package_final_to_print.stl, battery_holder_v2.stl]
2024-03-28 12 to 200V inverter. Add separate indication board. Change erar CAP to support board instalation. Change power connector on CAP to BARREL type.
    [CAP_ver2.stl, Indication_board.brd, Indication_board.sch, LampPackage4_ver8.dwg]
2024-04-01 12 to 200V inverter. Ring Holder stl.
    [Conductor.dwg, Conductor.stl, LED_Conductor.dwg, LED_Conductor.stl, LED_Conductor_LOOSE.stl, LED_Conductor_LOOSE_LOOSE.stl, RingHolder.dwg, RingHolder.stl]
2024-04-01 12 to 200V inverter. Remove garbage files.
    [CAP_ver2.stl, Conductor.stl, LED_Conductor.stl, LED_Conductor_LOOSE.stl, RingHolder.dwg]
2024-04-04 12 to 200V inverter. Back cap update.
    [LampPackage4_ver8.dwg]
2024-04-13 12 to 200V inverter. Add changes to package. Correct PBC holder, hole depth for screws, bat holder. Enlarge tighteness ribs on walls. etc.
    [LED_Conductor_LOOSE_LOOSE.stl, LampPackage4_ver6_recover.dwg, LampPackage4_ver9.dwg]
2024-05-01 12 to 200V inverter. Some package changes.
    [CAP_PACKAGE_V3.stl, CONF_BOX.stl, HANDLE_BLUE.stl, LAMP_PACK_bott.stl, LAMP_PACK_top.stl, LampPackage4_ver9.dwg, LampPackage4_ver9.stl, LampPackage4_ver9_NO_HOLES.stl]
2024-05-01 12 to 200V inverter. New board with ETD transformers. Route.
2024-05-05 12 to 200V inverter. New board with ETD transformers. Finally routed.
    [12to220inverterVer3.brd, 12to220inverterVer3.sch, HANDLE_WITH_RESTRICTION.dwg, restrictionBox.stl]
2024-05-11 12 to 200V inverter. Change leds holder and board. board 160mm length. LEDs holder - add screw holes, change geometry size.
    [LED_HOLDER3.stl, LampPackage4_ver9.dwg]
2024-05-11 12 to 200V inverter. Timny changes to schematic and board.
    [12to220inverterVer3.brd, 12to220inverterVer3.sch, 12to220inverterVer3_TO_PRINT.brd, 12to220inverterVer3_TO_PRINT.sch]
2024-05-20 recovery files.
    [HEATSINK_HOLDER.stl, HEATSINK_HOLDER_V2.stl, HEAT_SINK_HOLDER.dwg, HEAT_SINK_HOLDER_recover.dwg]
2024-05-27 12 to 200V inverter. Last steps.
    [12to220inverterVer3.brd, 12to220inverterVer3.sch, WindingMachine.dwg, WindingMachineHandle.stl, WindingMachineHandle_TOP.stl, WindingMachine_recover.dwg]
2024-05-31 12 to 200V inverter. Change SW to 2.4A charge current and modified current sensor block.
2024-05-31 12 to 200V inverter. Correct schematic values for correct charge voltages. For 2.4A charge current version. Remove some garbage.
2024-06-04 12 to 200V inverter. Update transformers data.
2024-06-04 12 to 200V inverter. Adjust current sensor indication and high to low voltage charger threshold.
2024-06-04 Filament Case drawning.
    [FilamentCase.dwg]
2024-06-09 Filament case.
    [CAP_FINAL.stl, Case_Final.stl, FilamentCase.dwg]
2024-06-09 Filament case. Remove garbage.
    [CAP_FINAL.stl, Case_Final.stl, FilamentCase.dwg]
2024-06-18 Niddle box.
    [BOX.dwg, ValveHandle.dwg]
2024-06-19 Niddle box. Fix lower curvage problem area.
    [BOX.dwg]
2024-06-22 12 to 200V inverter. Lamp. Last package drawning.
    [HEATSINK_HOLDER.stl, HEATSINK_HOLDER_V2.stl, HEAT_SINK_HOLDER_recover.dwg, LED_HOLDER3.stl, LampPackage..dwg, LampPackage2.dwg, LampPackage3.dwg, LampPackage3_WITH_HOLES.dwg]
2024-07-22 Canister Cap.
    [CanisterCap.dwg]
2024-07-23 CanisterCap last version.
    [CanisterCap.dwg]
2024-07-26 Humidity Metter. Fix timer1 delay bug.
    [DelayTimer.cpp, DelayTimer.hpp, GpioConfigurator.cpp, GpioConfigurator.hpp, LcdScreen.cpp, LcdScreen.hpp, main.cpp]
2024-07-28 Humidity Metter. Humidity sensor finally connected and returns proper values.
2024-07-29 STM32F103C8T6 add to eagle lib.
2024-07-29 Humidity metter. Start schematic creation.
    [HumidityMetter.brd, HumidityMetter.sch]
2024-07-30 Humidity metter. Start schematic routing.
    [HumidityMetter.brd, HumidityMetter.sch]
2024-08-06 Humidity metter.
    [HumidityMetter.brd, HumidityMetter.sch]
2024-08-06 Humidity metter. Routing.
    [HumidityMetter.brd, HumidityMetter.sch]
2024-08-07 Himidity metter. Board routed.
    [HumidityMetter.brd, HumidityMetter.sch]
2024-08-08 Himidity metter. Board routed. Fix tiny problems.
    [HumidityMetter.brd, HumidityMetter.sch]
2024-08-11 Humidity metter. Remove garbage from schematic. Modify SW to proper LCD ports definition. Add self holding power option.
    [ExpositionTest.sch]
2024-08-15 Humidity metter. Move sensor code in separate file. Add time out power OFF.
2024-08-25 Humidity metter. Add key reading and switching between temp, humidity, preassure and battery voltage(dummy).
    [HumidityMetter.brd, HumidityMetter.sch]
2024-08-26 Humidity metter. Package drawn.
    [HumidityMetterPackage.dwg]
2024-08-27 Humidity metter. Package.
    [HumidityMetterPackage.dwg]
2024-08-27 Humidity metter package.
    [HumidityMetterPackage.dwg, bottom.stl, top.stl]
2024-09-07 Lotok. Package.
    [HumidityMetterPackage.dwg, HumidityMetterPackage.stl, Lotok.dwg, Lotok15mm.dwg, Lotok15mm.stl, Lotok25mm.dwg, Lotok25mm_6.stl, Lotok_2mm_v2.stl]
2024-12-08 Kassy. update.
    [BigBox3x3_1.8mm_test.stl, BigBox6x5_1.8mm.stl, Kassy.dwg, SMALL_BOX.stl]
2024-12-11 Kassy. Remove 0.2mm height.
    [Kassy.dwg, box_v5.stl]
2024-12-28 Humidity metter. Rewrite board.
    [HumidityMetter_v2.brd, HumidityMetter_v2.sch]
2024-12-30 Humidity metter v2. Change schematic/board.
    [HumidityMetter_v2.brd, HumidityMetter_v2.sch]
2024-12-31 Humidity metter v2. Change schematic/board 2.
    [HumidityMetter_v2.brd, HumidityMetter_v2.sch]
2025-01-02 Humidity metter v2. Change schematic/board 3.
    [HumidityMetter_v2.brd, HumidityMetter_v2.sch]
2025-01-03 Humidity metter v2. Change schematic/board 4.
    [HumidityMetter_v2.brd, HumidityMetter_v2.sch]
2025-01-04 Humidity metter v2. Change schematic/board 5.
    [HumidityMetter_v2.brd, HumidityMetter_v2.sch]
2025-01-08 Humidity metter. Ver2. Add battery voltage sensing. Board finally routed.
    [ExpositionTest.brd, HumidityMetter_TO_PRINT.brd]
2025-01-11 Humidity metter. Sensor holder board.
    [HM_SENSOR_HOLDER.brd, HM_SENSOR_HOLDER.sch, HumidityMetter_v2.brd, HumidityMetter_v2.sch]
2025-01-13 HM. Make probe holder. SW - add SSD1306 I2C OLED display driver.
2025-01-17 Humidity metter. Rewrite SW I2C. Optimize it. Create SSD1306 OLED screen driver.
2025-01-17 Humidity metter. Move BME280 to new fast SW I2C.
2025-01-17 Humidity metter. Move AM2320 sensor to new fast SW I2C.
2025-01-18 Humidity metter. Add Portrait orientation and vertical print for SSD1306.
2025-01-25 Humidity Metter. Ver2. SSD1306 Print class implemented.
2026-04-12 PS 1600W Current restriction board.
    [CurrentRestrictionBoard_V1_0.brd, CurrentRestrictionBoard_V1_0.sch]
2026-04-13 PS 1600W Current restriction board. Route done.
    [CurrentRestrictionBoard_V1_0.brd, CurrentRestrictionBoard_V1_0.sch]
2026-05-21 PS1600W. Current restriction board.
    [CurrentRestrictionBoard_V1_0_TO_PRINT.brd]
2026-06-05 Soft start board.
    [SoftStart_V1_0.brd, SoftStart_V1_0.sch]
2026-06-13 SoftStart. Almost routed PCB.
    [SoftStart_V1_0.brd, SoftStart_V1_0.sch]
2026-06-13 SoftStart. Routed PCB.
    [SoftStart_V1_0.brd, SoftStart_V1_0.sch]
2026-06-15 Soft start. Adjust time/voltage define resistors.
    [SoftStart_V1_0.brd, SoftStart_V1_0.sch]
2026-07-28 Update soft start board. SWR metter.
    [PotenciometersBoard.brd, PotenciometersBoard.sch, PotenciometersBoard_TO_PRINT.brd, SoftStart_V1_0.brd, SoftStart_V1_0.sch, SoftStart_V1_0_TO_PRINT.brd, SoftStart_V1_0_TO_PRINT.sch, SoftStart_V2_0.brd]
2026-08-04 12-220 Lamp. Make knobe holes tiny.
    [LampPackage4_ver10.dwg]
2026-09-11 SWR metter tiny changes.
    [SwrMetter_TO_PRINT.brd]
2026-09-11 Current metter for battery charger.
    [CurrentMetter.brd, CurrentMetter.sch]
2026-09-12 Add STM32F030F4P6, INA219 devices to lib.
2026-10-03 Current metter. LEDs screen PCB route done.
    [CurrentMetterLEDScreen.brd, CurrentMetterLEDScreen.sch]
