InspectorColombo/ColomboProjects/(notices)

Notices in the files:
USBTinyISP/sw/USBTinyISP/usbtiny.h:
This is free software, licensed under the terms of the GNU General
Public License as published by the Free Software Foundation.
